eatoughaidan5v4418-spec/-/README.md

# 模块化塔式立体车库调度系统

第十九届重庆市大学生单片机应用设计竞赛 · 方向三
平台：星火一号 / STM32F407ZGT6 + RT-Thread 标准版

## 当前状态（2026-11-10）

**设计定稿，尚无实物。** 方案、三维模型、引脚分配和调度逻辑仿真已完成；机械件未加工，电路板未投板，固件只有调试界面，电机控制尚未开始。

- **结构**：中央升降转运台，加上每层 8 个辐射排列、无电机的车位。整机只有 3 个运动轴：升降、旋转、转运拨叉。拨叉与托盘的啮合 / 脱开靠升降上下 8 mm 完成。
- **规模**：计划书按两层、14 个车位写；样机先做一层、7 个车位。
- **电气**：3 个 TMC2209 模块 + 2 个 MCP23017 模块，插在 4 块自制转接 PCB 上；霍尔和红外用 5 V。
- **人机界面**：最终用 TJC4827T143 串口屏；开发阶段先用板载 LCD + LVGL 调试。
- **外形与预算**：约 520×520×275 mm。一层样机预算约 ¥1,487，两层约 ¥1,701，均含 15% 机动费。

关键节点：网上报名截止 2026-12-10 20:00；初赛材料提交截止 2027-03-11 20:00。

## 现行文档

| 文档 | 说明 |
|---|---|
| [docs/计划书_定稿.md](docs/计划书_定稿.md) | 初赛计划书。指标为设计目标，样机完成后更新第 6 节 |
| [docs/硬件方案_v4.md](docs/硬件方案_v4.md) | 硬件总述：布局、转运机构、升降、电气、引脚分配、屏幕策略、互锁、调度、风险 |
| [docs/硬件验证与实施_v4.md](docs/硬件验证与实施_v4.md) | 已做校核的范围、下单前确认事项、实施顺序、样机后要回填的数据 |
| [docs/采购清单_v5.md](docs/采购清单_v5.md) | 分两批的数量、下料和预算 |
| [docs/转接板_模块插装_v3/](docs/转接板_模块插装_v3/00_板卡结构确认.md) | 板卡结构和主转接板逐针表 |
| [docs/转接板_双板_v2/02_副板逐针接线.md](docs/转接板_双板_v2/02_副板逐针接线.md) | 副转接板 PMOD 逐针表（GPIO 分配有效） |
| [docs/PCB生产文件_20261111/](docs/PCB生产文件_20261111/交付说明.md) | 主、副转接板的 Gerber、坐标文件和打样说明 |
| [docs/cad/README.md](docs/cad/README.md) | CAD 索引：v7 三维装配、图纸、走线复核 |
| [使用的硬件资料/资料索引.md](使用的硬件资料/资料索引.md) | 开发板、串口屏、电机、驱动的原厂资料 |
| [docs/串口屏界面_v1/](docs/串口屏界面_v1/README.md) | 串口屏界面方案：可点击原型、页面与控件表、图片清单、通信协议、屏幕工程搭建步骤 |
| [firmware/spark_garage_lvgl/](firmware/spark_garage_lvgl/README.md) | 固件工程 |

## 工具

| 命令 | 作用 |
|---|---|
| `node tools/test_cad_simulation.js` | 调度状态机和互锁规则测试（104 个循环） |
| `node tools/test_deck_geometry.js` | 两层甲板销槽布置检查 |
| `py tools/check_garage_assembly_v7.py` | v7 三维装配检查，另有 `check_garage_stl_v7.py`、`check_cad_v7.py`、`check_cad_v7_details.py` |
| `py tools/check_hardware_v3.py` | v3 平面几何校核（设计值仍是 v3，未按 v7 更新）和采购清单 v5 加总 |

`tools/` 里的 `create_*`、`verify_*`、`export_*` 脚本用于在 AutoCAD 中重新生成和复查 v7 模型，用法见 v7 装配说明。

## CAD 交互演示

用电脑浏览器直接打开 [三维演示](docs/cad/assembly-exploded.html)：

- 点击“存入车辆”，或先选中一个载车托盘再点“取出车辆”。演示过程包括旋转、升降、拨叉啮合与推拉、DOCK 人工确认、空闲预置空托盘、取消存车、暂停和模拟急停。
- 勾选“仅一层样机”，可以切换到一层配置。
- 网址后加 `?view=top` 打开俯视视角，加 `?layers=1` 直接打开一层配置。

页面基于 v3 尺寸，仅用于演示原理，与 v7 模型存在差异；页面不连接实际设备，模型不能作为加工图。Three.js 已放在本地，不依赖网络。
