eatoughaidan5v4418-spec/-/docs/cad/README.md

# CAD 索引

当前选用两台 24 mm 短轴电机的 v7 试配方案：夹带背壁和挡边加厚，重新调整带轮和托盘销位，甲板井口扩大到 R102。请优先查看 [v7 装配与说明](./三维装配_v7_加厚夹带/README.md) 和 [v7 板件及安装详图](./图纸_v7_加厚夹带/README.md)。实际零件、皮带夹持、限位停止距离和结构强度仍需确认，不能直接作为最终加工依据。

以下网页可用电脑浏览器离线打开，基于旧版 v3，仅用于理解原理；实际安装请以 v7 为参考。

| 文件 | 说明 |
|---|---|
| [三维装配_v7_加厚夹带/README.md](./三维装配_v7_加厚夹带/README.md) | 当前试配：加厚夹座、带轮避让和 R102 井口 |
| [v7 走线优化与安装复核](./三维装配_v7_走线优化安装复核/README.md) | 两层通道、拖链支架、旋转导槽和线夹的更新模型及运动边界 |
| [图纸_v7_加厚夹带/README.md](./图纸_v7_加厚夹带/README.md) | P01N、P03E、两层甲板和夹带等试配详图 |
| [走线方案_v7/README.md](./走线方案_v7/README.md) | 升降拖链与旋转线环的走线示意、线束终点和试配假设 |
| [assembly-exploded.html](./assembly-exploded.html) | v3 三维结构、存取车、空闲预置、暂停、模拟急停、一层 / 两层切换与拆解视图 |
| [layer-plan.html](./layer-plan.html) | 层模块俯视（8 车位、井孔、竖向件、DOCK 竖井）与立面高度 |
| [一层甲板_易懂图.png](./一层甲板_易懂图.png) | 一层甲板的孔槽、托盘位置和转运方向说明 |
| `deck.js` | 甲板井孔轮廓，两个页面共用 |
| `simulation.js` | 存取状态机与互锁，网页和 `tools/test_cad_simulation.js` 共用 |

交互演示中：
- 存车：系统把空托盘调到 DOCK，用户放车并确认后送入空车位。
- 取车：先选中载车托盘。
- 车辆状态是演示记录，不代表真实传感器读数。
- 模拟急停后，“重置”只恢复网页演示；真实设备需按现场应急程序处理，检查前确保设备停稳、载荷有独立支承并隔离电源。

可运行 `node tools/test_cad_simulation.js` 检查模拟状态机。测试不验证实际机构、电气或三维碰撞。

可运行 `node tools/test_deck_geometry.js` 检查两层甲板的销槽布置。
