eatoughaidan5v4418-spec/-/docs/串口屏界面_v1/README.md

# 串口屏界面方案 v1

屏幕：TJC4827T143_011C_I_P20，4.3 寸，480×272，电容触摸，接 USART3（PB10 / PB11），115200 波特率。

## 1. 当前状态（2026-11-11）

| 内容 | 状态 |
|---|---|
| 视觉和交互 | 已定稿，见 [界面原型.html](界面原型.html)（浏览器直接打开，可点击） |
| 固件后端 | 已写完，在 `firmware/spark_garage_lvgl/applications/hmi/` |
| 通信协议 | 已定，见第 5 节；帧解析有单元测试 |
| 屏幕工程（.HMI 文件） | **未做**。要在 USART HMI 上位机里按第 3、4、6 节搭建 |
| 图片素材 | 已导出，93 张，在 [素材/](素材/)，总览见 [素材预览.png](素材预览.png) |
| 控件坐标 | 已从原型量出，见 [控件坐标.md](控件坐标.md) |
| 实机联调 | **未做**。固件只在电脑上跑过场景测试，没有接过真屏 |

固件目前接的是一个假车库（`ui_sim.c`），存取过程按定时器走，没有真实运动。调度模块写好后替换它，屏幕后端不用改。

## 2. 设计原则

1. **屏内不放逻辑。** 屏幕工程里只有控件、图片和每个触摸事件里的一行 `printh`。显示哪一页、每个控件显示什么，全部由主控决定。这样界面行为只有一份代码，换屏或改流程时不用同时改两边。
2. **屏幕不自己翻页。** 用户点了按钮，屏幕只上报；主控判断后再下发 `page` 指令。
3. **只发变化的值。** 主控记着每个控件上次发的值，没变就不发。换页或屏幕重启后全部重发。
4. **心跳对齐。** 每一页有一个 1 秒定时器上报当前页号。页号和主控认为的不一致（例如屏幕被单独复位），主控就整页重画。

## 3. 页面和控件

每个控件的位置和尺寸见 [控件坐标.md](控件坐标.md)，那是脚本从原型量出来的，和导出的图片逐像素对应。图片和按钮控件必须严格按表放；文本和数字控件给的是文字的实际范围，控件可以做宽一些。控件名固件里写死了，**不能改名**。

文本和数字控件的背景设置：

- main 页右侧面板上的（nFree、tTot、tSel、tJob、tStep、tIdx、nEta）：背景选纯色，颜色 `#0E1626`（RGB565 = 2212），和面板底图同色。
- main 页标题栏的 tClk、fault 页的全部文本：背景选“切图”，切图图片填该页的背景图编号（main 填 0，fault 填 1）。
- 其余页面是纯色背景，文本背景用同一个颜色。

所有页面都要加一个定时器 `tmHb`（1000 ms，启用），定时事件里写该页的心跳帧，见第 5.2 节。

### 3.1 页面编号

| 页号 | 页名 | 内容 | 背景 |
|---|---|---|---|
| 0 | boot | 启动等待，文字“正在连接主控，请稍候” | 纯色 |
| 1 | main | 车位图 + 右侧面板（主页 / 已选 / 出入口确认 / 进度共用） | 图片 0 |
| 2 | fault | 故障和人工确认 | 图片 1 |
| 3 | estop | 急停 | 图片 2 |
| 4 | idle | 待机时钟 | 纯色 |
| 5 | pwd | 维护密码 | 纯色 |
| 6 | jog | 维护：点动 | 纯色 |
| 7 | cal | 维护：标定 | 纯色 |
| 8 | sen | 维护：传感器 | 纯色 |

纯色背景统一用深蓝黑 `#080D18`（RGB565 = 2147）。维护页和密码页用上位机自带的扁平控件，不用图片，省 Flash，也省出图工作。

### 3.2 main 页（页号 1）

左侧车位图，8 个车位各一个图片控件，按方位固定顺序命名：

| 控件 | 方位 | 类型 | 按下事件 |
|---|---|---|---|
| b0 | 东 | 图片 | `printh A5 11 00 00 11 5A` |
| b1 | 东北 | 图片 | `printh A5 11 01 00 12 5A` |
| b2 | 北 | 图片 | `printh A5 11 02 00 13 5A` |
| b3 | 西北 | 图片 | `printh A5 11 03 00 14 5A` |
| b4 | 西 | 图片 | `printh A5 11 04 00 15 5A` |
| b5 | 西南 | 图片 | `printh A5 11 05 00 16 5A` |
| b6 | 南（出入口 / 竖井） | 图片 | `printh A5 11 06 00 17 5A` |
| b7 | 东南 | 图片 | `printh A5 11 07 00 18 5A` |
| hub | 转运台朝向 | 图片 | 无 |

这 9 个控件的矩形互不重叠，这是车位画成“沿半径排列的圆角矩形”而不是扇形的原因：屏幕的图片控件只能是矩形，扇形的外接矩形会互相压住。hub 限制在 76×76 也是同一个原因。

方位文字和小车图形都画在车位小图里，不用字库。选中和目标状态的发光超出矩形的部分在实机上不显示，所以发光比原型里略窄。

右侧顶部：

| 控件 | 类型 | 说明 |
|---|---|---|
| tClk | 文本，16 号字，右对齐 | 时钟，主控下发 |
| hTitle | 触摸热区 | 按下 `printh A5 17 01 00 18 5A`；弹起 `printh A5 17 00 00 17 5A` |
| tab1 | 图片 | 标签条左半边。按下 `printh A5 10 01 00 11 5A` |
| tab2 | 图片 | 标签条右半边。按下 `printh A5 10 02 00 12 5A` |
| pPanel | 图片 | 面板底图，5 种，带固定文字。盖住标题栏以下的整个右侧 |

tab1、tab2 和下表的控件都要叠在 pPanel 上面（在上位机里排在 pPanel 之后），主控按模式显示或隐藏。楼层标签只在主页和已选两种模式、且识别到两层时显示。

| 模式 | 控件 | 类型 | 说明 / 按下事件 |
|---|---|---|---|
| 主页 | nFree | 数字，60 号数字字库 | 空位数 |
| | tTot | 文本，24 号 | “/ 14” |
| | jOcc | 进度条，图片模式 | 占用条 |
| | bStore | 按钮，图片模式 | `printh A5 12 00 00 12 5A` |
| 已选 | tSel | 文本，24 号 | “1F · 北” |
| | bGet | 按钮，图片模式 | `printh A5 13 00 00 13 5A` |
| 出入口 | pTray | 图片 | 托盘到位一行（圆点和文字画在图里） |
| | pHand | 图片 | 红外遮挡一行 |
| | bOk | 按钮，图片模式 | 确认存车 `printh A5 14 00 00 14 5A` |
| | bCancel | 按钮，图片模式 | 取消 `printh A5 15 00 00 15 5A` |
| | bTaken | 按钮，图片模式 | 已取走 `printh A5 16 00 00 16 5A` |
| 进度 | tJob | 文本，16 号 | “存车中 · 1F 东北” |
| | tStep | 文本，24 号，多行 | 当前步骤 |
| | tIdx | 文本，16 号，右对齐 | “3 / 6” |
| | jStep | 进度条，图片模式 | 步骤进度 |
| | nEta | 数字，40 号数字字库 | 预计剩余秒数 |

按钮的触摸事件都写在“弹起事件”里，避免误触。车位和标签写在“按下事件”里，反应快一些。

### 3.3 fault 页（页号 2）

| 控件 | 类型 | 说明 / 事件 |
|---|---|---|
| tClk | 文本，16 号 | 时钟 |
| tCode | 文本，84 号字库（只含 E 和数字），红色 | “E12” |
| tTitle | 文本，24 号 | 故障名 |
| tDesc | 文本，16 号，多行 | 位置和处理提示 |
| c0 | 图片 | 勾选“交接缝上没有托盘”，按下 `printh A5 20 00 00 20 5A` |
| c1 | 图片 | 勾选“拨叉已完全收回”，按下 `printh A5 20 01 00 21 5A` |
| bHome | 按钮，图片模式 | 回零，弹起 `printh A5 21 00 00 21 5A` |

急停松开后也进这一页，故障码 E01（位置未确认），同样要勾两项才能回零。

### 3.4 estop 页（页号 3）

只有背景图和心跳定时器，没有动态控件。

### 3.5 idle 页（页号 4）

| 控件 | 类型 | 说明 |
|---|---|---|
| tClk | 文本，120 号数字字库，居中 | 大时钟 |
| jOcc | 进度条，图片模式，尺寸和 main 页的 jOcc 相同 | 占用条，和 main 页共用 85～88 号图 |
| nFree | 数字，40 号 | 空位数，青色 |
| tTot | 文本，16 号 | “/ 14” |
| m0 | 触摸热区 | 按下 `printh A5 18 00 00 18 5A` |

另放两个静态文本“空位”和“轻触屏幕开始”。待机时主控把背光调到 30%。

### 3.6 pwd 页（页号 5）

| 控件 | 类型 | 说明 / 事件 |
|---|---|---|
| d0～d3 | 图片，38×46 | 四个密码位，空 / 已输入两种图 |
| k0～k9 | 按钮 | 数字键，弹起 `printh A5 30 0n 00 3n 5A`（n 为数字，例如 7 是 `A5 30 07 00 37 5A`） |
| kBack | 按钮 | 退格，`printh A5 30 0A 00 3A 5A` |
| kClose | 按钮 | 关闭，`printh A5 30 0B 00 3B 5A` |

密码由主控校验，默认值和修改方法见第 7.3 节。输错不提示，只是清空重输。

### 3.7 jog 页（页号 6）

| 控件 | 类型 | 说明 / 事件 |
|---|---|---|
| m0 / m1 / m2 | 按钮 | 标签：点动 / 标定 / 传感器，`printh A5 40 00 00 40 5A`、`A5 40 01 00 41 5A`、`A5 40 02 00 42 5A` |
| mExit | 按钮 | 退出，`printh A5 40 03 00 43 5A` |
| n0 / n1 / n2 | 数字 | 升降 / 旋转 / 拨叉当前步数 |
| jm0 / jp0 | 按钮 | 升降 − / +：`A5 41 00 00 41 5A` / `A5 41 00 01 42 5A` |
| jm1 / jp1 | 按钮 | 旋转 − / +：`A5 41 01 00 42 5A` / `A5 41 01 01 43 5A` |
| jm2 / jp2 | 按钮 | 拨叉 − / +：`A5 41 02 00 43 5A` / `A5 41 02 01 44 5A` |
| s0 / s1 / s2 | 按钮 | 步长 1 / 10 / 100：`A5 42 00 00 42 5A`、`A5 42 01 00 43 5A`、`A5 42 02 00 44 5A`。选中哪个由主控改背景色 |
| bHomeAll | 按钮 | 全部回零，`printh A5 43 00 00 43 5A` |

三个维护页的标签栏做成一样的，各页把自己那个标签的颜色设成选中色即可（静态）。

### 3.8 cal 页（页号 7）

| 控件 | 类型 | 说明 / 事件 |
|---|---|---|
| m0～m2、mExit | 按钮 | 同 jog 页 |
| tBay | 文本，24 号 | 当前标定的车位，“1F · 东北” |
| bPrev / bNext | 按钮 | 上一个 / 下一个车位：`A5 44 00 00 44 5A` / `A5 44 01 00 45 5A` |
| nHc / nHs | 数字 | 啮合高度：当前 / 已存 |
| nAc / nAs | 数字 | 转角：当前 / 已存 |
| bGoJog | 按钮 | 去点动页微调，和 m0 发同一帧 |
| bSave | 按钮 | 录入当前位置，`printh A5 45 00 00 45 5A` |

### 3.9 sen 页（页号 8）

| 控件 | 类型 | 说明 |
|---|---|---|
| m0～m2、mExit | 按钮 | 同 jog 页 |
| l0～l15 | 文本，14×14，无文字 | 指示灯，主控改背景色：有信号绿色，无信号暗色 |

l0～l15 的含义依次是：东、东北、北、西北、西、西南、出入口、东南八个一层托盘霍尔，转运台托盘，拨叉收回，拨叉伸出，升降下限，出入口红外，急停回路，层板 0x20，层板 0x21。每个灯旁边放一个静态文本写名字。目前只显示一层的霍尔。

## 4. 图片资源

图片已导出到 [素材/](素材/)，文件名开头的两位数就是编号。按文件名顺序全选导入上位机，编号就是导入顺序，固件里的定义在 `hmi_res.h`。**中间插图会让后面的编号全部错位**，要加图只能加在最后。

| 编号 | 内容 | 尺寸 |
|---|---|---|
| 0 | main 页背景：车位图底、刻度环、转运台外圈、标题栏、空标签区 | 480×272 |
| 1 | fault 页背景 | 480×272 |
| 2 | estop 页背景（含全部文字） | 480×272 |
| 3～7 | 面板底图：主页、已选、出入口-放车、出入口-取车、进度 | 207×239 |
| 8～47 | 车位小图，编号 = 8 + 方位序号 × 5 + 状态 | 见 3.2 |
| 48～55 | 转运台朝向，东、东北……东南 | 76×76 |
| 56 | 转运台不在本层（无指示） | 76×76 |
| 57～60 | 1F 标签选中 / 未选中，2F 标签选中 / 未选中 | 91×30、92×30 |
| 61～63 | 存车按钮：正常 / 按下 / 禁用 | 191×56 |
| 64～65 | 取车按钮：正常 / 按下 | 191×62 |
| 66～68 | 确认存车：正常 / 按下 / 禁用 | 191×58 |
| 69～70 | 取消：正常 / 按下 | 191×44 |
| 71～73 | 已取走：正常 / 按下 / 禁用 | 191×62 |
| 74～75 | “托盘已到位”一行：到位 / 等待 | 183×23 |
| 76～77 | 红外一行：无遮挡 / 检测到手 | 183×23 |
| 78～81 | 勾选项 0 未勾 / 已勾，勾选项 1 未勾 / 已勾 | 220×44 |
| 82～84 | 回零按钮：禁用 / 正常 / 按下 | 456×50 |
| 85～86 | 占用条 14 格：全空 / 全满 | 183×6 |
| 87～88 | 占用条 7 格：全空 / 全满 | 183×6 |
| 89～90 | 步骤进度条：空 / 满 | 183×7 |
| 91～92 | 密码位：空 / 已输入 | 38×46 |

车位小图的状态序号：

| 序号 | 普通车位（方位 0～5、7） | 南位（方位 6） |
|---|---|---|
| 0 | 无托盘（虚线框） | 出入口，无托盘 |
| 1 | 空托盘 | 出入口，有托盘 |
| 2 | 有车（亮蓝，带小车图形） | 出入口，等用户操作（青色高亮） |
| 3 | 选中（青色发光） | 竖井（二层用） |
| 4 | 目标（青色边框，主控每 0.5 秒和原状态交替实现闪烁） | 出入口，目标 |

小图是不透明的，连同背后的背景一起截下来，所以控件位置差一个像素就会看到接缝。按钮图比按钮本身四周各大 4 像素，用来保留一点发光。

### 重新导出

改了原型的样式或布局后重新运行脚本，素材、预览图和坐标表会一起更新：

```bash
py tools/export_hmi_assets.py
```

脚本用本机的 Edge 或 Chrome 无头渲染原型，需要先装 `playwright` 和 `pillow` 两个 Python 包。它最后会做两项自检：车位状态变化是否都落在车位矩形内；用导出的小图重新拼出主页，和直接渲染的画面逐像素比较。当前结果是两项都为 0 个差异像素。

### Flash 估算

屏幕图片按 16 位色不压缩存储，每个像素 2 字节。

| 项目 | 大小 |
|---|---|
| 93 张图片（脚本按实际尺寸算出） | 2.21 MB |
| 字库（见第 6.3 节，估算） | 约 0.15 MB |
| **合计** | **约 2.4 MB** |

T1 系列屏的 Flash 是 4 MB 或 8 MB。这块屏具体是哪个，手册和规格书的文字我没能读出来，**要在上位机里选型号后看界面上显示的容量**。按 4 MB 算还有四成左右余量。

## 5. 通信协议

### 5.1 帧格式

**屏幕 → 主控**，固定 6 字节，在触摸事件里用 `printh` 发出：

```
A5  CMD  P1  P2  SUM  5A        SUM = (CMD + P1 + P2) 取低 8 位
```

所有事件的参数都是常量，所以每个控件的 `printh` 后面直接写死 6 个字节，屏幕不用算校验。

屏幕自己还会发一些原生返回（以 `FF FF FF` 结尾），主控只处理这几种：

| 首字节 | 含义 | 主控处理 |
|---|---|---|
| `88` | 屏幕启动完成 | 整页重画 |
| `00 00 00` | 屏幕上电 | 整页重画 |
| `02`～`24` | 指令执行失败 | 记一条警告日志，通常是控件名或图片编号在屏幕工程里不存在 |

**主控 → 屏幕**，用屏幕原生指令，ASCII 文本，中文为 GB2312，以 `FF FF FF` 结尾。用到的指令只有这几种：

```
page 1                  切换页面
b2.pic=20               改图片
nFree.val=10            改数字
tStep.txt="送入车位"     改文字
jOcc.bpic=85            改进度条底图（ppic 为填充图）
bOk.pic2=67             改按钮按下时的图
s1.bco=9885             改背景色（pco 为文字色）
vis bStore,0            隐藏 / 显示控件
tsw bOk,0               禁用 / 启用触摸
dim=30                  背光亮度
```

### 5.2 事件表

| CMD | 名称 | P1 | P2 | 说明 |
|-----|---|----|----|---|
| 01 | 心跳 | 当前页号 | 0 | 每页定时器每秒发一次，例如 main 页写 `printh A5 01 01 00 02 5A` |
| 10 | 切换楼层 | 1 / 2 | 0 | |
| 11 | 点车位 | 方位 0～7 | 0 | |
| 12 | 存车 | 0 | 0 | |
| 13 | 取车 | 0 | 0 | 取哪辆由主控记着 |
| 14 | 确认存车 | 0 | 0 | |
| 15 | 取消 | 0 | 0 | |
| 16 | 已取走 | 0 | 0 | |
| 17 | 标题栏 | 1 按下 / 0 弹起 | 0 | 主控计时，按住满 3 秒进密码页 |
| 18 | 待机唤醒 | 0 | 0 | |
| 20 | 故障勾选 | 0 / 1 | 0 | |
| 21 | 故障回零 | 0 | 0 | |
| 30 | 密码键 | 0～9，10 退格，11 关闭 | 0 | |
| 40 | 维护标签 | 0 点动，1 标定，2 传感器，3 退出 | 0 | |
| 41 | 点动 | 轴 0 升降，1 旋转，2 拨叉 | 0 负向 / 1 正向 | 每按一次走一个步长 |
| 42 | 点动步长 | 0 / 1 / 2 | 0 | 对应 1 / 10 / 100 步 |
| 43 | 全部回零 | 0 | 0 | |
| 44 | 标定换车位 | 0 上一个 / 1 下一个 | 0 | |
| 45 | 标定保存 | 0 | 0 | |

各页心跳帧：

| 页 | 定时事件 |
|----|---|
| boot | `printh A5 01 00 00 01 5A` |
| main | `printh A5 01 01 00 02 5A` |
| fault | `printh A5 01 02 00 03 5A` |
| estop | `printh A5 01 03 00 04 5A` |
| idle | `printh A5 01 04 00 05 5A` |
| pwd | `printh A5 01 05 00 06 5A` |
| jog | `printh A5 01 06 00 07 5A` |
| cal | `printh A5 01 07 00 08 5A` |
| sen | `printh A5 01 08 00 09 5A` |

### 5.3 主控一侧的保护

屏幕上报的事件只是“用户想做什么”，主控会再核对一遍才执行：

- 出入口红外被挡时，“确认存车”和“已取走”按钮禁用，就算收到这两个事件也不执行。
- 故障回零必须两项都勾上。
- 只有就绪状态才接受存车、取车和进维护。
- 待机时的第一次触摸只唤醒，不执行任何操作。
- 3.5 秒收不到心跳，主控记一条“屏幕离线”日志；车库的动作不受影响。

## 6. 屏幕工程搭建步骤

### 6.1 新建工程

1. USART HMI 上位机新建工程，型号选 TJC4827T143_011C，方向横屏 0°，**字符编码选 GB2312**。
2. 在 `Program.s`（工程初始化脚本）里写：

```
bauds=115200
bkcmd=2
page 0
```

`bkcmd=2` 表示只在指令失败时返回，主控靠它发现控件名写错。

3. 所有控件的“发送键值”保持不勾选，触摸只通过 `printh` 上报。

### 6.2 导入图片

把 `素材/` 里的 93 个文件按文件名排序后一次导入，导入后核对最后一张（`92_pin_full.png`）的编号是 92。

### 6.3 生成字库

| 字库编号 | 字高 | 内容 | 用途 |
|---|---|---|---|
| 0 | 16 | 全部 ASCII + [字库字符集.txt](字库字符集.txt) 里的汉字 | 小字、提示 |
| 1 | 24 加粗 | 同上 | 标题、步骤名 |
| 2 | 40 | 数字 0～9 | 剩余秒数、待机空位数 |
| 3 | 60 | 数字 0～9 | 主页空位数 |
| 4 | 84 | E 和数字 0～9 | 故障码 |
| 5 | 120 | 数字 0～9 和冒号、减号 | 待机大时钟 |

`字库字符集.txt` 是脚本从固件文字表生成的，目前 165 个字。只收用到的字，字库很小；以后在 `hmi_text.txt` 里加了新字，要重新生成字库再下载到屏幕，否则新字显示成空白。

### 6.4 建页面

按第 3 节建 9 个页面，页面顺序决定页号。每页加 `tmHb` 定时器和对应的心跳帧。

### 6.5 联调顺序

上位机的“调试”功能可以用电脑串口直接连主控，不用下载到屏幕就能看效果，建议先这样调通再烧屏。

1. 只建 boot 和 main 两页，确认上电后屏幕从 boot 跳到 main，说明双向通信通了。
2. 在 msh 里运行 `hmi_stat`，看到 `screen online` 和正确的页号。
3. 补齐其余页面。每加一页，在 msh 日志里看有没有“screen rejected an instruction”，有就是控件名或图片编号对不上。
4. 用 `sim_fault 12`、`sim_estop 1`、`sim_estop 0` 触发故障页和急停页。

## 7. 固件

### 7.1 文件

都在 `firmware/spark_garage_lvgl/applications/hmi/`：

| 文件 | 作用 |
|---|---|
| `ui_model.h` | 界面和调度之间的接口：一个状态快照结构、一组命令、三个函数 |
| `hmi_proto.h/.c` | 帧解析，不依赖 RT-Thread |
| `hmi_res.h` | 页号和图片编号 |
| `hmi_text.txt` | 主控下发的全部中文（UTF-8），**改文字只改这里** |
| `hmi_text.h` | 脚本生成的 GB2312 字节表，不要手改 |
| `hmi_tjc.c/.h` | 串口屏后端：收发线程、页面决策、差量刷新 |
| `ui_sim.c` | 假车库，调度模块写好后删除 |

改了 `hmi_text.txt` 后运行：

```bash
py tools/gen_hmi_text.py
```

### 7.2 调度模块怎么接

调度模块只需要实现 `ui_model.h` 末尾的三个函数，然后删掉 `hmi_tjc.h` 里的 `HMI_USING_SIM`：

- `garage_ui_get_state()`：填一份当前状态（阶段、车位表、转运台位置、任务步骤、故障码、传感器、各轴位置）。界面线程每 100 ms 调一次，不能阻塞。
- `garage_ui_post_cmd()`：接收存车、取车、确认、取消、回零、点动、标定保存等命令，一般是丢进调度的消息队列。
- `garage_ui_get_cal()`：读某个车位已保存的标定值。

板载屏的 LVGL 调试界面（`garage_ui.c`）目前还是自己内部模拟，没有改成走这套接口。

故障码和步骤名是我先拟的（见 `hmi_text.txt`），调度模块实现时可以增删，改完重新生成文字表即可。

### 7.3 串口配置和 msh 命令

这次在 `rtconfig.h` 和 `.config` 里打开了 `BSP_USING_UART3`。如果以后在 RT-Thread Studio 的设置界面里重新生成配置，确认 UART3 还勾着。

| 命令 | 作用 |
|---|---|
| `hmi_stat` | 屏幕是否在线、当前页号、丢弃的坏帧数 |
| `hmi_pin 1234` | 改维护密码。只存在内存里，复位后恢复默认值 `0000` |
| `sim_fault <故障码>` | 假车库：触发故障 |
| `sim_estop <0\|1>` | 假车库：按下 / 松开急停 |

### 7.4 已做的验证

```bash
gcc -Wall -Wextra -I firmware/spark_garage_lvgl/applications/hmi tools/test_hmi_proto.c firmware/spark_garage_lvgl/applications/hmi/hmi_proto.c -o test_hmi_proto && ./test_hmi_proto
```

```bash
gcc -Wall -I tools/hmi_host_shim -I firmware/spark_garage_lvgl/applications/hmi tools/test_hmi_backend.c firmware/spark_garage_lvgl/applications/hmi/hmi_proto.c -o test_hmi_backend && ./test_hmi_backend
```

- 帧解析测试 16 项通过：正常帧、参数里含帧头帧尾、校验错、帧尾错、原生返回、混合流、长串乱码后恢复。
- 后端场景测试 58 项通过：在电脑上把 RT-Thread 换成桩，让后端和假车库跑完整流程，检查发给屏幕的每条指令。覆盖启动、切层、选车、取车、存车、取消、故障确认、急停、待机唤醒、长按进密码、输错和输对密码、点动、标定、传感器、屏幕重启后重画。
- 三个源文件用 RT-Thread Studio 自带的 ARM GCC 5.4.1 加 `-Wall -Wextra` 编译无警告。

没有做的：整个固件工程的链接（命令行 scons 和这版 RT-Thread 的构建脚本不兼容，报错退出，需要在 RT-Thread Studio 里编译一次）、下载到板子、接真屏。

## 8. 要在实机上确认的事

这些地方我是按屏幕手册的说明写的，没有真屏验证过：

1. **隐藏控件后的重画。** 面板切换时主控先隐藏全部面板控件，再换 pPanel 的图，再显示本模式的控件。如果实机上出现残影或控件被底图盖住，需要调整这三步的顺序，改 `hmi_tjc.c` 的 `panel_switch()`。
2. **图片模式进度条**的 `bpic`、`ppic` 能否在运行时修改；不能的话 14 格和 7 格的占用条要做成两个控件。另外占用条是按百分比填充的，格子边界可能差 1 像素。
3. **按钮禁用**后（`tsw bOk,0`）外观是否保持禁用图。
4. **文本换行**：`tStep`、`tDesc` 要打开多行；提示里的换行写的是 `\r` 两个字符，确认屏幕把它当换行处理。
5. **切页闪烁**：main 页每次进入要发 40 条左右指令，115200 波特率下约 60 ms，看是否能接受。
6. **点阵字的观感**：T1 系列字库没有抗锯齿，24 号加粗和 120 号大数字的实际效果要看了再定是否换字体。
7. **Flash 容量**，见第 4 节。
8. **图片色彩**：素材是 24 位色 PNG，上位机导入时转成 16 位色。深色渐变背景可能出现轻微色带，面板纯色和文本背景色是否完全一致也要看实机；有色差就把文本控件背景改成“切图”。

## 9. 和计划书不一致的地方

- 计划书 4.8 节写进度页有取消按钮。本方案把取消放在放车前的出入口确认页，进度页不提供取消，只提示按急停，理由是 4.6 节规定运动中不中断。定稿时计划书这一句要改，或者在这里加回取消键。
- 计划书把主页、进度、故障、维护列为 4 个页面；实际做成 9 个屏幕页面，其中主页、已选、出入口确认、进度共用一个 main 页。
