eatoughaidan5v4418-spec/-/docs/硬件方案_v4.md

# 中央升降塔式立体车库硬件方案 v4（设计定稿）

日期：2026-11-10。本文把硬件方案 v3 的正文与其后各条更新说明（v7 CAD、5 V 检测、模块插装板卡）合并成一份，**取代 v3 作为当前唯一有效的硬件总述**。

平台：星火一号（STM32F407ZGT6）+ RT-Thread 标准版。人机界面：TJC4827T143_011C 4.3 寸串口屏（最终）；板载 240×240 LCD 仅作调试屏，见第 7 节。

> **状态：设计定稿，尚无实物。** 本文用于采购、建模、绘制原理图和制作一层样机，不是已验证的加工图或电路图。尚未做实物装配、通电、刚度、力矩、温升或断电保持试验。尺寸为名义值，电机、导轨、轴承到货复尺前不要冻结孔位。验证顺序见 [验证与实施 v4](硬件验证与实施_v4.md)。

**范围**：计划书按**两层、14 个车位**写；样机**先做一层、7 个车位**。升降塔一次按两层高度做好，第二层是无源模块，一层验证通过后加装。

## 0. 文档关系

| 主题 | 以哪份为准 |
|---|---|
| 总体方案、I/O 分配、互锁、调度 | 本文 |
| 机械细部尺寸、孔位、打印件 | [v7 装配说明](cad/三维装配_v7_加厚夹带/README.md)、[v7 图纸](cad/图纸_v7_加厚夹带/README.md) |
| 走线、拖链、旋转线环 | [v7 走线优化与安装复核](cad/三维装配_v7_走线优化安装复核/README.md) |
| 板卡结构与主转接板逐针表 | [转接板_模块插装_v3](转接板_模块插装_v3/00_板卡结构确认.md)（00～03、05；04 号已被 05 号取代） |
| 副转接板 PMOD 逐针表 | [转接板_双板_v2/02_副板逐针接线](转接板_双板_v2/02_副板逐针接线.md)（GPIO 分配仍有效；其中 5P 外置驱动控制口已改为模块插装） |
| 数量与预算 | [采购清单 v5](采购清单_v5.md) |

## 1. 方案由来：从 v2 到 v3 架构

v2 每层都有一套车顶上方的 X/Y 移盘机构，再加侧置升降台和跨缝滚筒，共 9 个运动轴，预算约 ¥4,100，层内搬运、跨缝交接、抓销入孔三处都难调。v3 起把所有运动集中到中央一台升降转运装置，每层只是无电机的车位架。v4 沿用这一架构。

| 项目 | v2 | v3 / v4 |
|---|---|---|
| 运动轴 | 9 | **3**：升降 Z、旋转 θ、转运拨叉 u；层数增加时不变 |
| 每层机构 | X/Y 龙门 + 3 根导轨 + 执行器 | **无电机**：甲板 + 导条 + 霍尔 + 1 块层检测板 |
| 托盘交接 | 抓销推送 + 跨缝 + 滚筒 | 转运台直接推拉，靠升降下沉 8 mm 啮合 / 脱开 |
| 断电保持 | 抱闸电机 | T8 单头导程 2 丝杆自锁（须带载断电试验确认） |
| 容量 | 2 层 6 辆 | 一层 7 辆；两层 14 辆 |
| 外形 | 约 550×300×670 | 约 520×520×275 |

代价：放弃了“华容道滑移”卖点，平面占地变大（但车辆密度更高）；转运台只能在 315° 范围内往返转动，不能连续旋转。

## 2. 总体布局与坐标

单位 mm。原点为塔中心、底板上表面；X 向右，Y 向后，Z 向上。前侧（−Y）为用户侧。

```text
                    N 后 (90°)
          NW (135°)     │     NE (45°)
               ╲   ┌────┴────┐   ╱
                ╲  │ 升降井  │  ╱
     W (180°) ───  │  R102   │  ─── E (0°)
                ╱  │ 转运台  │  ╲
               ╱   └────┬────┘   ╲
          SW (225°)     │     SE (315°)
                    S 前 (270°)
          一层：DOCK（用户放车 / 取车）
          二层：不设车位，形成 DOCK 竖井
```

| 参数 | 设计值 | 说明 |
|---|---|---|
| 外框 / 底板 | 500×500 / 520×520×6 | 四角 2020 立柱，高 270；顶板 5 mm，到 Z=275 |
| 车位 | 每层 8 个方位，按 45° 辐射排列 | 托盘长边沿径向，内端朝井口 |
| 托盘（P01N） | 125×60×3，内端两角 C10 倒角 | 停放时径向范围 **r=100…225**；定位销中心距内端 **7**，位于 r=107 |
| 模型车 | 105×43×30 | 居中，前后挡车件固定 |
| 井口净空半径 | **R102**（P05R / P06R 甲板） | 另有 8 个定位销槽、支撑臂槽 |
| 竖向件 | r=140，角度 22.5° / 202.5°（Φ8 导杆）、112.5°（T8 丝杆）、67.5°（拖链） | 都在车位缝隙中 |
| 甲板高度 | L1 Z=100，L2 Z=190 | 层间距 90 |
| DOCK 竖井 | 二层前侧甲板开 ±38 缺口、不设前环梁 | DOCK 上方净空 150 |
| 容量 | 一层 7（8 个方位扣 DOCK）；两层 14（二层扣竖井） | |

> v3 的平面间隙校核值（相邻托盘最小间隙 26.5、推拉通道与相邻托盘 ≥24.4、支撑臂槽离倒角托盘 6.2、竖向件离托盘 ≥12.6）是按托盘 r=97…222、井口 R96 算的。v7 把托盘整体外移 3 mm、井口扩到 R102，这些值**尚未按 v7 重算**，使用前须复核。

## 3. 转运台：一套机构完成所有存取

转运台装在升降平台上，可旋转。转运板 P03E 轮廓范围 **183×96×3**。两根支撑条托住托盘，中间是 MGN7 导轨（长 170），由 NEMA11 经 GT2 皮带带动滑块，滑块上的伸出臂末端有一个 U 形拨叉。

每块托盘下方有一根向下伸出 5 mm 的 Φ4 定位销。**拨叉和销的啮合、脱开都由升降轴上下 8 mm 完成**，不需要电磁铁、舵机或直线执行器：

| 状态 | 转运台面（托盘支撑面） | 拨叉顶面 | 与销的关系 |
|---|---|---|---|
| 啮合 / 对齐高度 | = 甲板面 Z_L | Z_L − 1 | 销底 Z_L − 5，进入拨叉 4 mm |
| 脱开高度 | Z_L − 8 | Z_L − 9 | 拨叉在销下方，间隙 4 mm |

**从车位取托盘（pick）：**

1. 拨叉收回，旋转到目标方位，升降到该层脱开高度 Z_L−8。
2. 拨叉伸出到车位内托盘的销下方（销在 r=107）。
3. 升降上抬 8 mm，销落入拨叉，转运台面与甲板齐平。
4. 拨叉拉回，托盘滑上转运台。

**把托盘送入车位（place）：** 旋转对准，升降到啮合高度 Z_L，拨叉推出，下降 8 mm 脱开，拨叉空载收回。

v7 名义几何（详见 v7 装配说明）：

- 拨叉正常推拉行程 0…138，机械止挡在 −2 和 140。
- 皮带外包络最大径向 R98.50，距 R102 井口约 3.50；电机方形包络最大径向约 R95.79。
- 中央托盘外端 u=87，两条支撑条外端 u=78.5 / 85。
- 夹带座背壁 2 mm、底挡边 1 mm；拨叉与简化带轮的连续包络间隙下界 0.99 mm。
- **交接缝**：按名义尺寸，支撑条外端 u=85 到甲板井口 R102 约 17 mm（v3 为 11 mm）。v3 的“重心偏移 ±15 mm 内始终有支承”结论是按 11 mm 缝算的，**对 v7 不再成立**，必须用实物手推试验重新确认。

## 4. 升降与旋转

**升降**：NEMA17（42BL40，轴长 24 mm 短轴版）放在底板 112.5° 方位，经联轴器带动 T8 丝杆（单头、**实际导程 2 mm/转**、长 200），顶端用 KFL08 支承。两根 Φ8×270 光轴配 LM8LUU 导向，光轴支座为 SHF8。升降平台为 5 mm 铝板 CNC 件，由中心盘和 3 条支撑臂组成，臂宽 10、高 20，从托盘缝隙之间穿过各层甲板的臂槽。工作位置为 Z=92/100（一层）和 182/190（二层）。上下各设硬限位和机械止挡。

- 速度目标 10～15 mm/s，换层一次约 6～9 s。按 1/16 细分，每步 0.000625 mm。
- **速度风险**：15 mm/s 对应电机 450 r/min、脉冲频率 24 kHz。12 V 供电下 42 步进在该转速的可用扭矩明显下降，带载可能丢步。须实测；不达标时降速，或改 1/8 细分并核对驱动设置。
- **断电保持**：导程 2、直径 8 的单头丝杆螺旋升角约 4.5°，通常能自锁，但这不是证明。必须在最高层带满载断电并做振动试验。出现下滑则改 1 mm 导程丝杆或抱闸电机。

**旋转**：NEMA17 吊装在升降平台中心下方，通过法兰联轴器驱动转运台，3 寸方形转盘轴承承载。按 1/16 细分为 0.1125°/步，对应 r=107 处约 0.21 mm。转角限制在 −135°…+180°（共 315°），8 个方位都可到达，线缆只往返不连续转。原点由霍尔传感器给出。

**每个车位单独标定**：每个车位的啮合高度和转角存在 Flash 标定表里，补偿甲板挠度和装配误差。加装一层时只需补录该层的标定值。

## 5. 层模块与 DOCK

每个层模块包括：

- 3～4 根 2020 环梁和 4 根对角斜撑。
- 1 块 5 mm 激光切割亚克力甲板，开有 R102 井孔、销槽、臂槽和竖向件口袋。
- 每个车位：侧导条、端挡、甲板下 1 个 5 V 数字霍尔（检测托盘磁铁）、1 个指示 LED。
- 1 块层检测板，插 1 个 MCP23017 模块（一层 0x20，二层 0x21）。

**层模块里没有任何运动件**。上电时主控扫描 0x20…0x21，自动得到层数和车位表。

**DOCK**（一层前侧，S 方位）：

- 托盘停在一层甲板上，用户从正面或上方放车 / 取车。
- 二层同一方位不设车位，甲板开 ±38 缺口并取消前环梁。前侧少一根环梁，由两侧环梁、对角斜撑和顶框补偿刚度，需实测前角挠度。
- DOCK 装 2 套 5 V 红外对射（NPN 常开、30 cm 档）：一路判断车辆在位，一路判断手进入。手在区内时禁止任何运动；运动中检测到手进入，立即停机。单条光束只覆盖光路本身，不等同于安全光幕。

## 6. 电气

### 6.1 供电与安全回路

```text
12 V / 5 A 适配器（机内不引入市电）
 ├─ 12→5 V 降压（3 A）→ 星火一号、串口屏
 │     星火 40Pin 的 V5_SYS → 霍尔、红外（经主转接板和层检测板分配）
 │     星火 3.3 V → TMC2209 VIO、MCP23017、I²C 上拉
 └─ 急停常闭 + Z 上下硬限位常闭 + 继电器自保持 / 手动复位
       └─ VM_Z_SAFE、VM_T_SAFE（主转接板）及拨叉驱动 VM（副转接板）→ 3× TMC2209
```

- 三台步进**同一时间只允许一台运动**。按驱动限流约 1 A 估算，12 V 支路峰值输入电流在 2 A 量级；5 A 是预留余量，须实测。
- 急停只切断电机支路，主控和屏幕保持供电，用于显示状态和记录。
- 电机动力电流不经过星火 40Pin 或 PMOD 触点。逻辑地与电机地共参考，动力回流直接回电源输入。
- 每路 VM 就近预留储能电容位，容量和耐压按模块板载外围核定。
- 串口屏用外部 5 V 独立供电，不接 PMOD 的 3.3 V；屏的完整型号后缀和 TTL 电平须按实物标签确认后再接线。

### 6.2 板卡：3 种 PCB，共 4 块

| PCB | 数量 | 内容 | 位置 |
|---|---:|---|---|
| 主转接板 | 1 | 星火 40Pin、2×8 备用口、升降 / 旋转两组 TMC2209 模块插座、两台大电机 4P 口、检测口、两层 I²C 口和 5 V 口 | 星火上方叠装 |
| 副转接板 | 1 | 两组 PMOD 弯针、2×8 备用口、拨叉 TMC2209 模块插座、小电机 4P 口、串口屏 4P 口 | 星火侧面 |
| 层检测板 | 2（同一种 PCB） | MCP23017 模块插座、8 路霍尔口、8 路 LED 口、4P 总线口、2P 传感器 5 V 口 | 每层一块 |

TMC2209（红排针版）和 MCP23017 均用现成模块，经排母插到自制 PCB 上。TMC2209 采用 STEP/DIR 独立模式，目标 1/16 细分，不启用 UART。当前只推进主转接板原理图，副板与层检测板逐针定义待补。

### 6.3 MCU 引脚分配

| 功能 | MCU 脚 | 所在板 | 工作模式 |
|---|---|---|---|
| 升降 STEP / DIR / EN | PA8 / PA1 / PD10 | 主板 | TIM1_CH1；GPIO；GPIO 低有效 |
| 旋转 STEP / DIR / EN | PA0 / PB14 / PE14 | 主板 | TIM2_CH1；GPIO；GPIO 低有效 |
| 拨叉 STEP / DIR / EN | PD12 / PF6 / PF7 | 副板 | TIM4_CH1；GPIO；GPIO 低有效 |
| 串口屏 TX / RX | PB10 / PB11 | 副板 | USART3 |
| 层检测 I²C SDA / SCL | PB7 / PB6 | 主板 | I2C1 |
| 升降回零 | PG0 | 主板 | 常闭微动，内部上拉 |
| 升降下限 / 上限监测 | PG1 / PG2 | 主板 | 常闭微动，内部上拉 |
| 旋转原点霍尔 | PG3 | 主板 | 5 V 数字输入（FT 脚，无上下拉） |
| 拨叉收回 / 伸出 | PG4 / PG5 | 主板 | 常闭微动，内部上拉 |
| 转运台托盘霍尔 | PG6 | 主板 | 5 V 数字输入（FT 脚，无上下拉） |
| 急停辅助触点监测 | PG7 | 主板 | 常闭触点，内部上拉 |
| DOCK 车辆 / 手进入红外 | PD8 / PD9 | 主板 | 5 V 数字输入（FT 脚，无上下拉） |

说明：

- 三路 EN 相互独立、低有效（v3 的“共用 ENABLE”已取消）。固件上电后先把 EN 置高，再初始化脉冲输出。
- PG3、PG6、PD8、PD9 是 STM32F407 的 5 V 容忍（FT）引脚，可在主控正常供电、数字输入、GPIO_NOPULL 的条件下直接接 0～5 V 信号。依据见 [05_霍尔资料核对与主板FT直连](转接板_模块插装_v3/05_霍尔资料核对与主板FT直连.md)。
- 星火板载按键占用 PC0 / PC1 / PC4 / PC5，调试界面用轮询读取，不开 EXTI0/1/4/5，避免与 PG0/PG1/PG4/PG5 的中断线冲突。
- 40Pin 物理第 14 脚为 GND，第 30、34 脚为配置脚，不在载板强制接地。

### 6.4 层检测板 I/O

| MCP23017 引脚 | 用途 |
|---|---|
| GPA0…GPA6、GPB0 | 8 路霍尔输入（一层：7 车位 + DOCK；二层：7 车位，第 8 路空置） |
| GPA7、GPB1…GPB7 | 8 路指示 LED 输出（GPIO 侧须加限流） |

MCP23017 用 3.3 V 供电，I²C 上拉在 3.3 V，**其输入不是 5 V 容忍**。层板上 15 路 5 V 霍尔输出须先做电平处理再进 MCP，具体电路待按霍尔模块实物确定，见未决项。

### 6.5 传感器清单

| 器件 | 数量（两层 / 一层样机） | 供电与接法 |
|---|---|---|
| 数字霍尔模块（非锁存，只用 DO） | 17 / 10 | 5 V；车位霍尔进层检测板，原点和转运台霍尔进主板 |
| 红外对射（NPN 常开，30 cm 档） | 2 套 | 5 V；接收头进 PD8 / PD9，发射头只供电 |
| 微动开关（COM + NC） | 7：逻辑监测 5 + 动力硬限位 2 | 无源 |
| 急停按钮 | 1（两组独立常闭触点） | 一组切动力，一组给 PG7 监测 |

霍尔、红外的输出极性以实物实测为准，在软件里配置，不凭商品描述假定。

## 7. 人机界面：TJC 串口屏为最终界面，板载屏仅调试

| | 最终界面 | 调试界面 |
|---|---|---|
| 硬件 | TJC4827T143_011C，4.3 寸 480×272 电容触摸串口屏 | 星火板载 240×240 LCD + 四个方向键 |
| 连接 | USART3（PB10 / PB11），经副转接板 4P 口，外部 5 V 供电 | 板载，无需接线 |
| 界面实现 | USART HMI 上位机设计页面，固件收发串口指令 | LVGL（固件 `applications/lvgl/demo/garage_ui.c`） |
| 用途 | 参赛作品的人机界面，用于演示视频和计划书 | 副转接板和串口屏工程完成前，联调调度、运动和故障流程 |

两套界面只是“显示和输入的后端”不同。车位状态、任务进度、故障码都由调度层提供，界面只负责显示和把用户操作转成命令。固件里应把这层接口单独抽出来，让调试屏和串口屏共用同一套业务逻辑，切换屏幕时不改调度代码。当前 `garage_ui.c` 里的存取进度是定时器模拟的，接入真实运动后须替换。

## 8. 软件互锁

- 升降或旋转前，拨叉必须在收回位（收回位开关确认）。
- 空叉伸出：必须在该层脱开高度，且目标车位有托盘。
- 携盘伸出：必须在该层啮合高度，且目标车位为空。
- 啮合上抬：拨叉必须在伸出位，且车位霍尔检测到托盘。
- 拉回后：转运台托盘霍尔必须检测到托盘，同时车位霍尔变为无，否则报故障停机。
- 任何超时、霍尔状态不一致、限位异常，一律禁止后续动作，等待人工确认。
- 急停、断电、复位后，不在位置未知时自动回零。须人工确认无托盘跨缝、拨叉已收回后，才允许回零。

演示状态机（`docs/cad/simulation.js`）和测试脚本（`tools/test_cad_simulation.js`）已实现同一套规则。

## 9. 调度

- **状态**：车位表 `bay[层][方位] = {托盘号, 有车}`，另记转运台上的托盘。托盘有无由霍尔确认；车的有无由用户在 DOCK 确认后记录。
- **存车**：DOCK 已预置空托盘时用户可立即放车；否则调取代价最小的空托盘到 DOCK（代价：每换一层 3 分 + 每转 90° 1 分）。用户确认后，托盘送往代价最小的空车位。
- **空闲预置**：存车完成后，后台把下一块空托盘调到 DOCK。
- **取车**：DOCK 上如有预置的空托盘，先送回空车位，再把目标托盘调到 DOCK。用户取车后，空托盘留在 DOCK。
- **优先级**：急停 > 取车 > 存车 > 后台预置。抢占只发生在两个完整动作之间。
- **RT-Thread 线程**：人机、调度、运动、安全监测（最高优先级）。
- **节拍估算**：假设 Z 15 mm/s、转 90° 1.5 s、拨叉 40 mm/s，DOCK 为空时单次取车约 16～21 s（一层）、27～31 s（二层）。这是演示状态机累加的结果，不是实测。

## 10. 设计亮点

1. **一台转运装置服务所有层**：3 个电机，层数增加时不变；层模块无电机，可堆叠。
2. **用升降动作代替抓取执行器**：下沉 8 mm 脱开、上抬 8 mm 啮合。
3. **I²C 地址即层号**：上电自动识别层数，车位表和标定表按层生成。
4. **DOCK 空托盘预置 + 取车优先**的调度策略。
5. **8 方位辐射车位 + DOCK 竖井**：两层 14 辆，约 52 辆/m²。

## 11. 主要风险与未决项

| 风险 / 未决项 | 应对 |
|---|---|
| 托盘跨约 17 mm 交接缝时卡边、下垂或翻转 | 托盘端部、甲板内缘、支撑条端部倒角；**第一个要做的实物试验** |
| 拨叉与销对不准 | U 形口做喇叭口导入；每车位单独标定；拉回后用霍尔复核 |
| 升降高速丢步 | 梯形加减速；实测最高可靠速度；必要时降速或改细分 |
| 升降单丝杆偏置，平台倾斜卡滞 | LM8LUU 长轴承；带载实测倾斜 |
| 断电下滑 | 带载断电试验；不通过则换 1 mm 导程丝杆或抱闸电机 |
| 皮带端部夹持（名义搭接仅 6 mm）拉脱 | 先打印夹座小样做拉脱和往复试验 |
| 走线：v7 走线试配件曾发现相交 | 按走线优化安装复核版调整，实物装配后复查拖链和旋转线环 |
| 层板 5 V 霍尔输出进 3.3 V MCP 的电平处理未定 | 测量霍尔模块 DO 电路；开集电极则把上拉改到 3.3 V，否则用分立分压 |
| 串口屏完整型号后缀、供电和 TTL 电平未确认 | 对照屏幕实物标签和原厂规格书后再接线 |
| TMC2209 红排针模块的物理针序、细分配置脚未按实物核对 | 核对前不冻结主板封装 |
| 电机线束相序未验证 | 用万用表确认线圈配对后再定 4P 针序 |
| v3 平面间隙校核未按 v7 重算 | 改 `tools/check_hardware_v3.py` 的设计值后重跑，或在 v7 模型里量取 |
| 前侧少一根环梁，刚度下降 | 实测前角挠度，必要时加前梁或三角撑 |
