eatoughaidan5v4418-spec/-/docs/硬件验证与实施_v4.md

# 硬件验证与实施 v4

日期：2026-11-10。配套 [硬件方案 v4](硬件方案_v4.md) 和 [采购清单 v5](采购清单_v5.md)。样机先做一层，计划书按两层写。

> **当前状态：设计定稿，没有实物、没有通电测试。** 下面“已完成”的都是纸面和程序校核。

## 1. 已完成的校核，以及它们各自证明了什么

| 校核 | 工具 | 结论 | 局限 |
|---|---|---|---|
| v3 平面几何、高度 | `py tools/check_hardware_v3.py` | 布局和数字自洽 | 按井口 R96、托盘 r=97…222 计算，**未按 v7 重算** |
| 采购清单 v5 加总 | 同上（读取采购清单 v5） | 表格逐行与合计加总正确 | 只核对算术，不核对价格 |
| 调度状态机 | `node tools/test_cad_simulation.js` | 一层和两层、开 / 关空闲预置，共 104 个循环，托盘守恒，互锁规则无违规，无死锁 | 只验证逻辑，不涉及机构和电气 |
| 两层甲板销槽 | `node tools/test_deck_geometry.js` | 销槽布置自洽 | 平面检查 |
| v7 三维装配 | `py tools/check_garage_assembly_v7.py` 等 | 基准姿态、升降旋转离散采样、推拉和越程无干涉；拨叉与简化带轮连续包络间隙 ≥0.99 mm | 离散采样；不含真实带齿、张力、线束、变形 |
| v7 走线 | `tools/check_*wiring*_v7.*` | 走线优化后的模型与运动边界 | 线束刚度、弯曲寿命未建模 |
| 引脚与 FT 属性 | 人工核对 ST 数据手册、星火原理图 | 23 个功能 GPIO 无重复；PG3 / PG6 / PD8 / PD9 为 FT 脚 | 未测实际模块电压和时序 |

这些检查只能说明**图纸和数字前后一致、调度逻辑没有死锁**，不能证明能装配、能承重或上电安全。

## 2. 下单与画板前要确认的事项

1. 向卖家或按实物确认：T8 丝杆确为单头、导程 2；NEMA11 的扭矩和额定电流；转盘轴承的厚度和孔位。
2. 实物复尺：GT2 带轮外径、轮宽、轮缘，皮带厚度，微动开关动作距离，电机轴长。
3. 打印 1:1 甲板纸样，与实物导杆、轴承、支座比对后再切亚克力。
4. TMC2209 红排针模块：正反面丝印、16 针物理顺序、细分配置脚、板载电容。
5. 霍尔模块：有磁 / 无磁时 DO 的实际电压，是否自带上拉，上拉接到哪里。
6. 红外对射：遮挡 / 无遮挡时输出电压。
7. 串口屏：标签上的完整型号后缀，对应的供电电压和串口电平。
8. 电机线束：用万用表找出两组线圈，确定 4P 针序。

## 3. 实施顺序（先一层）

每一步都有明确的通过条件。前一步没过，不要往下做。

| 步骤 | 做什么 | 通过条件 | 记录 |
|---|---|---|---|
| 1. 托盘与甲板手推 | 切一块甲板局部和 2 块托盘，人工推拉托盘跨过交接缝，加最大预期载荷 | 不卡边、不翻转 | 推力、卡滞位置 |
| 2. 夹带座小样 | 打印夹座，装皮带做拉脱和往复 | 不滑脱 | 拉脱力、循环次数 |
| 3. 转运台单独验证 | 转运台固定在甲板高度，用 ±8 mm 垫块模拟升降，做入销、拉回、推出、脱开 | 连续 100 次 | 失败次数和原因 |
| 4. 升降塔 | 装立柱、导杆、丝杆和平台，低速回零，在 Z=92/100 往返；逐步提速 | 不丢步、不卡滞；**满载断电不下滑** | 最高可靠速度、重复定位、倾斜、温升、下滑量 |
| 5. 旋转标定 | θ 回零，8 个方位逐一标定 | r=107 处重复误差 ≤0.5 mm | 各方位误差 |
| 6. 一层完整演示 | 7 车位 + DOCK：存满、逐车取出、空闲预置、取消存车、急停恢复、DOCK 防手入 | 连续循环无故障 | 循环次数、故障记录 |
| 7. 加装第二层 | 装二层结构和层检测板（0x21），补录标定 | 自动识别层数；Z=182/190 啮合正常 | 前角挠度 |

## 4. 固件联调顺序

1. 单轴：一台 TMC2209 + 一台电机，定时器输出脉冲，先匀速再加梯形加减速。
2. 回零：微动开关和霍尔原点。
3. I²C：扫描并读写 MCP23017。
4. 界面：先用板载屏 + LVGL 调试界面联调（`garage_ui.c`），副转接板和串口屏工程就绪后切到 TJC 串口屏。
5. 线程：安全监测、运动、调度、人机四个线程，按仿真测试用例回归。

## 5. 样机完成后要回填的数据

以下数据目前在计划书里是设计目标。样机测完后，用实测值更新计划书第 6 节，并把相应表述从“预期”改为“实测”。

- 转角重复精度（r=107 mm 处）
- 升降最高可靠速度、换层时间
- 单次取车时间（一层、二层）
- 最高层满载断电下滑量
- 拨叉入销 / 拉回 / 推出 / 脱开 100 次循环成功率
- 一层连续存取无故障循环次数
- 急停按下到电机断电的时间
- 12 V 支路峰值电流
