eatoughaidan5v4418-spec/-/使用的硬件资料/实买型号核对.md

# 近一周实买型号核对（2026-11-10）

只对照已下单型号，不写物流信息。

## 已对上这款

- 星火1号：用户手册、官方原理图、点位 BOM，对应睿赛德这块板。
- STM32F407ZGT6：意法官方现行数据手册 DS8626 Rev 12（2026-03）。
- 串口屏 TJC4827T143_011C_I_P20：淘晶驰原厂规格书已放入 \TJC4827T143_011C串口屏/TJC4827T143_011C_I_P20_原厂规格书.pdf\（V1.4，2025-05-15）。4.3 寸电容触摸，480×272，接口 XH2.54-4Pin，串口 3.3 V CMOS/TTL，工作电压 4.65–6.5 V（典型 5 V），典型工作电流 230 mA（5 V、背光最大），推荐 5 V 1 A 电源。同目录另有官方出厂工程 \.HMI\。
- 较短 42BL40（0.44 N·m，机身约 40 mm）：文件夹里的步联《42BL4002-24A》规格书尺寸和转矩对得上，额定 3.4 V / 1.7 A。是否就是这款完整型号，仍待步联确认。

## 芯片对、模块不一定是原厂这一颗

- MCP23017、TMC2209 Rev 1.09、A3144：官方芯片手册。
- 优信 TMC2209 红排针模块介绍可作参考，采样电阻和默认电流以实物或商家资料为准。

## 只是标准尺寸，不是该店原厂图

- MGN7C / MGN7-100、LM8LUU 8×15×45、Φ8×270 两端 M4、SHF8、GT2 节距与节圆。

## 对不上或还缺专属规格书（待问商家）

- 28 电机 31 mm 机身带磁柱：现有 8BL262.6-18Y\ 规格书对不上（机身最大约 28.2 mm、无磁柱、转矩 35 mN·m）。
- 42BL40-67MM 出轴：不能用机身 40 mm 的 42BL4002-24A。
- 微动开关、红外对射 F5-30cm、DC-DC 5V/3A 芯片、梅花联轴器实际孔径、GT2 皮带实发长度。
