eatoughaidan5v4418-spec/-/使用的硬件资料/近一周采购件资料说明.md

# 最近一周淘宝采购件技术资料整理

整理时间：2026-11-10（Asia/Shanghai）。范围：2026-11-05 至 2026-11-09 实买型号，不含取件码、运单号，也不含 2026-11-08 已退款的 MCP23017 订单（11-09 回购的 2 片已计入）。

**原则：** 下列电压、电流、尺寸、接口只来自实际打开的页面或 PDF，未打开的数字一律不写。很多零件是淘宝通用件，没有原厂型号手册时，只给对应的族规格书或标准尺寸，并在条目中注明。

**链接检查：** 写入前用 HTTP 复查。404 已去掉。Analog、ST、部分 GitHub 首页超时，淘晶驰 wiki 偶发 500（此前已成功打开并摘录），icshop 返回 403，这些链接仍保留。

---

## 本地文件一览

| 文件 | 说明 |
| --- | --- |
| `MCP23017_datasheet.pdf` | Microchip 官方 MCP23017/MCP23S17 数据手册（DS20001952，约 41 页） |
| `TMC2209_datasheet.pdf` | Analog/Trinamic TMC2209 数据手册 Rev. 1.09（86 页）。官方 analog.com 下载超时，本文件来自内容一致的镜像 |
| `STM32F407ZGT6_datasheet.pdf` | ST 官方 STM32F405/407 数据手册 **DS8626 Rev 8（2016-09）**。st.com 最新版下载超时，本地是 GitHub 镜像，不是目前网上可见的更新版本 |
| `A3144_datasheet.pdf` | Allegro 官方 A3141/42/43/44 数据手册（已停产说明页 + 规格，9 页） |
| `Xinghuo1_user_manual_V1.1.0.pdf` | 睿赛德/RT-Thread《星火 1 号用户手册》V1.1.0（2023-09-20，230 页） |
| `Xinghuo1_schematic_V1_0.pdf` | 官方原理图 V1.0（KiCad 导出，10 页） |
| `Xinghuo1_pinout_BOM.html` | 官方点位与 BOM |
| `HIWIN_Linear_Guideway_Catalog.pdf` | HIWIN 直线导轨技术目录（含 MG/MGN 系列，245 页） |
| `LM_LUU_linear_bearing_SGR.pdf` | SGR 的 LM-LUU 尺寸表（1 页） |
| `LM8LUU_dimension_table_SGR.png` | 上表渲染图，便于查看 LM8LUU 一行 |
| `SDP_SI_GT2_2mm_timing_belts.pdf` | SDP/SI（Gates GT2）2 mm 节距同步带目录 |
| `SDP_SI_GT2_pulleys_2mm.pdf` | SDP/SI GT2 带轮（带宽至 6 mm）尺寸表 |
| `SDP_SI_GT2_GT3_pulley_stock.pdf` | SDP/SI GT2/GT3 带轮棒料页 |
| `MISUMI_linear_shafts.pdf` | MISUMI 光轴目录（含两端内牙系列） |

---

## 1. 微动开关 12.8×5.8×10 带柄 3 脚滚轮 ×7（优信电子）

- **购买型号：** 行程限位微动开关，标注尺寸 12.8×5.8×10，带柄 3 脚滚轮。
- **关键规格：** 仅能确认购买标注的外形和“3 脚滚轮限位”。额定电压/电流、行程、端子定义（COM/NO/NC）在本轮未找到与该尺寸完全对应的原厂手册，故不填写。
- **来源：** 无可靠原厂 PDF。检索了 KW11-3Z 等常见滚轮微动开关，常见 KW11 本体多约为 20×6.4 mm 量级，与 12.8×5.8 mm 不符，不能拿来套用。一份号称 KW11-3Z 的 PDF 实为占位说明，已删除，未采用。
- **本地文件：** 无。
- **说明：** 无品牌通用件。到手后建议用万用表确认脚位和常开/常闭，不要按别的型号手册接线。

## 2. 电机测速霍尔开关模块 3144 ×17（优信电子）

- **购买型号：** 电机测速霍尔开关传感器模块，标注 3144。
- **关键规格（芯片，来自 Allegro 官方手册）：**
  - 器件：A3144 单极性霍尔开关（已停产；官方替代建议为 A1104）。淘宝模块上的 3144/AH3144 多为兼容件，磁阈值不必与原厂完全一致。
  - 供电：4.5–24 V（绝对最大 28 V）。
  - 输出：开集电极，连续灌电流 25 mA；磁场超过动作点 BOP 时输出拉低（ON），低于释放点 BRP 时输出关断。
  - A3144 在 25°C：BOP 70–350 G（无典型值），BRP 50–330 G，磁滞典型 55 G。
  - 芯片引脚（从有字一面看）：1 = VCC，2 = GND，3 = OUTPUT。
- **模块引脚（典型，非本 SKU 原厂图）：** 打开过的一类 A3144 模块为 VCC / GND / DO，有的还带 AO 和 LM393。工作电压有写成 3–5.5 V 的（模块板级，低于芯片手册 4.5 V 下限）。本优信 SKU 是 3 脚还是 4 脚、板上有无比较器，未找到该店原理图，只能当典型接法。
- **来源：** https://www.allegromicro.com/-/media/files/datasheets/a3141-2-3-4-datasheet.pdf （复查 200）
  - 模块典型说明（复查时超时，本轮早先已打开）：https://www.openimpulse.com/blog/products-page/other-sensors/a3144-hall-switch-sensor-module/
- **本地文件：** `/workspace/parts-docs/A3144_datasheet.pdf`

## 3. MCP23017 16 位 I2C 转 I/O 模块 ×2（优信电子）

- **购买型号：** 优信电子 MCP23017 16 位串行接口 I/O 扩展器模块（I2C 转 I/O）。11-08 退款单已排除。
- **关键规格（Microchip 官方手册，芯片级）：**
  - 16 位双向 I/O；MCP23017 的 GPA7、GPB7 仅为输出。上电默认为输入。
  - I2C：100 kHz / 400 kHz / 1.7 MHz。
  - 硬件地址脚 A2/A1/A0，同一总线最多 8 片。控制字节为 `0100 A2 A1 A0 R/W`，对应 7 位地址 0x20–0x27。
  - 工作电压：1.8–5.5 V（–40–+85°C）；另有 2.7 V 与 4.5 V 高温档。
  - 待机电流最大 1 µA；可配置中断 INTA/INTB。
- **模块级：** 未找到优信这块板的原理图或地址焊盘说明（通常需确认 A0–A2 上拉/下拉、RESET 是否已拉高、I2C 上拉是否已做）。
- **来源：** https://ww1.microchip.com/downloads/aemDocuments/documents/APID/ProductDocuments/DataSheets/MCP23017-MCP23S17-16-Bit-IO-Expander-with-Serial-Interface-DS20001952.pdf （复查 200）
- **本地文件：** `/workspace/parts-docs/MCP23017_datasheet.pdf`

## 4. XLHW 红外对射 F5-30cm 常开带端子 ×2（深圳市亿雅电子科技）

- **购买型号：** XLHW 红外开关 0–30 cm 对射，对管分体，F5-30cm 常开-带端子。
- **关键规格：** 未找到亿雅/XLHW 原厂规格书。打开过一款同名类“F5 对射 0–30 cm”商品页，仅能作族参考，且该页数字自相矛盾，不能当准确参数：
  - 类型写成 F5 对射；输出 NPN 常开；响应 2 ms。
  - 供电有的地方写 DC 3–5 V，有的地方写 DC 5 V；电流有的写 20 mA，有的写 20 A（20 A 明显不合理）。
  - 探测距离标题为 0–30 cm，细节里又写 Range 1M。
  - 接线（该页）：发射端红 5 V、黑 GND；接收端红 5 V、黑 GND、白 OUT（NPN）；注明不可反接。
  - 外形该页写 20×10×9 mm，灯珠 5 mm / 850 nm，线长约 30 cm——**不能确认等于这次买到的带端子版本**。
- **来源：** https://kitsguru.com/products/infrared-switch-counting-module-0-30cm-through-beam-infrared-tube-split-beam-photoelectric-switch （复查 200）
- **本地文件：** 无。
- **说明：** 通用对射模块。建议到手后先确认供电和输出电平，不要用上述互相冲突的电流/距离数字做设计依据。

## 5. 42 步进电机 42BL40 配 1 米线 0.44 N·m ×2（步联机电，较短款）

- **购买型号：** 42BL40，配 1 米线，保持转矩标称 0.44 N·m。任务说明中写 NEMA17、两相 4 线、12 V/24 V，但这些未在本轮打开的厂商手册中核对。
- **关键规格：** **未找到步联或 42BL40 的公开规格书。** 因此额定电流、相电阻、电感、步距角、机身长度、轴径、线色均不填写。购买名表示这是 42 机座、标称 0.44 N·m 的较短一款，需与第 19 条（42BL40-67MM 出轴）区分。
- **检索：** “步联机电 42BL40”“42BYGH40 0.44 N·m 规格书”及若干电机厂样本，没有对上该卖家型号的 PDF。
- **本地文件：** 无。
- **说明：** 通用/店铺型号。使用前应看实物铭牌或向卖家要样本，电流不要按网上常见 1.7 A 一类“典型值”直接设置。

## 6. 加厚满珠万向转盘 3 寸 / 轻型【可承重 20 kg】×2（斐扬旗舰店）

- **购买型号：** 3 寸轻型满珠万向转盘，卖家标称可承重 20 kg。
- **关键规格：** 未找到该店或该 SKU 的尺寸图（外径、厚度、安装孔距、孔径）。检索到的欧美 3 英寸 Lazy Susan（如 Triangle 3C，约 76.2 mm 方形）与常见国产“3 寸满珠转盘”（有的标 73 mm 左右圆盘）不是同一套图纸，不能混用。
- **来源 / 本地文件：** 无。
- **说明：** 无型号通用件。需要开孔尺寸时只能量实物或向卖家要图。

## 7. RT-Thread 星火 1 号 STM32F407ZGT6 开发板 ×1（睿赛德科技）

- **购买型号：** RT-Thread 星火 1 号，主控 STM32F407ZGT6。
- **板级规格（官方用户手册 V1.1.0、官方 BSP README、官方原理图）：**
  - MCU：STM32F407ZGT6，主频 168 MHz，1024 KB Flash，192 KB RAM。
  - 片外 Flash：W25Q128（SPI，16 MB）。
  - LED：LED_R 红 PF12，LED_B 绿 PF11（共阳，低电平点亮）。手册/README 对第二颗颜色表述有“绿/蓝”混用，以原理图网名为准。
  - 按键：KEY_UP/唤醒 PC5，KEY_DOWN PC1，KEY_LEFT PC0，KEY_RIGHT PC4；按下为低电平。
  - 其他板载（手册例程覆盖）：USB 转串口、SD、USB Host/Slave、板载调试、Wi-Fi、LCD（驱动 ST7789 v3，8080 并口/FSMC）、AHT10、AP3216C、ICM20608、红外收发（发射 PB1，接收 PF8）等。细节见原理图与点位 BOM。
  - BSP 默认串口终端：115200-8-1-N。
- **MCU 规格（本地 ST 手册 Rev 8）：** Arm Cortex-M4 + FPU，最高 168 MHz；Flash 最多 1 MB；SRAM 最多 192+4 KB（含 64 KB CCM）；供电 1.8–3.6 V；ZGT6 为 LQFP144（20×20 mm）。官方站点最新版下载超时，设计请再对照 st.com 现行版本。
- **来源：**
  - 手册/原理图/BOM：https://github.com/RT-Thread-Studio/sdk-bsp-stm32f407-spark （仓库首页复查超时；raw 原理图 200）
  - BSP 说明：https://github.com/RT-Thread/rt-thread/blob/master/bsp/stm32/stm32f407-rt-spark/README.md （200）
  - 文档中心（SPA 页，复查 200，打开时主要内容在“Loading”后需前端渲染）：https://www.rt-thread.org/document/site/#/rt-thread-version/rt-thread-standard/hw-board/spark-1/spark-1
  - MCU 官方地址（下载超时，保留）：https://www.st.com/resource/en/datasheet/stm32f407zg.pdf
- **本地文件：**
  - `/workspace/parts-docs/Xinghuo1_user_manual_V1.1.0.pdf`
  - `/workspace/parts-docs/Xinghuo1_schematic_V1_0.pdf`
  - `/workspace/parts-docs/Xinghuo1_pinout_BOM.html`
  - `/workspace/parts-docs/STM32F407ZGT6_datasheet.pdf`

## 8. 法兰联轴器 刚性法兰盘 5 mm ×4（炫彩五金）

- **购买型号：** 刚性法兰联轴器，孔径 5 mm。外径、厚度、孔距在购买标题中未给出。
- **关键规格：** 无该店图纸。打开过一款同类 5 mm 刚性法兰商品页（复查 403，本轮早先已打开）：内径 3–6 mm 时外形 22×12 mm，圆柱外径 10 mm、高 10 mm，整体高 12 mm，法兰固定孔 M3。这是**另一商家的同类件**，不能当作炫彩这批的实测尺寸。
- **来源：** https://www.icshop.com.tw/products/368030501159 （复查 403，保留）
- **本地文件：** 无。
- **说明：** 通用五金件，建议量孔径、法兰外径和孔距后再配盘。

## 9. 2GT 惰轮 20 齿 内孔 5 带齿（带宽 6）×1（启庞科技）

- **购买型号：** 2GT/GT2 惰轮，20 齿，内孔 5 mm，带齿，适用带宽 6 mm。
- **关键规格（Gates GT2 族，SDP/SI 目录，非该店图纸）：**
  - 齿距 2 mm。20 槽带轮节圆直径 0.501 in（约 12.73 mm），外径 0.481 in（约 12.22 mm）。官方表针对“带宽至 6 mm”的 GT2 带轮。
  - 购买件内孔 5 mm、是否带轴承、挡边高度等，目录中对应型号并非 5 mm 孔，不能照搬总长和轮毂。
- **来源：**
  - https://sdp-si.com/products/Miniature-PDF-Catalog/inch-belts-and-pulleys/90003013.pdf （200）
  - 带宽规格：https://shop.sdp-si.com/media/pdf/80502136.pdf （200）
- **本地文件：** `/workspace/parts-docs/SDP_SI_GT2_pulleys_2mm.pdf`，`/workspace/parts-docs/SDP_SI_GT2_2mm_timing_belts.pdf`
- **说明：** 3D 打印机通用轮，节距/节圆可按 GT2 标准，外形以实物为准。

## 10. 2GT 同步轮 普通版 16 齿 高 14 内孔 5 mm ×1（启庞科技）

- **购买型号：** 3D 打印机 2GT 同步轮，普通版，16 齿，高度 14 mm，内孔 5 mm。标题未写明带宽，同店皮带为 6 mm。
- **关键规格（同上，族标准）：** 齿距 2 mm。16 槽：节圆 0.401 in（约 10.19 mm），外径 0.381 in（约 9.68 mm）。SDP/SI 16 槽商品页亦给出 PD 10.2 mm、OD 9.7 mm（该页是 3 mm 带宽、4 mm 孔的另一型号，仅节圆/外径可参考）。购买件“高 14 mm”、孔 5 mm 无官方图。
- **来源 / 本地文件：** 同第 9 条；另 https://shop.sdp-si.com/a-6a51m016df0304.html
- **说明：** 通用同步轮。

## 11. GT2-6 mm 橡胶同步带（加防滑布）×1（启庞科技）

- **购买型号：** 3D 打印机 GT2-6 mm 橡胶同步带，加防滑布。**周长/齿数在订单标题中没有，本轮也未找到该店长度信息。**
- **关键规格（Gates GT2 / SDP/SI 带目录）：**
  - 齿距 2 mm；目录列出带宽 3 / 6 / 9 mm。
  - 齿高 0.76 mm（0.030 in），带宽方向截面高 1.52 mm（0.060 in）。
  - 材料：氯丁橡胶，尼龙齿面，玻璃纤维芯。工作温度 –30°C 至 +100°C。
  - 目录注明 GT3 为 GT2 的直接替代（库存过渡说明）。
- **来源：** https://shop.sdp-si.com/media/pdf/80502136.pdf （200）
- **本地文件：** `/workspace/parts-docs/SDP_SI_GT2_2mm_timing_belts.pdf`
- **说明：** 通用 GT2 6 mm 带，**长度未知**，需量实物或问卖家。

## 12. DC-DC 降压模块 5 V/3 A ×2（优信电子）

- **购买型号：** DC-DC 降压电源模块，标题为 5–30 V 输入转 3.3 V/5 V 输出、3 A 迷你降压；SKU 为“DC-DC降压模块5V/3A”。
- **关键规格：** **未识别出板上芯片，也没有该模块的原厂说明书。** 不能按常见 MP1584 模块手册填写输入下限、效率或尺寸。购买标题含义是：输入约 5–30 V，输出按 SKU 为 5 V/3 A（标题同时出现 3.3 V/5 V，是否可调未证实）。
- **来源 / 本地文件：** 无。
- **说明：** 无型号模块。使用前应看实物丝印、用万用表确认输出，并留足降压压差与散热余量。

## 13. TMC2209 驱动模块（红色排针）×6（优信电子）

- **购买型号：** ATD5833/TMC2225/2208/2209 系列中的“TMC2209 驱动模块（红色排针）”。
- **关键规格（芯片官方手册 Rev. 1.09，2023-02-16）：**
  - 两相步进驱动，峰值电流至 2.8 A，有效值至 2 A RMS。
  - 供电 4.75–29 V DC（订购信息处也写 4.75–28 V）。
  - STEP/DIR；管脚可设 8/16/32/64 微步，MicroPlyer 插补至 256 微步。
  - StealthChop2、SpreadCycle、StallGuard4、CoolStep；可选单线 UART 与 OTP。
- **模块级：** 未找到优信“红色排针”板的原理图、采样电阻或限流公式。模块实际电流能力取决于板上 Rsense / VREF，**不要按芯片 2 A RMS 直接当模块额定值**。UART 与 EN、MS1/MS2 排针定义需对照实物丝印。
- **来源：** 官方 https://www.analog.com/media/en/technical-documentation/data-sheets/TMC2209_Datasheet_rev1.09.pdf 与产品页（复查超时，保留）。本地 PDF 由可达镜像保存，标题/修订为 TMC2209 Datasheet Rev. 1.09。
- **本地文件：** `/workspace/parts-docs/TMC2209_datasheet.pdf`

## 14. 淘晶驰 T1 串口屏 TJC4827T143_011C_I_P20 ×1（优信电子）

- **购买型号：** T1 系列，完整型号 **TJC4827T143_011C_I_P20**。
- **命名（官方型号页，2026-11-09 资料中心）：** T1，4.3 寸，**电容触摸**，**IPS**，铁耳朵支架，分辨率 480×272。后缀 C=电容，I=IPS，P20=铁耳朵。这与部分订单转述里的“电阻 TN”不一致，**以官方型号后缀为准**。
- **电气与接口（官方 T1 系列对比表 + 接线/电平/指令文档）：**
  - 对比表对 TJC4827T143 族写：有效显示 95.04×53.86 mm，分辨率 480×272，**TFT 类型栏为 TN**，亮度 300 nit，工作电压 4.65–6.5 V，工作电流约 230 mA（表注：电流仅供参考，以规格书为准；电容触摸休眠电流通常更大），工作温度 –20～+70°C，Flash 8 MByte，运行内存 3584 Byte，串口缓存 1 KByte，主频 64 MHz，无 EEPROM/RTC/扩展 I/O。该页“TFT=TN”与本 SKU 的“I=IPS”并存，未在本轮打开到该 SKU 的完整 PDF 规格书以最终裁定面板类型。
  - T1 通讯口为 **3.3 V TTL**，可直接接 3.3 V 或 5 V 单片机。接线：屏 TX→MCU RX，屏 RX→MCU TX，GND 共地。4.3 寸以上若上电反复重启，文档指出可能是供电不足，需在电压范围内并联供电。
  - 支持波特率：2400、4800、9600、19200、38400、57600、115200、230400、256000、512000、921600。文档示例为 `bauds=115200`，**本轮未在已打开页面中看到出厂默认波特率的明确一句**。
  - 指令以三个 `0xFF` 结束。指令集见官方“指令集”页；离线 PDF/HTML 包入口在开发文档下载页（本轮未能从该页解析到可下载的直接 PDF 链接）。
- **来源（本轮曾成功打开；随后 HEAD 复查为 500，保留）：**
  - 型号页：http://wiki.tjc1688.com/product/new_datasheet/T1/TJC4827T143_011C_I_P20.html
  - 系列对比：http://wiki.tjc1688.com/product/T1_serial_compare.html
  - 接线：http://wiki.tjc1688.com/debug/connect_mcu.html
  - 通讯电平：http://wiki.tjc1688.com/QA/QA3.html
  - 波特率：http://wiki.tjc1688.com/QA/baudrate.html
  - 指令协议：http://wiki.tjc1688.com/debug/usart_protocol/mcu2tjc.html
  - 指令集：http://wiki.tjc1688.com/commands/index.html
  - 离线资料入口：http://wiki.tjc1688.com/download/development_doc.html
- **本地文件：** 未能下载到该型号独立规格书 PDF（wiki 页面以在线图样为主，且随后 500）。

## 15. 光轴支撑座 SHF8（穿 8 mm 光轴）×4（ETJ 五金）

- **购买型号：** SHF8，穿 8 mm 光轴。
- **关键规格（MISUMI SHF 法兰开缝支撑座尺寸表，D=8 行）：**
  - 孔径 D=8 mm；L=43，T=10，t=5，H=24，A=20，L1=32，d=5.5，d1=9，D1=10，t1=1.5，B=18，C=2，h=9.5 mm；锁紧螺钉 M4；铝合金质量约 10 g。
- **来源：** https://us.misumi-ec.com/vona2/detail/110300013850/?HissuCode=SHF8 （200）
- **本地文件：** 无单独 SHF 图纸 PDF（已打开上述带尺寸表的产品页）。
- **说明：** 购买件是通用 SHF8，不是 MISUMI 原厂，尺寸按该标准族给出。

## 16. 直线轴承 长款 LM8LUU 8×15×45 ×2（尚赢轴承，“精密工业 5 级”）

- **购买型号：** LM8LUU，标称 8×15×45，长款双密封。
- **关键规格（SGR《Linear bearing series LM LUU》尺寸表中 LM 8 LUU 行）：**
  - 公称轴径 8 mm，4 列滚珠；内径 8 mm，外径 15 mm，全长 45 mm；宽度 B=35 mm，密封宽 W=1.1 mm，D1=14.3 mm。
  - 基本额定动载荷 431 N，静载荷 784 N，质量 31 g。
- **来源：** https://www.sgrindustrialhouse.com/dimensions/Linear%20bearing%20series%20LM%20LUU.pdf （200）
- **本地文件：** `/workspace/parts-docs/LM_LUU_linear_bearing_SGR.pdf`，`/workspace/parts-docs/LM8LUU_dimension_table_SGR.png`
- **说明：** 通用 LM8LUU。“精密工业 5 级”是卖家用语，未在该表中出现对应精度等级定义。

## 17. 梅花联轴器 外径 20 长度 25 ×2（上航自动化）

- **购买型号：** 梅花联轴器，外径 20 mm，长度 25 mm；标题写“孔 5 至 8 都有”，**本单实际孔径未在标题中确定**。
- **关键规格（一家供应商的 LM-20×25 族表，非上航原厂样本）：**
  - D=20 mm，L=25 mm，孔径范围 4–10 mm；轴孔长 l1=7.50 mm，弹性体厚 l2=10 mm；紧固 M3，拧紧力矩 1.30 N·m；额定扭矩 2.80 N·m，最大 5.60 N·m；最高转速 17000 r/min；径向/角度/轴向偏差等见该表。
- **来源：** https://www.nscbearing.cn/cn/products/Other-products/Jaw-coupling/690.html （200）
- **本地文件：** 无 PDF（尺寸来自已打开的网页表）。
- **说明：** 通用 D20×L25 梅花联轴器。孔径请以实物或订单选项为准，不要默认某一孔。

## 18. 菱形带座轴承 KFL08 内径 8 mm ×1（轴承批发 09，标题含“丹洋锌合金”）

- **购买型号：** KFL08，内径 8 mm，锌合金菱形座。
- **关键规格（RMO 轴承网页族表，非“丹洋”原厂样本）：**
  - d=8，H=48，L=27，A=8.5，J=36，N=5，A1=4，A2=4，A0=12，S=3 mm，表列质量 0.022 kg。同页另一处把重量写成 0.22 kg，与表不一致，采用表内 0.022 kg 并记下冲突。
  - 同页还写 Size 8×48×27×12 mm，与 A0=12 相符。工作温度该页写 –20°C 至 +120°C。
- **来源：** https://www.rmobearing.com/pillow-block-bearing/kfl08-k08-fl08-zinc-alloy-housing-bearing.html （200）
- **本地文件：** 无 PDF。
- **说明：** 通用 KFL08。尺寸按常见锌合金菱形座族表。

## 19. 42 步进电机 42BL40-67MM 出轴 配 1 米线 0.44 N·m ×2（步联机电）

- **购买型号：** 42BL40-67MM 出轴，配 1 米线，0.44 N·m。与第 5 条较短的 42BL40 不是同一规格。
- **关键规格：** **同样没有公开规格书。** 标题中的“67MM 出轴”按采购清单理解为较长机身（约 67 mm），但未打开到图纸来确认 67 mm 是机身长还是轴伸长。电流、电阻、步距角、轴径、线色未知。
- **来源 / 本地文件：** 无。
- **说明：** 与第 5 条务必分开使用和设置电流。

## 20. 28 步进电机 NEMA11 31 mm 机身带磁柱 ×1（步联机电）

- **购买型号：** 28 电机（NEMA11），机身 31 mm，带磁柱。任务说明中有两相 4 线、12 V、可能带霍尔磁柱，本轮未打开到厂商手册加以核对。
- **关键规格：** **未找到步联或该 28/31 mm 带磁柱型号的规格书。** 额定电流、转矩、步距角、轴径、磁柱/霍尔接口定义均不填写。
- **来源 / 本地文件：** 无。

## 21. 直线镀铬硬轴 Φ8×270 mm（2 支）两端 M4 内牙 ×1 包（永强轴承）

- **购买型号：** 硬轴 Φ8×270 mm，两端 M4 内牙，一包 2 支。
- **关键规格（MISUMI 两端内牙光轴族，PSFGW 等，用作标准尺寸而不是品牌证明）：**
  - 直径 8 mm、长度 270 mm 在可选范围内（D=8 的 L 为 20–800 mm，1 mm 递增）。
  - 两端粗牙可选 M3/M4/M5；选项名写明普通档螺纹深度为 2×M，故 M4 时深度为 8 mm（需满足 2M+2N ≤ L；270 mm 满足）。
  - PSFGW：硬铬，镀层硬度 HV750 以上、厚度 10 µm 以上，直径公差 f8（Ø8 为 −0.013 / −0.035 mm），倒角 C≤0.5 mm。购买件是永强通用硬轴，公差和镀层不必与 MISUMI 相同，但“Ø8、长 270、两端 M4 内牙”与该族一致。
- **来源：** https://uk.misumi-ec.com/vona2/detail/110302634470/ （200）
- **本地文件：** `/workspace/parts-docs/MISUMI_linear_shafts.pdf`
- **说明：** 通用镀铬硬轴，按标准两端内牙光轴族给出螺纹深度约定。

## 22. MGN7C 滑块 ×1（xundazc 五金，“加重加厚精密 P4 级标准块”）

- **购买型号：** MGN7C 滑块。卖家“P4 级/加重加厚”为商品用语，不是 HIWIN 精度代号的官方表述（HIWIN MG 精度另有体系）。
- **关键规格（HIWIN 目录 2-4-19，MGN 7C）：**
  - 组件高 H=8，H1=1.5，N=5；滑块宽 W=17，B=12，B1=2.5，C=8，L1=13.5，L=22.5，Lmax=23.1 mm；安装螺纹 M2×2.5；Gn=Ø1.2。
  - 基本额定动载荷 C=0.98 kN，静载荷 C0=1.24 kN；静力矩 MR=4.70 N·m，MP=MY=2.84 N·m；滑块质量 0.010 kg。
  - 滑块安装螺钉表：MGN7C/H 为 M2×0.25P，拧紧力矩 57 N·cm（5.9 kgf·cm）。
- **来源：** https://hiwin.com/wp-content/uploads/2026/08/HIWIN-Linear-Guideway-Catalog-1.pdf （200；文件内制作日期为 2024-10-23）
- **本地文件：** `/workspace/parts-docs/HIWIN_Linear_Guideway_Catalog.pdf`（MG 系列约自目录第 76 页，尺寸表在 2-4-19 节）
- **说明：** 通用 MGN7C，尺寸按 HIWIN 族标准。互换性和预压、精度不要按“P4”广告理解。

## 23. MGN7 导轨 100 mm ×2（xundazc 五金，“精密 P4 级”）

- **购买型号：** MGN7 导轨，长 100 mm（10 cm）。
- **关键规格（同一 HIWIN 表，与 MGN7 滑块配套的导轨尺寸）：**
  - 轨宽 WR=7 mm，轨高 HR=4.8 mm；安装孔 D=4.2，h=2.3，d=2.4；孔距 P=15 mm，端部 E=5 mm；导轨安装螺钉 M2×6。
  - 导轨线密度 0.22 kg/m。按 E + nP + E 验算：5 + 6×15 + 5 = 100 mm，与 100 mm 长度相符。
- **来源 / 本地文件：** 同第 22 条。
- **说明：** 通用 MGN7 短轨，按 HIWIN 标准孔距解释 100 mm 长度。

---

## 未能充分记录的项目（检索结论）

| 条目 | 搜过什么 | 缺什么 |
| --- | --- | --- |
| 1 微动开关 | KW11-3Z 及 12.8×5.8×10 滚轮开关手册 | 与该尺寸对应的原厂额定值、行程、脚位图 |
| 4 红外对射 | XLHW / F5-30cm / 亿雅 | 该 SKU 原厂规格；仅有互相矛盾的同类商品页 |
| 5 / 19 42 步进 | 步联、42BL40、42BYGH40 样本 | 电流、电阻、步距角、轴径、线色、67 mm 定义 |
| 6 转盘 | 3 寸满珠转盘、Triangle 等 3 inch lazy susan | 斐扬该款外径与孔距 |
| 8 法兰联轴器 | 5 mm 刚性法兰商品页 | 炫彩该批实测外形 |
| 11 同步带 | 启庞 GT2-6 mm | **带长未知** |
| 12 降压模块 | 优信 5 V/3 A 迷你模块、常见 MP1584 板 | 芯片型号与模块说明书 |
| 13 TMC 模块 | 芯片手册已齐 | 红排针板采样电阻、排针定义 |
| 14 串口屏规格书 PDF | 淘晶驰 wiki 型号页与下载页 | 该 SKU 独立 PDF（wiki 图未另存成功）；出厂默认波特率未在已打开正文中出现 |
| 20 28 步进 | 步联、NEMA11 31 mm 带磁柱 | 全部电气/机械详细参数与磁柱接口 |

官方芯片与板卡手册（MCP23017、TMC2209 芯片、A3144、星火 1 号、STM32 旧版手册）以及机械标准族尺寸（HIWIN MGN7/MGN7C、SHF8、LM8LUU、KFL08、GT2 16/20 齿、Φ8 两端 M4 光轴、D20×L25 梅花）已尽量落到本地或在上文给出已打开来源。
