eatoughaidan5v4418-spec/-/使用的硬件资料/资料索引.md

# 硬件资料索引

整理日期：2026-11-05。此目录保留原有电机和驱动资料，新增星火一号开发板及淘晶驰串口屏资料。

## 星火一号开发板

资料来源为 [RT-Thread 官方开发板文档](https://www.rt-thread.org/document/site/#/rt-thread-version/rt-thread-standard/hw-board/spark-1/spark-1) 和其链接的 [官方 SDK 仓库](https://github.com/RT-Thread-Studio/sdk-bsp-stm32f407-spark)。

| 本地资料 | 用途 |
| --- | --- |
| [星火一号用户手册 V1.1.0](星火1号开发板/星火1号用户手册_V1.1.0.pdf) | 开发板硬件、接口及使用说明 |
| [开发板原理图 V1.0](星火1号开发板/星火1号开发板_官方原理图_V1.0.pdf) | 核对电源、接口和引脚连接 |
| [点位与 BOM](星火1号开发板/星火1号开发板_官方点位与BOM.html) | 浏览器打开，查找器件和板上位置 |
| [官方开发板介绍](星火1号开发板/星火1号开发板_官方介绍.md) | 开发板资源和开发环境入口 |
| [BSP 使用说明](星火1号开发板/星火1号_BSP使用说明.md) | 板级支持包、外设支持和快速上手 |
| [教育套件模块例程](星火1号开发板/星火1号教育套件模块例程_V1.1.0.pdf) | 教育套件相关模块的参考例程 |

官方页面还提供 [SDK 与示例工程](https://github.com/RT-Thread-Studio/sdk-bsp-stm32f407-spark) 和 [RT-Thread 主仓库的星火一号 BSP](https://github.com/RT-Thread/rt-thread/tree/master/bsp/stm32/stm32f407-rt-spark)。这两处为在线链接，并非已下载的完整源码包。

点位 BOM 页面标注的板卡修订版与原理图文件版本未必相同；正式确定接线前请对照实物板卡版本。官方开发板介绍与 BSP 文档对板载 Flash 容量的描述也不一致，应以实物芯片标识和对应版本原理图为准。

## 淘晶驰 TJC4827T143_011C 串口屏

已确认触摸版本为 **011C 电容屏**，`_I_P20`、`_I_F` 等更完整的后缀仍需对照实物标签。

| 本地资料 | 用途 |
| --- | --- |
| [淘晶驰串口屏开发手册离线版](TJC4827T143_011C串口屏/淘晶驰串口屏资料中心_离线版_斑梨电子提供.pdf) | 资料中心手册的第三方提供副本；可查上位机、接线、通信协议和指令集 |
| [011C 型号与资料说明](TJC4827T143_011C串口屏/型号与资料说明.md) | 型号后缀差异、官方资料入口及未下载文件说明 |

离线手册生成于 2023 年，属于通用开发资料，并非 011C 专用规格书。请以对应实物型号和较新的官方资料为准。

原有资料：`步进电机规格书` 文件夹和 `TMC2209步进电机驱动(我们使用红色排针).pdf`。
