eatoughaidan5v4418-spec/-/docs/MCP23017_优信模块封装_估算版/说明与导入步骤.md

# 优信 MCP23017 模块封装（商品图估算版）

本封装用于现成模块插到载板上的三排排母，不是 MCP23017 芯片本体封装。
依据本仓库“使用的硬件资料/商品页已核SKU/MCP23017模块”中的尺寸图和背面丝印图。

## 尺寸与置信度

| 项目 | 采用值 | 依据 |
|---|---|---|
| 模块外形 | 21 × 26 mm | 商品图标称，未实测 |
| 单列针距 | 2.54 mm | 常用排针规格，与照片比例吻合，未实测 |
| 双列中心距 | 2.54 mm | 照片比例估算，未实测 |
| 最外侧列中心距 | 19.05 mm（750 mil） | 照片约 7.4 个针距，取接近的 7.5 个针距，未实测 |
| 控制列到中间列 | 16.51 mm | 由 19.05 − 2.54 得出，未实测 |
| 首末孔中心距 | 22.86 mm | 9 × 2.54，随针距待核对 |
| 圆形镀铜孔 | 1.00 mm | 适配常见 0.64 mm 方针的载板设计值，需核对排母规格 |
| 焊盘 | 1.80 mm | 载板设计值，单侧铜环 0.40 mm |
| 原点 | 模块外形中心 | 设计选择；实际孔阵列边距仍待核对 |

旧 U1 的外侧孔列间距为 20.32 mm（800 mil）；本稿采用 19.05 mm。
两者相差 1.27 mm，不能认定旧库尺寸正确，也不能将本稿称作实测封装。
常用的 2.54 mm 是相邻针距，模块两侧距离没有统一标准。

## 朝向与引脚

从模块正面（芯片面）向下看：最左列 21～30（GND、INTA、GPA0～7）；
中间列 11～20（VCC、INTB、GPB0～7）；最右列 1～10
（A2、A1、A0、RESET、NC/SO、NC/CS、SDA、SCL、GND、VCC）。
每列从上到下编号递增，三列顶部均为方焊盘。背面照片的左右需镜像后才是安装正面。
编号沿用先前 U1 的分组方式；信号依商品背面丝印解释，尚未核对当前原理图符号的逐针映射。
绑定前请按 CSV 对照符号针号，尤其确认 GPA/GPB、VCC/GND 和 INTA/INTB。
每个焊盘独立编号，无预置网络，也没有将相同名称的电源脚或 NC 脚短接。

## 导入嘉立创 EDA 专业版

提供 KiCad 5 ASCII `.kicad_mod` 及 `.pretty` 库压缩包。
官方“格式转换助手”明确支持 `.kicad_mod` 的导入与库提取：
https://prodocs.lceda.cn/cn/import-export/easyeda-pro-format-converter/

1. 在格式转换助手选择 KiCad，将源目录指向解压后的 `.pretty` 文件夹，选择一个新的输出目录。
2. 扫描并转换该封装库文件。
3. 在嘉立创 EDA 专业版使用“文件 → 导入 → 嘉立创EDA（专业版）”导入转换结果。
4. 打开封装，复核 30 个孔、三列位置、方焊盘和针号，再绑定器件。

当前 MCP 无封装几何编辑/库导入接口，因此本次交付文件，没有替换工程 U1。
本地检查验证了语法结构、孔数、编号、坐标、间距和铜环；尚未在嘉立创转换器中实际转换或运行原生封装规则检查。
建议按 100% 比例打印或用实物排母试配；验证外侧孔距后再用于制板。
