eatoughaidan5v4418-spec/-/docs/PCB生产文件_20261111/交付说明.md

# PCB1 / PCB2 打样文件说明（2026-11-11）

工程：立体车库 MCP 原理图重绘 20261107。

## 结果

- PCB1、PCB2 均已保存，重新打开后通过嘉立创 EDA 原生 DRC，无违规项。
- PCB1 U1 的完整元件及焊盘数据与机械修改前完全一致，位置 (1265.9055, 3770.1575) mil，顶层，0°。
- 本轮没有改动原理图和 PCB3；没有改变网络名或删除现有元件。
- 顶层、底层均为 GND 铺铜，preserveSilos:false（移除孤岛）；原生 DRC 未报 GND 断连。
- 已检查全部新增/已有自由丝印：PCB1 107 条、PCB2 76 条，默认字体、35mil 字高、3mil 线宽；与焊盘、过孔保留至少 6mil 检查间隙，避开 7mm 螺丝头区域。
- 元件库自带轮廓、固有文字及原有位号保持原样，U1 元件属性不改。

## PCB2 本次修复

1. 已移除残留泪滴，泪滴 DRC 报错不再出现。
2. 清理此前试加且造成 11 项间距错误的两处 GND 支路和 2 个过孔；其他 GND 走线保留。
3. 清理两条重复的 3.3V 短接线，保留原有配对电源焊盘的连接。
4. 沿 PMOD 插座右侧补通 V3P3_CORE，30mil 宽、45°转角；重新铺铜后所有网络通过原生连接与间距检查。
5. 调整 U3 编号式 IO 标签，避开 HS4 螺丝头；补齐串口屏、备用 IO、电机、电源、PMOD 弯针方向、EN/VM/1 脚和 M3 标记。

## PCB1 补充丝印

补充各接口用途、备用 IO、两路 12V、镜像 TMC 座的 1 EN / 16 VM、40Pin 的 1 脚与 XINGHUO 标记、H1～H4 M3。

丝印统一用默认字体，用途写成 ASCII 缩写（中文输入会被 EDA 自动改成黑体）。

| 丝印缩写 | 中文含义 |
|---|---|
| Z MOTOR / T MOTOR | 升降电机 / 旋转电机 |
| T HOME / TRAY HALL | 旋转原点霍尔 / 托盘霍尔 |
| CAR IR / HAND IR | 车辆红外 / 手部红外 |
| CAR IR TX / HAND IR TX | 车辆红外发射 / 手部红外发射 |
| Z HOME / Z MIN / Z MAX | 升降回零 / 下限 / 上限 |
| E-STOP | 急停监测 |
| FORK IN / FORK OUT | 拨叉收回 / 伸出 |
| L1 / L2 I2C、5V | 一层 / 二层 I²C、5V |
| SPARE IO / UART LCD | 备用 IO / 串口屏 |
| XINGHUO | 插星火，40Pin 位置不变 |

## 最终机械坐标

单位 mil，原始工程坐标，Y 向上。

| 板 | 位号 | X | Y | 层 / 角度 |
|---|---|---:|---:|---|
| PCB1 | U1 | 1265.9055 | 3770.1575 | 顶层 / 0°，未动 |
| PCB1 | CN3 | 583.7008 | 196.8504 | 保持原层和角度 |
| PCB1 | CN4 | 1174.2520 | 196.8504 | 保持原层和角度 |
| PCB1 | CN5 | 1764.8031 | 196.8504 | 保持原层和角度 |
| PCB1 | CN6 | 2355.3543 | 196.8504 | 保持原层和角度 |
| PCB1 | CN8 | 2995.9055 | 196.8504 | 保持原层和角度 |
| PCB1 | CN7 | 3346.4567 | 196.8504 | 未动 |
| PCB2 | U5 | 1815 | -1460 | 顶层 / 90°，未动 |
| PCB2 | U6 | 1815 | -560 | 顶层 / 90° |
| PCB2 | P1 | 150 | -1140 | 顶层 / 90° |

PCB2 U6 的 7 脚 (1765,-810)，U5 的 7 脚 (1765,-1710)，中心距精确为 900mil = 22.86mm。

| 板 | 孔 | X | Y |
|---|---|---:|---:|
| PCB1 | H1 | 3809 | 3790 |
| PCB1 | H2 | 3809 | 2000 |
| PCB1 | H3 | 3809 | 170 |
| PCB1 | H4 | 170 | 170 |
| PCB2 | HS1 | 157 | -157 |
| PCB2 | HS2 | 1600 | -150 |
| PCB2 | HS3 | 1600 | -1025 |
| PCB2 | HS4 | 170 | -1580 |

每板 4 个独立 3.2mm 非金属化孔；每个孔顶、底各有直径 7mm 圆形禁布区，禁止元件、导线、实心填充和铺铜。孔周禁布区内没有元件外框、导线或过孔侵入。

## 制造文件与核验

- PCB1_20261111_Gerber.zip、PCB2_20261111_Gerber.zip：EDA 官方原生制造导出，各含 15 个文件。已检查 ZIP 完整性、文件大小、SHA-256、顶底铜层、丝印、阻焊、圆角板框及独立 NPTH 钻孔文件。
- 每板 Drill_NPTH_Through.DRL 均为 TYPE=NON_PLATED、T01C3.20000，4 个孔坐标逐一匹配上表。
- 原生 Gerber 板框包含 4 段圆角圆弧；PCB1 约 100×100mm，PCB2 约 50×50mm。
- PCB1_20261111_坐标.csv、PCB2_20261111_坐标.csv：保留 EDA 原始字节，为 UTF-16 制表符分隔文件，单位 mm。
- PCB2_弯针装配BOM.md：U5/U6 实际采购必须使用 2×6、2.54mm、90°双排公针；原理图和原生坐标文件内仍是原库直针名称，应由此装配 BOM 覆盖，禁止直接采购旧直针 C9900002357。未虚构替换件的厂商料号。
- PCB1/PCB2_原生DRC.json、最终回读.json、最终截图.png、几何与样式核验.json、制造导出核验.json 为检查证据。

制造文件由嘉立创 EDA 官方制造导出功能生成，导出后直接核对了 Gerber 圆弧板框、钻孔和文件哈希；板框未作修改。

## 实物装配前仍需完成

- 按 1:1 打印，与星火实物核对主板 40Pin 和副板两个 PMOD 头；本轮未进行实体打印、插装或上电测试。
- 副板水平、元件朝上、90°弯针朝 +X。上电前万用表核对星火侧口 5/11=GND、6/12=3.3V。
- U1 排针从主板底部穿上来，在顶面焊接，不翻面。两块主板 TMC 座方向镜像，按新增 EN/VM/1 脚标记插装。
- 铜柱长度以 40Pin 插到底后的实测高度为准；估计两板间隙约 11mm，不能仅依估计采购固定长度。
- PCB2 文档层仍有原有的 23.000mm / 38.240mm 尺寸标注，本轮未改，不能代替当前焊盘坐标和 22.86mm 的 PMOD 实际中心距；它们不改变 Gerber 板框和钻孔。
- 主板覆盖星火按键、TF、电池和部分排针/端子，以及 XH 实际 2.50mm、部分传感器口第 4 脚空置等既有约束，这些既有约束仍然有效。
