eatoughaidan5v4418-spec/-/docs/转接板_模块插装_v3/02_红排针TMC2209排母接线.md

# 主板两组红排针TMC2209排母接线

日期：2026-11-08。依据本地《TMC2209步进电机驱动(我们使用红色排针).pdf》第2页标为“TMC2209 黄/红排针”的图片、第6页红排针细分表，并以原厂芯片资料核对MS1/MS2和CLK功能。不能使用第4页紫板的引脚顺序。

## 1. 排母画法与观察方向

每块模块使用两条独立1×8排母，两块驱动共四条。原理图每条排母各自编号1～8，不使用普通2×8符号的奇偶交错编号。本文件针号是载板排母的新定义，不是TMC2209裸芯片28针编号。

观察方向严格依照PDF第2页：**金色大焊盘的一面朝向观察者，EN/VM在上，DIR/GND在下**。这只是资料图的观察方向，不代表模块插入载板后的PCB顶视图。设计封装时按实物配对孔号核对，不能机械照搬图片左右。

```text
资料图左列，从上向下             资料图右列，从上向下
控制排母                        电源/绕组排母
1 EN                            1 VM
2 MS1                           2 GND
3 MS2                           3 M1B
4 PDN                           4 M1A
5 USART                         5 M2A
6 CLK                           6 M2B
7 STEP                          7 VIO
8 DIR                           8 GND
```

原理图可搜索“排母 1x8 / 单排8P母座”，通用符号只需8针。常见模块使用2.54mm针距，但本地资料未给尺寸图，针距、两列间距、孔径、模块正反面插入朝向及散热高度均须实物复核后绑定封装。

## 2. 控制排母逐针表

| 排母针号 | 模块标识 | 升降：J_Z_CTL | 旋转：J_T_CTL | 处理 |
| ---: | --- | --- | --- | --- |
| 1 | EN | PD10 | PE14 | 独立使能，低有效 |
| 2 | MS1 | V3P3_OUT | V3P3_OUT | 与MS2均高，目标1/16细分 |
| 3 | MS2 | V3P3_OUT | V3P3_OUT | 同上 |
| 4 | PDN | 不连接 | 不连接 | 本版不由载板控制配置，保留模块默认状态 |
| 5 | USART | 不连接 | 不连接 | 不启用UART，不占MCU串口或GPIO |
| 6 | CLK | GND | GND | 使用内部时钟 |
| 7 | STEP | PA8 | PA0 | 脉冲输入 |
| 8 | DIR | PA1 | PB14 | 方向输入 |

本版不用这两个控制接口。原理图中，两组控制排母第4、5脚不画导线、不贴网络名，可放未连接标记，表示“载板有意不使用”；这不代表模块内部引脚是物理NC。不占用屏幕串口PB10/PB11，也不在载板把两脚互相短接或硬接电源/地。此前的Z_PDN_RES/Z_UART_RES/T_PDN_RES/T_UART_RES保留网名不再需要。

本版只通过STEP/DIR发运动命令、EN控制使能，电流通过现成模块的调节方式设定，MS1/MS2确定硬件细分，不通过UART读写寄存器。PDN涉及静止降流配置，不能把“不连接主控”解释成“芯片内部无需确定电平”。商品资料没有板内原理图，模块出厂独立模式、内部默认电位及静止保持电流仍未实物验证；若模块需要焊桥设置，应在模块上按准确资料完成，不用其他厂商的脚位猜接。升降轴需带载核对保持电流和断电保持能力。

## 3. 电源与绕组排母逐针表

| 排母针号 | 模块标识 | 升降：J_Z_PWR | 旋转：J_T_PWR |
| ---: | --- | --- | --- |
| 1 | VM | VM_Z_SAFE | VM_T_SAFE |
| 2 | GND | GND | GND |
| 3 | M1B | Z_M1B | T_M1B |
| 4 | M1A | Z_M1A | T_M1A |
| 5 | M2A | Z_M2A | T_M2A |
| 6 | M2B | Z_M2B | T_M2B |
| 7 | VIO | V3P3_OUT | V3P3_OUT |
| 8 | GND | GND | GND |

VM来自外部相应轴的动力切断支路，不接V5_SYS或V3P3_OUT；两条GND都接地。VM_Z_SAFE和VM_T_SAFE不在载板互连。模块VIO使用星火3.3V逻辑支路。

## 4. 与电机4P口的对应

| 电机口针号 | 升降J_M101 | 连接J_Z_PWR针号 | 旋转J_M102 | 连接J_T_PWR针号 |
| ---: | --- | ---: | --- | ---: |
| 1 | Z_M1A | 4 | T_M1A | 4 |
| 2 | Z_M1B | 3 | T_M1B | 3 |
| 3 | Z_M2A | 5 | T_M2A | 5 |
| 4 | Z_M2B | 6 | T_M2B | 6 |

电机口1/2是一组线圈，3/4是另一组。这是当前载板定义，尚须核对现有电机线束针序。不要把排母绕组脚顺序简单按3、4、5、6原样接成电机口1、2、3、4后，又使用本表的网络定义。

## 5. 绘制完成后的检查

- 共四条1×8排母，两块模块各16针；两路控制网络按表分开。
- MS1/MS2均到V3P3_OUT、CLK到GND；PDN/USART在载板上有意不连接，模块默认独立模式及静止电流待实物验证。
- EN不能硬接GND；不新增外部上拉时，启动阶段误使能仍须验证。
- 两组绕组输出只接各自电机4P，不能接电源或地。
- 原理图本轮保持信号直连，驱动VM所需储能/去耦按主板绘制表单独完善。
- 画完排母后先核对模块朝向和保留脚，再继续电源和投板；未完成实板验证。

来源：[模块PDF](../../使用的硬件资料/TMC2209步进电机驱动(我们使用红色排针).pdf)第2/6/7页；[TMC2209原厂数据手册](https://www.analog.com/media/en/technical-documentation/data-sheets/tmc2209_datasheet_rev1.09.pdf)第9、14页。
