eatoughaidan5v4418-spec/-/docs/转接板_模块插装_v3/03_检测器件5V供电与输出定义.md

# 检测器件5V供电与输出定义

更新日期：2026-11-08。已确定数字霍尔、红外对射均使用5V版本。本文件取代此前“所有有源检测3.3V供电且直接接GPIO”的定义，配套主板和层板文档均须遵循。

## 1. 采购及常开/常闭选择

| 类别 | 数量 | 供电 | 采购/功能定义 |
| --- | ---: | --- | --- |
| 数字霍尔模块 | 两层整机17个；一层样机10个 | 5V | 非锁存开关型；优先常开检测定义，即无磁铁不动作、有磁铁动作。AO/DO四针模块只用DO，AO不接。若商品没有NO/NC选项，按DO在有磁/无磁下的实测状态配置软件，不能仅凭四针外形认定型号和电平 |
| 红外对射 | 2套，每套1发射头+1接收头 | 4.5～5V，按5V使用 | 选定商品XLHW5v-F3/F5类，**NPN常开型**，30cm距离档；车辆与手进入各1套 |
| 无源位置微动开关 | 逻辑检测5个，另有动力控制硬限位2个 | 无需供电 | COM+NC常闭触点；按下断开，GPIO内部上拉读取 |
| 急停按钮 | 1个 | 触点本身无需供电 | 两组独立常闭触点：停机控制与逻辑监测分别使用 |

有源传感器的“常开/常闭”表示开关输出在未检测状态的行为，不等于必然的GPIO高/低。NPN常开不应直接翻译成“有遮挡一定输出高”。商品图同时写“NPN常开”和“有遮挡输出5V”，其实际输出拓扑/极性尚未验证，软件以实测为准。使用非反相适配时保持极性，使用反相适配时软件相应翻转。

霍尔DO电平按实际模块供电及上拉判断。已核实主板PG3/PG6/PD8/PD9为STM32F407的FT数字输入，可在规定条件下直接接0～5V；3.3V供电的MCP23017无此通用5V容忍结论，层板仍需单独处理。

## 2. 电源分为5V传感器与3.3V逻辑两部分

- `V5_SYS`：直接使用星火开发板现有5V电源，经40Pin第2/4脚引出，给霍尔、红外及两层传感器供电。
- `V3P3_OUT`：保持星火主板逻辑、TMC VIO以及MCP23017的3.3V供电。
- `V3P3_CORE`：保持副板PMOD逻辑供电。
- `GND`：共地。
- 不把V5_SYS与V3P3_OUT或V3P3_CORE相连；不把传感器5V送入MCP模块VCC、RESET或地址脚。
- 取消此前新增的J_M210独立5V输入端子，不再保留此前V5_SENS这条独立电源网。直接采用V5_SYS标签连接；不能另从外部5V电源并接载板形成双源回灌。主控板上游电源、原板5V路径、40Pin触点和转接板走线的电流余量须核算，不能仅凭有5V针脚就认定任意负载可用。

## 3. 主板四路有源检测口：FT数字输入直连

| 位号 | 用途 | 1脚 | 2脚 | 3脚 |
| --- | --- | --- | --- | --- |
| J_M140 | 旋转原点霍尔 | V5_SYS | GND | PG3 |
| J_M141 | 转运台托盘霍尔 | V5_SYS | GND | PG6 |
| J_M142 | DOCK车辆红外接收头 | V5_SYS | GND | PD8 |
| J_M143 | DOCK手进入红外接收头 | V5_SYS | GND | PD9 |

本方案不额外加芯片。已按ST原厂资料核实四脚均为FT，可在主控正常供电、数字输入且内部上下拉关闭、信号在规定0～5V范围等条件下直接连接。取消此前方案的SN74LVC14A及四颗上拉、一颗去耦；用同名GPIO网直接连接，信号不再经过反相。

模块DO若为开漏/开集电极，必须有实际外部上拉；实物已有则不额外加，缺少时只补所需上拉电阻。参考LM393图不能代替实物板确认。接线条件、GPIO配置及资料出处见 [05_霍尔资料核对与主板FT直连](05_霍尔资料核对与主板FT直连.md)。这不等于MCP23017也能接5V；层板仍独立设计且不新增适配芯片。

## 4. 两个红外发射头另加2P供电口

| 位号 | 用途 | 1脚 | 2脚 |
| --- | --- | --- | --- |
| J_M144 | 车辆检测红外发射头 | V5_SYS | GND |
| J_M145 | 手进入检测红外发射头 | V5_SYS | GND |

发射头只有电源不接GPIO。接收头按商品红线正极、黑线负极、白线信号核对接线。30cm是检测距离档，不是线长；安装目标为两头间距约20～25cm以内，最终以安装位置和实测余量为准。单条光束只检测光路，不能覆盖整个手进入区域或视为安全光幕。

## 5. 层板保留4P通信口，另加2P传感器5V口

为沿用已确定的I²C接口，**不把原4P第1脚直接从3.3V改成5V**：

| 主板接口 | 所接层板 | 针序 |
| --- | --- | --- |
| J_M120，4P | 一层通信/逻辑供电口 | 1=V3P3_OUT，2=GND，3=PB7/SDA，4=PB6/SCL |
| J_M121，4P | 二层通信/逻辑供电口 | 同上 |
| J_M122，新增2P | 一层传感器5V输入口 | 1=V5_SYS，2=GND |
| J_M123，新增2P | 二层传感器5V输入口 | 1=V5_SYS，2=GND |

每层用一根4芯线加一根2芯线连接主板。层板的MCP23017仍供3.3V，因此模块自带I²C上拉仍拉到3.3V，SDA/SCL不用随传感器改成5V。

每个层板霍尔3P口为1=V5_SYS、2=GND、3=该路HALL_RAW5V。该路原始输出经适配后进入MCP相应输入；一层8路、二层7路，通用PCB预留8路适配。输出DO高低极性在软件处理；AO悬空。

## 6. 可选转台6P组合口同步修改

J_M160：1=V5_SYS、2=GND、3=PG4、4=PG5、5=PG6、6=不接。PG4/PG5仍是无源开关输入，不接5V；第5脚与J_M141.3并联，直接进入FT数字输入PG6，按05文档条件使用。

## 7. 数量变化与校验范围

- 主板新增4个2P带壳接口：2个红外发射供电口、2个层板5V供电口。
- 主板XH：2P×10、3P×4、4P×4、可选6P×1，共19个/54针；不装6P则18个/48针。
- 不增加传感器5V输入螺丝端子；原J_M210取消。原J_M200四位电机动力端子保留，电机仍由独立动力电源供电。
- 每层检测板新增一个2P的5V输入口；保留8个2P灯口、8个3P霍尔口、2个4P总线口，共19个接口预留。第二层第8组检测/指示可不装。
- 副板驱动与屏接口不因此次检测供电修改而变化；驱动VIO不改5V。
- 传感器总供电电流、每层线束压降、模块DO电路/极性、主板FT输入时序、层板电平处理以及实物插头针序尚未验证。此次是文档及网络定义更新，没有修改EDA工程。

参考：[TI DRV5033数字霍尔输出定义](https://www.ti.com/product/DRV5033)（说明开漏输出特征，非认定所购模块型号）；[Microchip MCP23017](https://www.microchip.com/en-us/product/mcp23017)；[TI SN74LVC125A输入容限说明](https://www.ti.com/product/SN74LVC125A)（作为适配选型依据，不代表已完成此器件电路）。红外型号、4.5～5V、NPN常开及商品标注遮挡5V依据用户截图，尚未取得板内原理图。
