eatoughaidan5v4418-spec/-/docs/转接板_模块插装_v3/05_霍尔资料核对与主板FT直连.md

# 霍尔资料核对与主板FT输入直连

日期：2026-11-08。本方案不额外增加适配芯片，取代此前的主板SN74LVC14A方案。仅变更主板四路数字检测输入，层板MCP23017不能套用STM32的FT特性。

## 1. 商品资料实际说明了什么

本地资料目录：`D:/QQ文件/YX55695-霍尔开关传感器模块-20190510/YX55695-霍尔开关传感器模块-20190510`。

- `HallSensorTest.ino`：示例将VCC接Arduino UNO的5V，DO接D5；说明有磁铁靠近时读LOW，无磁铁时读HIGH。示例针对5V的UNO，不是证明任意3.3V芯片都能直连。
- `技术手册及原理图/3144.pdf`：A3144为开集电极输出，工作电源4.5～24V。
- `技术手册及原理图/霍尔传感器ES3144中文数据手册.pdf`：ES3144为单极开关型，工作电源3.8～24V，输出开集电极。有磁铁时输出导通；磁铁极性和器件感应面影响触发。不能把本型号当作任意磁极都能触发的锁存/全极器件。
- `LM393模块系列/原理图/LM393.pdf`：是LC STUDIO的通用比较器模块参考电路，画有R3=10k上拉到VCC；不是带YX55695型号的专用成品原理图，不能保证实际板上每个电阻/LED接法都与此图相同。

结论：模块按5V供电，使用数字DO，不能凭“开集电极”或示意图“可直接接单片机”认定高电平一定只有3.3V。本主板采用FT数字输入接收其0～5V信号，不靠假定模块输出3.3V来省略芯片。

## 2. 直接接入的芯片依据

星火使用STM32F407ZGT6。本项目分配的PG3、PG6、PD8、PD9在ST数据手册DS8626 Rev12的Table 7中均标为 **FT，5V tolerant I/O**，数字输入条件下可接收额定5V信号；这不是STM32所有GPIO的通用特性。

必须满足：

1. MCU正常供电，VDD/VDDA处于规定范围；模块信号是共地0～5V数字信号，没有超出芯片限值的尖峰，不接12V传感器。
2. 四脚设为普通数字输入/EXTI，不设模拟模式，不配置为输出或冲突复用功能。
3. **关闭这四脚的内部上拉和下拉**，即GPIO_NOPULL。ST注明要承受高于VDD+0.3V的输入时需关闭内部上下拉。其余只接无源触点的GPIO仍可使用内部上拉，不混为一谈。
4. 开集电极/开漏输出靠模块已有的外部上拉定义高电平。实物若没有上拉，需另补一颗合适的外部上拉电阻，无须增加适配芯片；不能使用MCU内部上拉代替后又让节点到5V。
5. 不让传感器单独长期供5V而主控断电。两者从同一开发板取电也仍需核对启动/掉电时序和信号状态，不宣称具有断电5V容忍能力。

本地参考图R3=10k是已有上拉的证据线索，但不能代替测量实际模块。上电后先测有磁/无磁的DO高低电压，再接入主控；带电机运行的抗干扰仍待实测。

## 3. 主板四个3P接口最终网名

| 位号 | 用途 | 1脚 | 2脚 | 3脚 |
| --- | --- | --- | --- | --- |
| J_M140 | 旋转原点霍尔 | V5_SYS | GND | PG3 |
| J_M141 | 转运台托盘霍尔 | V5_SYS | GND | PG6 |
| J_M142 | DOCK车辆红外接收 | V5_SYS | GND | PD8 |
| J_M143 | DOCK手进入红外接收 | V5_SYS | GND | PD9 |

使用同名GPIO网络直接连接，不再分主板RAW5V和适配输出两段网。此前HALL_T_RAW5V→PG3、HALL_PLATTER_RAW5V→PG6、IR_CAR_RAW5V→PD8、IR_HAND_RAW5V→PD9的映射现在直接合并为右侧GPIO网名。

主板取消U_M401及原04方案的R_M401～R_M404、C_M401；原理图中不再放该适配器件。若实物确实缺上拉，再单独增加所需上拉，不把这四颗旧方案电阻当成已经确认必须安装。

可选6P组合口J_M160同步改为：1=V5_SYS、2=GND、3=PG4、4=PG5、5=PG6、6=不接。仅PG6为霍尔5V数字输出，PG4/PG5仍接无源开关，不接5V电源。红外发射头J_M144/J_M145继续各用2P：V5_SYS、GND。

## 4. 软件极性与层板边界

不经反相芯片后，GPIO读到的极性与模块DO相同。所给霍尔测试程序定义有磁=LOW，作为该模块初始软件配置，安装磁铁后实测确认。红外商品文案“NPN常开”和“遮挡时输出5V”存在歧义，单独实测其遮挡/无遮挡电压，不自动套用霍尔极性。

本次只完成主板输入方案选择。MCP23017仍按3.3V供电，**不能把其输入当作STM32的FT脚**。整机17个霍尔中，层板上的15路仍须单独设计合适电平处理；按不加额外芯片的约束，可核对输出上拉改到3.3V或使用分立电阻/三极管电路，需结合实际模块决定。不能一边取消芯片，一边把未知5V输出直接并到3.3V MCP。

## 5. 依据与未验证项

- [ST STM32F407ZG数据手册](https://www.st.com/resource/en/datasheet/stm32f407zg.pdf)：Table 7（第55/56页）列出四个引脚FT；Table 48脚注5（第117页）规定内部上下拉关闭条件。
- 上述资料目录：5V供电示例、DO极性、3144/ES3144输出类型与通用LM393图。
- 已核对针号、FT属性、数字输入配置约束及网络对应；未修改EDA工程，未测实际模块电压、供电时序或长线抗干扰，没有完成实板验证。
