eatoughaidan5v4418-spec/-/使用的硬件资料/商品页已核SKU/商品页已核规格说明.md

# 商品页已核规格（只放已点到你实买单的资料）

核对日期：2026-11-10。来源是淘宝已选中 SKU 的主图/选项图，以及该商品的技术文档。页面「参数信息」经常是整页通用、不随选项变化，下面凡是和图纸冲突的，都以已选中 SKU 图纸为准，不用那张参数表。

未放入本目录：启庞同步带、16 齿同步轮、20 齿惰轮（页面上还有互斥选项，订单里没有写死长度/普通或高品质/带齿或不带齿，按「只看你买的这款」没有擅自点开）；亿雅红外对射当时还没核完，这次先不放。已有的官方芯片手册（MCP23017、TMC2209 Rev 1.09、A3144、星火、串口屏原厂规格书）仍在上一层目录，没有覆盖。

## 优信 MCP23017 模块（item 952995643299）

商家技术文档 + 模块图。板子约 21×26 mm，焊盘为 3 排 10 针未焊排针。工作电压 1.8–5.5 V，I2C 默认可按 A0/A1/A2 配成 0x20–0x27。背面丝印左列自上而下：A2、A1、A0、RESET、NC/SO、NC/CS、SDA/SI、SCL/SCK、GND、VCC；右列：VCC/GND、ITB/ITA、B0/A0 … B7/A7。原理图里 SCL/SDA 有 10 kΩ 上拉，VCC 对地 1 µF。板子是 I2C/SPI 双丝印，你买的是 MCP23017，按 I2C 用。这是模块资料，上一层仍保留 Microchip 官方芯片手册。

## 优信 TMC2209 红排针（skuId 6009125086263）

商家文档同时写了 2208/2209/2225 等多款，只用其中标明「TMC2209-红排针」或「黄/红排针」共用的部分：默认电流 1.25 A，最大 2.5 A，逻辑 3.3 V/5 V，输入 5.5–28 V，最高 256 细分，STEP/DIR 和 UART。红排针细分表：M0/M1 接地为 8 细分，VCC/VCC 为 16，VCC/GND 为 32，GND/VCC 为 64。引脚：EN、MS1、MS2、PDN、USART、CLK、STEP、DIR 与 VM、GND、M1B、M1A、M2A、M2B、VIO、GND。红排针实物图上看不清采样电阻；黄排针/2208 图上的 R110 不能拿来用。不要用文档里「黄排针 TMC2209」那组 2 A / 5.5–38 V 的数。

## 优信 DC-DC 5V/3A（skuId 4634423556341，图注 AJ38）

芯片为 CN3903，电感 4.7 µH。输入 5–30 V（须高于输出），本单输出 5 V，最大 3 A。引脚 IN+/IN-、OUT+/OUT-，输入在芯片侧、输出在电感侧。图纸尺寸约 18×13 mm，商家表写 17.5×12×4.3 mm，页面注明手工测量以实物为准。图文详情同时包含 3.3 V 款，只用 5 V/3A 这一项。

## 优信 带柄 3 脚滚轮微动（skuId 4840196680776）

本体丝印 1A 125V AC，脚为 C / NO / NC。尺寸图：滚轮 Ø5，含轮总高 15.68 mm，壳体宽 5.8 mm，安装孔 Ø2.1，脚距 5.09 mm。不要用无柄或「带柄无滚轮」（有的标 2A）的图。商家 PDF 里型号只写「鼠标开关」，没有 KW 编号。

## 优信 霍尔 3144 模块（item 522555471913）

这是蓝板模块（LM393 + TO-92 霍尔），不是裸芯片。商家附了 ES3144 手册，管身字标按 3144 系列，不能据此认定是 Allegro 原装；上一层 Allegro 官方手册仍作芯片族参考。

## 步联 42BL40 配 1 米线 0.44 N·m（skuId 5942512971982）

已选中 SKU 图纸型号 **42BL4002-24A**（17HS4401S）。机身 40 mm MAX，出轴 24±0.5 mm，轴上另一段 18±0.2 mm，轴径 Ø5，静力矩 0.44 N·m，图纸电流 1.5 A，电阻 2.0 Ω，1 米线 XH2.54。线序：红 A+、蓝 A-、绿 B+、黑 B-；端子 1=A+、3=B+、4=A-、6=B-（2、5 空）。页面参数表写 12 V / 1 A / 0.4 N·m / 光电编码器，和这张图纸冲突，不要用。上一层已有一份步联《42BL4002-24A》规格书，那里额定是 3.4 V / 1.7 A，和这张 SKU 图的 1.5 A 不完全一致，设电流时两份都看一下，优先以实物铭牌为准。

## 步联 42BL40-67MM 出轴（skuId 6125717247161）

图纸型号 **42BL4002-67A**（也标 17HS4401S）。机身仍是 40 mm MAX，「67 mm」是出轴 67±0.5 mm，不是加长机身。电流、力矩、电阻、线序与短轴款图纸相同。不能拿短轴那份 24A 规格书当这一款用。

## 步联 28 电机 31 mm 机身带磁柱（skuId 6116821973304）

图纸型号 **28BL3102-15YPro 带磁柱**。机身 31 mm MAX，机座 28 mm，出轴 15±0.5 mm，轴径 Ø5，相电压 2.1 V，额定电流 1 A，相电阻 2.1 Ω，相电感 1.7 mH，保持转矩 80 mN·m，重量 107 g，后部磁柱外径约 Ø8。上一层 `步进电机规格书` 里的《28BL262.6-18Y》**不是这一款**，不要用来设电流或对尺寸。

## 上航梅花联轴器 外径 20 长度 25（skuId 5891080745077）

已选中选项写「外径20长度25孔5至8都有」，图上要求下单备注两端孔径 d1、d2（5–8 mm，两端可以不同）。页面和图上都没有写这单实际发了多少孔径，这里不能假定。

## 没有放入的

- 启庞 GT2-6 mm 橡胶同步带：页面有 1 米/2 米/5 米卷、连续不剪断、加防滑布等多种互斥选项，订单没写死长度，未选、未放。
- 启庞 16 齿同步轮高 14 孔 5：还有「普通版 / 高品质」两种，未选、未放。
- 启庞 20 齿惰轮内孔 5 带宽 6：还有带齿/不带齿、黑色、实惠款，未选、未放。
- 亿雅红外对射：这次核页还没完成，先不放。
