eatoughaidan5v4418-spec/-/使用的硬件资料/商品页未选定或无单独图纸/说明.md

# 商品页未选定或无单独图纸

这些是已核包里没放进去的剩余资料，请勿当成已确认的“这一款”专属图纸。
已核文件仍在：`E:\Proj\单片机比赛\使用的硬件资料\商品页已核SKU`

## 启庞 GT2-6mm 橡胶同步带（长度未选定）

商品页：https://item.taobao.com/item.htm?id=527745858306

只保存了未选定长度时的选项页。橡胶 6mm 可见选项包括：加防滑布款、连续不剪断、1米/卷、2米/卷、5米/卷、10米/卷、50米/卷。页面参数表是整页通用（也覆盖 PU 钢丝和 10mm），表里的拉力 180N 不能当作已买长度的参数。

## 启庞 16齿同步轮 高14 孔5 带宽6（普通版 / 高品质未选定）

商品页：https://item.taobao.com/item.htm?id=528687341718

两个选项都对得上 16齿 / 高14 / 内孔5mm：普通版、高品质。当时没有选定哪一款，所以只保存了选项页，没有这一款的专属图纸。

## 启庞 20齿惰轮 内孔5 带宽6（带齿 / 颜色未选定）

商品页：https://item.taobao.com/item.htm?id=528334274858

对得上的选项有：20齿内孔5带齿(带宽6)、不带齿、黑色不带齿、黑色带齿、不带齿实惠款。当时没有选定，只保存了选项页。

## 上航梅花联轴器 D20×L25（实发孔径未知）

已选 SKU 图已在 `商品页已核SKU\梅花联轴器_D20xL25`。这里补的是页面「参数信息」，属于整店通用，不是 D20×L25 专属。下单需备注两端孔径 d1-d2，5–8 mm 范围内可选，实发孔径未知。

## 亿雅红外对射 F5-30cm常开-带端子（已选 SKU，但无单独图纸）

商品页：https://item.taobao.com/item.htm?id=615026176214&skuId=4730286237886

已确认选中 F5-30cm常开-带端子。页面参数只有品牌 YIYA，没有电压、尺寸、脚位表，也没有技术文档。图库是 F3/F5、多种距离混用，不能当作这一款的专属尺寸、电压或脚位。
