eatoughaidan5v4418-spec/-/使用的硬件资料/星火1号开发板/星火1号开发板_官方介绍.md

# Spark-1 星火 1 号开发板

“星火一号” 一款专为工程师和高校学生设计的嵌入式 RTOS 开发学习板。在这个科技飞速发展的时代，嵌入式系统已经成为了现代工业、交通、通信等众多领域的核心驱动力。而 RTOS 实时操作系统作为嵌入式领域的基石，更是工程师们必须熟练掌握的核心技术。作为业界主流的 RTOS 实时操作系统 RT-Thread，我们有义务帮助更多开发者掌握这项技术。为此，我们精心打造了一款专为工程师和高校学生设计的嵌入式开发学习板。

星火一号主控选用了目前行业中比较常用且学习门槛较低的 STM32F407，性能强劲、功能丰富，完全能够满足嵌入式入门的需求。此开发板不仅具有众多的板载资源（Flash 存储、WIFI 通信、多个传感器），还支持丰富的扩展接口，让您轻松实现各种复杂的应用场景。通过使用这款开发学习板，您将能够深入了解 RTOS/RT-Thread 的工作原理，提升自己的技能水平，为当前以及未来的职业生涯做好充分准备。

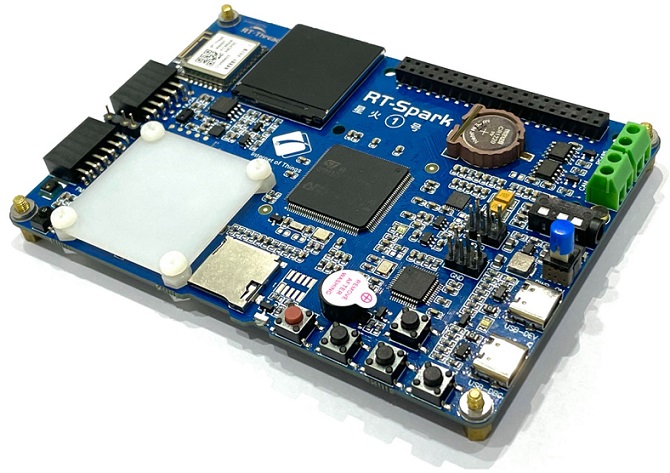
[picture p4: 使用的硬件资料/星火1号开发板/figures/spark-1.jpg]


* RT-Spark 开源网站：https://rt-thread-board.gitee.io/stm32f407-spark

资料链接：

- 百度网盘：https://pan.baidu.com/s/10Toony2CCGN82_hoX5y5PA?pwd=xh1h 提取码：xh1h

- SDK github：[https://github.com/RT-Thread-Studio/sdk-bsp-stm32f407-spark](https://github.com/RT-Thread-Studio/sdk-bsp-stm32f407-spark)

- SDK gitee：[https://gitee.com/RT-Thread-Studio-Mirror/sdk-bsp-stm32f407-spark](https://gitee.com/RT-Thread-Studio-Mirror/sdk-bsp-stm32f407-spark)

- 开发板购买链接：[购买链接](https://item.taobao.com/item.htm?id=726084912488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)（请复制至 X 宝打开)

- <a href="./rt-thread-version/rt-thread-standard/hw-board/spark-1/bom.html" target="_blank">星火 1 号学习板点位 BOM</a>

- <a href="./rt-thread-version/rt-thread-standard/hw-board/spark-1/SCH_Spark-1_V1_0.pdf" target="_blank">星火 1 号开发板原理图</a>

- [开发板快速上手视频](https://www.bilibili.com/video/BV1su411h71G)

- 开发板例程兼容《嵌入式实时操作系统：RT-Thread 设计与实现》（[JD 购买链接](https://item.m.jd.com/product/12552882.html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)），可以参考学习

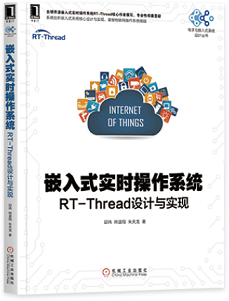
[picture p5: 使用的硬件资料/星火1号开发板/figures/book.png]
BOOK
    

## 开发板资源

板载资源：

- 复位按键、轻触按键 X4、自锁开关
- 蜂鸣器
- LR1220 RTC 后备电池座
- ST-Link
- USB-FS
- 麦克风、4 极耳机
- SD 卡座
- 8MB NorFlash
- 红外发射、红外接收
- ICM20608 六轴传感器、AP3216 接近传感器、AHT20 温湿度传感器
- RW007 WIFI
- 240x240 并行 LCD 支持背光调节
- 19 灯等距全彩 LED
- 全彩 LED 外接
- 3.3V 电源扩展、5V 电源扩展

扩展接口：

- RS485 接口
- CAN 接口
- 40Pin 树莓派标准扩展无冲撞 IO
- Spark-10Pin 创意堆叠平台
- PMOD 接口 x2

支持的 IDE：RT-Thread Studio、MDK。

## 使用

### 在 RT-Thread Studio 上使用

在 Studio 中的 SDK 管理界面下载本开发板的 SDK，基于该 SDK 创建相应的工程进行学习开发 ([点击此处查看 在 RT-Thread Studio 上快速上手 “星火一号” 视频](https://www.bilibili.com/video/BV1su411h71G))。

1. 在包管理界面下载资源包：

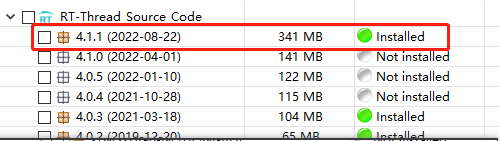
[picture p6: 使用的硬件资料/星火1号开发板/figures/sdk-studio-rtt.png]


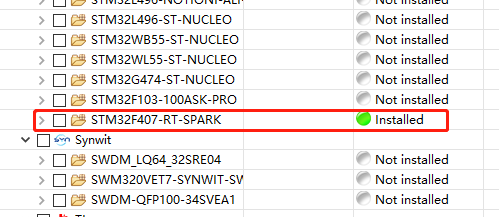
[picture p7: 使用的硬件资料/星火1号开发板/figures/sdk-studio.png]


2. 新建工程（新建工程可以基于模板工程，也可以基于示例工程），之后编译

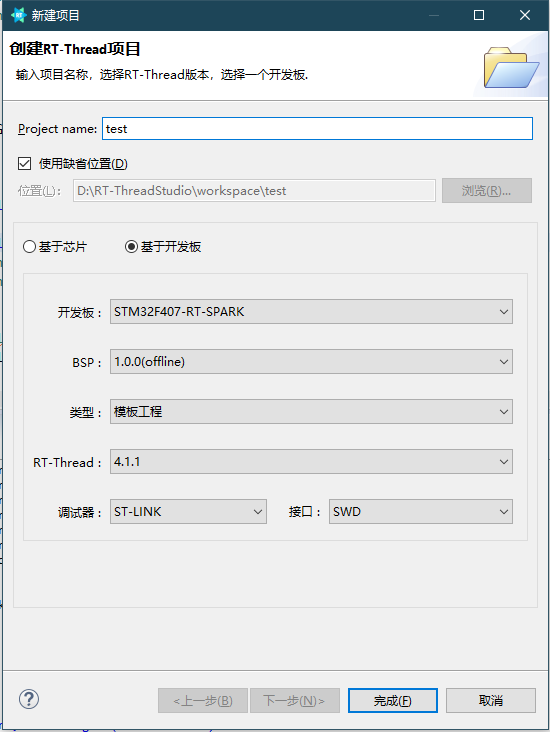
[picture p8: 使用的硬件资料/星火1号开发板/figures/create-proj.png]


### 在 MDK 上使用

1. [下载 SDK](https://github.com/RT-Thread-Studio/sdk-bsp-stm32f407-spark)，在工程下双击 mklinks.bat，生成 libraries 和 rt-thread 文件夹的链接：

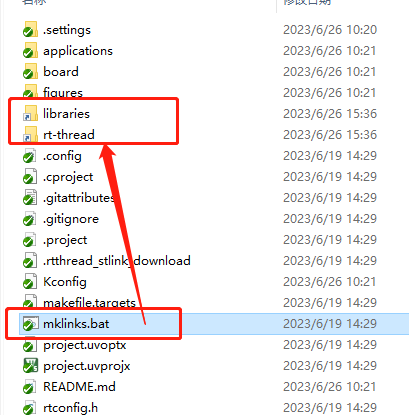
[picture p9: 使用的硬件资料/星火1号开发板/figures/mklink.png]


2. 打开 Env，使用 scons --target=mdk5 重新生成 mdk5 工程，之后则可双击打开 mdk5  工程。
