eatoughaidan5v4418-spec/-/docs/cad/图纸_v7_加厚夹带/README.md

# v7 板件与安装试配图

对应 [v7 三维装配与检查](../三维装配_v7_加厚夹带/README.md)，单位 mm。图中红色候选孔、尺寸和紧固方式须先与实物核对，所有文件均为试配稿。

| 图号 | DWG / DXF | 用途 |
|---|---|---|
| P01N | [DWG](./P01N_托盘板_新销位.dwg) / [DXF](./P01N_托盘板_新销位.dxf) | 125×60×3；定位销中心距内端 7，停放内端 r100。 |
| P02S | [DWG](./P02S_底板_短轴支架安装.dwg) / [DXF](./P02S_底板_短轴支架安装.dxf) | 短轴升降电机支架与底板孔位。 |
| P03E | [DWG](./P03E_转运板_支撑条安装.dwg) / [DXF](./P03E_转运板_支撑条安装.dxf) | 183×96×3；更新电机轮、惰轮和安装耳，不能与 v6 P03D 混用。 |
| P04 | [DWG](./P04_顶板_轴承座安装.dwg) / [DXF](./P04_顶板_轴承座安装.dxf) | 5 mm 顶板和轴承座安装孔。 |
| P05R | [DWG](./P05R_一层甲板_四角避让.dwg) / [DXF](./P05R_一层甲板_四角避让.dxf) | 一层甲板：井口 R102、销槽和四角避让。 |
| P06R | [DWG](./P06R_二层甲板_四角避让.dwg) / [DXF](./P06R_二层甲板_四角避让.dxf) | 二层甲板：井口 R102 和 DOCK 缺口。 |
| P07R | [DWG](./P07R_升降中心盘.dwg) / [DXF](./P07R_升降中心盘.dxf) | 升降中心盘及电机安装孔。 |
| A01 | [DWG](./A01_顶部双向止推安装_试配.dwg) / [DXF](./A01_顶部双向止推安装_试配.dxf) | 丝杆顶部止推轴承与薄螺母叠层。 |
| A02 | [DWG](./A02_开口皮带压夹_试配.dwg) / [DXF](./A02_开口皮带压夹_试配.dxf) | 加厚夹座与双螺钉压片截面；带端弯曲和夹持强度待实测。 |
| A03 | [DWG](./A03_上下限位座_试配.dwg) / [DXF](./A03_上下限位座_试配.dxf) | 升降导杆上下可调限位座。 |
| A04 | [DWG](./A04_托盘支撑条_试配.dwg) / [DXF](./A04_托盘支撑条_试配.dxf) | 两根支撑条与候选孔；负侧长 138.5，正侧长 145。 |
| A05 | [DWG](./A05_拨叉两端限位座_试配.dwg) / [DXF](./A05_拨叉两端限位座_试配.dxf) | 拨叉两端开关座与止挡示意。 |

夹座、P01N、P03E、P05R、P06R 和 A04 已同步修改。井口加大后托盘内端的支承、实际带轮轮缘及皮带夹紧仍须实测；材料、公差、夹持强度及停止距离尚未确定。
