eatoughaidan5v4418-spec/-/docs/串口屏界面_v1/控件坐标.md

# 控件坐标

由 `tools/export_hmi_assets.py` 从原型量出，单位像素，格式 x, y, 宽, 高。不要手改，改原型后重新运行脚本。

图片和按钮控件必须按表里的矩形放，尺寸和对应图片一致。文本和数字控件表里给的是原型里文字的实际范围，控件可以做得更宽，左上角对齐即可。

| 页面 | 控件 | x | y | 宽 | 高 |
|---|---|---|---|----|----|
| main | b0 | 191 | 113 | 64 | 46 |
| main | b1 | 159 | 36 | 77 | 77 |
| main | b2 | 113 | 17 | 46 | 64 |
| main | b3 | 36 | 36 | 77 | 77 |
| main | b4 | 17 | 113 | 64 | 46 |
| main | b5 | 36 | 159 | 77 | 77 |
| main | b6 | 113 | 191 | 46 | 74 |
| main | b7 | 159 | 159 | 77 | 77 |
| main | hub | 98 | 98 | 76 | 76 |
| main | pPanel | 273 | 33 | 207 | 239 |
| main | tClk | 431 | 2 | 37 | 27 |
| main | nFree | 285 | 98 | 48 | 60 |
| main | tTot | 332 | 129 | 36 | 22 |
| main | jOcc | 285 | 169 | 183 | 6 |
| main | tab1 | 285 | 40 | 91 | 30 |
| main | tab2 | 376 | 40 | 92 | 30 |
| main | bStore | 281 | 180 | 191 | 56 |
| main | tSel | 285 | 103 | 183 | 47 |
| main | bGet | 281 | 202 | 191 | 62 |
| main | pTray | 285 | 110 | 183 | 23 |
| main | pHand | 285 | 141 | 183 | 23 |
| main | bOk | 281 | 164 | 191 | 58 |
| main | bCancel | 281 | 222 | 191 | 44 |
| main | bTaken | 281 | 202 | 191 | 62 |
| main | tJob | 285 | 42 | 183 | 24 |
| main | tStep | 285 | 72 | 183 | 56 |
| main | tIdx | 441 | 128 | 27 | 26 |
| main | jStep | 285 | 159 | 183 | 7 |
| main | nEta | 347 | 179 | 38 | 41 |
| fault | tClk | 427 | 12 | 37 | 26 |
| fault | tCode | 16 | 38 | 105 | 88 |
| fault | tTitle | 180 | 48 | 286 | 30 |
| fault | tDesc | 180 | 84 | 286 | 44 |
| fault | c0 | 16 | 164 | 220 | 44 |
| fault | c1 | 244 | 164 | 220 | 44 |
| fault | bHome | 12 | 214 | 456 | 50 |
| pwd | d0 | 22 | 152 | 38 | 46 |
| pwd | d1 | 72 | 152 | 38 | 46 |
| pwd | d2 | 122 | 152 | 38 | 46 |
| pwd | d3 | 172 | 152 | 38 | 46 |

| 图片编号 | 文件 | 宽 | 高 |
|---|---|----|----|
| 0 | 00_bg_main.png | 480 | 272 |
| 1 | 01_bg_fault.png | 480 | 272 |
| 2 | 02_bg_estop.png | 480 | 272 |
| 3 | 03_panel_home.png | 207 | 239 |
| 4 | 04_panel_sel.png | 207 | 239 |
| 5 | 05_panel_dock_put.png | 207 | 239 |
| 6 | 06_panel_dock_take.png | 207 | 239 |
| 7 | 07_panel_prog.png | 207 | 239 |
| 8 | 08_bay_E_empty.png | 64 | 46 |
| 9 | 09_bay_E_tray.png | 64 | 46 |
| 10 | 10_bay_E_car.png | 64 | 46 |
| 11 | 11_bay_E_sel.png | 64 | 46 |
| 12 | 12_bay_E_target.png | 64 | 46 |
| 13 | 13_bay_NE_empty.png | 77 | 77 |
| 14 | 14_bay_NE_tray.png | 77 | 77 |
| 15 | 15_bay_NE_car.png | 77 | 77 |
| 16 | 16_bay_NE_sel.png | 77 | 77 |
| 17 | 17_bay_NE_target.png | 77 | 77 |
| 18 | 18_bay_N_empty.png | 46 | 64 |
| 19 | 19_bay_N_tray.png | 46 | 64 |
| 20 | 20_bay_N_car.png | 46 | 64 |
| 21 | 21_bay_N_sel.png | 46 | 64 |
| 22 | 22_bay_N_target.png | 46 | 64 |
| 23 | 23_bay_NW_empty.png | 77 | 77 |
| 24 | 24_bay_NW_tray.png | 77 | 77 |
| 25 | 25_bay_NW_car.png | 77 | 77 |
| 26 | 26_bay_NW_sel.png | 77 | 77 |
| 27 | 27_bay_NW_target.png | 77 | 77 |
| 28 | 28_bay_W_empty.png | 64 | 46 |
| 29 | 29_bay_W_tray.png | 64 | 46 |
| 30 | 30_bay_W_car.png | 64 | 46 |
| 31 | 31_bay_W_sel.png | 64 | 46 |
| 32 | 32_bay_W_target.png | 64 | 46 |
| 33 | 33_bay_SW_empty.png | 77 | 77 |
| 34 | 34_bay_SW_tray.png | 77 | 77 |
| 35 | 35_bay_SW_car.png | 77 | 77 |
| 36 | 36_bay_SW_sel.png | 77 | 77 |
| 37 | 37_bay_SW_target.png | 77 | 77 |
| 38 | 38_bay_S_dock_empty.png | 46 | 74 |
| 39 | 39_bay_S_dock_tray.png | 46 | 74 |
| 40 | 40_bay_S_dock_active.png | 46 | 74 |
| 41 | 41_bay_S_shaft.png | 46 | 74 |
| 42 | 42_bay_S_dock_target.png | 46 | 74 |
| 43 | 43_bay_SE_empty.png | 77 | 77 |
| 44 | 44_bay_SE_tray.png | 77 | 77 |
| 45 | 45_bay_SE_car.png | 77 | 77 |
| 46 | 46_bay_SE_sel.png | 77 | 77 |
| 47 | 47_bay_SE_target.png | 77 | 77 |
| 48 | 48_hub_E.png | 76 | 76 |
| 49 | 49_hub_NE.png | 76 | 76 |
| 50 | 50_hub_N.png | 76 | 76 |
| 51 | 51_hub_NW.png | 76 | 76 |
| 52 | 52_hub_W.png | 76 | 76 |
| 53 | 53_hub_SW.png | 76 | 76 |
| 54 | 54_hub_S.png | 76 | 76 |
| 55 | 55_hub_SE.png | 76 | 76 |
| 56 | 56_hub_none.png | 76 | 76 |
| 57 | 57_tab1_on.png | 91 | 30 |
| 58 | 58_tab1_off.png | 91 | 30 |
| 59 | 59_tab2_on.png | 92 | 30 |
| 60 | 60_tab2_off.png | 92 | 30 |
| 61 | 61_btn_store.png | 191 | 56 |
| 62 | 62_btn_store_down.png | 191 | 56 |
| 63 | 63_btn_store_off.png | 191 | 56 |
| 64 | 64_btn_get.png | 191 | 62 |
| 65 | 65_btn_get_down.png | 191 | 62 |
| 66 | 66_btn_ok.png | 191 | 58 |
| 67 | 67_btn_ok_down.png | 191 | 58 |
| 68 | 68_btn_ok_off.png | 191 | 58 |
| 69 | 69_btn_cancel.png | 191 | 44 |
| 70 | 70_btn_cancel_down.png | 191 | 44 |
| 71 | 71_btn_taken.png | 191 | 62 |
| 72 | 72_btn_taken_down.png | 191 | 62 |
| 73 | 73_btn_taken_off.png | 191 | 62 |
| 74 | 74_row_tray_ok.png | 183 | 23 |
| 75 | 75_row_tray_wait.png | 183 | 23 |
| 76 | 76_row_hand_clear.png | 183 | 23 |
| 77 | 77_row_hand_block.png | 183 | 23 |
| 78 | 78_chk0_off.png | 220 | 44 |
| 79 | 79_chk0_on.png | 220 | 44 |
| 80 | 80_chk1_off.png | 220 | 44 |
| 81 | 81_chk1_on.png | 220 | 44 |
| 82 | 82_btn_home_off.png | 456 | 50 |
| 83 | 83_btn_home.png | 456 | 50 |
| 84 | 84_btn_home_down.png | 456 | 50 |
| 85 | 85_occ14_empty.png | 183 | 6 |
| 86 | 86_occ14_full.png | 183 | 6 |
| 87 | 87_occ7_empty.png | 183 | 6 |
| 88 | 88_occ7_full.png | 183 | 6 |
| 89 | 89_bar_empty.png | 183 | 7 |
| 90 | 90_bar_full.png | 183 | 7 |
| 91 | 91_pin_empty.png | 38 | 46 |
| 92 | 92_pin_full.png | 38 | 46 |
