eatoughaidan5v4418-spec/-/使用的硬件资料/TJC4827T143_011C串口屏/型号与资料说明.md

# TJC4827T143_011C 型号与资料说明

整理日期：2026-11-05。

## 已知型号

- 项目记录的屏幕型号为 TJC4827T143；使用者已确认后缀为 **011C（电容触摸）**。
- 完整型号中 011C 之后是否还有 `_I_P20`、`_I_F` 等后缀，尚未依据屏幕实物确认。供电、接插件和尺寸应按实物完整型号核对。

例如，以下是第三方元器件目录列出的两个不同版本，仅供找到对应规格时参考：

| 示例型号 | 目录列出的接口 | 目录列出的供电范围 |
| --- | --- | --- |
| `TJC4827T143_011C_I_P20` | XH2.54 四针 | 4.65–6.5 V |
| `TJC4827T143_011C_I_F` | FPC 1.0 十四针 | 3.2–3.4 V |

第三方目录：[P20 版本](https://5678zy.com/parameter/32322.html)；[F 版本](https://5678zy.com/parameter/32325.html)。接线和上电前，须确认屏上标签、接口和对应的原厂规格书，不能仅凭 `011C` 假定供电电压。

## 本地通用开发手册

[淘晶驰串口屏开发手册离线版](淘晶驰串口屏资料中心_离线版_斑梨电子提供.pdf) 由 [斑梨电子的型号教程页面](https://spotpear.cn/index/study/detail/id/1248.html) 提供，PDF 元数据标示生成日期为 2023-10-30。主要阅读入口按文档印刷页码：

- 快速入门、上位机：第 1 章，印刷页 27 起。
- 串口屏与单片机通信：第 2 章；通信协议从印刷页 202 起。
- 常用指令集：第 4 章，印刷页 452 起。

该 PDF 为通用开发手册，不是此屏幕的专用硬件规格书；实际软件和固件版本也可能与手册不同。

## 官方在线入口和本次未下载的资料

- [淘晶驰资料中心](http://wiki.tjc1688.com/index.html)。
- [P20 版本产品页面](http://wiki.tjc1688.com/product/new_datasheet/T1/TJC4827T143_011C_I_P20.html)。
- [P20 版本原厂规格书 PDF](http://filedown.tjc1688.com/tjcwiki/new_datasheet/T1/TJC4827T143_011C_I_P20.pdf)。
- [TJC4827T143 出厂工程](http://filedown.tjc1688.com/tjcwiki/factory_project/T1/TJC4827T143.HMI)。
- [USART HMI 上位机下载](http://filedown.tjc1688.com/USARTHMI/USARTHMIsetup_latest.zip)。

整理时淘晶驰原站及下载域名连接失败，因此上述原厂规格书、出厂工程和上位机仅保留链接，**没有作为本地文件下载**。待网络可访问后，先确认实物完整型号，再获取对应版本的规格书。
