eatoughaidan5v4418-spec/-/使用的硬件资料/商品页已核SKU/DC-DC_5V3A/优信DC-DC_商家图文详情_含3.3V和5V.pdf

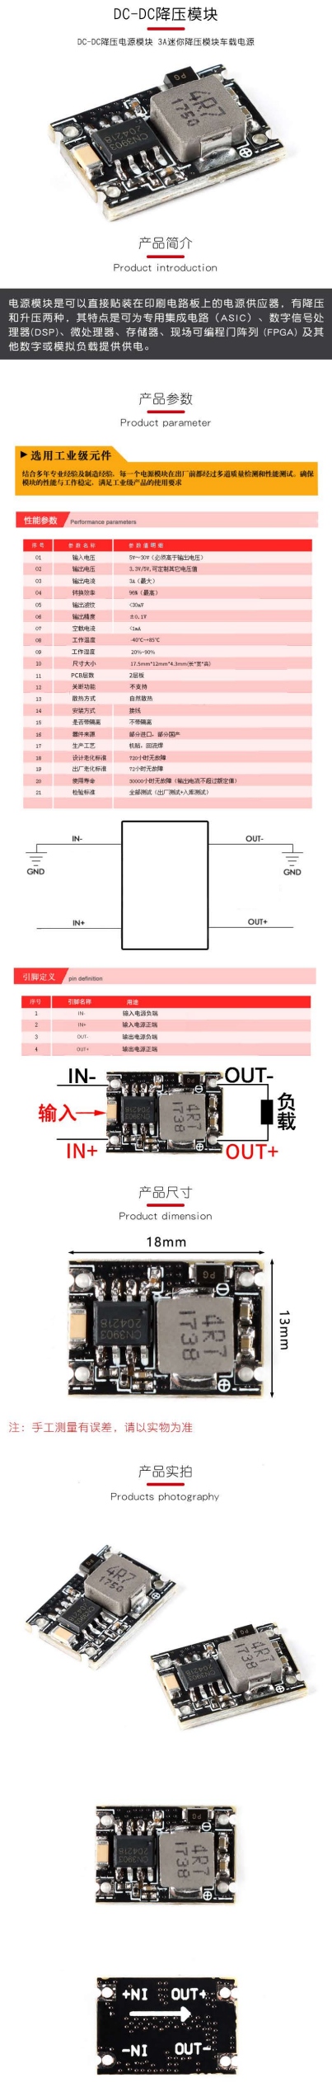
[picture p10: page 1]
