eatoughaidan5v4418-spec/-/使用的硬件资料/商品页已核SKU/MCP23017模块/优信MCP23017模块_商家技术文档.pdf

产品描述

MCP23017 能够将 1 6 位并行数据转换为 IIC 接口的串行数据并可相互转化。内部集成上电复 位(POR)电路，复位到器件的默认状态。两个对立的可编程中断源输出。极性翻转寄存器可 配置 GPIO 输入极性。

产品参数

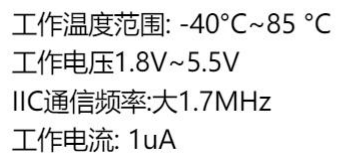
[picture p11: figure]

引脚说明

VCC:供电引脚;
INTA: A 端口中断输出;
INTB: B 端口中断输出;

## SCL: IIC 时钟信号线 SDA: IIC 数据信号线 RESET:电平复位器件

A0、A1、A2:IIC 器件地址配置引脚，默认 0100000x，IIC 总线可扩展 8 个相同器 件
GPA0~GPA7: A 端口 8 位输入输出引脚(默认输入模式)
GPBO~GPB7: B 端口 8 位输入输出引脚(默认输入模式)

原理图

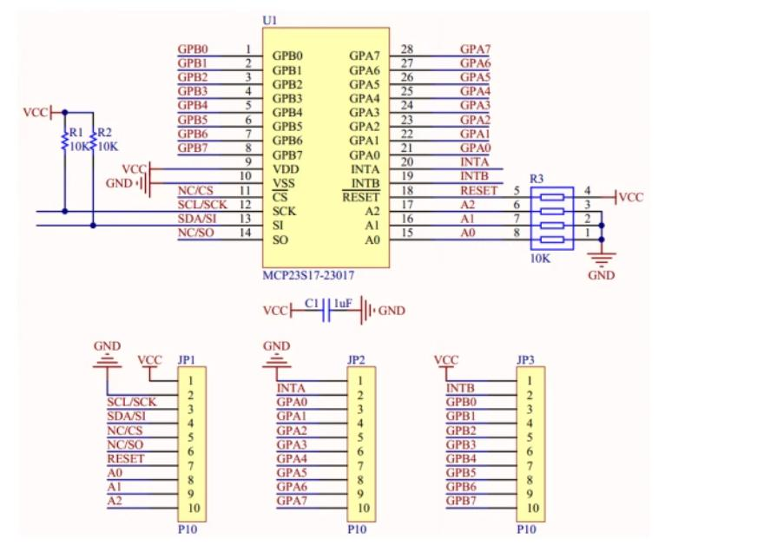
[picture p12: figure]
