eatoughaidan5v4418-spec/-/使用的硬件资料/商品页已核SKU/微动开关_带柄3脚滚轮/微动开关_商家图文详情_含其他款.pdf

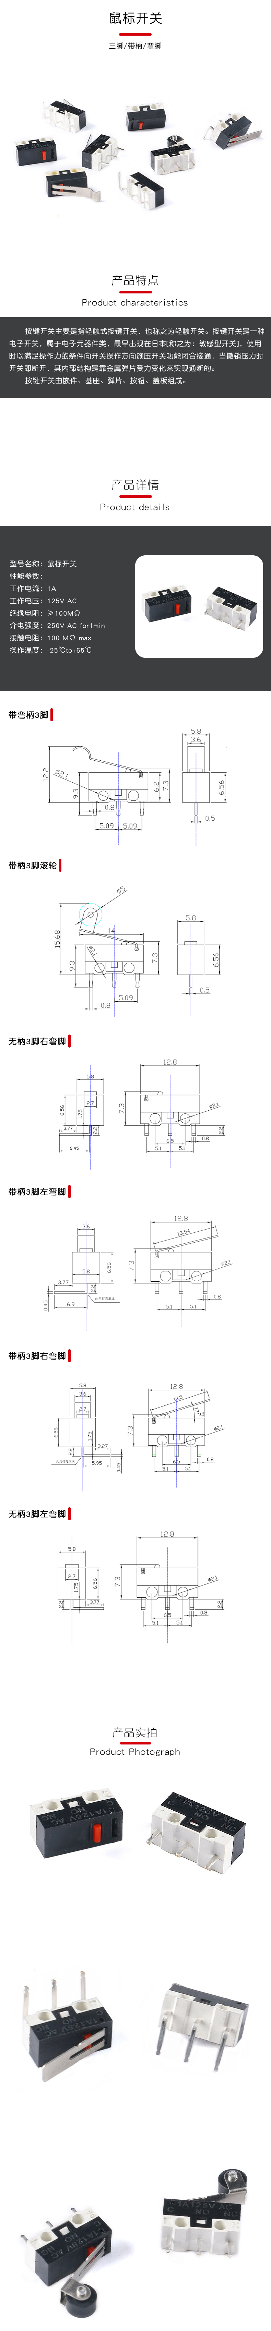
[picture p13: page 1]
