eatoughaidan5v4418-spec/-/docs/硬件方案_v2.md

# 双层 2×2 车库硬件方案 v2（设计草案）

日期：2026-11-04。基于仓库 `99415dc` 修订。优先保留两层、每层 2×2 且最多停 3 辆，共 6 辆；用户只在下方 DOCK 放车、取车。星火一号 / STM32F407、RT-Thread 标准版及 TJC 串口屏保留。

> 状态：这是用于评审、建模和制作一层验证件的方案，不是已经验证的加工图或量产电路图。尚未完成实物、完整三维干涉检查、力矩/温升、抱闸或动态负载试验。尺寸为目标尺寸，电机、传感器实物到货前不要冻结孔位。采购和验证见 [采购清单 v3](采购清单_v3.md)、[验证与实施](硬件验证与实施_v2.md)。

## 1. 与旧方案的取舍

| 项目 | v2 |
|---|---|
| 停车目标 | 两层；每层 4 格、3 个可载车托盘、至少 1 个无托盘空格。满载共 6 辆。 |
| 原 140×80 mm 托盘和 105×43×30 mm 车模 | 保留尺寸；托盘结构改为平底、上表面双定位孔。设计单个托盘和车合计不超过 0.4 kg，车固定于托盘内。 |
| 升降 | 移至 2×2 停车阵列右侧，避开两层已停车位及载车包络；共用一台。 |
| 层内移盘 | 每层一套位于车辆上方的 X/Y 平面搬运器和抓取头；托盘不带电机、线缆或电池。 |
| 用户入口 | 升降台到下方 DOCK 后，在机器右侧放/取车。DOCK 是升降台的一个高度，不是第三个停车层。 |
| 外轮廓 | 估计约 550×300×670 mm，含主体、侧置升降、必要余量；需按实物复核与加固防倾覆。放弃旧稿“外轮廓等于停车区、不外挂通道”的表述。 |
| 3×3 | 不再宣称机械已经预留，可另做扩展研究。 |

## 2. 坐标和基本尺寸

单位 mm；从停车层左前角开始，X 向右、Y 向后，Z 从底座上表面向上。固定停车层工作面为 `X=0..320, Y=0..180`；其中 X=300..320 是右侧交接唇板，不是车位。车位中心如下，两层相同：

```text
后 Y=180     C (75,135)       D (225,135)  |  升降台中心 E (400,135)
              140×80           140×80       |  台面 X=325..475
前 Y=0       A (75,45)        B (225,45)   |  Y=90..180
             X=0            X=300..320     5 mm 接缝
```

| 参数 | 设计值与说明 |
|---|---|
| 车位节距 | X 150，Y 90；相邻平直托盘边缘理论间隔 10。 |
| 每层停放区 | 300×180，四个托盘中心形成 2×2；20 mm 交接唇板另计。 |
| 车位外框 | 停车区内净尺寸不小于 300×180；2020 四角构架外约 340×220。交接口 D 所在侧梁分段，不得挡住搬运销及托盘。 |
| 下方 DOCK / 一层 / 二层工作面 | Z=70 / 200 / 420；停车层间距 220，升降工作行程 350。 |
| 楼层内搬运机构 | 每层从工作面向上预留不超过 175 高；上层板下支撑示意最低 Z=400，下层抓取头最高约 Z=375，理论余量约 25。顶层抓取头最高约 Z=595、顶梁下缘约 Z=630。以完整模型和实物复核。 |
| 固定工作面至升降滚筒 | 在对接时两者工作面调平，目标高差 ≤0.5；固定端 X=320、升降端 X=325，水平缝 5。先满足实际试验，不把目标当作已达成精度。 |
| 托盘定位 | 车和固定挡块均不超出 140×80 投影；托盘底板建议 2 mm 铝板，上表面孔加耐磨衬套，上面另装轮挡。 |

## 3. 每层如何实现 X/Y 移盘

每层工作面采用完整平整、可替换的低摩擦耐磨面，底板无贯通运动槽。一对 Y 向导轨带动横梁，横梁上的 X 向小车位于车辆上方。小车带一个可上下移动的抓取横杆，横杆两端的定位销插入托盘上表面的孔，既推动托盘，也约束托盘转角。每次只将一块托盘移入相邻空格；没有相邻空格就不动作。

建议抓取尺寸（均为托盘局部坐标，先用样件确认）：

- 两销位于 `(X,Y)=(−60,−30)`、`(+60,−30)`，以托盘中心为原点；销直径暂定 3，托盘对应孔暂定 4，销尖只需进入孔内约 1～1.5。
- 105×43 mm 车模居中并用挡块固定。抓取横杆沿托盘前侧 `Y=−30`，杆宽不超过 5；车辆投影约 Y=−21.5..21.5，两者有约 6 mm 理论间距。轮挡也须避开横杆和销；实物偏移与防晃必须实测。
- 低于车顶的横杆、销和导向杆均须留在托盘前侧避让带；较宽的执行器主体只允许布置在车顶以上。托盘定位孔必须加强，且两端导向在全过程内不碰车、轮挡或邻格。
- 抓取横杆通过一套 12 V、50 mm 行程微型线性执行器升降。下降时销入孔；提升后销尖高于停车面约 50，超过车顶约 18，可在其他停车车辆上方空驶。上、下各增设一个向主控报告状态的传感器，不能仅依赖执行器内部限位。
- 执行器只负责升降；两根导向杆及横杆承受横向推力，避免将侧向力直接加到执行器伸缩杆。抓取机构各部最高目标为停车面以上 175；所有电机、轮、拖链和行程均须在完整模型中校核。
- 对接时，抓取头中心可到 X=300，右侧销到 X=360，临时伸入停稳的升降台上方。升降前必须先退销、把抓取头退回 X≤225 并确认，避免升降时碰撞。

每层 2 台步进：X 向 1 台；Y 向 1 台通过联动轴同步带动两侧导轨，避免单侧拉偏。另有 1 台 12 V 微型直线执行器升降抓取横杆。GT2 皮带、双 Y 导轨、滑块、抓取头和拖链均需建模。

| 运动 | 所需中心行程 | 导轨初选 | 理论可用上限 | 说明 |
|---|---:|---:|---:|---|
| X | 75→300，225 | MGN7C，280 长，每层 1 套 | 约 257.5 | 以 22.5 长滑块完全留在轨上计算；前提是实际轨道两端可安装限位。 |
| Y | 45→135，90 | MGN7C，150 长，每层 2 套 | 约 127.5 | 两侧同时移动并由同一传动轴同步。 |

导轨实际滑块长及端挡按实物修正。MGN7C 参考尺寸见 [HIWIN 产品目录](https://www.hiwin.com/wp-content/uploads/HIWIN-Linear-Guideway-Catalog.pdf)。不能把 100 mm 轨道长度当作 100 mm 有效行程。

## 4. 侧置升降与交接

升降台滚筒沿 X 方向运送托盘，工作范围 X=325..475、Y=90..180；四根主动滚筒的建议轴线 X=340、380、420、460，滚筒轴平行 Y，顶部与固定工作面齐平。滚筒组同一方向联动，由 1 台 12 V N20 驱动；两侧有不进入托盘包络的导向边。台面周边及滚筒转动件必须有防护。

**由停车层送入升降台：**

1. 把升降台停到对应楼层；确认台面空、两处高差合格、滚筒未转。
2. 层内调度把目标托盘送到 D。抓取销插入托盘后，将托盘中心从 X=225 推到 X=300；此时托盘范围 X=230..370，已覆盖固定面至 X=320、跨过 5 mm 缝并压到 X=340 滚筒。
3. 销提升并确认脱离；滚筒低速将托盘中心送至 X=400，台内到位传感器确认。层内抓取头回到安全区后，升降才允许移动。

**从升降台送回停车层：**按逆序执行：到目标层并对平→滚筒将托盘中心送回 X=300→交接位置标记确认→滚筒停止→上方抓取销插入并确认→小车拉回 D→移动至目标空格。交接需要低速、限时；先用人工推拉和独立点动验证，再自动化。

轴、丝杆均移到台面后侧，示意光轴中心 `(345,205)`、`(455,205)`，丝杆中心 `(400,205)`，均在载车 Y 投影之外；实际支架不能穿入托盘或车辆。两根 Φ8 光轴各配 2 个 LM8UU，轴承中心沿 Z 相隔约 50，控制悬臂转矩；台架应使用金属连接件并试验刚度。光轴长初选 500，约 Z=10..510；轴承随工作台上下运动的包络约 Z=33..457。

升降电机放在后侧、底座上表面，采用**12 V 通电释放、断电抱紧的抱闸型 42 步进电机**；示例型号仅供询价：[42AI48-1684S-B06-12V](https://www.frankhuai.com/nema-17-stepper-motor-with-12v-brake)。该示例标称电机相电流 1.68 A、机身长 76；购买前须向厂家确认抱闸静保持力矩、线圈电流和断电动作。抱闸保持力矩设计目标不小于 0.2 N·m，并进行带载断电保持试验。升降可选合格的 DRV8825 驱动及散热，限流根据实际模块及电机设定；先低电流试运转，不得直接假定满额电流可持续。

T8 丝杆采购要求**单头、实际导程 2 mm/转、长约 450 mm**，与匹配螺母配套，不能只写“螺距 2”。安装示意：电机约 Z=0..76、联轴器约 Z=76..101、丝杆约 Z=90..540；丝母中心比工作面高约 60，运动时约 Z=130..480。轴端、螺母、支撑及抱闸实际长度到货后重新复核。

三个工作高度用位置传感器校正；建议下/上电气硬限位触发约 Z=65/425，并留机械止挡和缓冲。具体触点高度须按运动件包络安装。**禁止把丝杆自锁或抱闸的标称值当成掉电不下滑的证明。**

## 5. 电气分配和互锁

```text
12 V / 8 A 适配器
 ├─ 逻辑支路：12→5 V 稳压 → 主控、屏；3.3 V → 扩展与传感器
 └─ 急停常闭回路 + 手动复位继电器 → 电机支路
      ├─ 4× A4988 → 两层 X/Y 步进
      ├─ 1× 合格 DRV8825 → 升降步进
      ├─ 2× TB6612 → 升降台滚筒 N20 + 两层抓取头升降执行器
      └─ 12 V 断电抱闸（通电释放，失电抱紧）
```

逻辑和电机共地；两路供电与驱动去耦、保险丝、MOSFET 栅极下拉、线圈续流、布线和接插件应在实物电路图中明确。电机支路断电时须验证控制信号不会反向给驱动、线圈或传感器供电。A4988/DRV8825 的 VMOT 端各就近放置合适耐压的储能电容，并检查厂家模块说明。12 V / 8 A 为设计预留，不是已经通过电流测试的结论。

I²C 使用 3.3 V，MCP23017 地址建议 0x20、0x21、0x22，逐块检查模块上拉。以下是**逻辑分配**，不是已核实的开发板物理引脚：

| 分配 | 信号 |
|---|---|
| MCU 定时器 | 5 路 STEP（两层 X/Y + 升降）及 3 路直流电机 PWM；每次只允许运行一台运动电机。 |
| MCU 其他 | USART 屏 2、I²C 2、急停状态 EXTI 1；预留扩展中断/调试。 |
| MCP A | 8 车位托盘存在、2 交接基准、1 台内托盘、1 DOCK 车辆、3 升降位置，1 预留。 |
| MCP B | 8 个 X/Y 两端限位、2 升降硬限位监测、4 个双销升/降状态、1 电机轨监测、1 预留。 |
| MCP C | 5 步进 DIR、5 ENABLE、1 抱闸释放、2 个共用直流方向、1 个共用 TB6612 STBY，合计 14，另留 2。三路 PWM 独立选择电机；切换前所有 PWM 归零并检查方向。 |

各 A4988 的 ENABLE、TB6612 的 STBY 和抱闸 MOSFET 必须有默认关断电平；急停和重新上电后硬件保持禁止运动，复位必须由人工确认并经主控状态检查，不能依赖 I²C 输出原状态。硬急停直接切断电机支路，急停状态另送 MCU；升降硬限位使用独立常闭触点串入安全回路，监测另用独立触点/开关，不以 I²C 轮询代替硬件断电。安全回路电流额定值、续流和复位接线以实际器件为准。

托盘存在传感器可以选用兼容 3.3 V 的数字霍尔，例如 DRV5032 系列；不同后缀采样率不同，位置确认必须低速实测。旧清单 A3144 的供电规格为 4.5–24 V，不能直接当作 3.3 V 供电器件；若复用 5 V 模块，还要处理其输出上拉和电平。[TI DRV5032](https://www.ti.com/product/DRV5032)；[Allegro A3144](https://www.allegromicro.com/~/media/Files/Datasheets/A3141-2-3-4-Datasheet.ashx?la=en)。

USART2 PA2/PA3、STEP 通道、I²C 与板载 Wi-Fi 等必须按**实际星火一号版本原理图、引脚复用和 BSP**核对后才冻结。RT-Thread 官方 BSP 提示 COM2 存在与以太网/PWM 的复用注意事项：[官方 BSP](https://github.com/RT-Thread/rt-thread/tree/master/bsp/stm32/stm32f407-rt-spark)。

## 6. 存取与异常边界

- 每层正常有 3 个托盘，不一定每个托盘都载车；因此可以存在 0～3 辆车。载车和托盘占位是两类状态，不能混为一谈。
- 存车先选目标层的空托盘，层内移至 D，再送往升降台、降到 DOCK 供用户放车，随后返回同一层并复位托盘。取车流程相反。转运期间目标层暂时只有 2 个托盘、2 个空格，返回后恢复 3 个托盘。
- 八个车位传感器只判断托盘是否存在；无法自动识别每辆车或所有车位上的车辆。车的身份/有无需由用户确认和状态记录维护；DOCK 光电仅辅助确认。
- 升降、滚筒和层内运动互斥；升降前确认托盘完全在台内、层内销已缩回、滚筒停止。任何超时、双销不到位、限位异常或状态不一致即禁止后续动作。
- 急停或总电源中断后，先机械固定升降台、确认是否有托盘跨缝，再人工检查和恢复；不得在位置未知时自动回零。涉及人手进入时先断电并固定活动件。

## 7. 后续交付

比赛计划书、完整机械 CAD 和电气原理图应在单层验证通过后按本方案制作。
