eatoughaidan5v4418-spec/-/docs/硬件验证与实施_v2.md

# 硬件方案 v2：已做校核与实施顺序

日期：2026-11-04。配套 [硬件方案 v2](硬件方案_v2.md) 和 [采购清单 v3](采购清单_v3.md)。

## 已完成的纸面与程序校核

以每层四个矩形车位 A/B/C/D、3 块 140×80 平行托盘、节距 150×90 为模型，运行 `py tools/check_hardware_v2.py`：

| 项目 | 结果 | 范围 |
|---|---|---|
| 任意目标托盘到 D | 24 种三盘一空的排列 × 3 个目标，72 种情况均有路径；最短路径最长 5 次滑移 | 只验证单层网格状态，不验证抓取头和真实机构。 |
| 层内滑移 | 48 个有向合法状态转移，按 1 mm 取样；静止托盘间最小平面间距 10 mm | 仅考虑托盘矩形，不含导轨、车、挡块、线缆及运动误差。 |
| D 到升降台 | 对 18 种 D 有托盘的排列，托盘中心 X=225..400 按 1 mm 取样，不与其余两盘投影重叠 | 没检查升降架、抓取头、导向条或其他真实部件。 |
| 跨缝支撑 | 理想化二维支承模型中，固定面到 X=320、滚筒中心为 340/380/420/460，且重心相对托盘中心沿 X 偏移不超过 20 mm 时，支承区间覆盖重心 | 假定固定面连续、滚筒可接触，忽略变形、摩擦、滚筒直径、车沿 Y 偏载和动态冲击。**不是稳定性或驱动力测试。** |
| 导轨与高度 | 按 MGN7C 滑块 22.5 长计算，280 轨满足 225 行程加 10 余量，150 轨满足 90 行程加 10 余量；高度、光轴及丝杆示意包络数值一致 | 实际端挡、支座、头部和驱动件要重新做完整三维干涉检查。 |
| 预算加总 | 41 个采购行合计 ¥3,578.48；预备费和报价性质见采购清单 | 只校验表格加总，不代表价格真实可采购。 |

这些检查证明了**简化平面布局和数字自洽**，不能证明能装配、承重或上电安全。

## 下料与建模前的未决点

1. 按实际电机、双 Y 传动、抓取头及执行器画出每层 X/Y 总装；保证最低抓取横杆只进入车模前侧避让带，空驶时所有低位部件均高于车顶。
2. 交接口右侧梁必须留出抓取头进出和托盘跨缝位置；用其他连接件支撑 20 mm 唇板。打孔前应按照当前方案和实际零件核对位置。
3. 完整检查托盘、车、轮挡、抓取头、两层横梁、丝杆、抱闸、支座、行程开关和线缆在全运动路径中的干涉；逐项检查工作位和硬限位的包络。
4. 为双导杆和丝母选择可靠的支撑架，复核偏载、台面挠度、两层接缝、重心和底座防倾覆；必要时加宽底座或配重。
5. 逐项向供应商核对抱闸力矩和电流、抓取执行器完整包络与占空比、N20 堵转电流、驱动散热、传感器电平、板载引脚复用及电源型号。

## 最小验证件：先一层，再两层

1. **工作面和托盘手动滑移。** 做一层四格、3 块托盘和 1 个空格，使用最大预期载荷。人工完成全部方向的相邻移位，测最不利位置的静摩擦力、托盘偏摆与 10 mm 间隙。阶段目标：无碰擦、无失稳；受力与平整度实际记录。
2. **抓取头单独验证。** 装双销、双导杆及单个执行器，不装车或先用纸质车模。证明横杆和车/轮挡不碰撞，50 mm 行程能可靠入孔、脱孔并越过车顶；验证这个抓取头的上、下状态传感输入及执行器额定占空比。
3. **单层 X/Y 低速移盘。** 两轴分别回零、限位和点动；只移动到相邻空格，测试 24 种三盘一空状态的目标托盘可达，并检查偏转、重复定位、卡滞和线缆。验证合格后再复制第二层。
4. **固定高度交接。** 不接升降动力，先以支架固定升降台高度。人工推拉验证 5 mm 跨缝及滚筒支撑，再低速电动验证 X=225→300→400 和反向动作；测接缝高差与错位。必须确认抓取头离开后滚筒才能动作，且两者不会抢推。
5. **升降空载与带载。** 固定载荷后低速运行 70↔200↔420；确认限位、底部/顶部机械余量、台面水平和重复对位。先空载，再逐级加到设计上限；测倾斜、丢步、电机/驱动温升及最高电源电流。
6. **断电和恢复。** 在不同高度带载断开电机轨，测抱闸保持和位移；检查电机电源确已切断而逻辑维持，传感器或信号线无反向供电。急停解除后只有人工确认且状态安全才允许动作。跨缝中断须人工固定托盘后恢复。
7. **双层完整演示。** 两层各放 3 块盘、每层留 1 个无托盘格；验证空盘取到 DOCK、放车、回原层、指定取车及急停。持续循环测试后再写“已实现”和比赛计划书。

## 运行记录

本次没有实物、CAD 装配、电路仿真或通电测试。没有通过程序校核来宣称抱闸可靠、碰撞完全排除或 8 A 电源一定足够；这些均需要按上述顺序验证。
