eatoughaidan5v4418-spec/-/docs/cad/一层甲板_易懂图.png

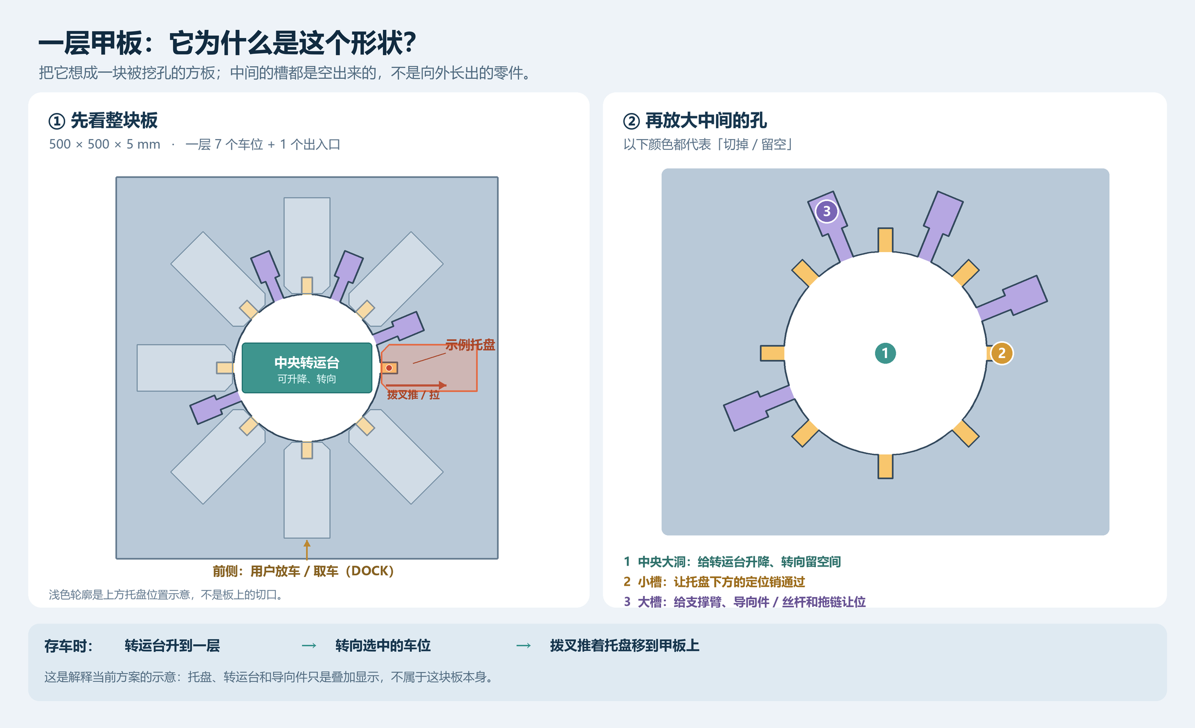
docs/cad/一层甲板_易懂图.png
