eatoughaidan5v4418-spec/-/docs/cad/短轴方案_结构说明.png

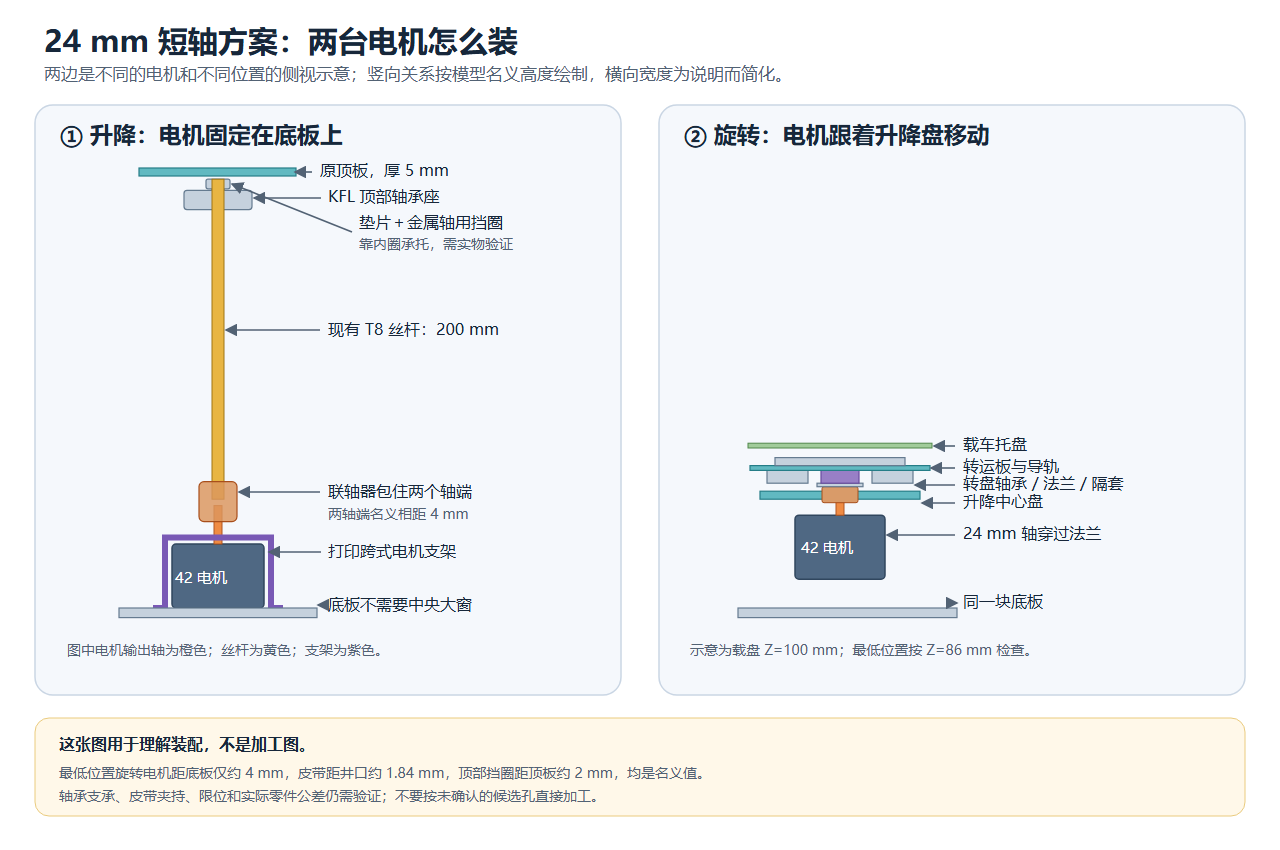
docs/cad/短轴方案_结构说明.png
