eatoughaidan5v4418-spec/-/docs/MCP23017_优信模块封装_估算版/封装预览_正面.png

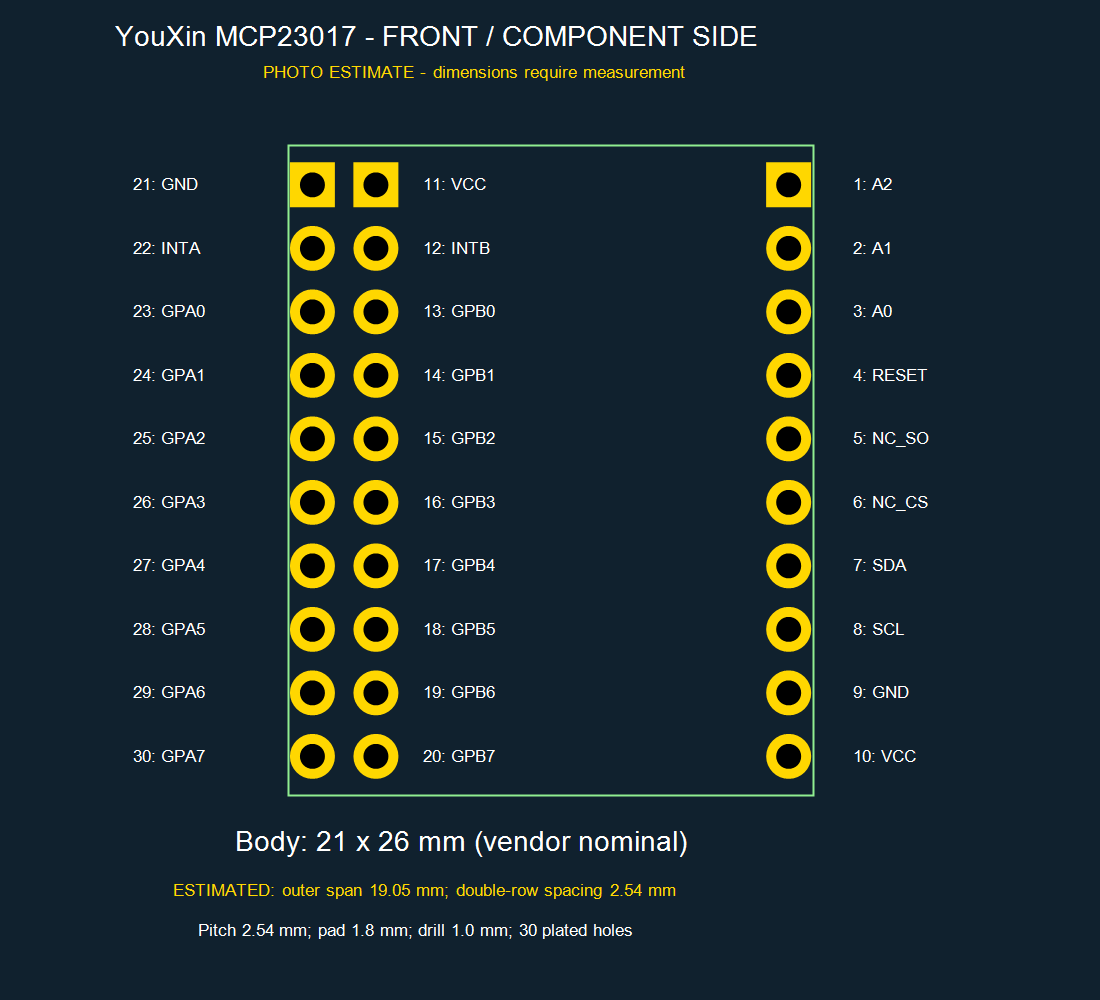
docs/MCP23017_优信模块封装_估算版/封装预览_正面.png
