eatoughaidan5v4418-spec/-/docs/PCB生产文件_20261111/PCB1_最终截图.png

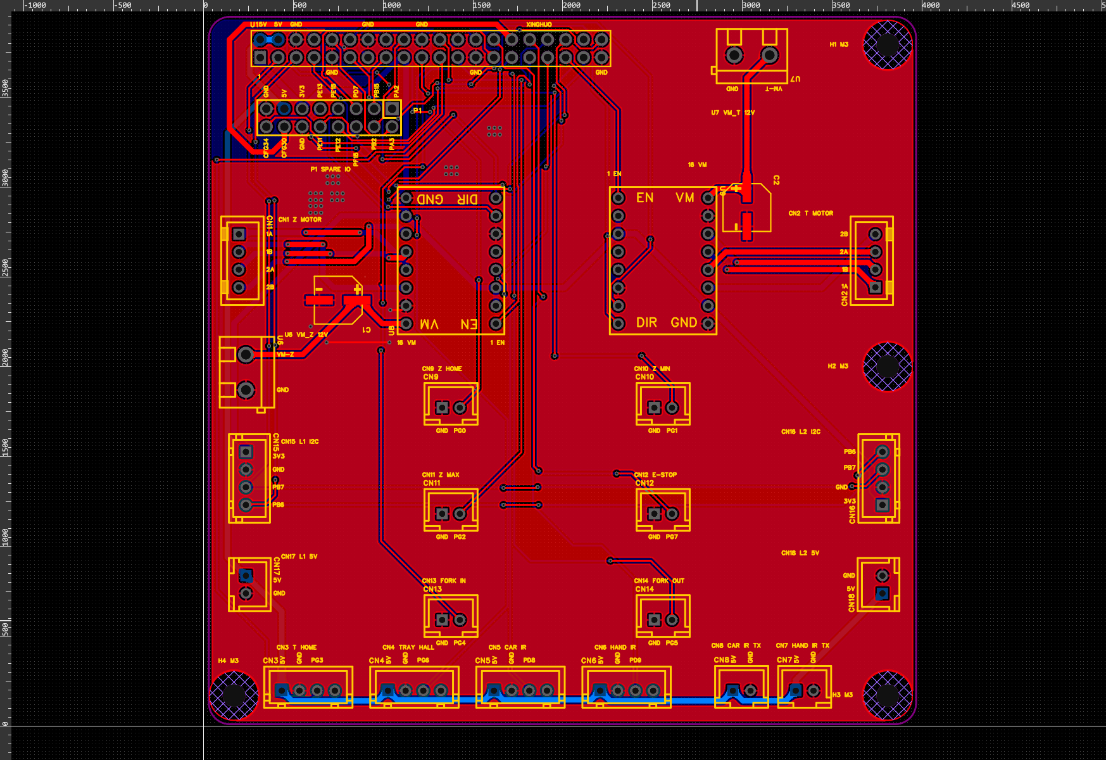
docs/PCB生产文件_20261111/PCB1_最终截图.png
