eatoughaidan5v4418-spec/-/docs/串口屏界面_v1/素材/00_bg_main.png

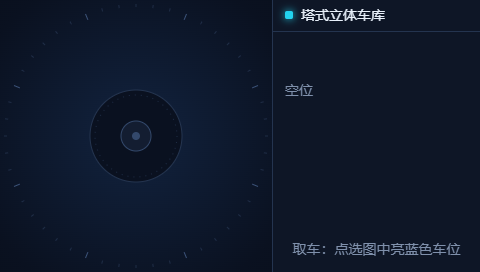
docs/串口屏界面_v1/素材/00_bg_main.png
