eatoughaidan5v4418-spec/-/docs/串口屏界面_v1/素材/01_bg_fault.png

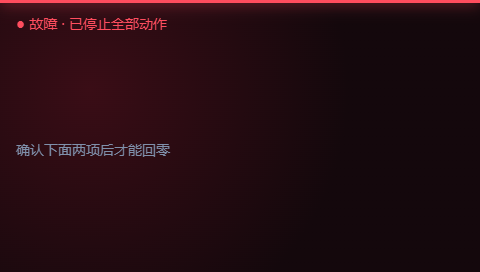
docs/串口屏界面_v1/素材/01_bg_fault.png
