eatoughaidan5v4418-spec/-/docs/串口屏界面_v1/素材/02_bg_estop.png

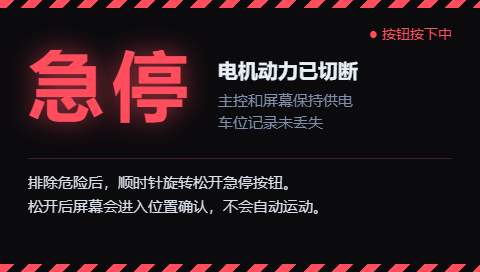
docs/串口屏界面_v1/素材/02_bg_estop.png
