eatoughaidan5v4418-spec/-/docs/串口屏界面_v1/素材/03_panel_home.png

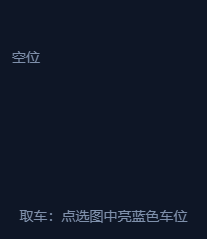
docs/串口屏界面_v1/素材/03_panel_home.png
