eatoughaidan5v4418-spec/-/docs/串口屏界面_v1/素材/04_panel_sel.png

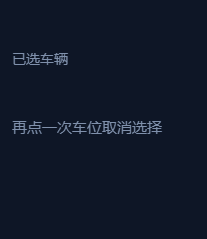
docs/串口屏界面_v1/素材/04_panel_sel.png
