eatoughaidan5v4418-spec/-/docs/串口屏界面_v1/素材/05_panel_dock_put.png

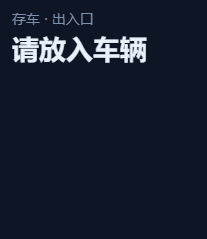
docs/串口屏界面_v1/素材/05_panel_dock_put.png
