eatoughaidan5v4418-spec/-/docs/串口屏界面_v1/素材/06_panel_dock_take.png

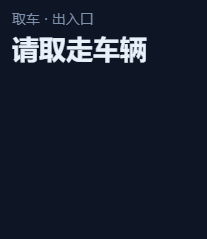
docs/串口屏界面_v1/素材/06_panel_dock_take.png
