eatoughaidan5v4418-spec/-/docs/串口屏界面_v1/素材/07_panel_prog.png

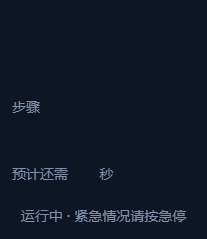
docs/串口屏界面_v1/素材/07_panel_prog.png
