eatoughaidan5v4418-spec/-/docs/串口屏界面_v1/素材预览.png

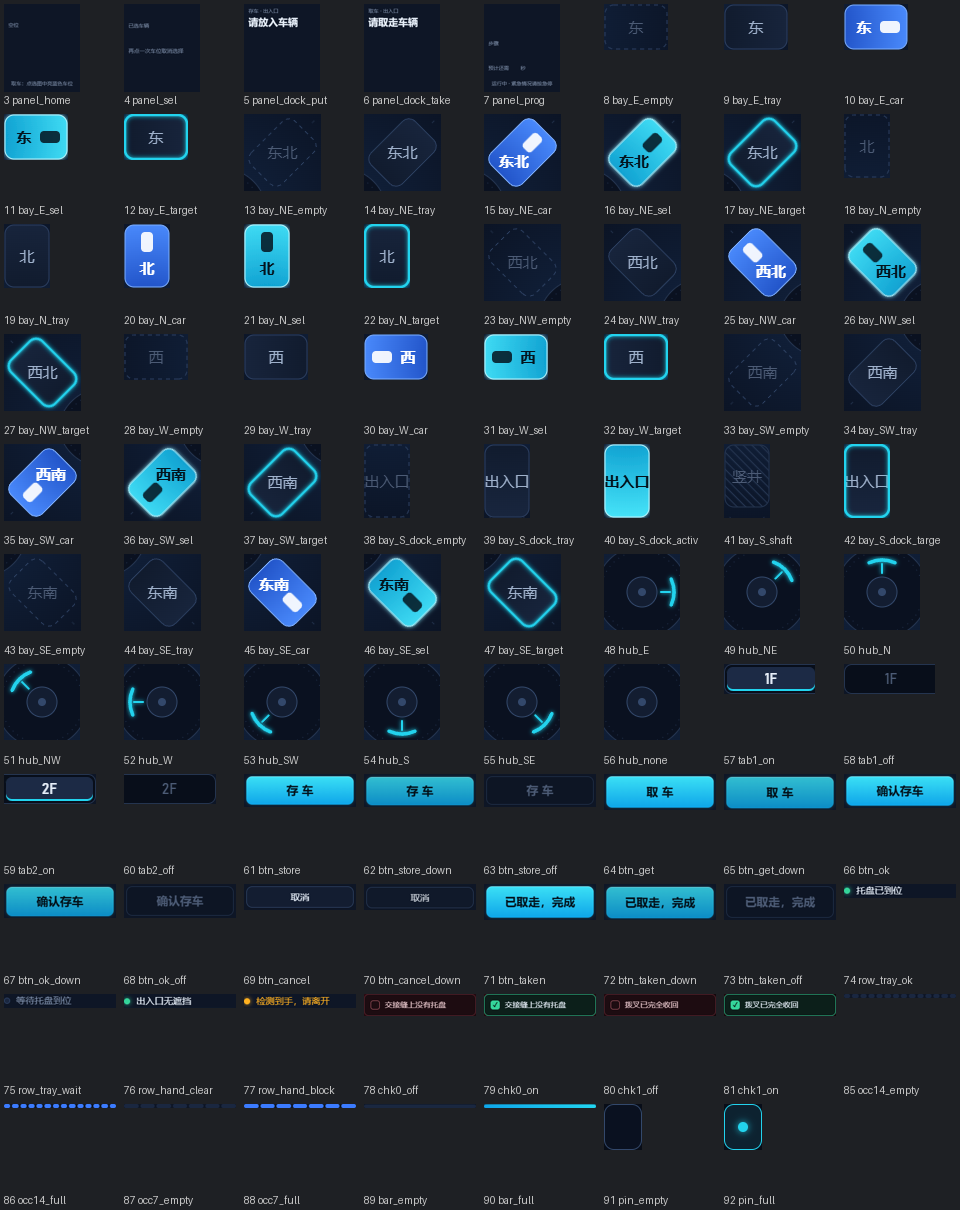
docs/串口屏界面_v1/素材预览.png
