eatoughaidan5v4418-spec/-/docs/转接板结构示意/主板叠装与侧边副板_结构示意.png

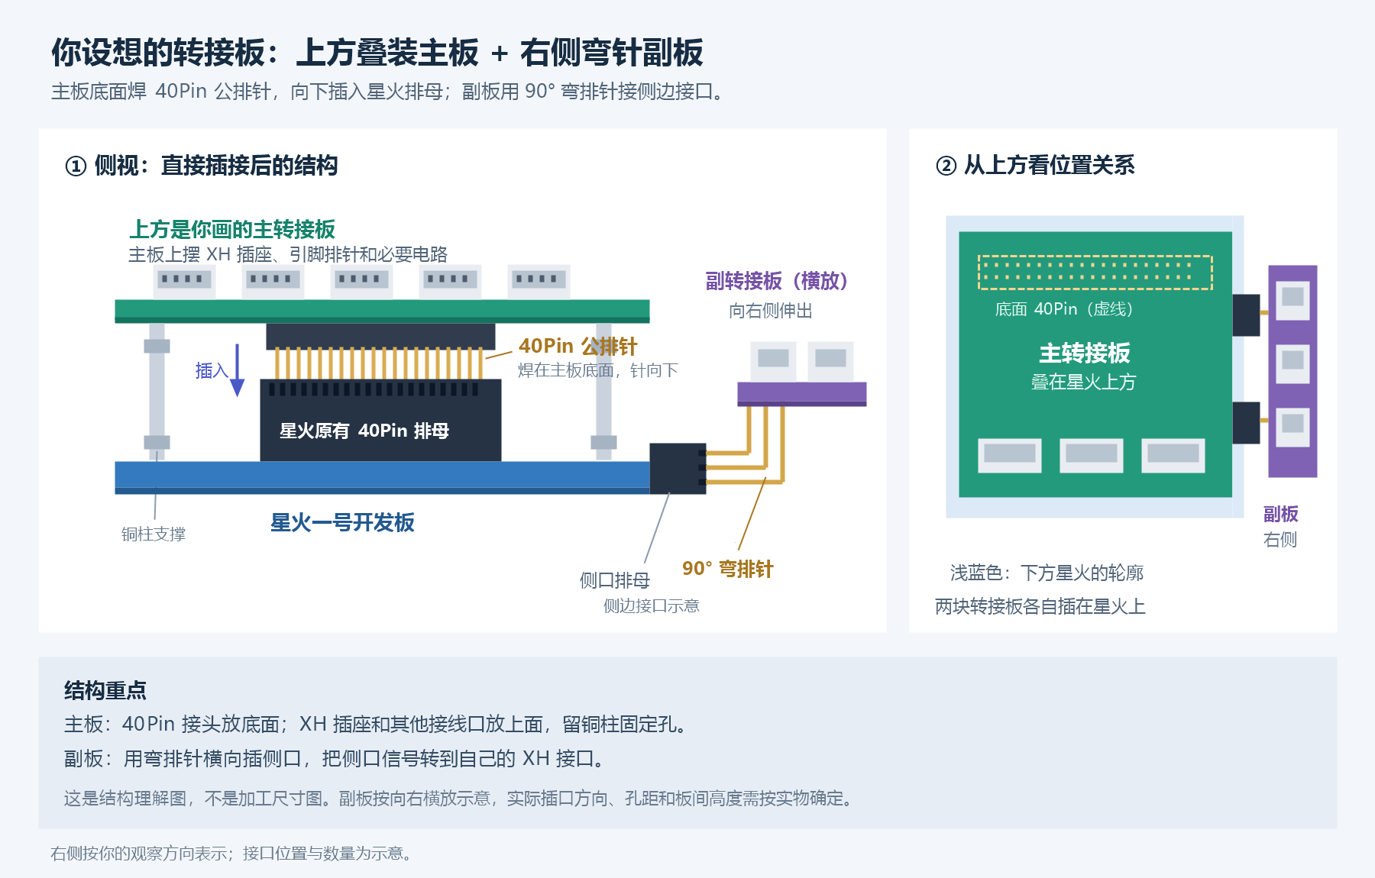
docs/转接板结构示意/主板叠装与侧边副板_结构示意.png
