eatoughaidan5v4418-spec/-/使用的硬件资料/其他硬件图/tb_image_share_1793853906598.png

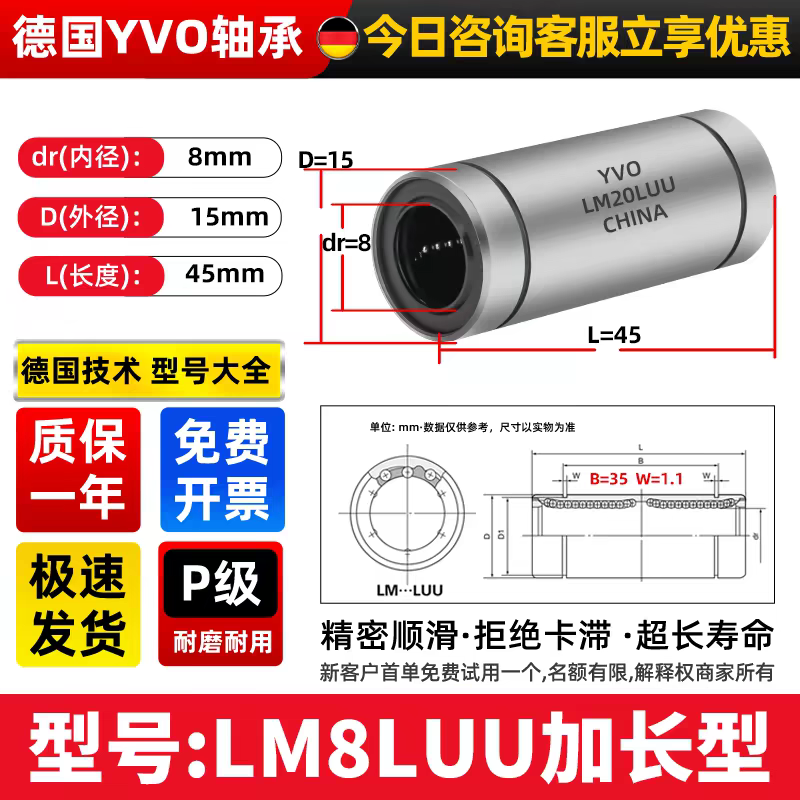
使用的硬件资料/其他硬件图/tb_image_share_1793853906598.png
