eatoughaidan5v4418-spec/-/使用的硬件资料/商品页已核SKU/DC-DC_5V3A/优信DC-DC_5V3A_AJ38_SKU实物.jpg

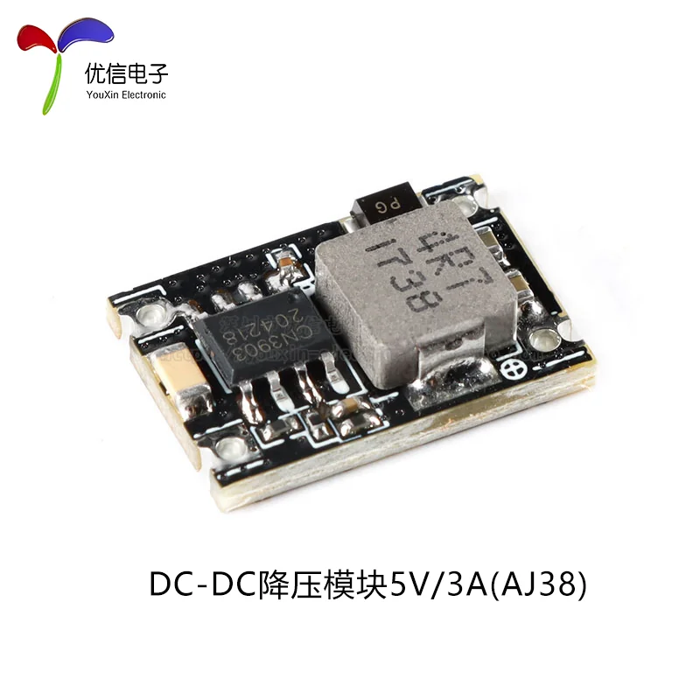
使用的硬件资料/商品页已核SKU/DC-DC_5V3A/优信DC-DC_5V3A_AJ38_SKU实物.jpg
