eatoughaidan5v4418-spec/-/使用的硬件资料/商品页已核SKU/DC-DC_5V3A/优信DC-DC_尺寸与IN-OUT.jpg

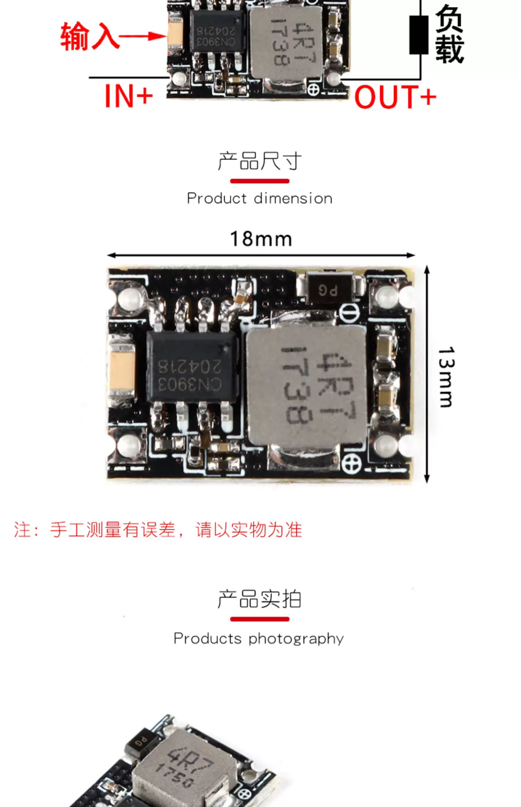
使用的硬件资料/商品页已核SKU/DC-DC_5V3A/优信DC-DC_尺寸与IN-OUT.jpg
