eatoughaidan5v4418-spec/-/使用的硬件资料/商品页已核SKU/MCP23017模块/优信MCP23017模块_参数页.png

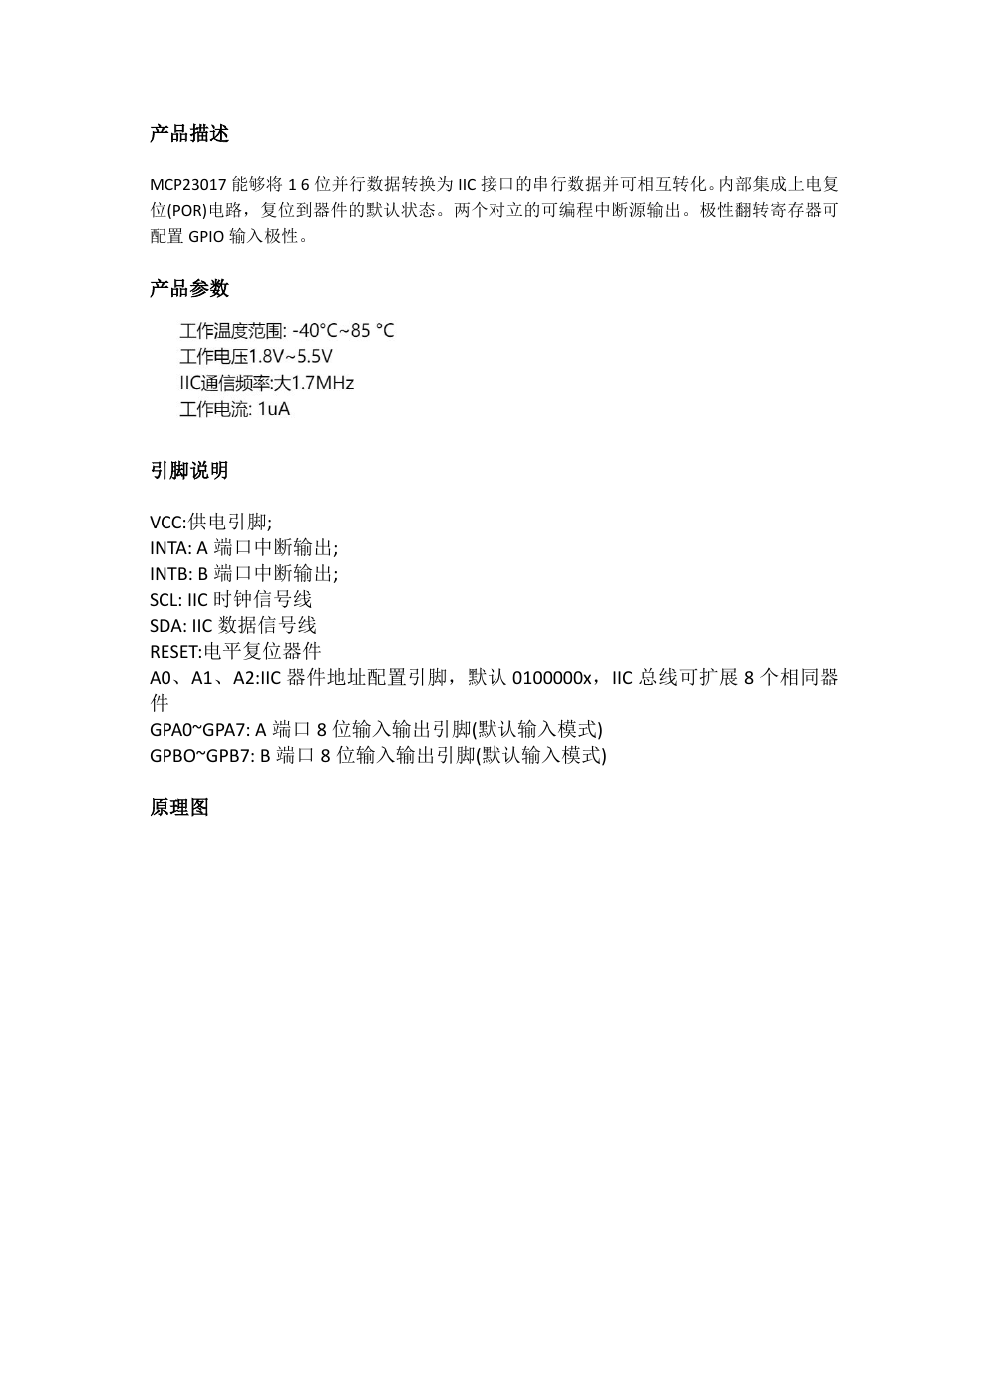
使用的硬件资料/商品页已核SKU/MCP23017模块/优信MCP23017模块_参数页.png
