eatoughaidan5v4418-spec/-/使用的硬件资料/商品页已核SKU/MCP23017模块/优信MCP23017模块_尺寸21x26mm.jpg

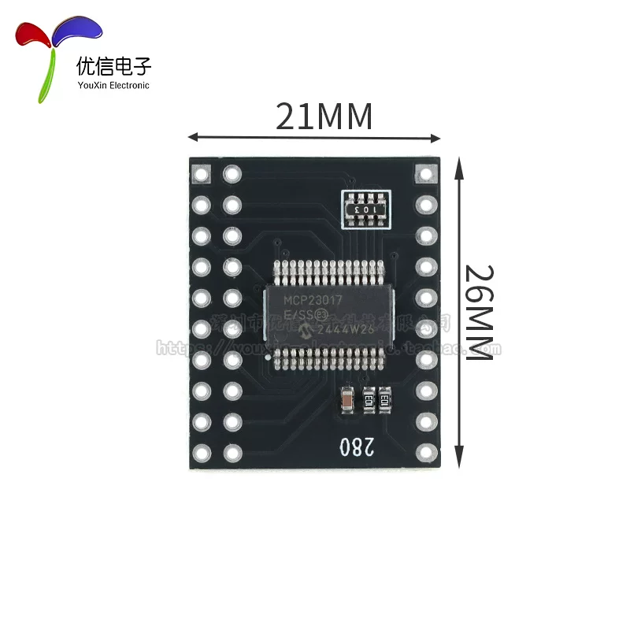
使用的硬件资料/商品页已核SKU/MCP23017模块/优信MCP23017模块_尺寸21x26mm.jpg
