eatoughaidan5v4418-spec/-/使用的硬件资料/商品页已核SKU/TMC2209红排针/优信TMC2209黄红排针_引脚定义.png

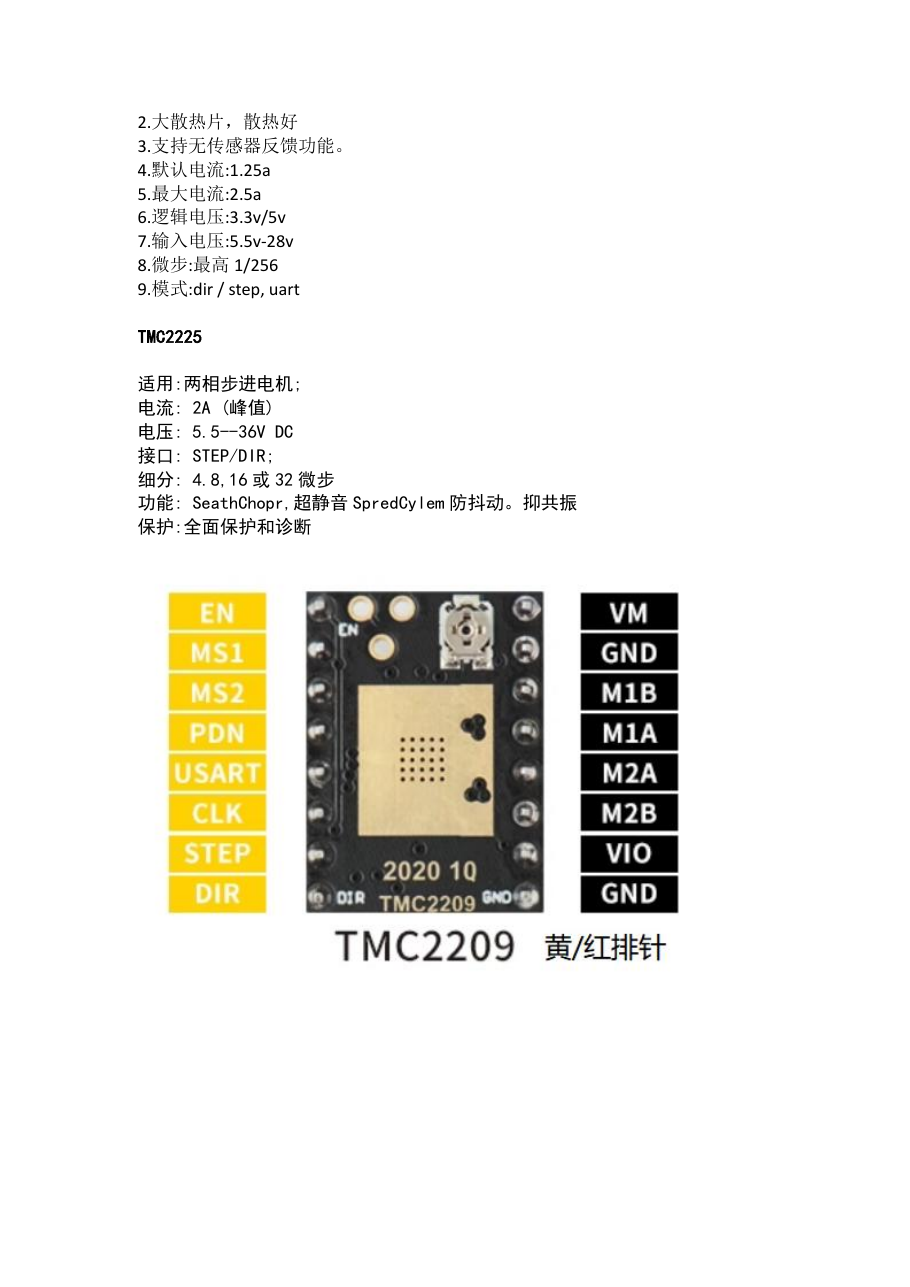
使用的硬件资料/商品页已核SKU/TMC2209红排针/优信TMC2209黄红排针_引脚定义.png
