eatoughaidan5v4418-spec/-/使用的硬件资料/商品页已核SKU/微动开关_带柄3脚滚轮/带柄3脚滚轮_SKU实物.jpg

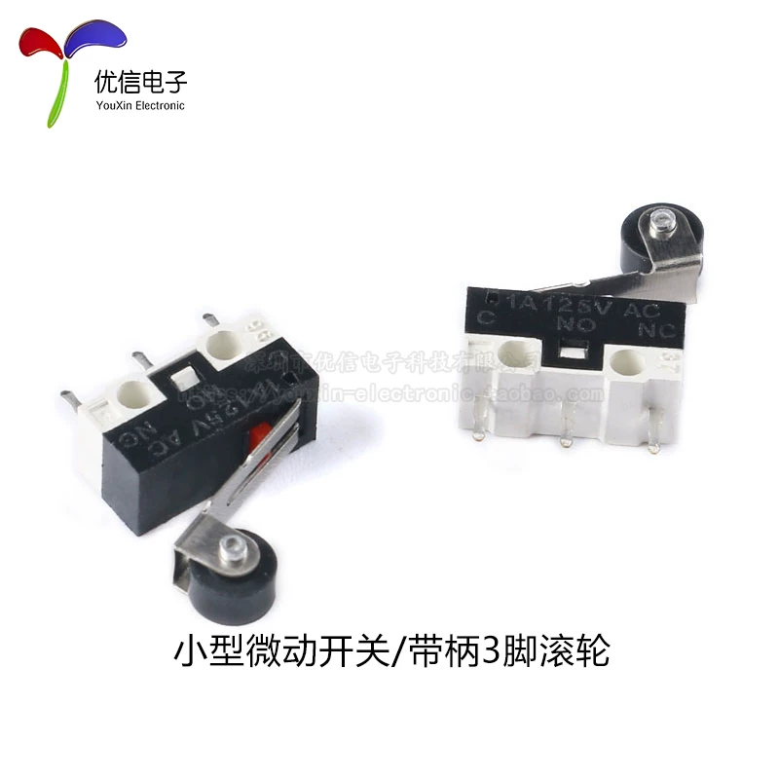
使用的硬件资料/商品页已核SKU/微动开关_带柄3脚滚轮/带柄3脚滚轮_SKU实物.jpg
