eatoughaidan5v4418-spec/-/使用的硬件资料/商品页已核SKU/梅花联轴器_D20xL25/上航梅花联轴器_已选SKU页面.png

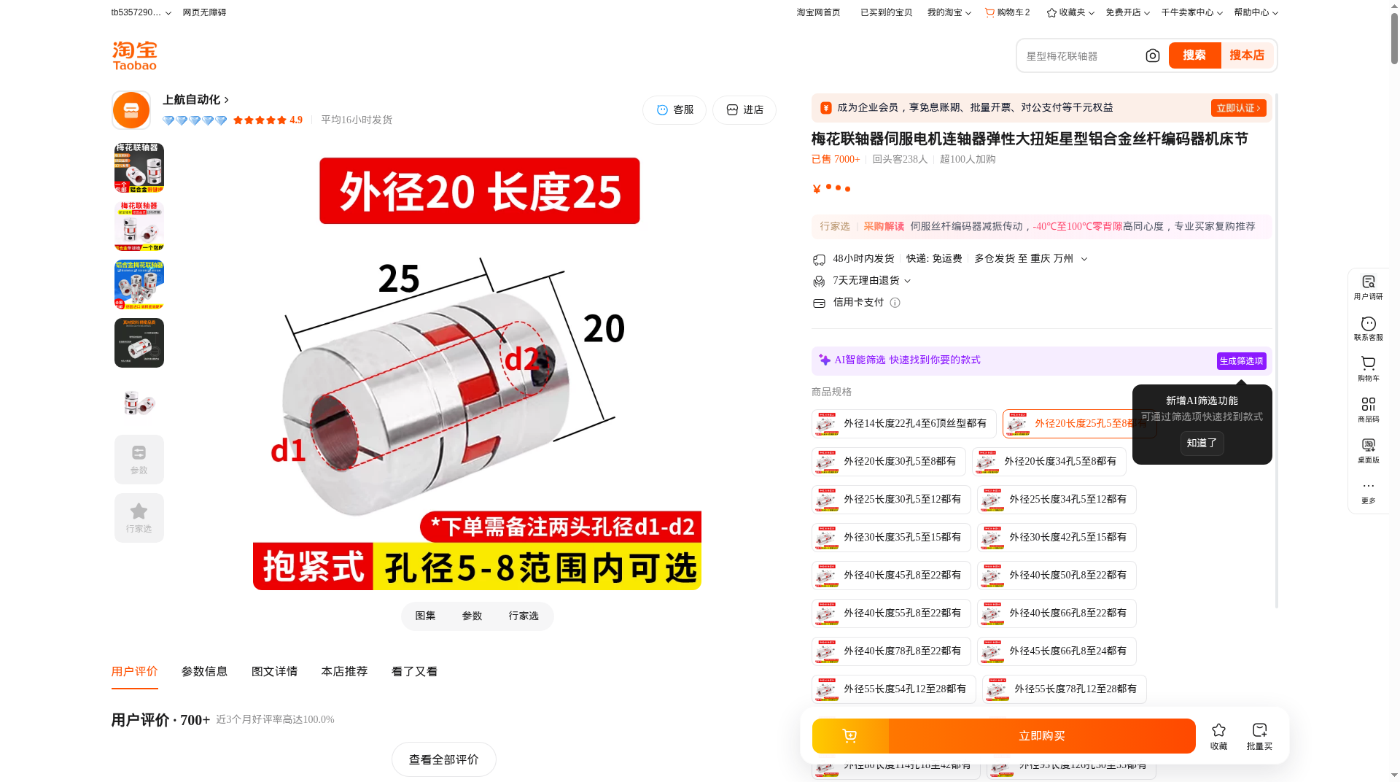
使用的硬件资料/商品页已核SKU/梅花联轴器_D20xL25/上航梅花联轴器_已选SKU页面.png
