eatoughaidan5v4418-spec/-/使用的硬件资料/商品页已核SKU/步进电机_步联SKU图纸/28BL3102-15YPro_磁柱裁切.png

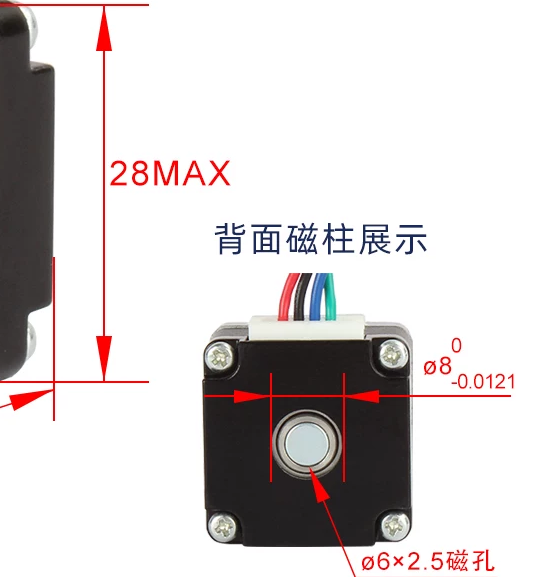
使用的硬件资料/商品页已核SKU/步进电机_步联SKU图纸/28BL3102-15YPro_磁柱裁切.png
