eatoughaidan5v4418-spec/-/使用的硬件资料/商品页已核SKU/步进电机_步联SKU图纸/42BL4002-67A_出轴67mm_SKU图纸.jpg

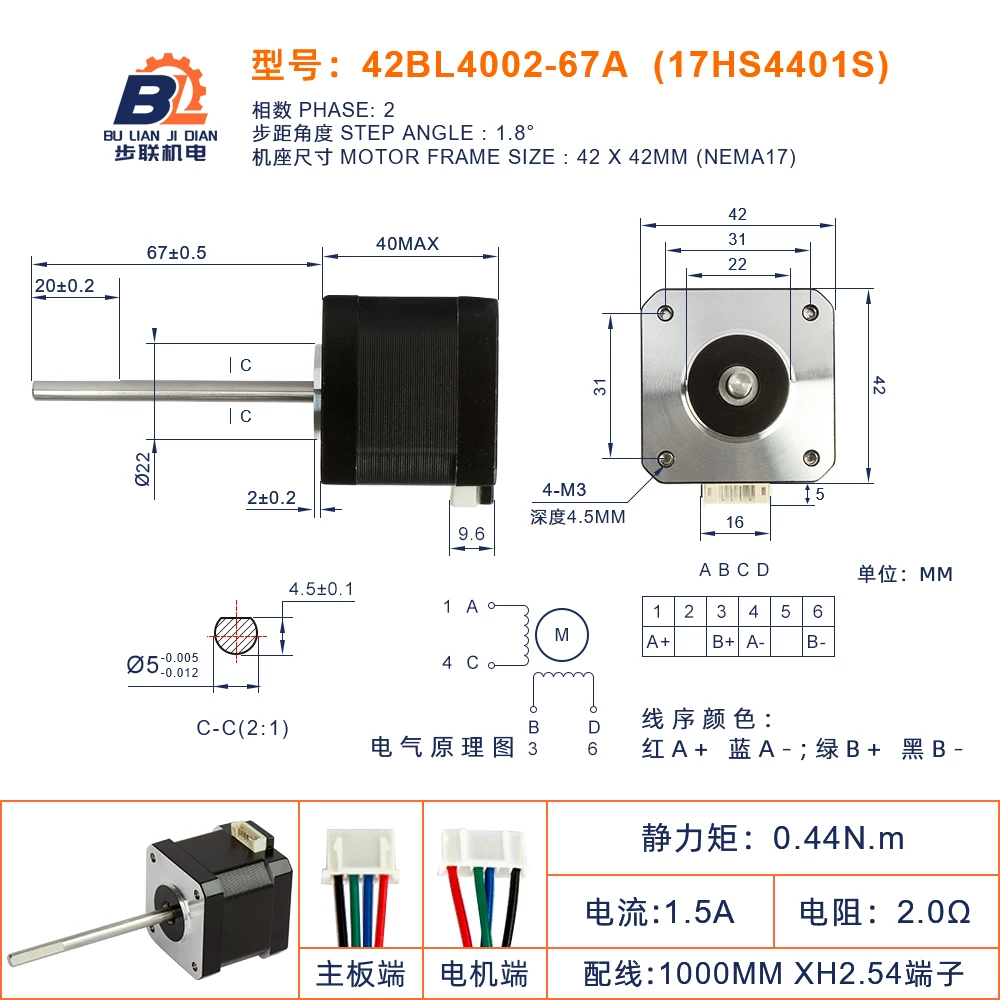
使用的硬件资料/商品页已核SKU/步进电机_步联SKU图纸/42BL4002-67A_出轴67mm_SKU图纸.jpg
