eatoughaidan5v4418-spec/-/使用的硬件资料/商品页已核SKU/霍尔3144模块/优信霍尔3144_TO92管身字标.jpg

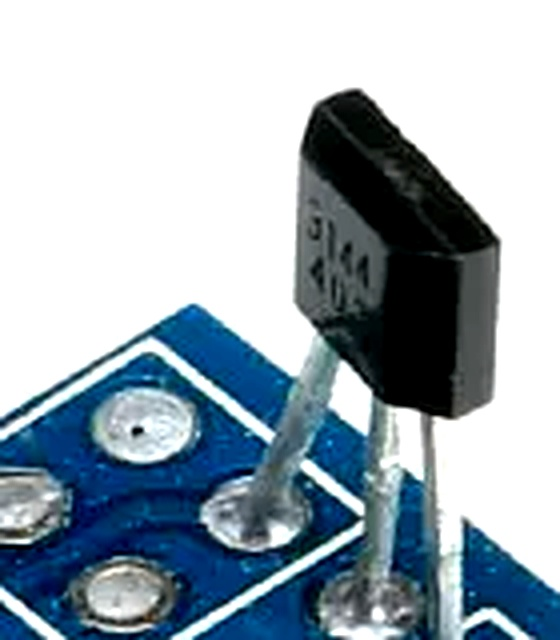
使用的硬件资料/商品页已核SKU/霍尔3144模块/优信霍尔3144_TO92管身字标.jpg
