eatoughaidan5v4418-spec/-/使用的硬件资料/商品页已核SKU/霍尔3144模块/优信霍尔3144模块_ES3144手册第1页.png

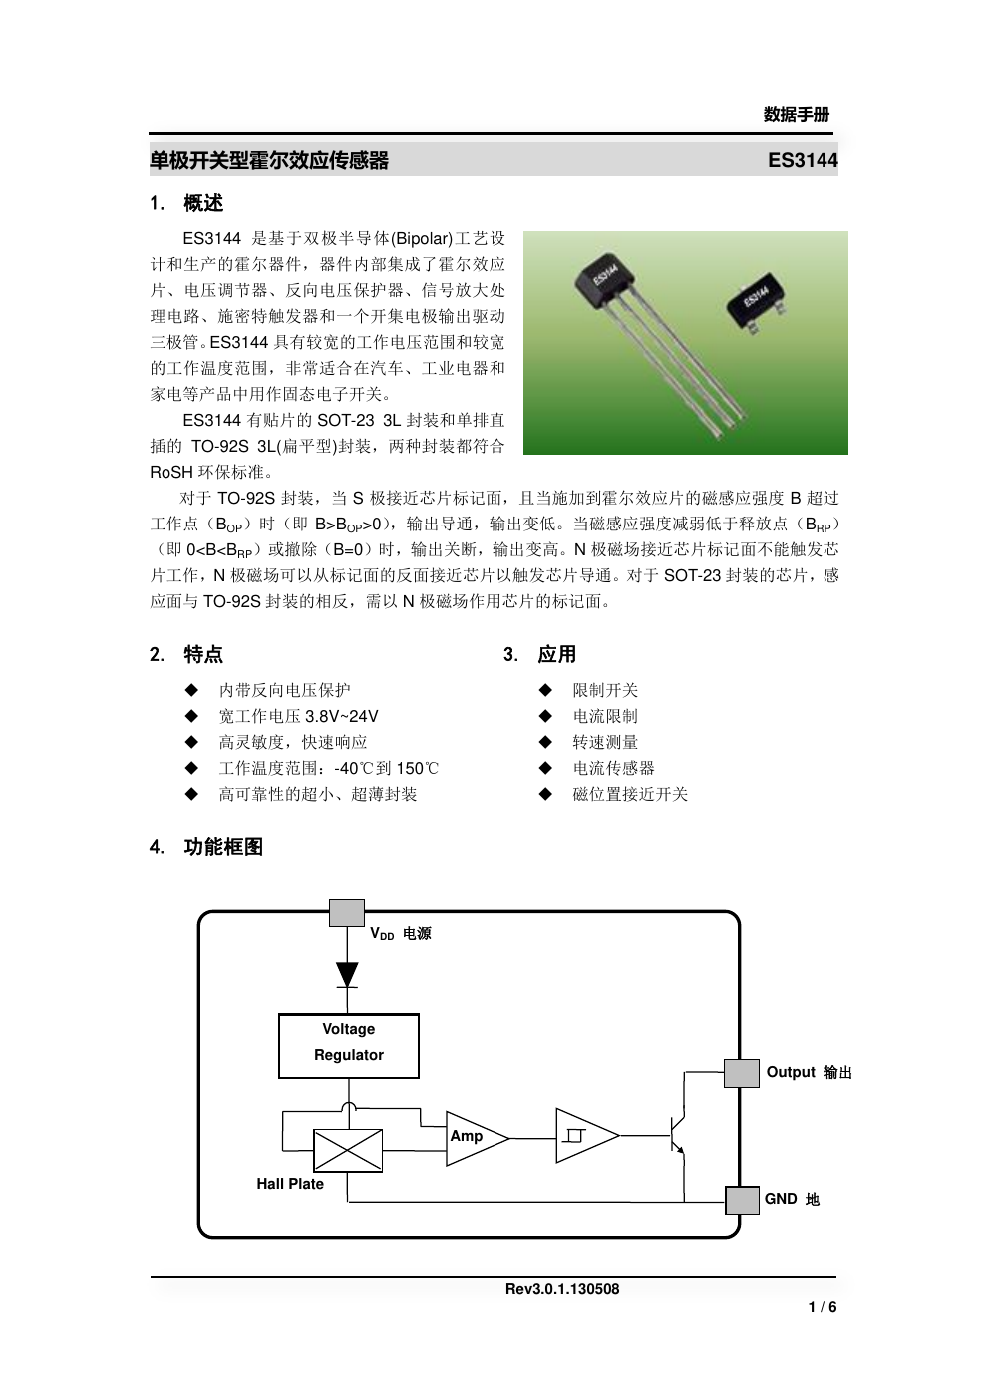
使用的硬件资料/商品页已核SKU/霍尔3144模块/优信霍尔3144模块_ES3144手册第1页.png
