eatoughaidan5v4418-spec/-/使用的硬件资料/商品页未选定或无单独图纸/16T同步轮_普通高品质未选定/启庞16齿高14孔5_选项页_未选定普通或高品质.png

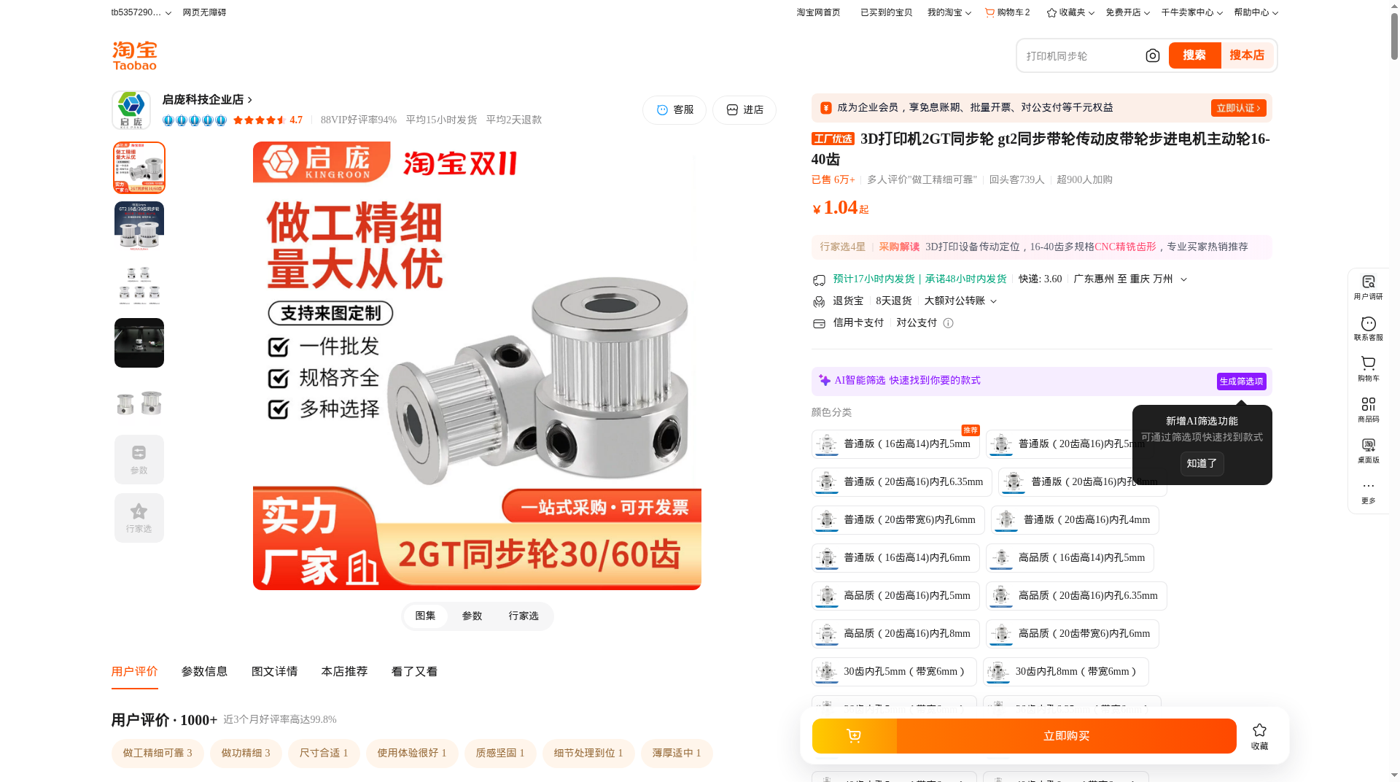
使用的硬件资料/商品页未选定或无单独图纸/16T同步轮_普通高品质未选定/启庞16齿高14孔5_选项页_未选定普通或高品质.png
