eatoughaidan5v4418-spec/-/使用的硬件资料/商品页未选定或无单独图纸/20T惰轮_带齿颜色未选定/启庞20齿内孔5带宽6_选项页_未选定带齿或颜色.png

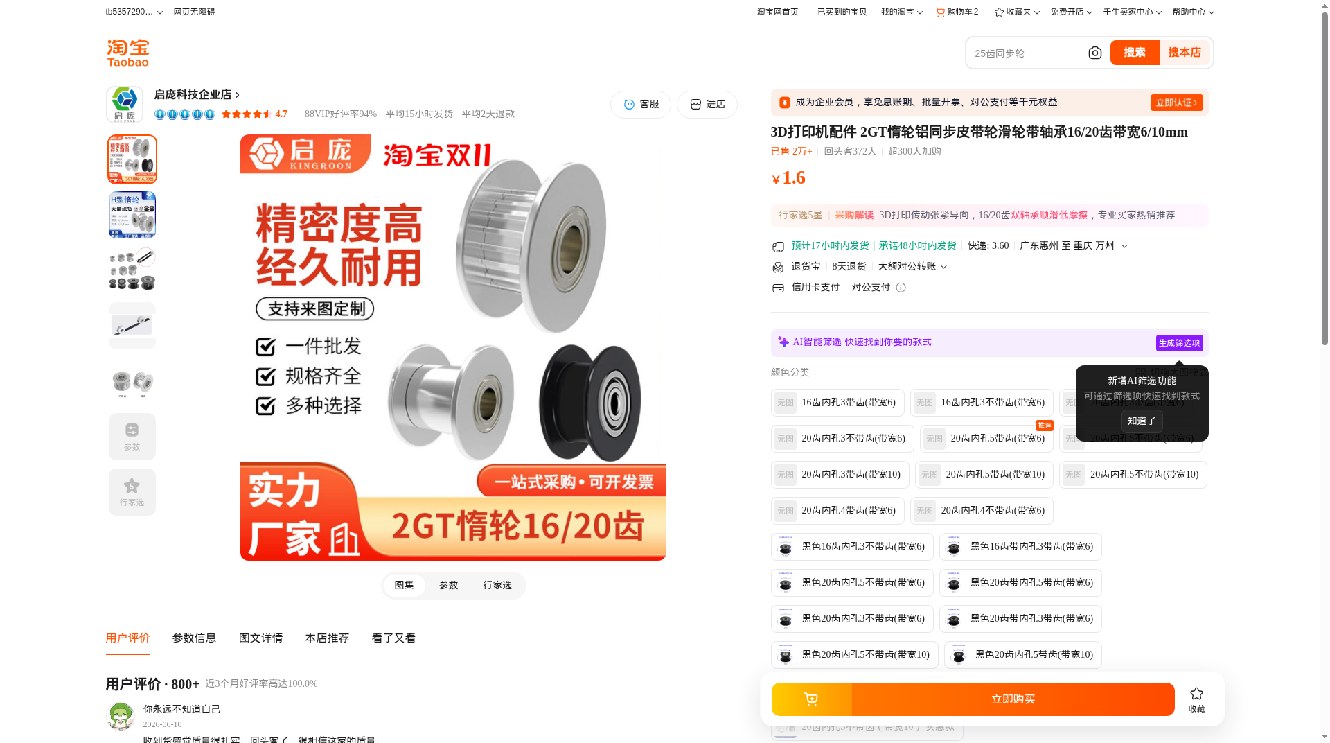
使用的硬件资料/商品页未选定或无单独图纸/20T惰轮_带齿颜色未选定/启庞20齿内孔5带宽6_选项页_未选定带齿或颜色.png
