eatoughaidan5v4418-spec/-/使用的硬件资料/商品页未选定或无单独图纸/GT2同步带_长度未选定/启庞GT2-6mm橡胶同步带_选项页_未选定长度.png

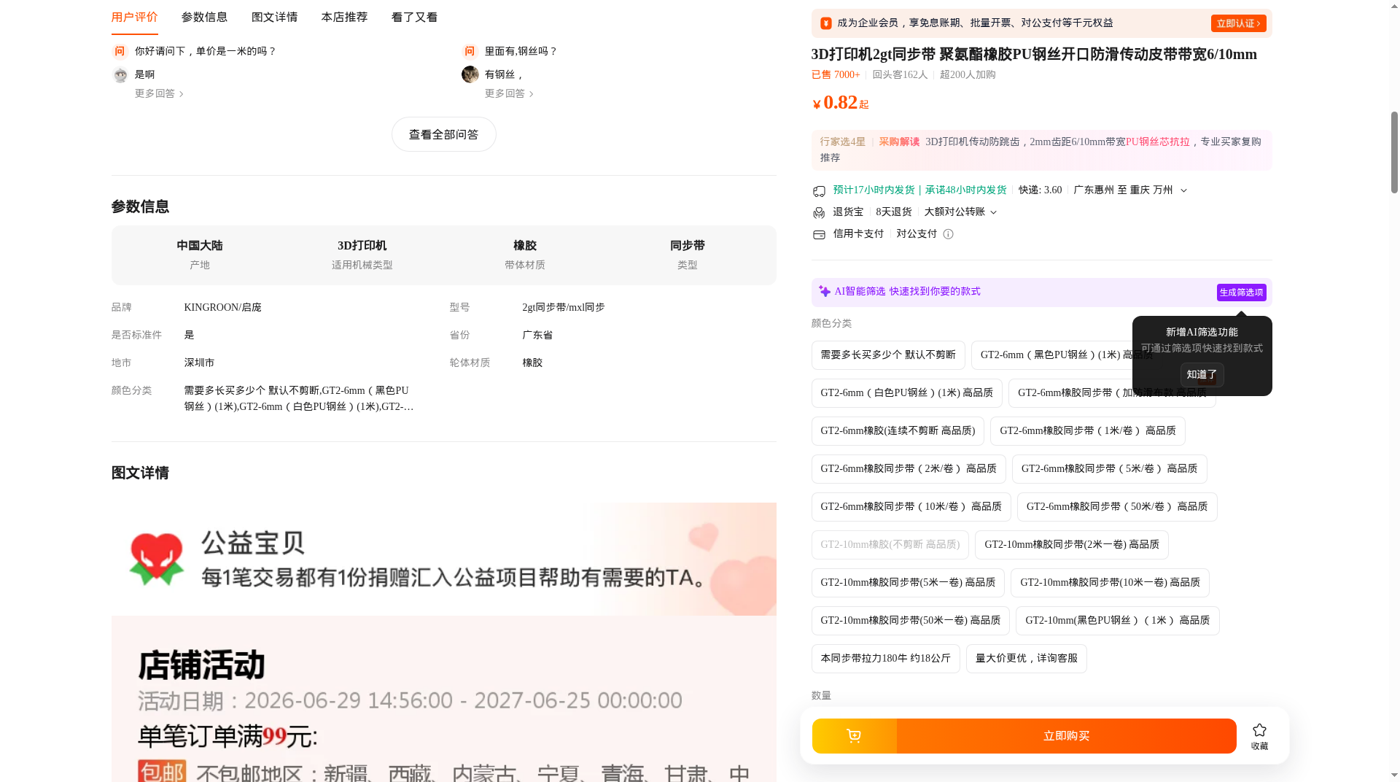
使用的硬件资料/商品页未选定或无单独图纸/GT2同步带_长度未选定/启庞GT2-6mm橡胶同步带_选项页_未选定长度.png
