eatoughaidan5v4418-spec/-/使用的硬件资料/商品页未选定或无单独图纸/梅花联轴器_孔径未备注/上航梅花_参数信息_非D20L25专属.png

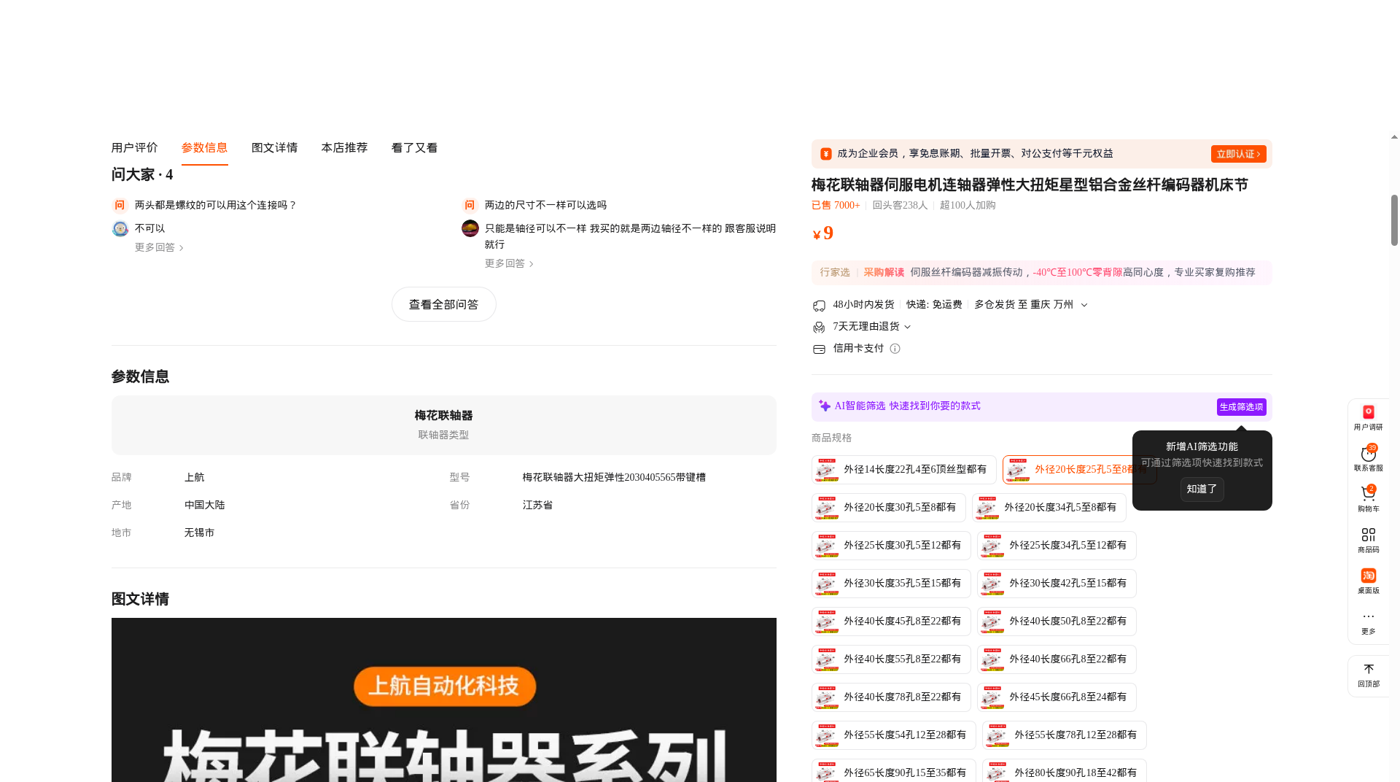
使用的硬件资料/商品页未选定或无单独图纸/梅花联轴器_孔径未备注/上航梅花_参数信息_非D20L25专属.png
