eatoughaidan5v4418-spec/-/使用的硬件资料/商品页未选定或无单独图纸/红外对射_F5-30cm常开带端子_无单独图纸/图库04_F3F5带端子2.54_线长可定制混用.jpg

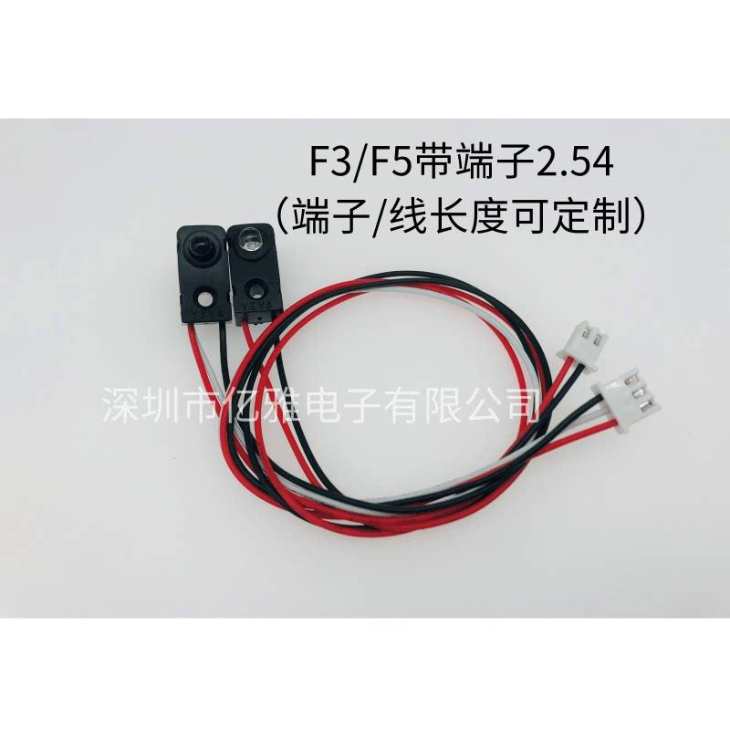
使用的硬件资料/商品页未选定或无单独图纸/红外对射_F5-30cm常开带端子_无单独图纸/图库04_F3F5带端子2.54_线长可定制混用.jpg
