eatoughaidan5v4418-spec/-/使用的硬件资料/商品页未选定或无单独图纸/红外对射_F5-30cm常开带端子_无单独图纸/图库05_无标注裸线对_非本SKU专属.jpg

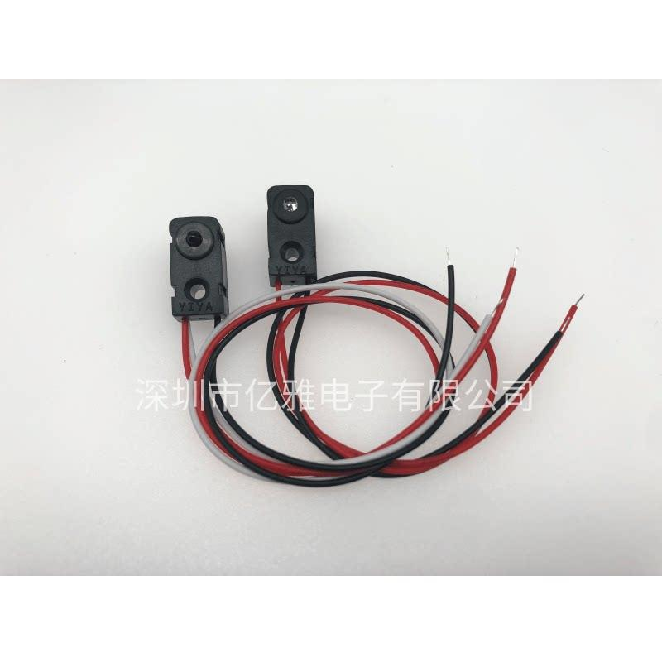
使用的硬件资料/商品页未选定或无单独图纸/红外对射_F5-30cm常开带端子_无单独图纸/图库05_无标注裸线对_非本SKU专属.jpg
