eatoughaidan5v4418-spec/-/docs/采购清单_v5.md

# 塔式车库采购清单 v5（预算草案，非实时报价）

日期：2026-11-10。对应 [硬件方案 v4](硬件方案_v4.md)，取代采购清单 v4。相对 v4 的变化：驱动由 A4988 改为 TMC2209 红排针模块；DOCK 红外对射改为 2 套；霍尔、红外统一 5 V；“转接与接线板”改为自制转接 PCB；规格按 v7 CAD 更新。

分两批：**第一批做一层样机**，但升降塔（立柱、导杆、丝杆、顶框）一次按两层高度做好；**第二批是第二层扩展包**，样机验证通过后再买。计划书按两层写，预算两批都要列。

以下金额为规划值，不保证能按此价格买到；不含运费、加工人工、工具和税差。按**从零采购**计数，不假定旧物已经到手。已经买到的器件，请用实际成交价替换对应行。

价格标记：**旧**＝沿用 2026-11-03 原清单单价；**估**＝没有可比报价的预算假设；**新估**＝v5 新增或改动的行，单价是本次整理时的粗略假设，**下单或写入计划书前须用实际价格替换**；**主控预算**＝原清单二手预算。

## 第一批：一层样机（含两层高度升降塔）

### 主控、驱动与电机

| 项目 | 规格及作用 | 数量 | 预算单价 ¥ | 小计 ¥ | 依据 |
|---|---|---:|---:|---:|---|
| 星火一号 | STM32F407，含下载调试接口 | 1 | 240 | 240 | 主控预算 |
| 串口屏 | TJC4827T143_011C，4.3 寸电容触摸；完整后缀与供电按实物确认 | 1 | 43 | 43 | 旧 |
| 升降步进 | 42BL40 / NEMA17，轴长 24 短轴版，经 T8 丝杆驱动升降 | 1 | 21 | 21 | 旧 |
| 旋转步进 | 42BL40 / NEMA17，轴长 24 短轴版，直驱转运台 | 1 | 21 | 21 | 旧 |
| 转运步进 | NEMA11（28×28×32），装在转运台上，带拨叉 | 1 | 35 | 35 | 估 |
| 步进驱动 | TMC2209 红排针模块，STEP/DIR 独立模式，带散热片 | 3 | 9 | 27 | 新估 |

### 传动与导向

| 项目 | 规格及作用 | 数量 | 预算单价 ¥ | 小计 ¥ | 依据 |
|---|---|---:|---:|---:|---|
| T8 丝杆与螺母 | 直径 8、**单头、实际导程 2 mm/转**、长 200，铜螺母 | 1 | 18 | 18 | 估 |
| 联轴器 | 5 mm 电机轴至 8 mm 丝杆 | 1 | 4 | 4 | 旧 |
| 丝杆顶端轴承座 | KFL08 | 1 | 4 | 4 | 估 |
| 光轴 | Φ8×270，升降导向 | 2 | 8 | 16 | 估 |
| 光轴支座 | SHF8，孔距 32，上下各 2；以实物复尺 | 4 | 3 | 12 | 旧估 |
| 加长直线轴承 | LM8LUU（或每轴 2 个 LM8UU） | 2 | 6 | 12 | 估 |
| 旋转支承 | 5 mm 法兰联轴器 + 3 寸方形转盘轴承 | 1 | 20 | 20 | 旧估 |
| 转运导轨 | MGN7C，长 170，含 1 个滑块 | 1 | 30 | 30 | 估 |
| 转运皮带 | GT2 6 mm 皮带 1 m、16 齿带轮 1、惰轮 2 | 1 | 20 | 20 | 估 |

### 结构件（大多为网购定制件）

| 项目 | 规格及作用 | 数量 | 预算单价 ¥ | 小计 ¥ | 依据 |
|---|---|---:|---:|---:|---|
| 2020 型材 | 商家按长度切割，见下方下料表 | 7.4 m | 11.40 | 84.36 | 旧单价 |
| 角码、T 螺母、M4/M5 螺钉 | 一批，按装配图复核数量 | 1 批 | 50 | 50 | 估 |
| 底板 | 520×520×6 椴木板或亚克力，激光切割 | 1 | 40 | 40 | 估 |
| 一层甲板（P05R） | 500×500×5 亚克力，激光切出 R102 井孔、销槽、臂槽 | 1 | 45 | 45 | 估 |
| 顶板 | 500×500×5 亚克力；支座孔位按实物复尺 | 1 | 30 | 30 | 旧估 |
| 升降平台 | 5 mm 铝板 CNC，中心盘 + 3 条 10 宽 × 20 高竖立支撑臂 | 1 | 60 | 60 | 估 |
| 转运台底板及支撑条 | P03E：至少 183×96×3 毛坯；另需支撑条，材质与加工待确认 | 1 | 30 | 30 | 旧估 |
| 托盘（P01N） | 125×60×3 亚克力，内端 C10；定位销距内端 7 mm，含 Φ4 定位销和磁铁；7 块 + 1 块备用 | 8 | 5 | 40 | 估 |
| 3D 打印件 | 拨叉、电机座、挡车件、端挡、传感器座 | 1 批 | 60 | 60 | 估 |
| 低摩擦面 | PTFE 胶带及侧导条 | 1 | 15 | 15 | 估 |

### 检测、电源与安全回路

| 项目 | 规格及作用 | 数量 | 预算单价 ¥ | 小计 ¥ | 依据 |
|---|---|---:|---:|---:|---|
| 5 V 数字霍尔模块 | 非锁存数字开关型，只用 DO；一层 8 个（含 DOCK）+ 转运台 1 + 旋转原点 1 | 10 | 4 | 40 | 旧估 |
| 微动开关 | Z 上下硬限位 2 + 同位监测 2 + Z 回零 1 + 拨叉两端 2 | 7 | 0.88 | 6.16 | 旧 |
| DOCK 红外对射 | 5 V、NPN 常开、30 cm 档；车辆和手进入各 1 套 | 2 套 | 10 | 20 | 新估 |
| MCP23017 模块 | 3.3 V，插在层检测板上，一层地址 0x20 | 1 | 10.80 | 10.80 | 旧 |
| 12 V 稳压适配器 | 5 A，机内不引入市电 | 1 | 35 | 35 | 估 |
| 12→5 V 降压模块 | 3 A，供主控与屏 | 1 | 15 | 15 | 估 |
| 急停 / 继电器 / 手动复位 | 常闭急停、继电器自保持、复位按钮 | 1 套 | 60 | 60 | 估 |
| 保险丝、去耦与端子 | 含驱动附近储能电容 | 1 批 | 30 | 30 | 估 |
| 拖链、线材与连接器 | 升降平台竖向拖链、一层 4 芯总线线和 2 芯传感器 5 V 线 | 1 批 | 35 | 35 | 估 |
| 自制转接 PCB | 主转接板 1、副转接板 1、层检测板 1 的打样，含排母和带壳接插件 | 1 批 | 60 | 60 | 新估 |
| 车位指示 LED | 每个车位 1 个，由层检测板的 MCP23017 驱动，须加限流 | 8 | 0.5 | 4 | 估 |

**一层样机合计：约 ¥1,293.32**；加 15% 机动费约 ¥1,487。

## 第二批：第二层扩展包

第二层是无源层模块，没有电机，只有甲板、结构件、托盘和传感器。DOCK 正上方不设车位，所以本层 7 个车位。

| 项目 | 规格及作用 | 数量 | 预算单价 ¥ | 小计 ¥ | 依据 |
|---|---|---:|---:|---:|---|
| 二层甲板（P06R） | 500×500×5 亚克力，R102 井孔，含前侧 ±38 DOCK 竖井缺口 | 1 | 45 | 45 | 估 |
| 2020 型材 | 3 根环梁 + 4 根斜撑（前环梁取消） | 2.1 m | 11.40 | 23.94 | 旧单价 |
| 角码与紧固件 | 一批 | 1 批 | 15 | 15 | 估 |
| 托盘 | 125×60×3，同一层规格 | 7 | 5 | 35 | 估 |
| 5 V 数字霍尔模块 | 每个车位 1 个，输出在层检测板处理到 3.3 V 后进 MCP | 7 | 4 | 28 | 旧估 |
| MCP23017 模块 | 地址 0x21 | 1 | 10.80 | 10.80 | 旧 |
| 车位指示 LED | 每个车位 1 个 | 7 | 0.5 | 3.5 | 估 |
| 层间连接线 | 3.3 V/GND/SDA/SCL 四芯线 + 5 V/GND 两芯传感器供电线 | 1 批 | 10 | 10 | 新估 |
| 层检测板 | 与一层相同的 PCB 1 块，含排母和接插件 | 1 | 15 | 15 | 新估 |

**第二层扩展包合计：约 ¥186.24**。两层整机约 ¥1,480，加 15% 机动费约 ¥1,701。

与 v2（约 ¥4,115）相比，主要省在：不再需要每层 X/Y 移盘机构（4 台步进、6 根导轨、2 台约 ¥650 的直线执行器）、抱闸电机（约 ¥400）和跨缝滚筒组。

## 2020 型材下料

请商家按以下长度切割。端面连接方式（角码或端面攻丝）应在装配图里确定后再下单。

| 用途 | 长度 mm | 第一批 | 第二批 |
|---|---:|---:|---:|
| 四角立柱 | 270 | 4 | — |
| 底框环梁 | 460 | 4 | — |
| 顶框环梁 | 460 | 4 | — |
| 一层环梁 | 460 | 4 | — |
| 二层环梁（无前梁） | 460 | — | 3 |
| 甲板下斜撑（对角，r 140…322） | 180 | 4 | 4 |
| **合计** | | **7,320** | **2,100** |

下单时另加约 1% 切割余量，即表中的 7.4 m / 2.1 m。

## 旧物复用

- 可考虑复用：星火一号、TJC 屏、2 台 42 步进（升降、旋转）、TMC2209 模块、5×8 联轴器、微动开关、MCP23017。以到货型号、完好和实测为准。
- 旧 100 mm MGN7 导轨不能用作转运导轨（需要 170 mm）。旧 300 mm 光轴可截短到 270 mm 使用；旧 300 mm 丝杆须先确认是单头、导程 2，确认后可截短。
- v2 清单中的抱闸电机、直线执行器、PCA9685、滚筒组，以及 v4 清单中的 A4988，都不再需要；还没下单的请取消。
