eatoughaidan5v4418-spec/-/docs/PCB生产文件_20261111/PCB2_弯针装配BOM.md

# PCB2 装配 BOM（2026-11-11）

本表供采购和手工焊接使用。U5、U6 必须按本表替换，不能照原理图或原生坐标文件中的旧名称购买 17mm 直针。原理图未修改；原生文件保留库身份，避免网表失配。

| 位号 | 数量 | 实际装配规格 / 器件 | 供应商编号 | 备注 |
|---|---:|---|---|---|
| C2 | 1 | RVT35V100M6X8 | C47023113 | 100µF / 35V，沿用原器件 |
| CN1 | 1 | PH2.0-LI-4P | C9900014055 | 沿用原器件 |
| P1 | 1 | XH2.54-4P_C9900003326 | C9900003326 | 沿用原器件 |
| U3 | 1 | 2X8PIN2.54 | C9900027095 | 沿用原器件 |
| U4 | 1 | KF301-5.0-2P | C474881 | 沿用原器件 |
| U5、U6 | 2 | **2×6，2.54mm 节距，双排公针，90°弯针，通孔焊接** | 未指定采购料号；**禁用原直针 C9900002357** | 副板水平、元件面朝上；针头朝 +X 插入星火侧口。排间距 2.54mm；有效插入长度、弯折高度与实物母座配合确认。 |
| U7 | 1 | KF301-5.0-2P | C474881 | 沿用原器件 |
| U8 | 1 | TMC2209 | 原库未提供 | TMC2209 模块/模块座沿用原装配方案，不在本轮替换范围 |

## 弯针装配核对

- U6：中心 (1815, -560) mil，顶层，90°；7 脚 (1765, -810) mil。
- U5：中心 (1815, -1460) mil，顶层，90°；7 脚 (1765, -1710) mil。
- 两个 7 脚中心距：900 mil = **22.86mm**；不能用旧图层的 23.000mm 标注替代。
- 当前针序仅适用于：副板水平、元件面朝上、90°弯针朝 +X 插入星火侧口。
- 原生坐标文件中的 U5/U6 Device、Comment 仍显示原库的直针名称；位置/角度有效，采购以本装配 BOM 覆盖。
- 上电前用万用表核对星火侧口：5/11 脚为 GND，6/12 脚为 3.3V，并与副板网络一一核对。

## 原生焊盘网络（顶视图编号）

| 座 | 1 | 2 | 3 | 4 | 5 | 6 | 7 | 8 | 9 | 10 | 11 | 12 |
|---|---|---|---|---|---|---|---|---|---|---|---|---|
| U5 | PE2 | PE5 | PE3 | PE4 | GND | V3P3_CORE | PA4 | PA7 | PA6 | PA5 | GND | V3P3_CORE |
| U6 | PF7 | PF6 | PF5 | PF4 | GND | V3P3_CORE | PD11 | PB10 | PB11 | PD12 | GND | V3P3_CORE |
