eatoughaidan5v4418-spec/-/docs/采购清单_v3.md

# 双层车库采购清单 v3（预算草案，非实时报价）

日期：2026-11-04。对应 [硬件方案 v2](硬件方案_v2.md)。按**从零采购整机**计数，不假定旧清单已购买。以下金额为规划值，不保证可按此价格买到；不含运费、加工人工、工具和税费差异。须先做单层交接验证，再决定大批量下单。

价格标记：**旧**＝仓库 2026-11-03 原清单价格或其单价延用，并非本次重新核价；**估**＝没有可比 SKU 实时报价的预算假设；**主控预算**＝原清单二手预算。型号、板卡版本、导轨长度和运费均可能改变价格。带抱闸电机示例为厂商页面的美元价格，表内人民币数仅为预算，不是换算后的报价。

## 主控、驱动和执行器

| 项目 | 规格及作用 | 数量 | 预算单价 ¥ | 小计 ¥ | 依据 |
|---|---|---:|---:|---:|---|
| 星火一号 | STM32F407，含必要下载调试接口 | 1 | 240 | 240 | 主控预算 |
| 串口屏 | TJC4827T143，4.3 寸，确认具体后缀与供电 | 1 | 43 | 43 | 旧 |
| 层内步进 | 42BL40 / NEMA17，额定相电流与驱动能力须复核 | 4 | 21 | 84 | 旧 |
| 层内驱动 | A4988 模块，带散热 | 4 | 4.29 | 17.16 | 旧 |
| 升降抱闸步进 | 42 机座，12 V 通电释放/断电抱紧；抱闸力矩目标 ≥0.2 N·m | 1 | 400 | 400 | 估；须询价 |
| 升降驱动及散热 | 选有实测热能力的 DRV8825 模块及风冷，适配所选电机 | 1 | 120 | 120 | 估；须核限流与温升 |
| 减速直流电机 | N20，12 V，约 100 rpm，滚筒用；堵转电流待确认 | 1 | 8 | 8 | 旧 |
| 直流电机驱动 | TB6612FNG 双路模块，共驱动滚筒和 2 个抓取头 | 2 | 6.82 | 13.64 | 旧 |
| 抓取头升降执行器 | 12 V、50 mm 行程，收拢长度约 102 mm，每层 1 个 | 2 | 650 | 1300 | 估；参考下方厂商型号，不是人民币报价 |

抱闸电机可参考 [42AI48-1684S-B06-12V 厂商商品页](https://www.frankhuai.com/nema-17-stepper-motor-with-12v-brake)：该页面列 12 V 抱闸、1.68 A/相、76 mm 机身和 50 美元商品价。页面未给出全部抱闸参数，确认静保持力矩、线圈电流、尺寸和交期后才能选定。DRV8825 模块承载能力依板材和散热而变，[Pololu 示例板说明](https://www.pololu.com/product/2133)不能直接套用到其他板。

抓取头几何参考 [Actuonix L12-50-50-12-S](https://www.actuonix.com/l12-50-50-12-s)：50 mm 行程、12 V、收拢孔距 102 mm，厂商页面列单价 70 美元；库存页面信息可能变化。表中每台 650 元仅是含采购余量的预算假设，非汇率换算或实际报价。低价替代品必须验证收拢/伸长尺寸、限位、负载、占空比及实际电流。

## 结构与移动机构

| 项目 | 规格及作用 | 数量 | 预算单价 ¥ | 小计 ¥ | 依据 |
|---|---|---:|---:|---:|---|
| 2020 型材 | 按下方下料估算采购 | 12 m | 11.40/m | 136.80 | 旧单价；先复核 |
| 角码、T 螺母、M4 螺钉 | 一批，按切料图复核数量 | 1 批 | 60 | 60 | 估 |
| 底板 | 约 550×300×6 木板/铝复合板；按实际外框裁切 | 1 | 45 | 45 | 估 |
| 楼层工作板 | 约 320×180×3，完整平面并支撑交接唇板 | 2 | 18 | 36 | 估 |
| 托盘 | 140×80×2 铝板，6 个；上表面定位孔，挡车件另见打印件 | 6 | 8 | 48 | 估 |
| 升降台底板 | 约 150×90×3，按滚筒支架实际开孔 | 1 | 12 | 12 | 估 |
| 低摩擦耐磨面 | 两个完整平面，不需贯通槽 | 2 | 15 | 30 | 估 |
| 定位销、横杆、挡车件等打印/机加工 | 小批样件；最终强度及材料按试验 | 1 批 | 60 | 60 | 估 |
| X 向微型导轨 | MGN7C，280 长，含滑块 | 2 套 | 45 | 90 | 估；非实时报价 |
| Y 向微型导轨 | MGN7C，150 长，含滑块 | 4 套 | 30 | 120 | 估；非实时报价 |
| GT2 齿形带及轮 | 6 mm 宽皮带约 5 m；6 个 20 齿 5 mm 孔驱动轮、6 个带轴承惰轮；滚筒用轮按实际轴径配置 | 1 批 | 80 | 80 | 估 |
| Y 联动轴及轴承 | 2 组，含 5×5 联轴器、轴承和固定座 | 2 组 | 18 | 36 | 估 |
| 抱闸 MOSFET 驱动 | 含续流及默认关断 | 1 | 8 | 8 | 估 |
| T8 丝杆与螺母 | 直径 8、**实际导程 2、单头、长约 450** | 1 套 | 22 | 22 | 估 |
| 光轴 | Φ8×500，升降用 | 2 | 12 | 24 | 估 |
| 直线轴承 | LM8UU，8×15×24 | 4 | 1.10 | 4.40 | 旧 |
| 光轴支座 | Φ8，4 个，孔距待实物 | 4 | 3 | 12 | 估 |
| 联轴器 | 电机 5 mm 轴至 8 mm 丝杆 | 1 | 4 | 4 | 旧 |
| 升降承载架 | 金属侧板、连接件，含承受悬臂力矩的安装面 | 1 批 | 60 | 60 | 估 |
| 交接滚筒组 | 4 根约 Φ12×70 滚筒、轴承、同步驱动、导向边及支架 | 1 套 | 80 | 80 | 估；需核供应及加工 |

## 检测、电源与安全回路

| 项目 | 规格及作用 | 数量 | 预算单价 ¥ | 小计 ¥ | 依据 |
|---|---|---:|---:|---:|---|
| 微动开关 | X/Y 两端 8、升降安全硬限位 2 + 独立监测 2、两组抓取头升降状态 4 | 16 | 0.88 | 14.08 | 旧；安装位置及触点容量需核 |
| 3.3 V 托盘传感 | 车位 8 + 升降台内 1；传感器及安装板 | 9 | 5 | 45 | 估 |
| 位置传感器 | 交接位置 2 + 升降工作位 3 | 5 | 5 | 25 | 估 |
| DOCK 车辆检测 | 3.3 V 兼容对射光电或同等方案 | 1 套 | 10 | 10 | 估 |
| 磁铁、定位标记 | 6 个托盘及运动位置标识，含备用 | 1 批 | 15 | 15 | 估 |
| MCP23017 模块 | 3.3 V 供电，3 个不同 I²C 地址 | 3 | 10.80 | 32.40 | 旧 |
| 12 V 稳压适配器 | 不低于 8 A，机内不引入市电 | 1 | 48 | 48 | 估；需验证与核价 |
| 12→5 V 降压模块 | 至少 3 A，供逻辑/屏，注意峰值与散热 | 1 | 15 | 15 | 估 |
| 急停/手动复位/继电器 | 常闭急停、继电器、人工复位和驱动禁止电路 | 1 套 | 80 | 80 | 估；按最终电路选型 |
| 保险丝、去耦、续流和电源端子 | 1 批，含驱动附近储能电容 | 1 批 | 40 | 40 | 估 |
| 拖链、线材和连接器 | 两层小车、升降台走线 | 1 批 | 30 | 30 | 估 |
| 转接与接线板 | 驱动座、MCP、分配接线 | 1 批 | 30 | 30 | 估 |

**表内合计：约 ¥3,578.48；增加 15% 机动费约 ¥536.77，规划约 ¥4,115。** 这只是将旧价和预算假设相加；尤其抱闸、抓取头执行器、导轨、滚筒组、加工及运费尚无对应人民币 SKU 报价，不能视为购买承诺或已核实的市场价格。

## 2020 型材初步下料核算

下表为预算和结构建模的材料量估计，连接方式、交接口缺口、端部处理及 45° 斜撑均需三维建模后重新出切料图，不得直接交付切割。

| 用途 | 长度 mm | 数量 | 合计 mm |
|---|---:|---:|---:|
| 停车区 4 根、升降支撑 2 根立柱 | 650 | 6 | 3900 |
| 底/顶 X 横梁 4、层框 X 梁 4、层框中梁 2、移动横梁 2 | 300 | 12 | 3600 |
| 停车区底/顶 Y 梁 4、两层左侧梁 2 | 180 | 6 | 1080 |
| 升降底/顶横梁 4、后侧加固 2 | 150 | 6 | 900 |
| 升降底/顶短梁 4、两层右侧分段梁 2、加固 2 | 90 | 8 | 720 |
| 框架加固件 | 200 | 4 | 800 |
| **净长度** | | **42 件** | **11,000** |

理论 12 根 1 m 型材在每刀约 3 mm 锯缝的假设下可排料；仍须留加工误差，并在下料前确认供应长度和连接方式。旧清单的 2 m 不够。

## 已有旧物时如何处理

- 可考虑复用：星火一号、TJC 屏、1 台普通 42 步进作为层内电机、A4988、1 台 N20、1 块 TB6612、LM8UU、5×8 联轴器、微动、1 块 MCP23017；均以到货型号、完好和实测为前提。
- 旧 100 mm MGN7 导轨不满足新 X/Y 行程；旧 300 mm 光轴和 300 mm 丝杆不满足本方案初选长度。不要将它们计作对应长件的替代品。
- 旧 12 V/3 A 电源不能直接认定满足新方案；PCA9685 和原齿条不在新方案必需清单中。
- 若普通步进要用于升降，必须另外设计并验证合格的断电抱闸和安装；不能把无抱闸电机直接替换表中抱闸电机。
