eatoughaidan5v4418-spec/-/docs/cad/三维装配_v4_干涉调整/打印件_STL_待实配/08_转盘法兰隔套8_打印1件.stl

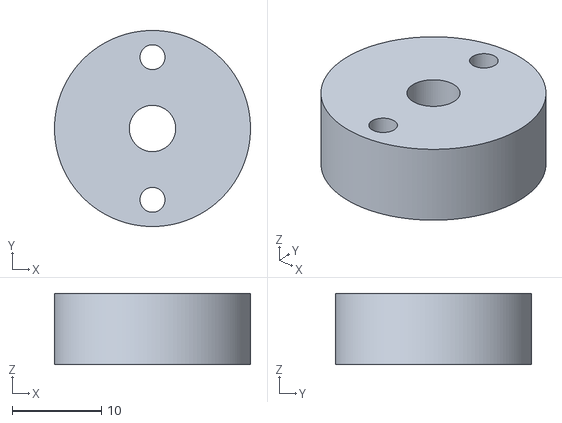
[picture p68: CAD file, 2026-11-06]
docs/cad/三维装配_v4_干涉调整/打印件_STL_待实配/08_转盘法兰隔套8_打印1件.stl
22.0 x 22.0 x 8.00
