eatoughaidan5v4418-spec/-/docs/cad/三维装配_v5_短轴方案/打印件_STL_待实配/07_KFL支承柱9_打印2件.stl

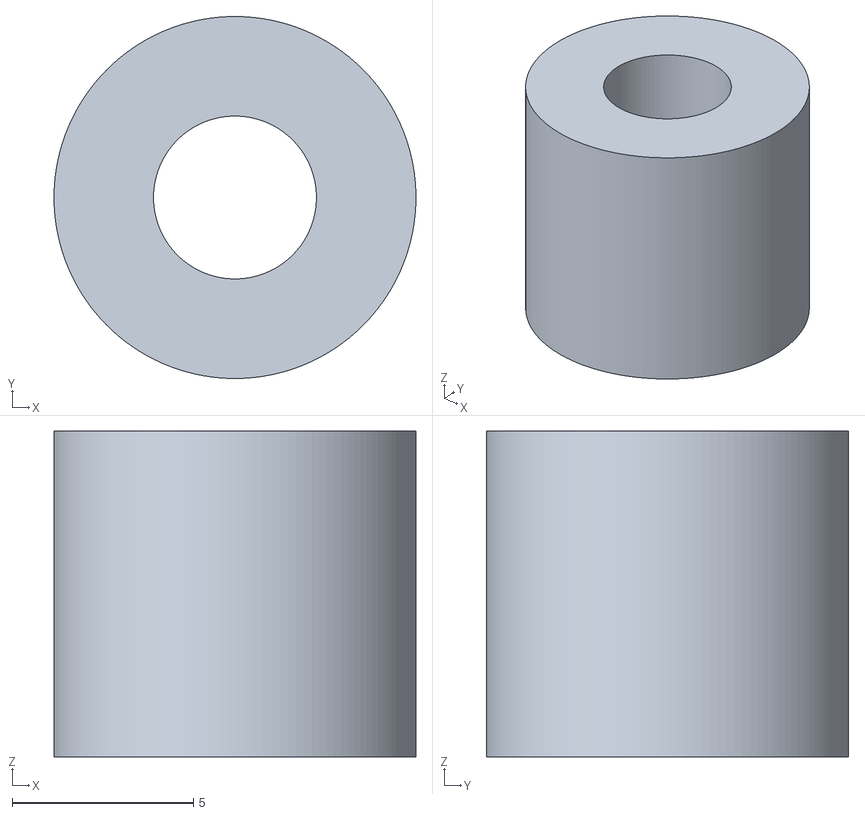
[picture p69: CAD file, 2026-11-06]
docs/cad/三维装配_v5_短轴方案/打印件_STL_待实配/07_KFL支承柱9_打印2件.stl
10.00 x 10.00 x 9.00
