eatoughaidan5v4418-spec/-/docs/cad/三维装配_v7_加厚夹带/打印件_STL_待实配/13_拨叉伸出限位座_试配.stl

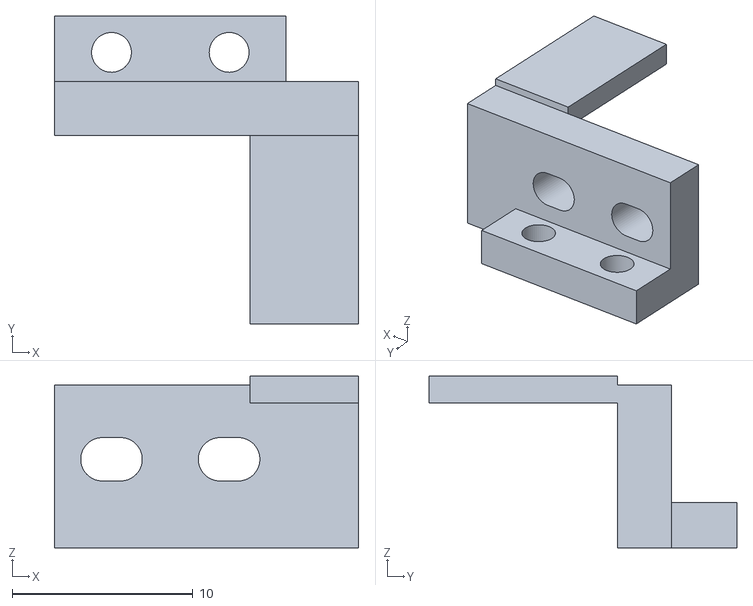
[picture p70: CAD file, 2026-11-06]
docs/cad/三维装配_v7_加厚夹带/打印件_STL_待实配/13_拨叉伸出限位座_试配.stl
16.8 x 17.0 x 9.50
