eatoughaidan5v4418-spec/-/docs/cad/三维装配_v7_走线优化安装复核/三维预览网格/part_019.stl

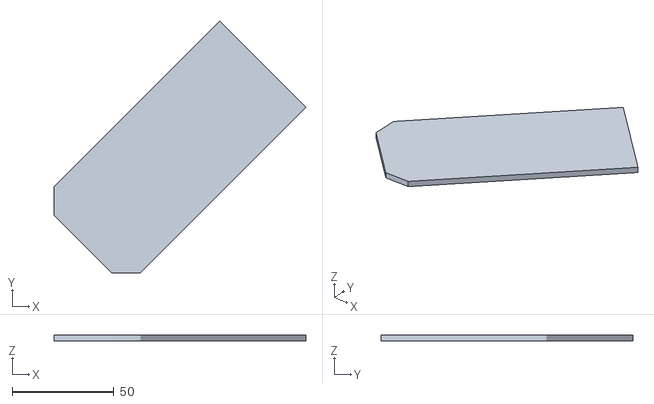
[picture p71: CAD file, 2026-11-10]
docs/cad/三维装配_v7_走线优化安装复核/三维预览网格/part_019.stl
123.7 x 123.7 x 3.00
