eatoughaidan5v4418-spec/-/docs/cad/三维装配_v7_走线优化安装复核/三维预览网格_双端R12/part_007.stl

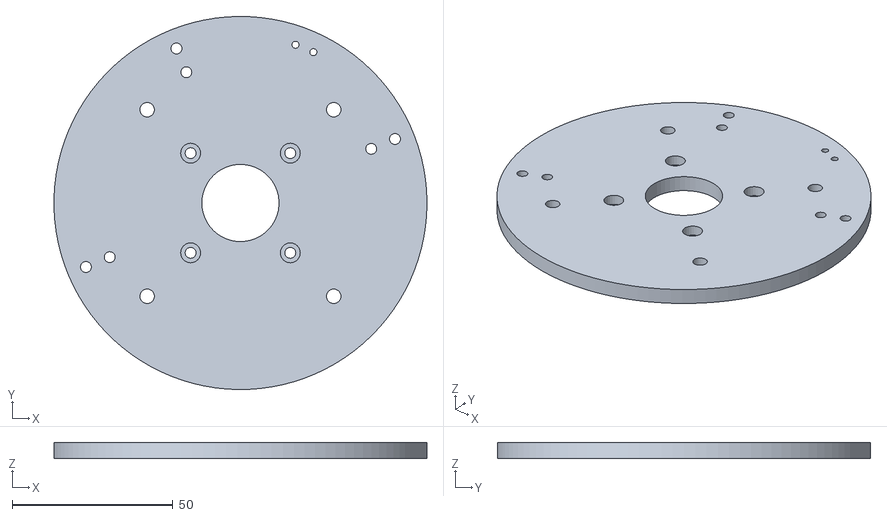
[picture p72: CAD file, 2026-11-10]
docs/cad/三维装配_v7_走线优化安装复核/三维预览网格_双端R12/part_007.stl
116.0 x 116.0 x 5.00
