eatoughaidan5v4418-spec/-/docs/cad/图纸_v3_完善版/P04_顶板.dxf

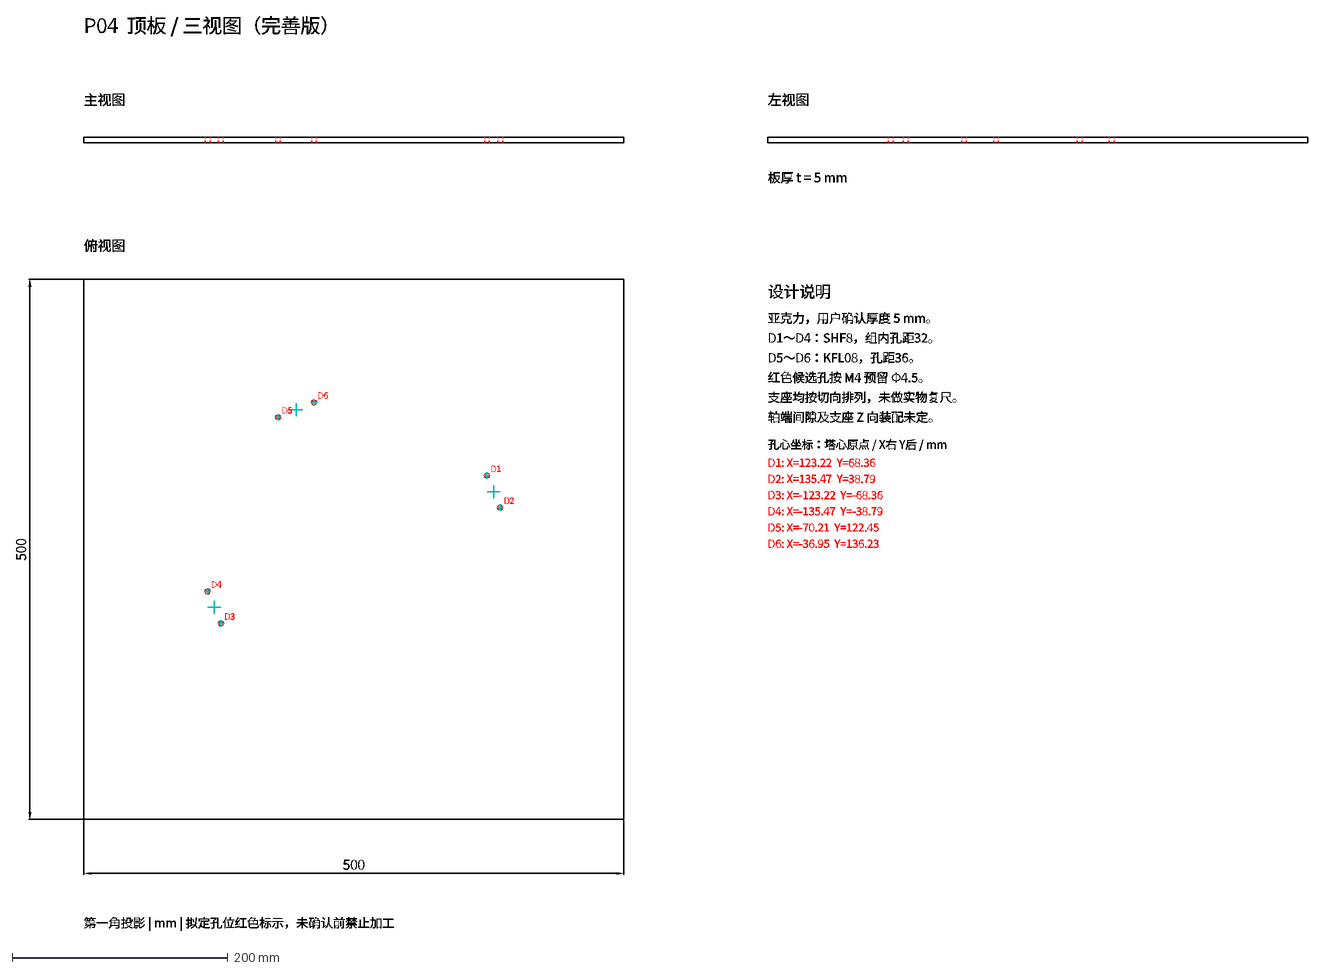
[picture p73: CAD file, 2026-11-05]
docs/cad/图纸_v3_完善版/P04_顶板.dxf
P04 顶板 / 三视图（完善版）
主视图
左视图
俯视图
500
D1
D2
D3
D4
D5
D6
板厚 t = 5 mm
设计说明
亚克力，用户确认厚度 5 mm。
D1～D4：SHF8，组内孔距32。
D5～D6：KFL08，孔距36。
红色候选孔按 M4 预留 Φ4.5。
支座均按切向排列，未做实物复尺。
轴端间隙及支座 Z 向装配未定。
孔心坐标：塔心原点 / X右 Y后 / mm
D1: X=123.22 Y=68.36
D2: X=135.47 Y=38.79
D3: X=-123.22 Y=-68.36
D4: X=-135.47 Y=-38.79
D5: X=-70.21 Y=122.45
D6: X=-36.95 Y=136.23
第一角投影 | mm | 拟定孔位红色标示，未确认前禁止加工
