eatoughaidan5v4418-spec/-/docs/cad/图纸_v3_完善版/托盘空白板轮廓/P01_托盘空白板_无孔轮廓.dxf

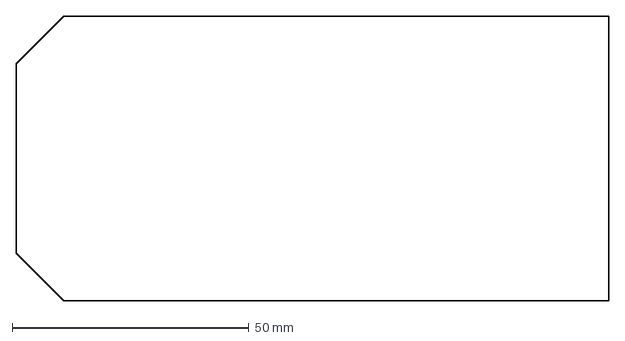
[picture p74: CAD file, 2026-11-05]
docs/cad/图纸_v3_完善版/托盘空白板轮廓/P01_托盘空白板_无孔轮廓.dxf
125.0 x 60.0 mm
