eatoughaidan5v4418-spec/-/docs/cad/图纸_v3_草案/P04_顶板.dxf

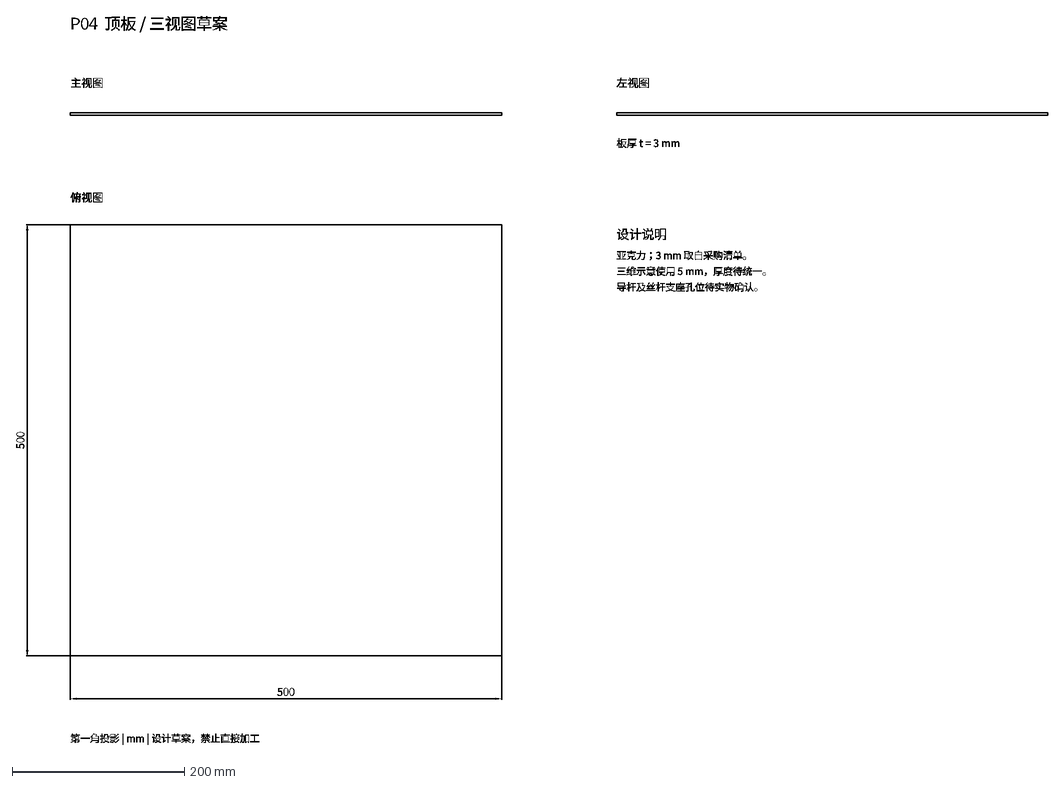
[picture p75: CAD file, 2026-11-05]
docs/cad/图纸_v3_草案/P04_顶板.dxf
P04 顶板 / 三视图草案
主视图
左视图
俯视图
500
板厚 t = 3 mm
设计说明
亚克力；3 mm 取自采购清单。
三维示意使用 5 mm，厚度待统一。
导杆及丝杆支座孔位待实物确认。
第一角投影 | mm | 设计草案，禁止直接加工
