eatoughaidan5v4418-spec/-/docs/cad/图纸_v7_加厚夹带/A01_顶部双向止推安装_试配.dxf

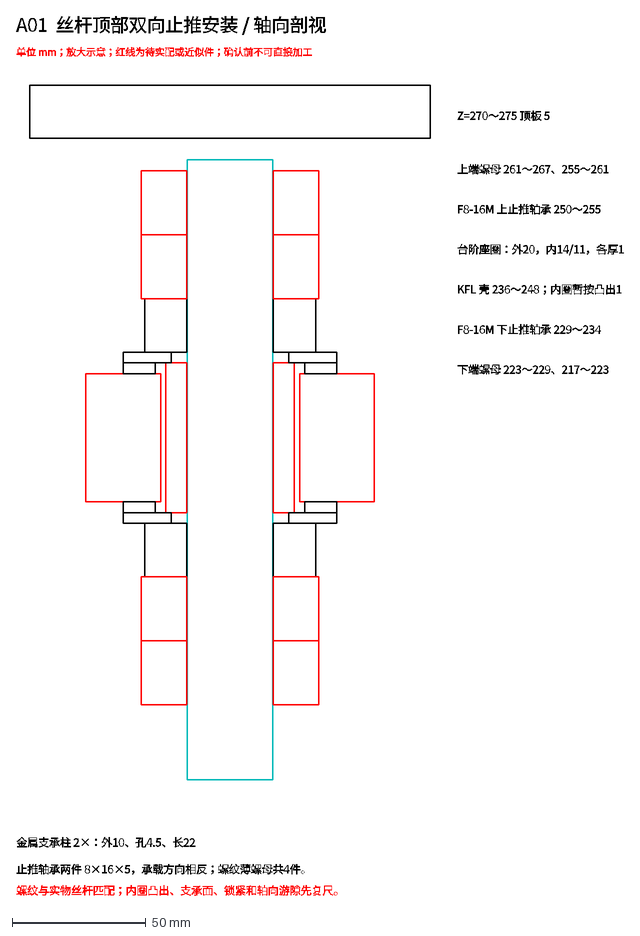
[picture p77: CAD file, 2026-11-06]
docs/cad/图纸_v7_加厚夹带/A01_顶部双向止推安装_试配.dxf
A01 丝杆顶部双向止推安装 / 轴向剖视
单位 mm；放大示意；红线为待实配或近似件；确认前不可直接加工
Z=270～275 顶板 5
上端螺母 261～267、255～261
F8-16M 上止推轴承 250～255
台阶座圈：外20，内14/11，各厚1
KFL 壳 236～248；内圈暂按凸出1
F8-16M 下止推轴承 229～234
下端螺母 223～229、217～223
金属支承柱 2×：外10、孔4.5、长22
止推轴承两件 8×16×5，承载方向相反；螺纹薄螺母共4件。
螺纹与实物丝杆匹配；内圈凸出、支承面、锁紧和轴向游隙先复尺。
