eatoughaidan5v4418-spec/-/docs/cad/三维装配_v4_干涉调整/打印件_STL_待实配/06_转运电机隔柱17_打印3件.stl

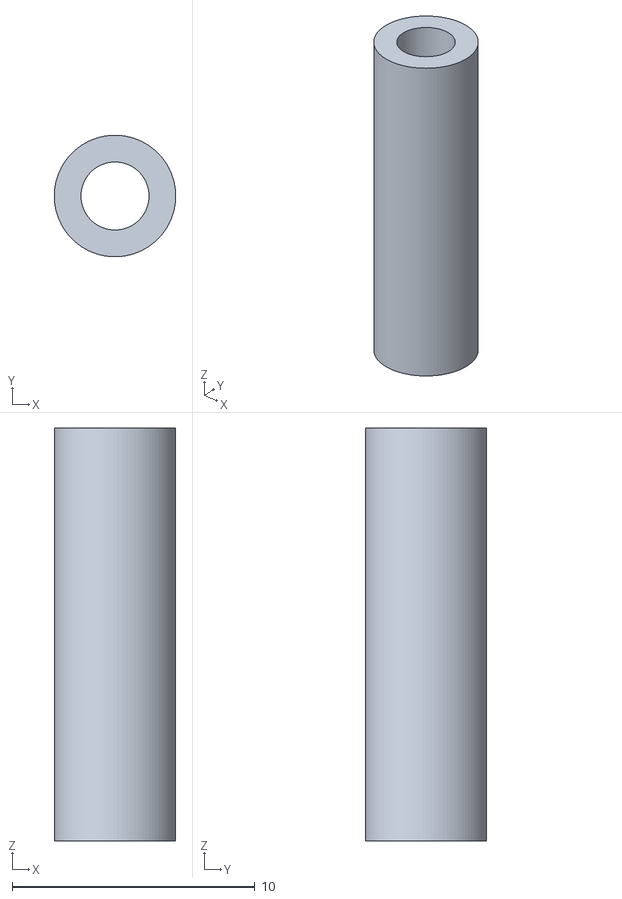
[picture p78: CAD file, 2026-11-06]
docs/cad/三维装配_v4_干涉调整/打印件_STL_待实配/06_转运电机隔柱17_打印3件.stl
5.00 x 5.00 x 17.0
