eatoughaidan5v4418-spec/-/docs/cad/三维装配_v5_短轴方案/打印件_STL_待实配/09_拨叉及皮带夹槽_概念试件.stl

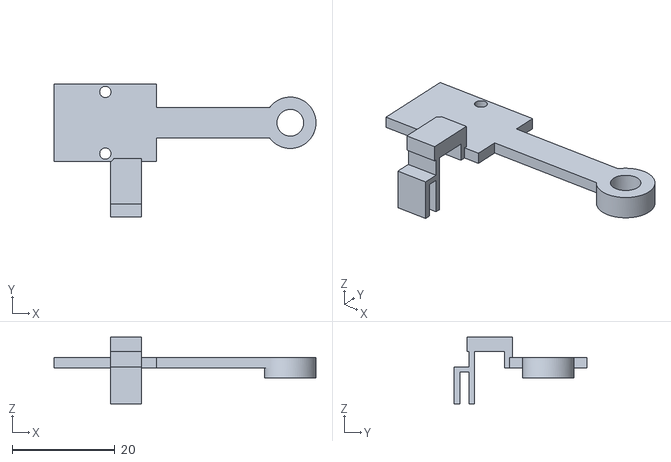
[picture p79: CAD file, 2026-11-06]
docs/cad/三维装配_v5_短轴方案/打印件_STL_待实配/09_拨叉及皮带夹槽_概念试件.stl
51.0 x 25.8 x 13.0
