eatoughaidan5v4418-spec/-/docs/cad/三维装配_v7_加厚夹带/打印件_STL_待实配/09_拨叉及双螺钉皮带座_试配.stl

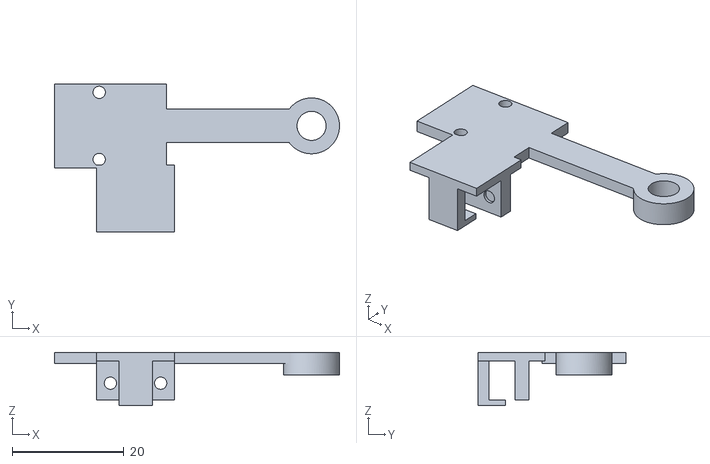
[picture p80: CAD file, 2026-11-06]
docs/cad/三维装配_v7_加厚夹带/打印件_STL_待实配/09_拨叉及双螺钉皮带座_试配.stl
51.0 x 26.5 x 9.50
