eatoughaidan5v4418-spec/-/docs/cad/三维装配_v7_走线优化安装复核/三维预览网格/part_022.stl

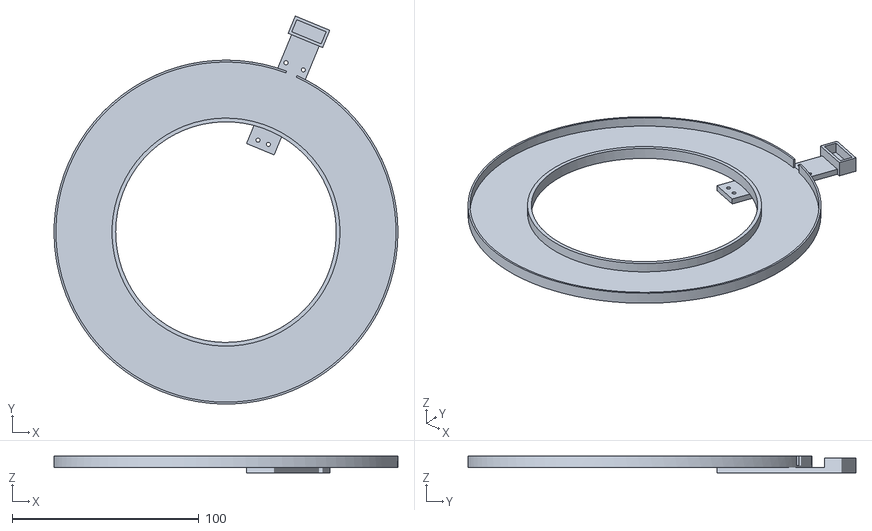
[picture p81: CAD file, 2026-11-10]
docs/cad/三维装配_v7_走线优化安装复核/三维预览网格/part_022.stl
184.0 x 207.6 x 9.00
