eatoughaidan5v4418-spec/-/docs/cad/三维装配_v7_走线优化安装复核/三维预览网格_双端R12/part_056.stl

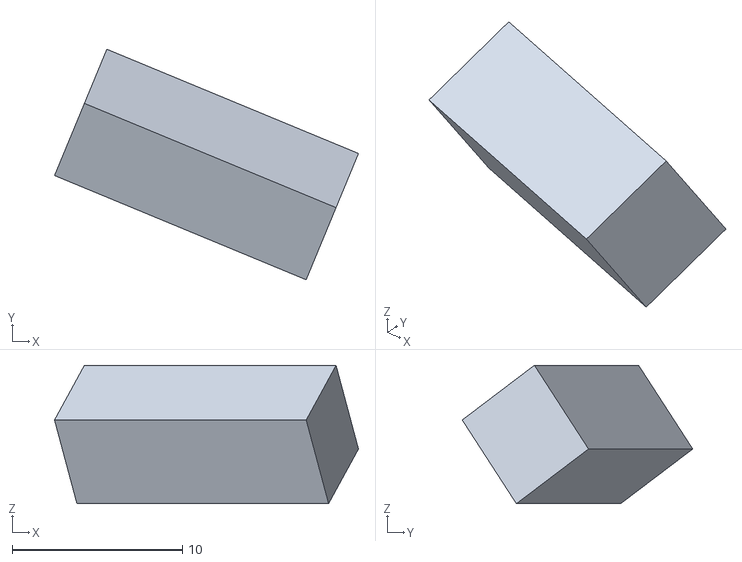
[picture p82: CAD file, 2026-11-10]
docs/cad/三维装配_v7_走线优化安装复核/三维预览网格_双端R12/part_056.stl
17.9 x 13.5 x 8.13
