eatoughaidan5v4418-spec/-/docs/cad/图纸_v3_完善版/P01_托盘板.dxf

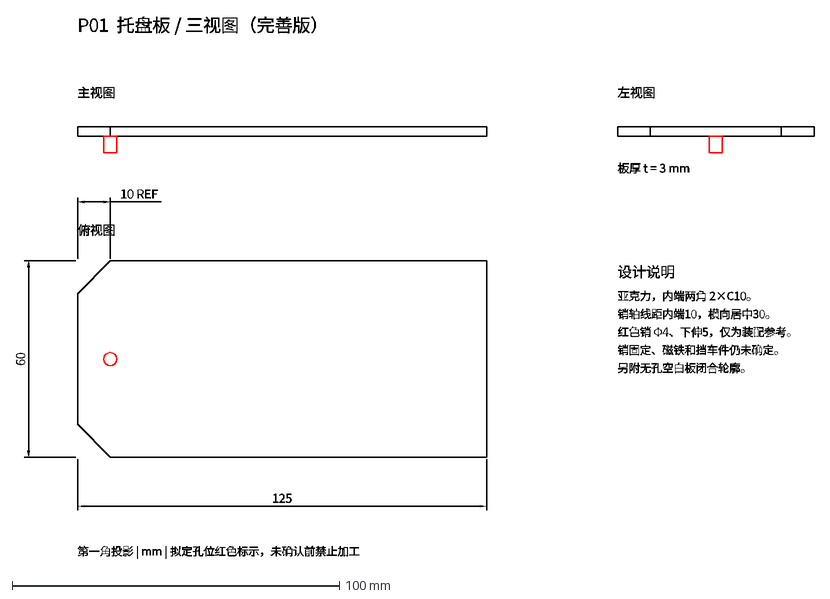
[picture p83: CAD file, 2026-11-05]
docs/cad/图纸_v3_完善版/P01_托盘板.dxf
P01 托盘板 / 三视图（完善版）
主视图
左视图
俯视图
125
60
10 REF
板厚 t = 3 mm
设计说明
亚克力，内端两角 2×C10。
销轴线距内端10，横向居中30。
红色销 Φ4、下伸5，仅为装配参考。
销固定、磁铁和挡车件仍未确定。
另附无孔空白板闭合轮廓。
第一角投影 | mm | 拟定孔位红色标示，未确认前禁止加工
