eatoughaidan5v4418-spec/-/docs/cad/图纸_v4_干涉调整/P02R_底板_中心开窗.dxf

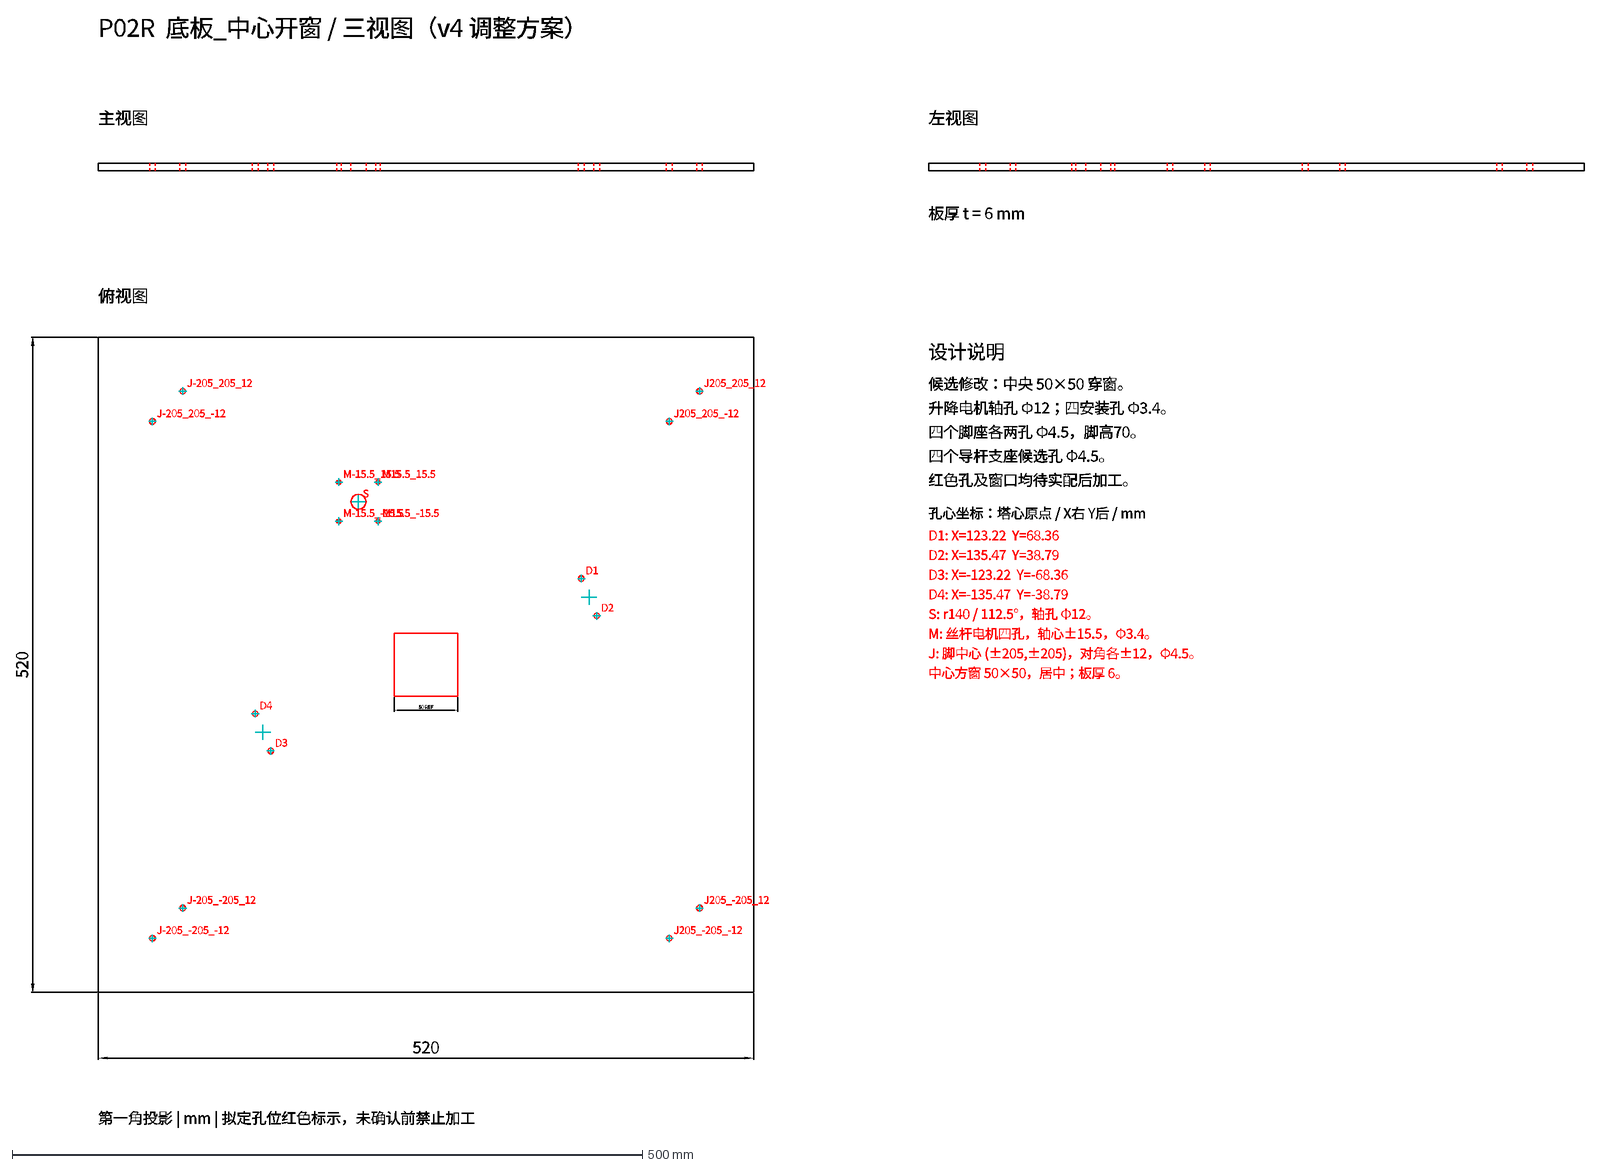
[picture p85: CAD file, 2026-11-06]
docs/cad/图纸_v4_干涉调整/P02R_底板_中心开窗.dxf
P02R 底板_中心开窗 / 三视图（v4 调整方案）
主视图
左视图
俯视图
520
D1
D2
D3
D4
50 REF
S
M-15.5_-15.5
M-15.5_15.5
M15.5_-15.5
M15.5_15.5
J-205_-205_-12
J-205_-205_12
J-205_205_-12
J-205_205_12
J205_-205_-12
J205_-205_12
J205_205_-12
J205_205_12
板厚 t = 6 mm
设计说明
候选修改：中央 50×50 穿窗。
升降电机轴孔 Φ12；四安装孔 Φ3.4。
四个脚座各两孔 Φ4.5，脚高70。
四个导杆支座候选孔 Φ4.5。
红色孔及窗口均待实配后加工。
孔心坐标：塔心原点 / X右 Y后 / mm
D1: X=123.22 Y=68.36
D2: X=135.47 Y=38.79
D3: X=-123.22 Y=-68.36
D4: X=-135.47 Y=-38.79
S: r140 / 112.5°，轴孔 Φ12。
M: 丝杆电机四孔，轴心±15.5，Φ3.4。
J: 脚中心 (±205,±205)，对角各±12，Φ4.5。
中心方窗 50×50，居中；板厚 6。
第一角投影 | mm | 拟定孔位红色标示，未确认前禁止加工
