eatoughaidan5v4418-spec/-/docs/cad/图纸_v5_短轴方案/P03C_转运板_电机安装耳.dxf

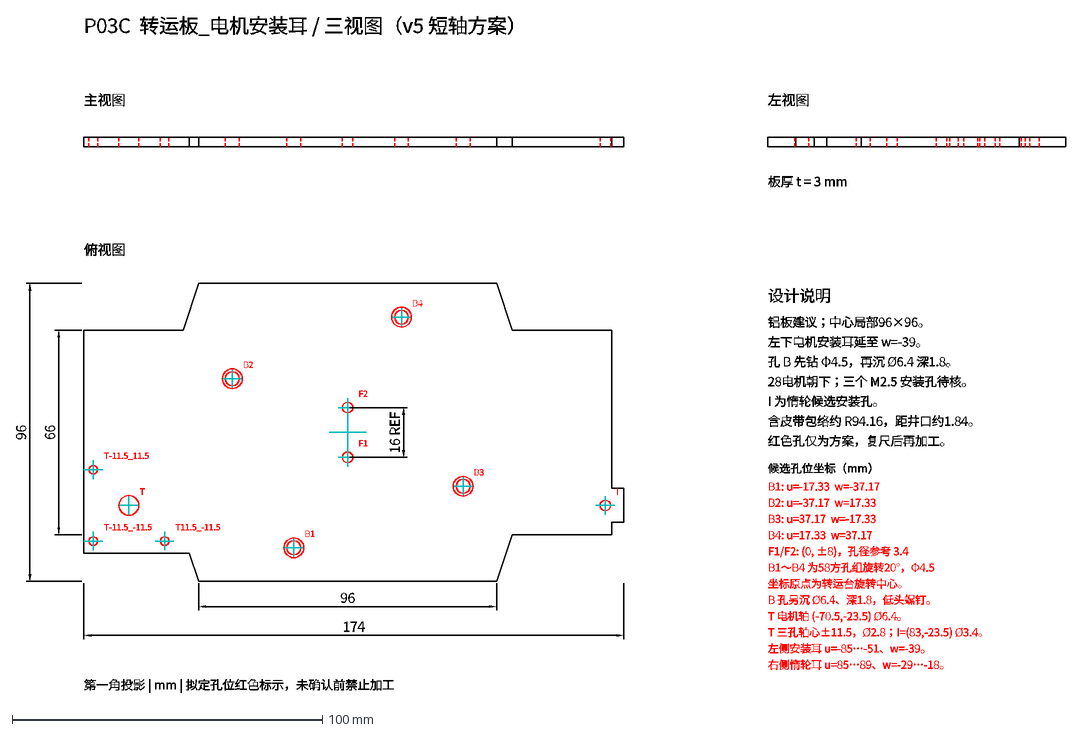
[picture p86: CAD file, 2026-11-06]
docs/cad/图纸_v5_短轴方案/P03C_转运板_电机安装耳.dxf
P03C 转运板_电机安装耳 / 三视图（v5 短轴方案）
主视图
左视图
俯视图
174
96
F1
F2
B1
B2
B3
B4
16 REF
66
T
T-11.5_-11.5
T-11.5_11.5
T11.5_-11.5
I
板厚 t = 3 mm
设计说明
铝板建议；中心局部96×96。
左下电机安装耳延至 w=-39。
孔 B 先钻 Φ4.5，再沉 Ø6.4 深1.8。
28电机朝下；三个 M2.5 安装孔待核。
I 为惰轮候选安装孔。
含皮带包络约 R94.16，距井口约1.84。
红色孔仅为方案，复尺后再加工。
候选孔位坐标（mm）
B1: u=-17.33 w=-37.17
B2: u=-37.17 w=17.33
B3: u=37.17 w=-17.33
B4: u=17.33 w=37.17
F1/F2: (0, ±8)，孔径参考 3.4
B1～B4 为58方孔组旋转20°，Φ4.5
坐标原点为转运台旋转中心。
B 孔另沉 Ø6.4、深1.8，低头螺钉。
T 电机轴 (-70.5,-23.5) Ø6.4。
T 三孔轴心±11.5，Ø2.8；I=(83,-23.5) Ø3.4。
左侧安装耳 u=-85…-51、w=-39。
右侧惰轮耳 u=85…89、w=-29…-18。
第一角投影 | mm | 拟定孔位红色标示，未确认前禁止加工
