eatoughaidan5v4418-spec/-/docs/cad/图纸_v7_加厚夹带/A02_开口皮带压夹_试配.dxf

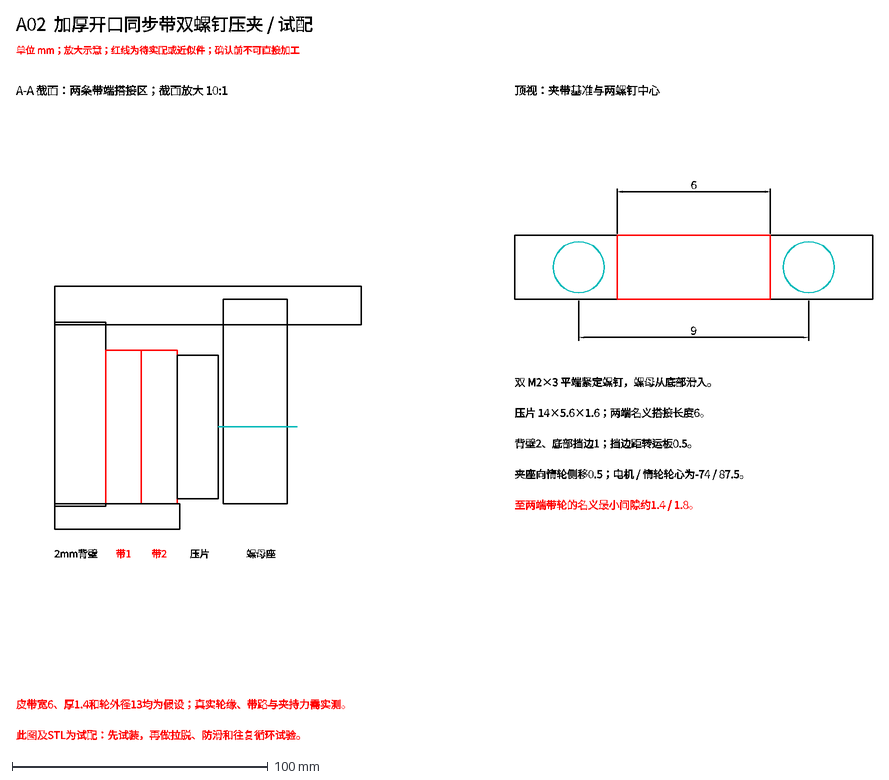
[picture p87: CAD file, 2026-11-06]
docs/cad/图纸_v7_加厚夹带/A02_开口皮带压夹_试配.dxf
A02 加厚开口同步带双螺钉压夹 / 试配
单位 mm；放大示意；红线为待实配或近似件；确认前不可直接加工
A-A 截面：两条带端搭接区；截面放大 10:1
2mm背壁
带1
带2
压片
螺母座
顶视：夹带基准与两螺钉中心
9
6
双 M2×3 平端紧定螺钉，螺母从底部滑入。
压片 14×5.6×1.6；两端名义搭接长度6。
背壁2、底部挡边1；挡边距转运板0.5。
夹座向惰轮侧移0.5；电机 / 惰轮轮心为-74 / 87.5。
至两端带轮的名义最小间隙约1.4 / 1.8。
皮带宽6、厚1.4和轮外径13均为假设；真实轮缘、带路与夹持力需实测。
此图及STL为试配：先试装，再做拉脱、防滑和往复循环试验。
