eatoughaidan5v4418-spec/-/docs/cad/三维装配_v4_干涉调整/打印件_STL_待实配/04_升降电机隔柱16_打印4件.stl

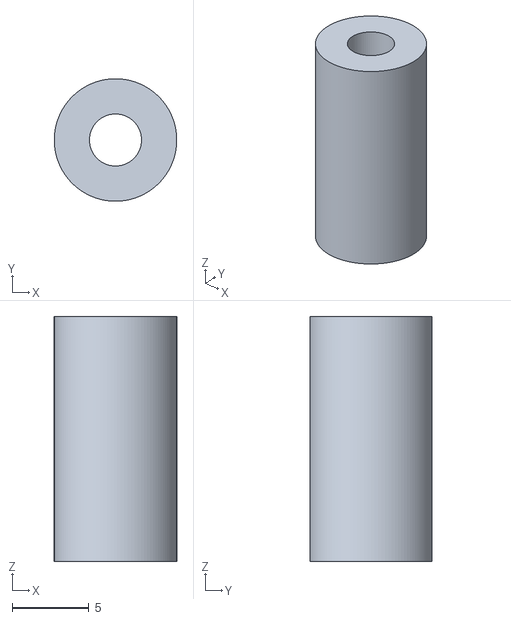
[picture p88: CAD file, 2026-11-06]
docs/cad/三维装配_v4_干涉调整/打印件_STL_待实配/04_升降电机隔柱16_打印4件.stl
8.00 x 8.00 x 16.0
