eatoughaidan5v4418-spec/-/docs/cad/三维装配_v7_走线优化安装复核/三维预览网格/part_005.stl

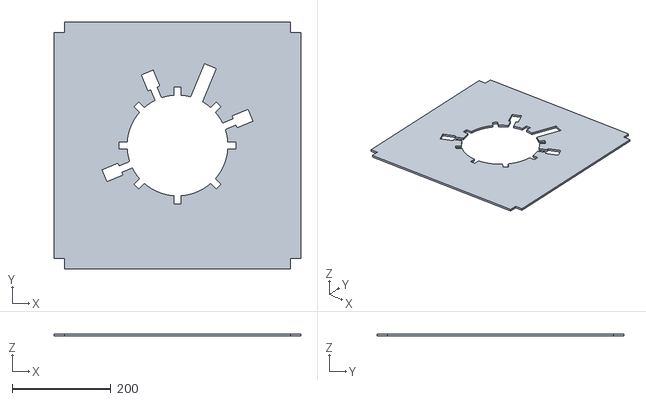
[picture p89: CAD file, 2026-11-10]
docs/cad/三维装配_v7_走线优化安装复核/三维预览网格/part_005.stl
500.0 x 500.0 x 5.00
