eatoughaidan5v4418-spec/-/docs/cad/三维装配_v7_走线优化安装复核/三维预览网格_双端R12/part_018.stl

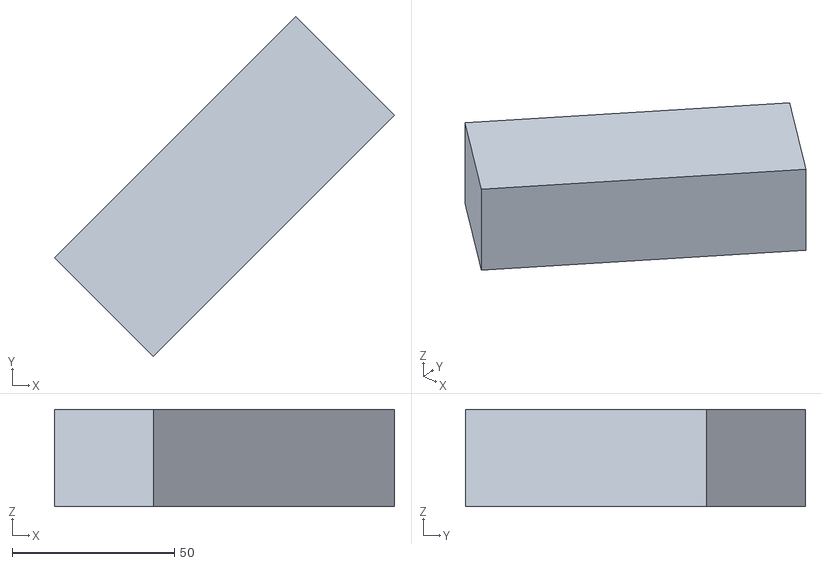
[picture p90: CAD file, 2026-11-10]
docs/cad/三维装配_v7_走线优化安装复核/三维预览网格_双端R12/part_018.stl
104.7 x 104.7 x 30.0
