eatoughaidan5v4418-spec/-/docs/cad/图纸_v3_完善版/P02_底板.dxf

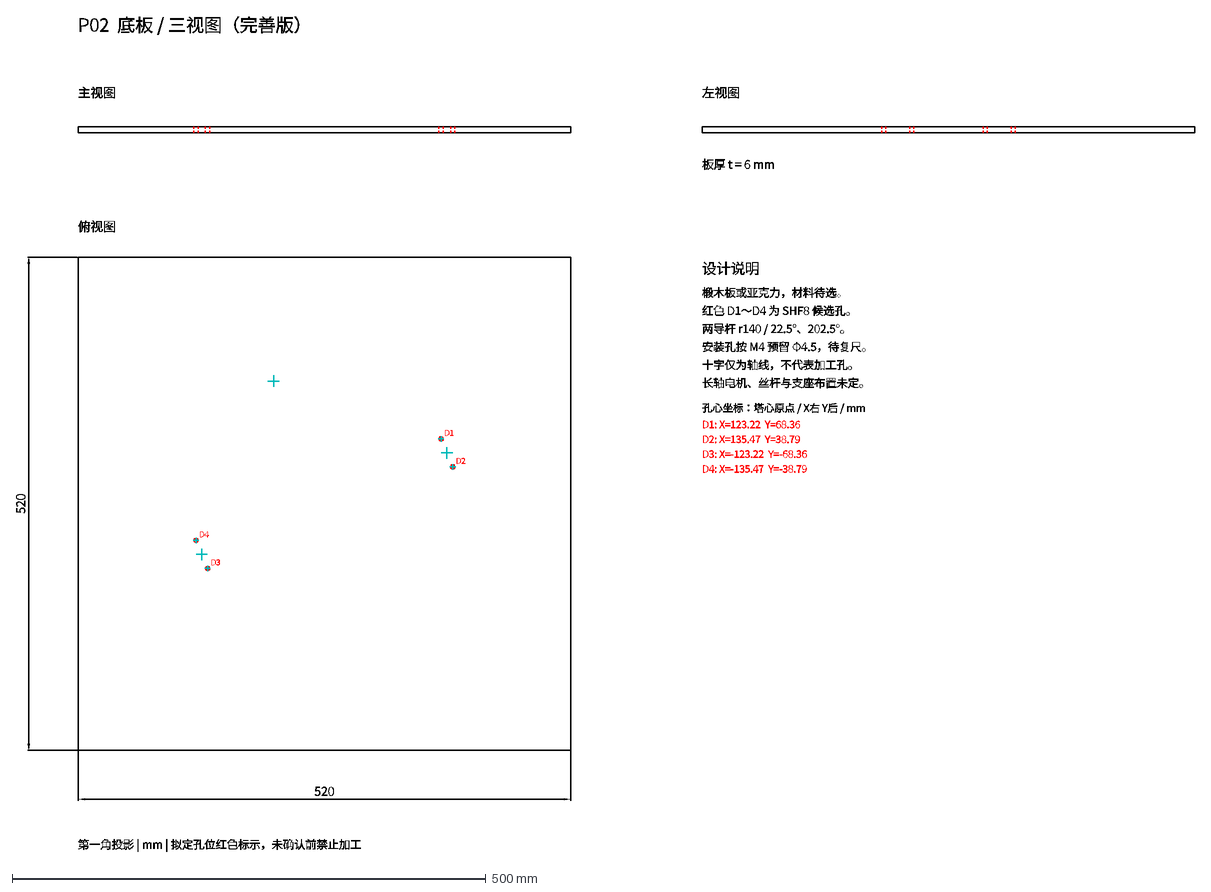
[picture p91: CAD file, 2026-11-05]
docs/cad/图纸_v3_完善版/P02_底板.dxf
P02 底板 / 三视图（完善版）
主视图
左视图
俯视图
520
D1
D2
D3
D4
板厚 t = 6 mm
设计说明
椴木板或亚克力，材料待选。
红色 D1～D4 为 SHF8 候选孔。
两导杆 r140 / 22.5°、202.5°。
安装孔按 M4 预留 Φ4.5，待复尺。
十字仅为轴线，不代表加工孔。
长轴电机、丝杆与支座布置未定。
孔心坐标：塔心原点 / X右 Y后 / mm
D1: X=123.22 Y=68.36
D2: X=135.47 Y=38.79
D3: X=-123.22 Y=-68.36
D4: X=-135.47 Y=-38.79
第一角投影 | mm | 拟定孔位红色标示，未确认前禁止加工
