eatoughaidan5v4418-spec/-/docs/cad/图纸_v3_草案/P03_转运台底板.dxf

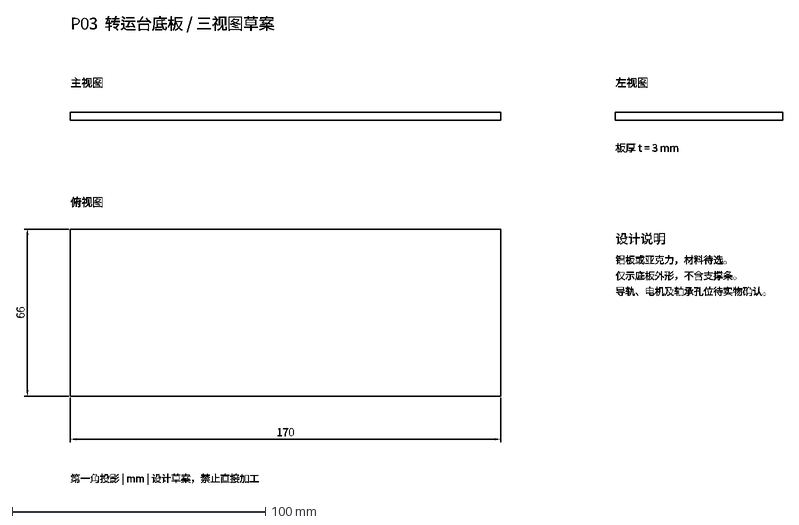
[picture p92: CAD file, 2026-11-05]
docs/cad/图纸_v3_草案/P03_转运台底板.dxf
P03 转运台底板 / 三视图草案
主视图
左视图
俯视图
170
66
板厚 t = 3 mm
设计说明
铝板或亚克力，材料待选。
仅示底板外形，不含支撑条。
导轨、电机及轴承孔位待实物确认。
第一角投影 | mm | 设计草案，禁止直接加工
