eatoughaidan5v4418-spec/-/docs/cad/图纸_v7_加厚夹带/A05_拨叉两端限位座_试配.dxf

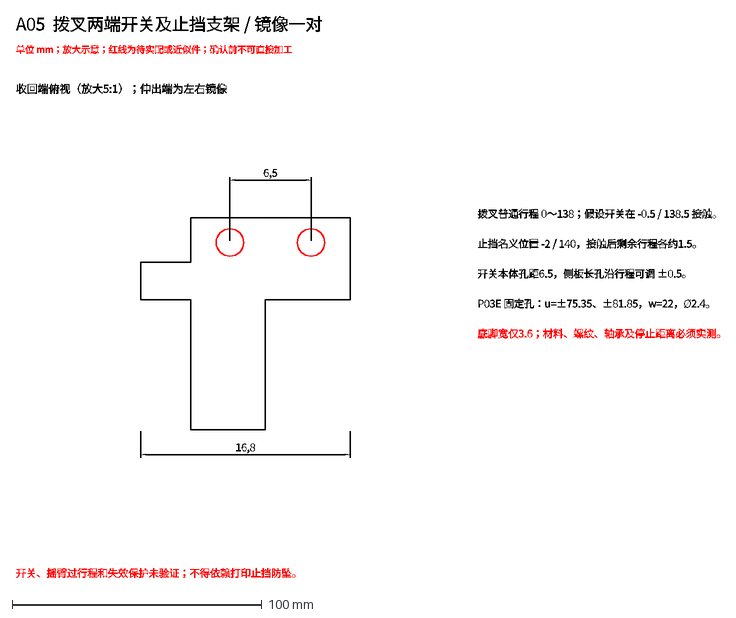
[picture p94: CAD file, 2026-11-06]
docs/cad/图纸_v7_加厚夹带/A05_拨叉两端限位座_试配.dxf
A05 拨叉两端开关及止挡支架 / 镜像一对
单位 mm；放大示意；红线为待实配或近似件；确认前不可直接加工
收回端俯视（放大5:1）；伸出端为左右镜像
6,5
16,8
拨叉普通行程 0～138；假设开关在 -0.5 / 138.5 接触。
止挡名义位置 -2 / 140，接触后剩余行程各约1.5。
开关本体孔距6.5，侧板长孔沿行程可调 ±0.5。
P03E 固定孔：u=±75.35、±81.85，w=22，Ø2.4。
底脚宽仅3.6；材料、螺纹、轴承及停止距离必须实测。
开关、摇臂过行程和失效保护未验证；不得依赖打印止挡防坠。
