eatoughaidan5v4418-spec/-/docs/cad/三维装配_v7_走线优化安装复核/三维预览网格/part_041.stl

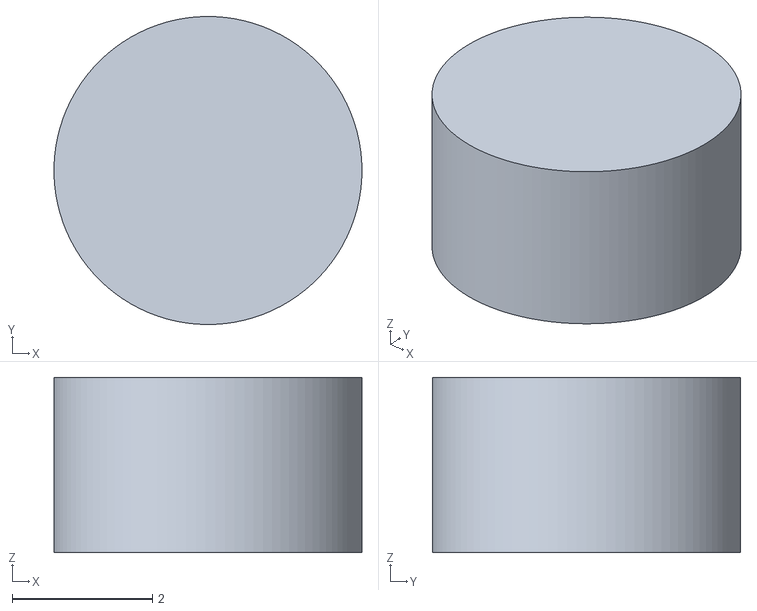
[picture p95: CAD file, 2026-11-10]
docs/cad/三维装配_v7_走线优化安装复核/三维预览网格/part_041.stl
4.40 x 4.40 x 2.50
