eatoughaidan5v4418-spec/-/docs/cad/图纸_v3_草案/P02_底板.dxf

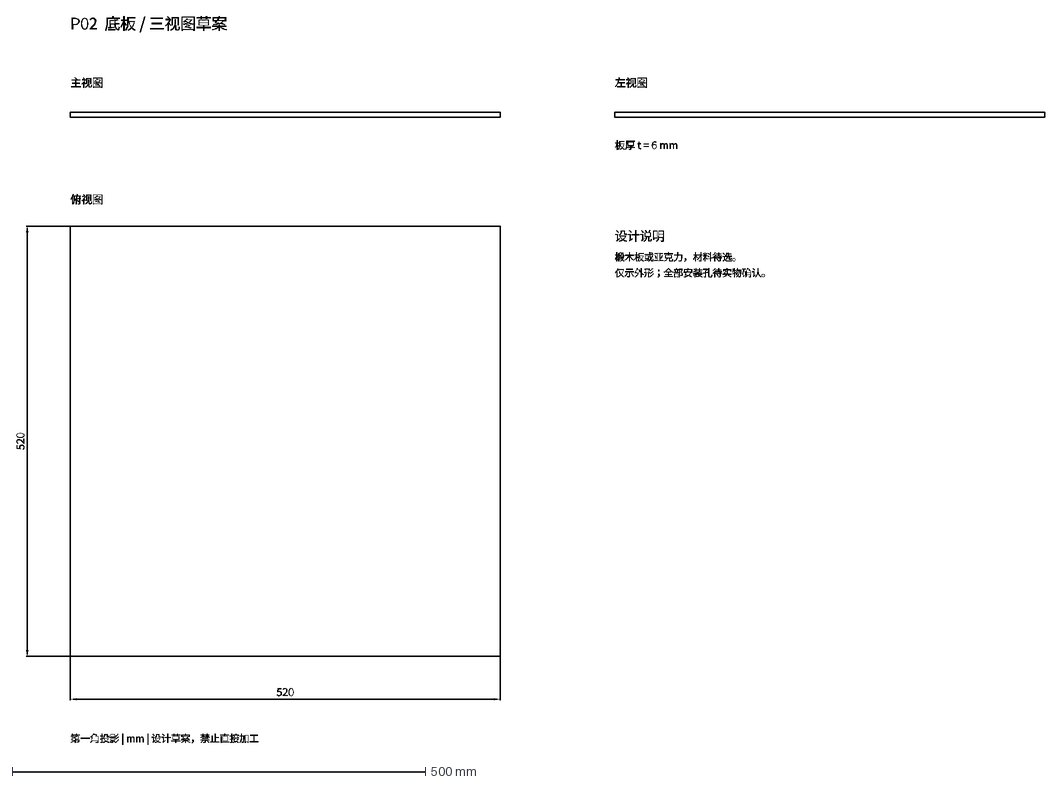
[picture p97: CAD file, 2026-11-05]
docs/cad/图纸_v3_草案/P02_底板.dxf
P02 底板 / 三视图草案
主视图
左视图
俯视图
520
板厚 t = 6 mm
设计说明
椴木板或亚克力，材料待选。
仅示外形；全部安装孔待实物确认。
第一角投影 | mm | 设计草案，禁止直接加工
