eatoughaidan5v4418-spec/-/docs/cad/图纸_v7_加厚夹带/A04_托盘支撑条_试配.dxf

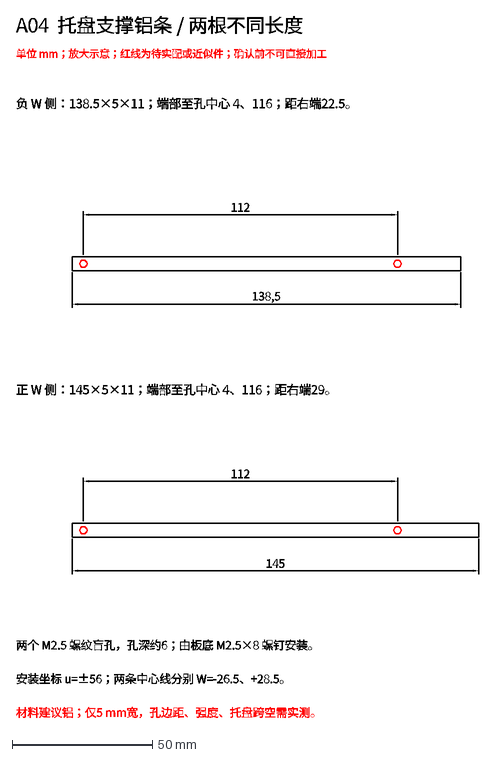
[picture p99: CAD file, 2026-11-06]
docs/cad/图纸_v7_加厚夹带/A04_托盘支撑条_试配.dxf
A04 托盘支撑铝条 / 两根不同长度
单位 mm；放大示意；红线为待实配或近似件；确认前不可直接加工
负 W 侧：138.5×5×11；端部至孔中心 4、116；距右端22.5。
138,5
112
正 W 侧：145×5×11；端部至孔中心 4、116；距右端29。
145
两个 M2.5 螺纹盲孔，孔深约6；由板底 M2.5×8 螺钉安装。
安装坐标 u=±56；两条中心线分别 W=-26.5、+28.5。
材料建议铝；仅5 mm宽，孔边距、强度、托盘跨空需实测。
