eatoughaidan5v4418-spec/-/docs/cad/三维装配_v4_干涉调整/打印件_STL_待实配/03_70高底脚_打印4件.stl

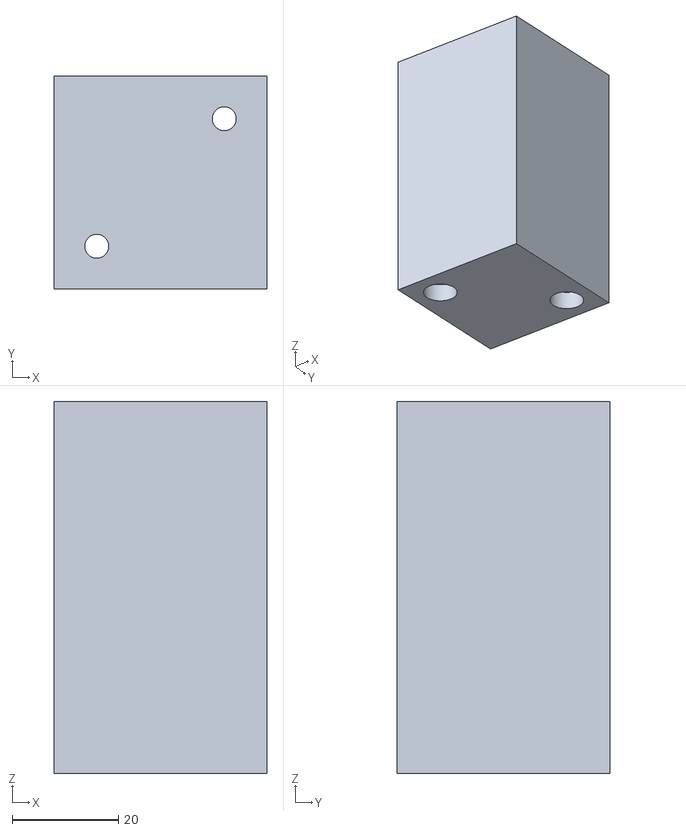
[picture p100: CAD file, 2026-11-06]
docs/cad/三维装配_v4_干涉调整/打印件_STL_待实配/03_70高底脚_打印4件.stl
40.0 x 40.0 x 70.0
