eatoughaidan5v4418-spec/-/docs/cad/三维装配_v7_走线优化安装复核/三维预览网格/part_015.stl

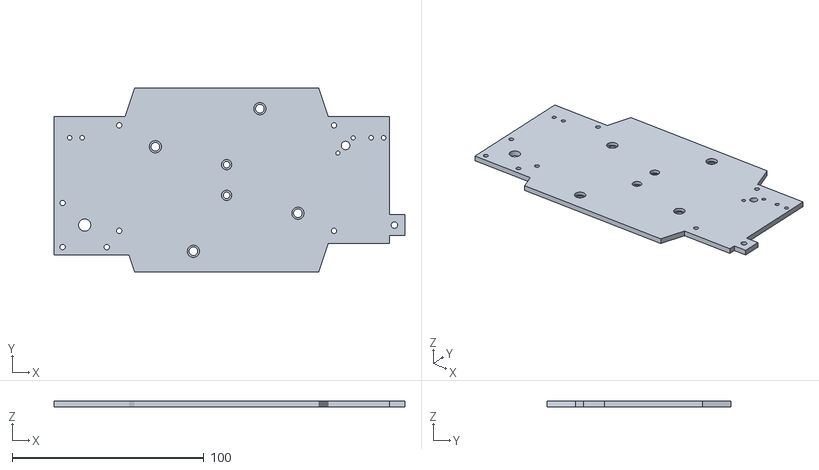
[picture p101: CAD file, 2026-11-10]
docs/cad/三维装配_v7_走线优化安装复核/三维预览网格/part_015.stl
183.0 x 96.0 x 3.00
