eatoughaidan5v4418-spec/-/docs/cad/三维装配_v7_走线优化安装复核/三维预览网格_双端R12/part_036.stl

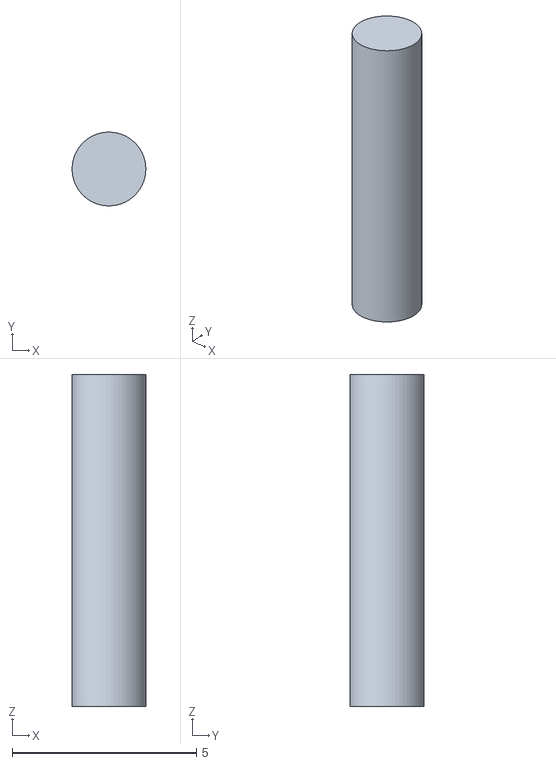
[picture p102: CAD file, 2026-11-10]
docs/cad/三维装配_v7_走线优化安装复核/三维预览网格_双端R12/part_036.stl
2.00 x 2.00 x 9.00
