eatoughaidan5v4418-spec/-/docs/cad/图纸_v3_完善版/P03B_转运台底板_局部加宽备选.dxf

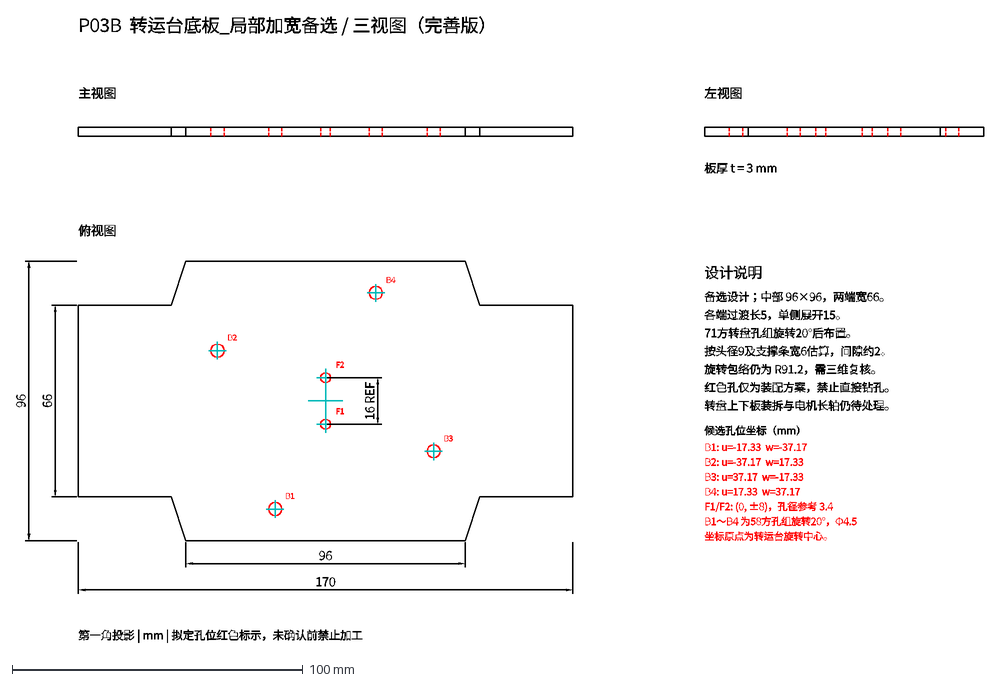
[picture p103: CAD file, 2026-11-05]
docs/cad/图纸_v3_完善版/P03B_转运台底板_局部加宽备选.dxf
P03B 转运台底板_局部加宽备选 / 三视图（完善版）
主视图
左视图
俯视图
170
96
F1
F2
B1
B2
B3
B4
16 REF
66
板厚 t = 3 mm
设计说明
备选设计；中部 96×96，两端宽66。
各端过渡长5，单侧展开15。
71方转盘孔组旋转20°后布置。
按头径9及支撑条宽6估算，间隙约2。
旋转包络仍为 R91.2，需三维复核。
红色孔仅为装配方案，禁止直接钻孔。
转盘上下板装拆与电机长轴仍待处理。
候选孔位坐标（mm）
B1: u=-17.33 w=-37.17
B2: u=-37.17 w=17.33
B3: u=37.17 w=-17.33
B4: u=17.33 w=37.17
F1/F2: (0, ±8)，孔径参考 3.4
B1～B4 为58方孔组旋转20°，Φ4.5
坐标原点为转运台旋转中心。
第一角投影 | mm | 拟定孔位红色标示，未确认前禁止加工
