eatoughaidan5v4418-spec/-/docs/cad/图纸_v3_草案/P01_托盘板.dxf

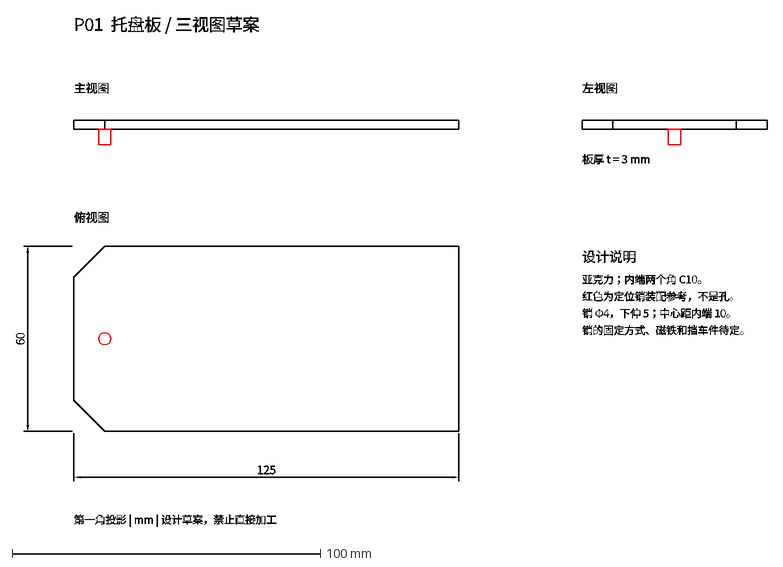
[picture p104: CAD file, 2026-11-05]
docs/cad/图纸_v3_草案/P01_托盘板.dxf
P01 托盘板 / 三视图草案
主视图
左视图
俯视图
125
60
板厚 t = 3 mm
设计说明
亚克力；内端两个角 C10。
红色为定位销装配参考，不是孔。
销 Φ4，下伸 5；中心距内端 10。
销的固定方式、磁铁和挡车件待定。
第一角投影 | mm | 设计草案，禁止直接加工
