eatoughaidan5v4418-spec/-/docs/cad/图纸_v7_加厚夹带/P03E_转运板_支撑条安装.dxf

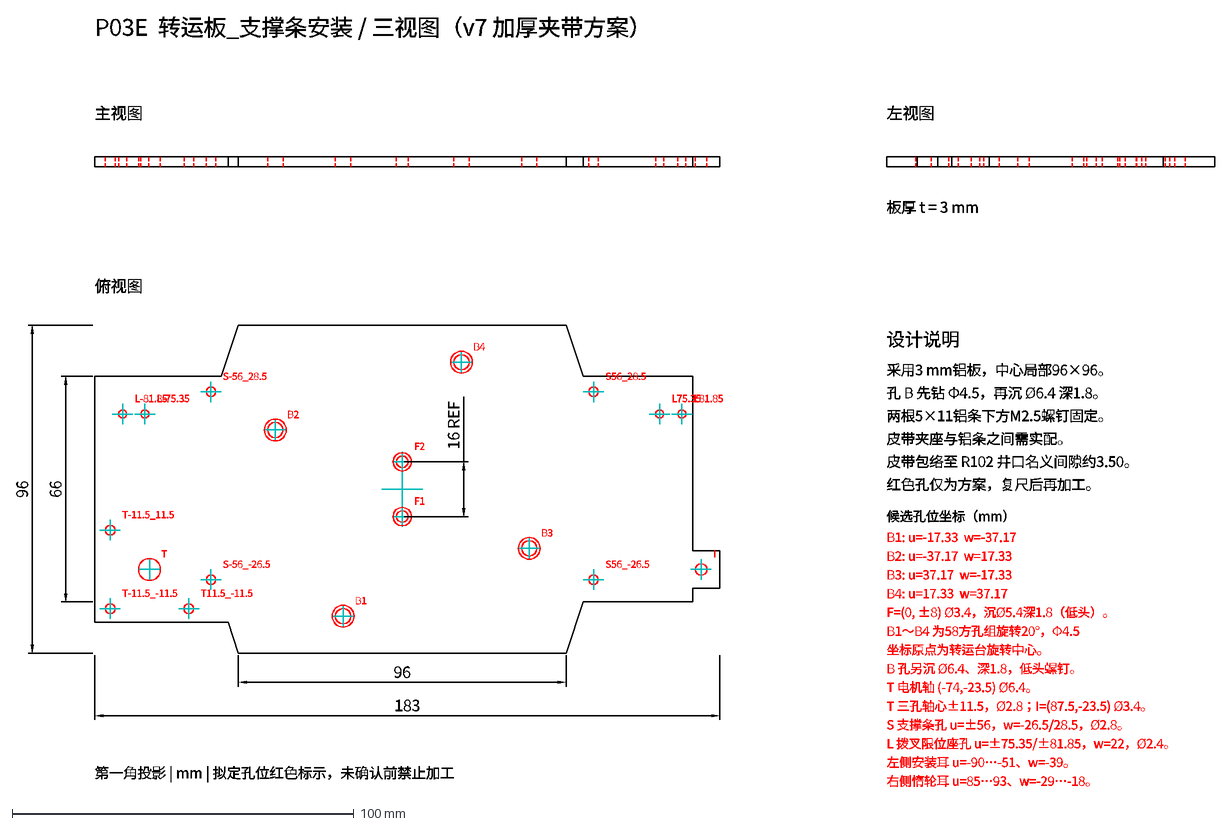
[picture p106: CAD file, 2026-11-06]
docs/cad/图纸_v7_加厚夹带/P03E_转运板_支撑条安装.dxf
P03E 转运板_支撑条安装 / 三视图（v7 加厚夹带方案）
主视图
左视图
俯视图
183
96
F1
F2
B1
B2
B3
B4
16 REF
66
T
T-11.5_-11.5
T-11.5_11.5
T11.5_-11.5
I
S-56_-26.5
S-56_28.5
S56_-26.5
S56_28.5
L-81.85
L-75.35
L75.35
L81.85
板厚 t = 3 mm
设计说明
采用3 mm铝板，中心局部96×96。
孔 B 先钻 Φ4.5，再沉 Ø6.4 深1.8。
两根5×11铝条下方M2.5螺钉固定。
皮带夹座与铝条之间需实配。
皮带包络至 R102 井口名义间隙约3.50。
红色孔仅为方案，复尺后再加工。
候选孔位坐标（mm）
B1: u=-17.33 w=-37.17
B2: u=-37.17 w=17.33
B3: u=37.17 w=-17.33
B4: u=17.33 w=37.17
F=(0, ±8) Ø3.4，沉Ø5.4深1.8（低头）。
B1～B4 为58方孔组旋转20°，Φ4.5
坐标原点为转运台旋转中心。
B 孔另沉 Ø6.4、深1.8，低头螺钉。
T 电机轴 (-74,-23.5) Ø6.4。
T 三孔轴心±11.5，Ø2.8；I=(87.5,-23.5) Ø3.4。
S 支撑条孔 u=±56，w=-26.5/28.5，Ø2.8。
L 拨叉限位座孔 u=±75.35/±81.85，w=22，Ø2.4。
左侧安装耳 u=-90…-51、w=-39。
右侧惰轮耳 u=85…93、w=-29…-18。
第一角投影 | mm | 拟定孔位红色标示，未确认前禁止加工
