eatoughaidan5v4418-spec/-/docs/cad/三维装配_v4_干涉调整/打印件_STL_待实配/02_丝杆支撑臂_打印1件.stl

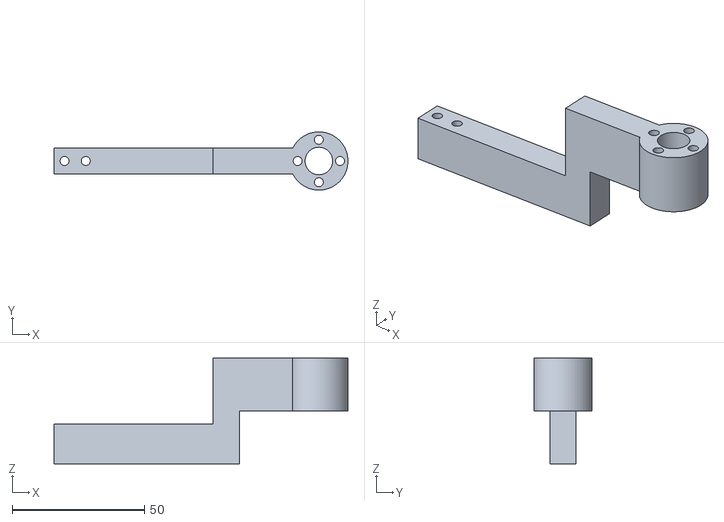
[picture p107: CAD file, 2026-11-06]
docs/cad/三维装配_v4_干涉调整/打印件_STL_待实配/02_丝杆支撑臂_打印1件.stl
111.0 x 22.0 x 40.0
