eatoughaidan5v4418-spec/-/docs/cad/三维装配_v7_加厚夹带/打印件_STL_待实配/11_上限位调节座_试配.stl

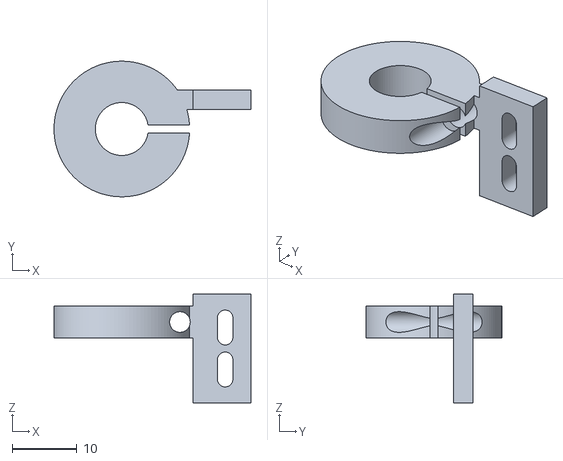
[picture p108: CAD file, 2026-11-06]
docs/cad/三维装配_v7_加厚夹带/打印件_STL_待实配/11_上限位调节座_试配.stl
30.5 x 21.0 x 16.8
