eatoughaidan5v4418-spec/-/docs/cad/图纸_v3_完善版/P03_转运台底板.dxf

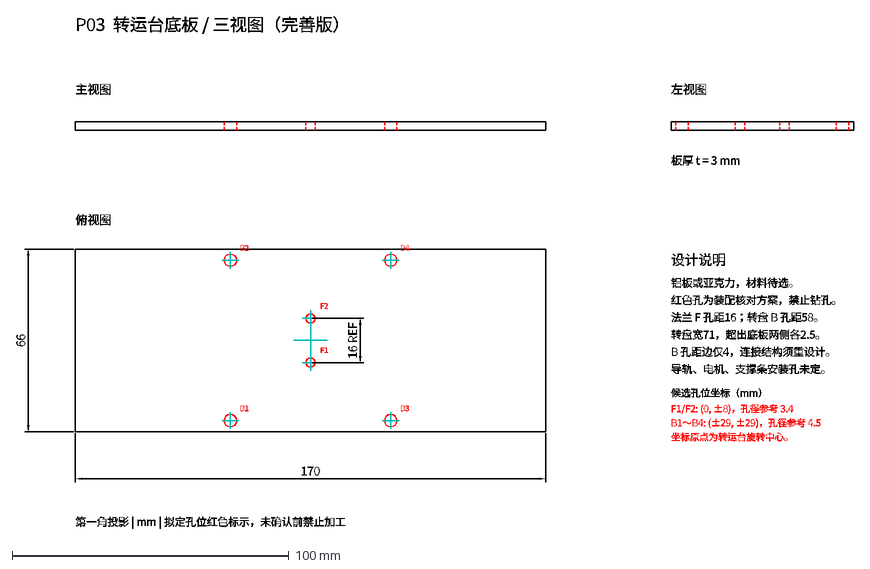
[picture p111: CAD file, 2026-11-05]
docs/cad/图纸_v3_完善版/P03_转运台底板.dxf
P03 转运台底板 / 三视图（完善版）
主视图
左视图
俯视图
170
66
F1
F2
B1
B2
B3
B4
16 REF
板厚 t = 3 mm
设计说明
铝板或亚克力，材料待选。
红色孔为装配核对方案，禁止钻孔。
法兰 F 孔距16；转盘 B 孔距58。
转盘宽71，超出底板两侧各2.5。
B 孔距边仅4，连接结构须重设计。
导轨、电机、支撑条安装孔未定。
候选孔位坐标（mm）
F1/F2: (0, ±8)，孔径参考 3.4
B1～B4: (±29, ±29)，孔径参考 4.5
坐标原点为转运台旋转中心。
第一角投影 | mm | 拟定孔位红色标示，未确认前禁止加工
