eatoughaidan5v4418-spec/-/docs/cad/图纸_v3_草案/P05_一层甲板.dxf

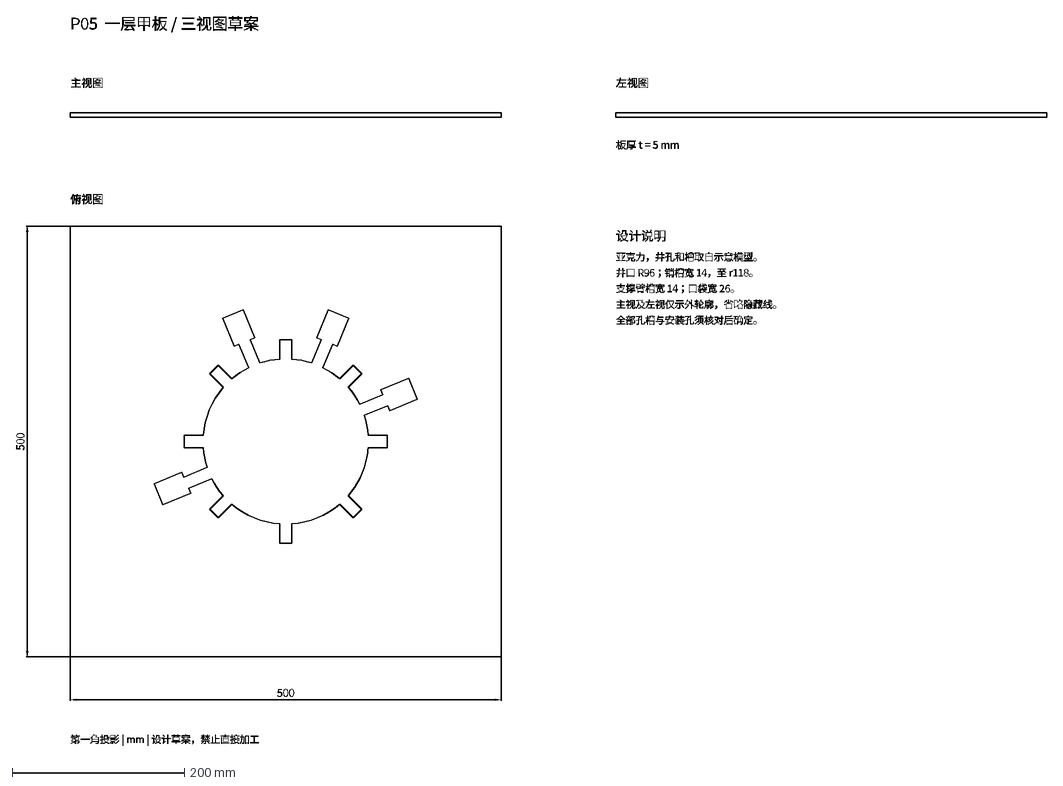
[picture p112: CAD file, 2026-11-05]
docs/cad/图纸_v3_草案/P05_一层甲板.dxf
P05 一层甲板 / 三视图草案
主视图
左视图
俯视图
500
板厚 t = 5 mm
设计说明
亚克力，井孔和槽取自示意模型。
井口 R96；销槽宽 14，至 r118。
支撑臂槽宽 14；口袋宽 26。
主视及左视仅示外轮廓，省略隐藏线。
全部孔槽与安装孔须核对后确定。
第一角投影 | mm | 设计草案，禁止直接加工
