eatoughaidan5v4418-spec/-/docs/cad/图纸_v7_加厚夹带/P01N_托盘板_新销位.dxf

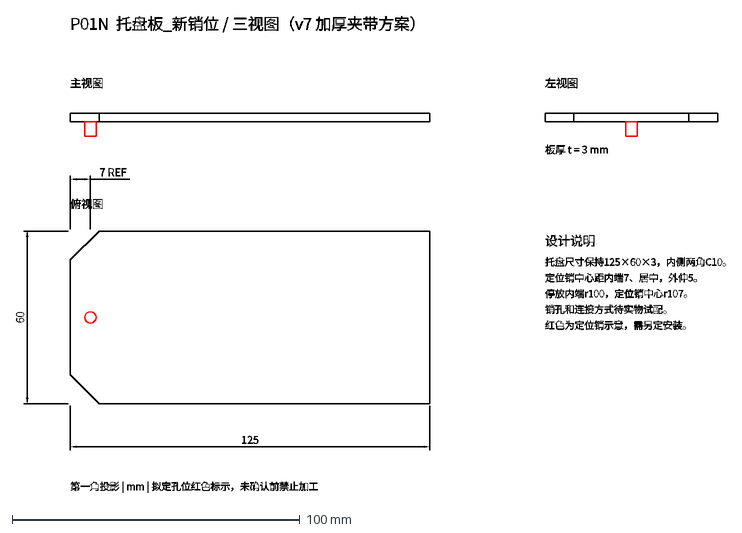
[picture p113: CAD file, 2026-11-06]
docs/cad/图纸_v7_加厚夹带/P01N_托盘板_新销位.dxf
P01N 托盘板_新销位 / 三视图（v7 加厚夹带方案）
主视图
左视图
俯视图
125
60
7 REF
板厚 t = 3 mm
设计说明
托盘尺寸保持125×60×3，内侧两角C10。
定位销中心距内端7、居中，外伸5。
停放内端r100，定位销中心r107。
销孔和连接方式待实物试配。
红色为定位销示意，需另定安装。
第一角投影 | mm | 拟定孔位红色标示，未确认前禁止加工
