eatoughaidan5v4418-spec/-/docs/cad/三维装配_v7_加厚夹带/打印件_STL_待实配/01_导杆支撑臂_打印2件.stl

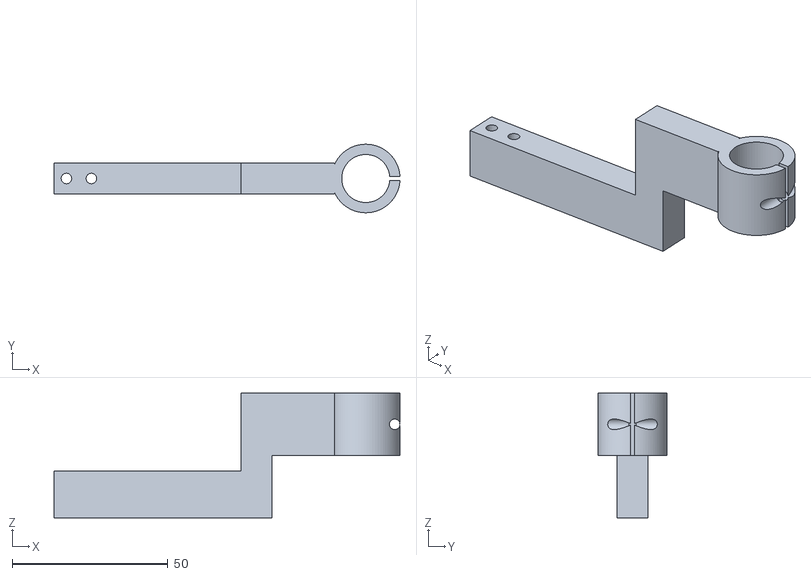
[picture p115: CAD file, 2026-11-06]
docs/cad/三维装配_v7_加厚夹带/打印件_STL_待实配/01_导杆支撑臂_打印2件.stl
111.0 x 22.0 x 40.0
