eatoughaidan5v4418-spec/-/docs/cad/图纸_v3_完善版/P05_一层甲板.dxf

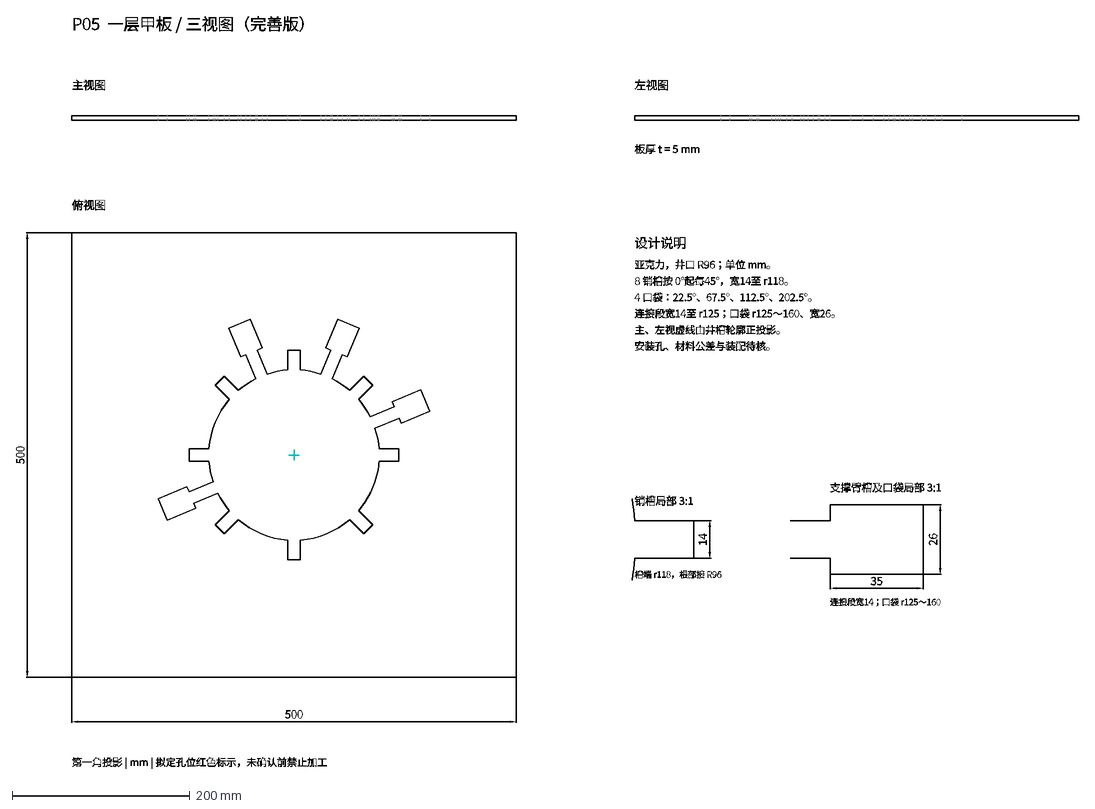
[picture p118: CAD file, 2026-11-05]
docs/cad/图纸_v3_完善版/P05_一层甲板.dxf
P05 一层甲板 / 三视图（完善版）
主视图
左视图
俯视图
500
销槽局部 3:1
14
槽端 r118，根部接 R96
支撑臂槽及口袋局部 3:1
26
35
连接段宽14；口袋 r125～160
板厚 t = 5 mm
设计说明
亚克力，井口 R96；单位 mm。
8 销槽按 0°起每45°，宽14至 r118。
4 口袋：22.5°、67.5°、112.5°、202.5°。
连接段宽14至 r125；口袋 r125～160、宽26。
主、左视虚线由井槽轮廓正投影。
安装孔、材料公差与装配待核。
第一角投影 | mm | 拟定孔位红色标示，未确认前禁止加工
