eatoughaidan5v4418-spec/-/docs/cad/图纸_v7_加厚夹带/P06R_二层甲板_四角避让.dxf

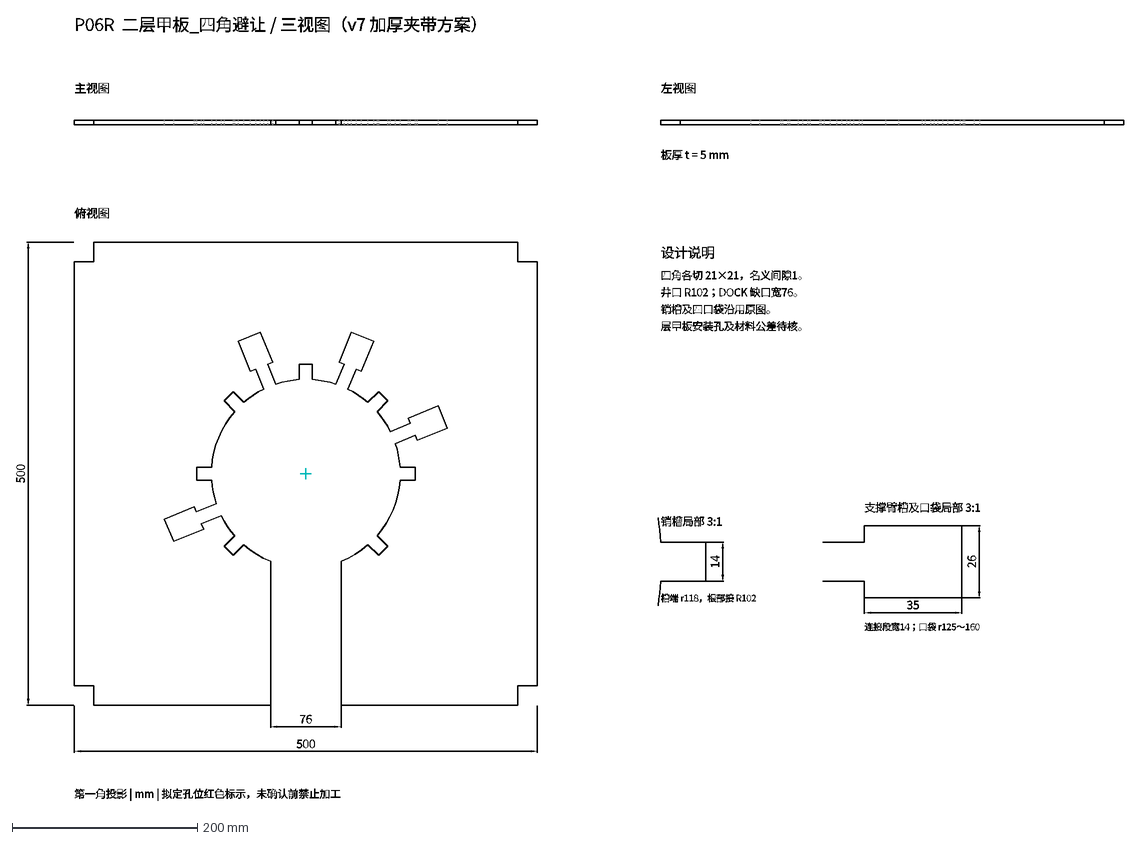
[picture p119: CAD file, 2026-11-06]
docs/cad/图纸_v7_加厚夹带/P06R_二层甲板_四角避让.dxf
P06R 二层甲板_四角避让 / 三视图（v7 加厚夹带方案）
主视图
左视图
俯视图
500
销槽局部 3:1
14
槽端 r118，根部接 R102
支撑臂槽及口袋局部 3:1
26
35
连接段宽14；口袋 r125～160
76
板厚 t = 5 mm
设计说明
四角各切 21×21，名义间隙1。
井口 R102；DOCK 缺口宽76。
销槽及四口袋沿用原图。
层甲板安装孔及材料公差待核。
第一角投影 | mm | 拟定孔位红色标示，未确认前禁止加工
