eatoughaidan5v4418-spec/-/docs/cad/三维装配_v4_干涉调整/打印件_STL_待实配/07_KFL支承柱25_打印2件.stl

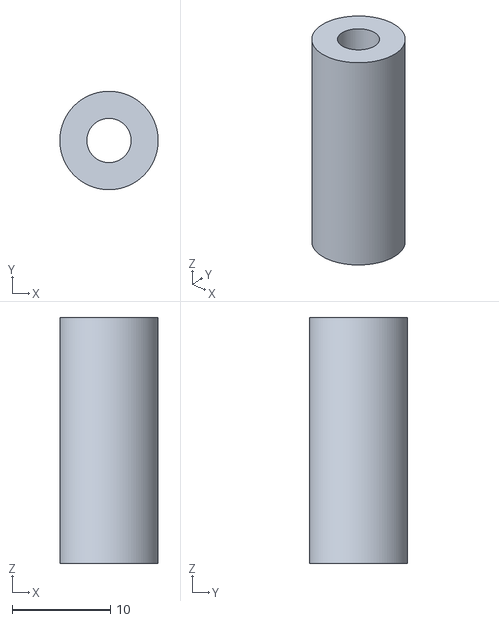
[picture p120: CAD file, 2026-11-06]
docs/cad/三维装配_v4_干涉调整/打印件_STL_待实配/07_KFL支承柱25_打印2件.stl
10.0 x 10.00 x 25.0
