eatoughaidan5v4418-spec/-/docs/cad/三维装配_v7_加厚夹带/打印件_STL_待实配/03_升降电机跨式支架_打印1件.stl

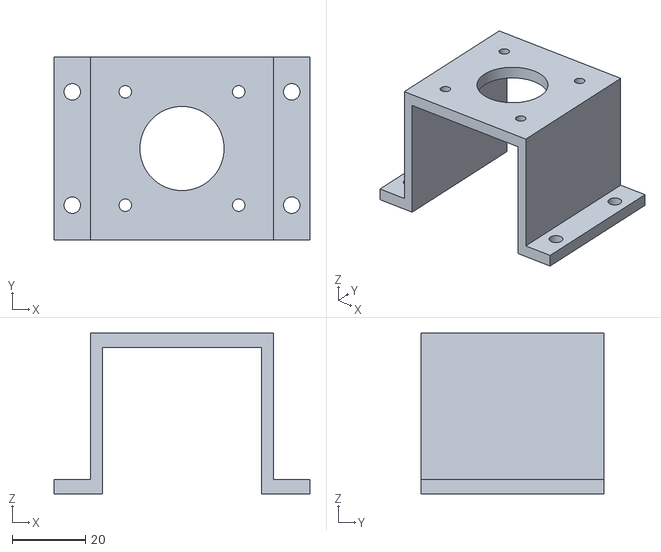
[picture p121: CAD file, 2026-11-06]
docs/cad/三维装配_v7_加厚夹带/打印件_STL_待实配/03_升降电机跨式支架_打印1件.stl
70.0 x 50.0 x 44.0
