eatoughaidan5v4418-spec/-/docs/cad/三维装配_v7_加厚夹带/打印件_STL_待实配/07_KFL支承柱22_仅试配非承载.stl

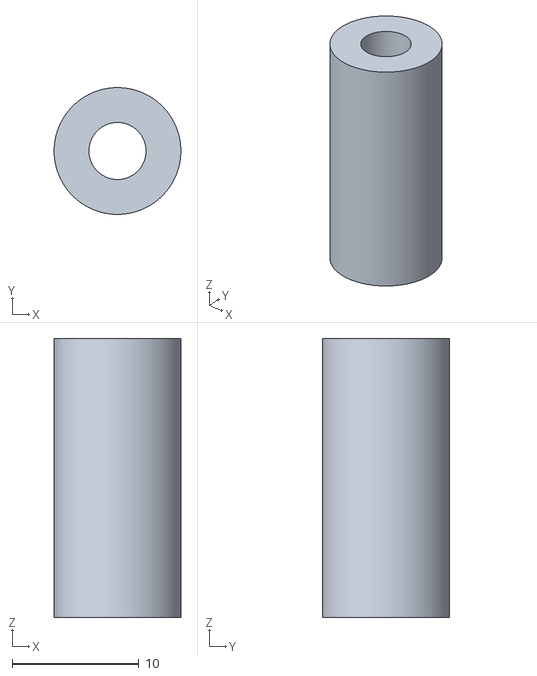
[picture p125: CAD file, 2026-11-06]
docs/cad/三维装配_v7_加厚夹带/打印件_STL_待实配/07_KFL支承柱22_仅试配非承载.stl
10.00 x 10.00 x 22.0
