eatoughaidan5v4418-spec/-/docs/cad/图纸_v7_加厚夹带/P04_顶板_轴承座安装.dxf

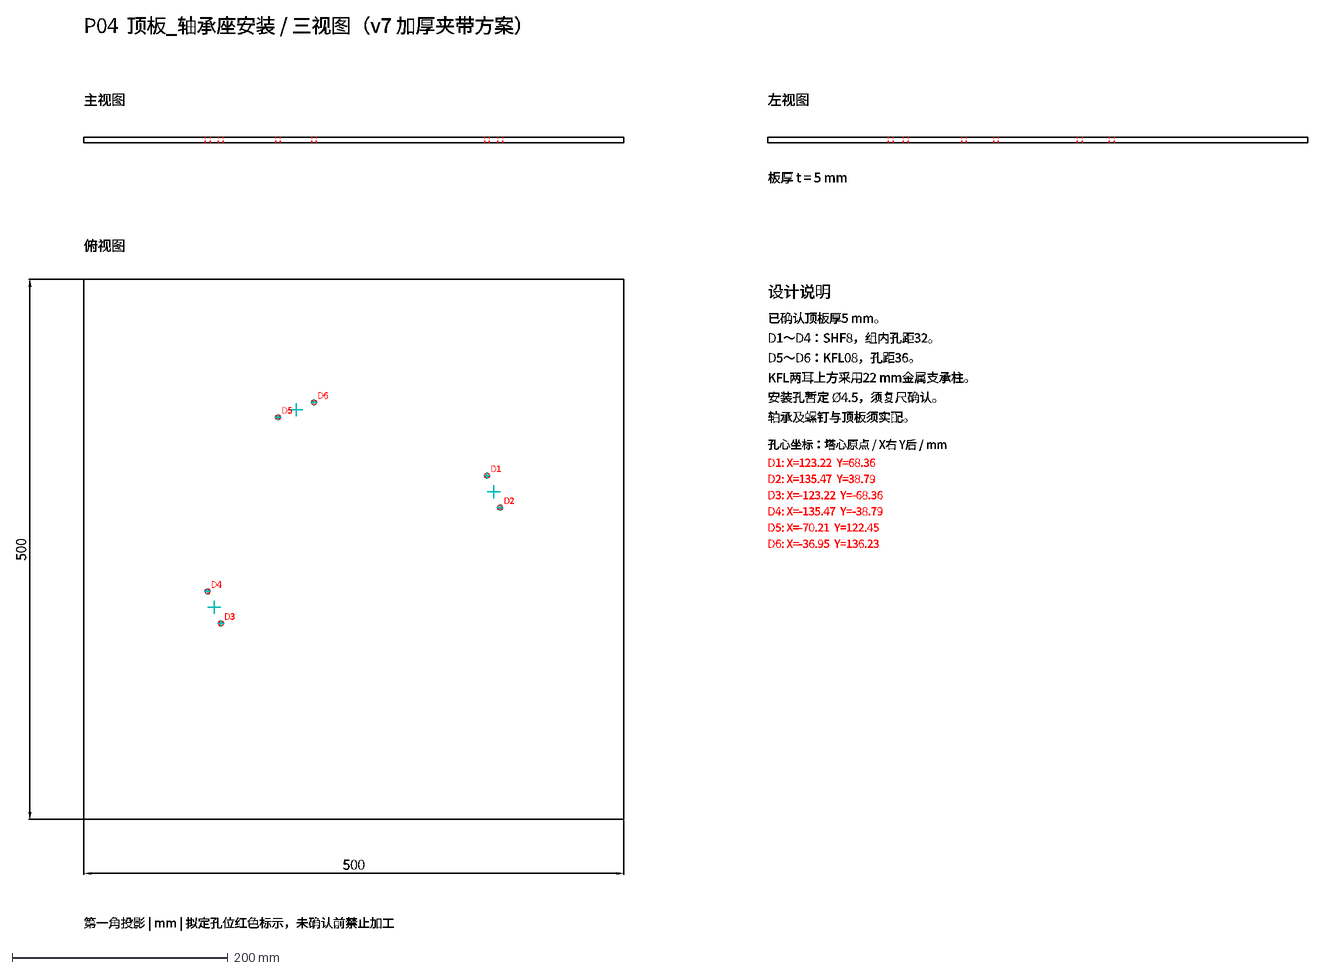
[picture p127: CAD file, 2026-11-06]
docs/cad/图纸_v7_加厚夹带/P04_顶板_轴承座安装.dxf
P04 顶板_轴承座安装 / 三视图（v7 加厚夹带方案）
主视图
左视图
俯视图
500
D1
D2
D3
D4
D5
D6
板厚 t = 5 mm
设计说明
已确认顶板厚5 mm。
D1～D4：SHF8，组内孔距32。
D5～D6：KFL08，孔距36。
KFL两耳上方采用22 mm金属支承柱。
安装孔暂定 Ø4.5，须复尺确认。
轴承及螺钉与顶板须实配。
孔心坐标：塔心原点 / X右 Y后 / mm
D1: X=123.22 Y=68.36
D2: X=135.47 Y=38.79
D3: X=-123.22 Y=-68.36
D4: X=-135.47 Y=-38.79
D5: X=-70.21 Y=122.45
D6: X=-36.95 Y=136.23
第一角投影 | mm | 拟定孔位红色标示，未确认前禁止加工
