eatoughaidan5v4418-spec/-/docs/cad/图纸_v7_加厚夹带/A03_上下限位座_试配.dxf

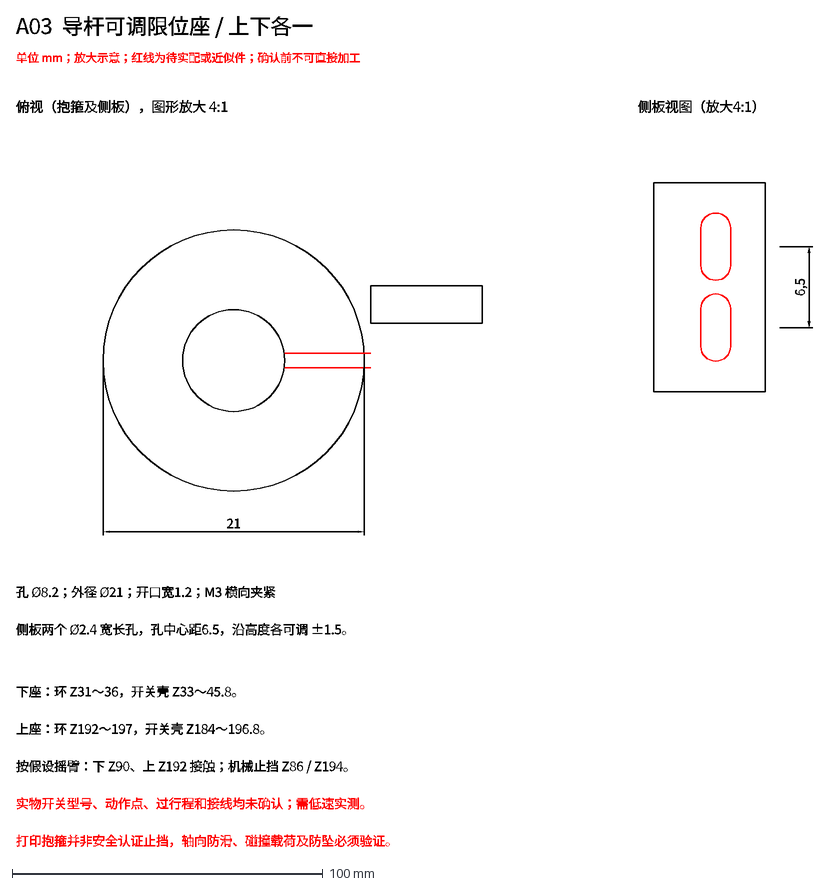
[picture p131: CAD file, 2026-11-06]
docs/cad/图纸_v7_加厚夹带/A03_上下限位座_试配.dxf
A03 导杆可调限位座 / 上下各一
单位 mm；放大示意；红线为待实配或近似件；确认前不可直接加工
俯视（抱箍及侧板），图形放大 4:1
21
侧板视图（放大4:1）
6,5
孔 Ø8.2；外径 Ø21；开口宽1.2；M3 横向夹紧
侧板两个 Ø2.4 宽长孔，孔中心距6.5，沿高度各可调 ±1.5。
下座：环 Z31～36，开关壳 Z33～45.8。
上座：环 Z192～197，开关壳 Z184～196.8。
按假设摇臂：下 Z90、上 Z192 接触；机械止挡 Z86 / Z194。
实物开关型号、动作点、过行程和接线均未确认；需低速实测。
打印抱箍并非安全认证止挡，轴向防滑、碰撞载荷及防坠必须验证。
