eatoughaidan5v4418-spec/-/docs/cad/图纸_v7_加厚夹带/P07R_升降中心盘.dxf

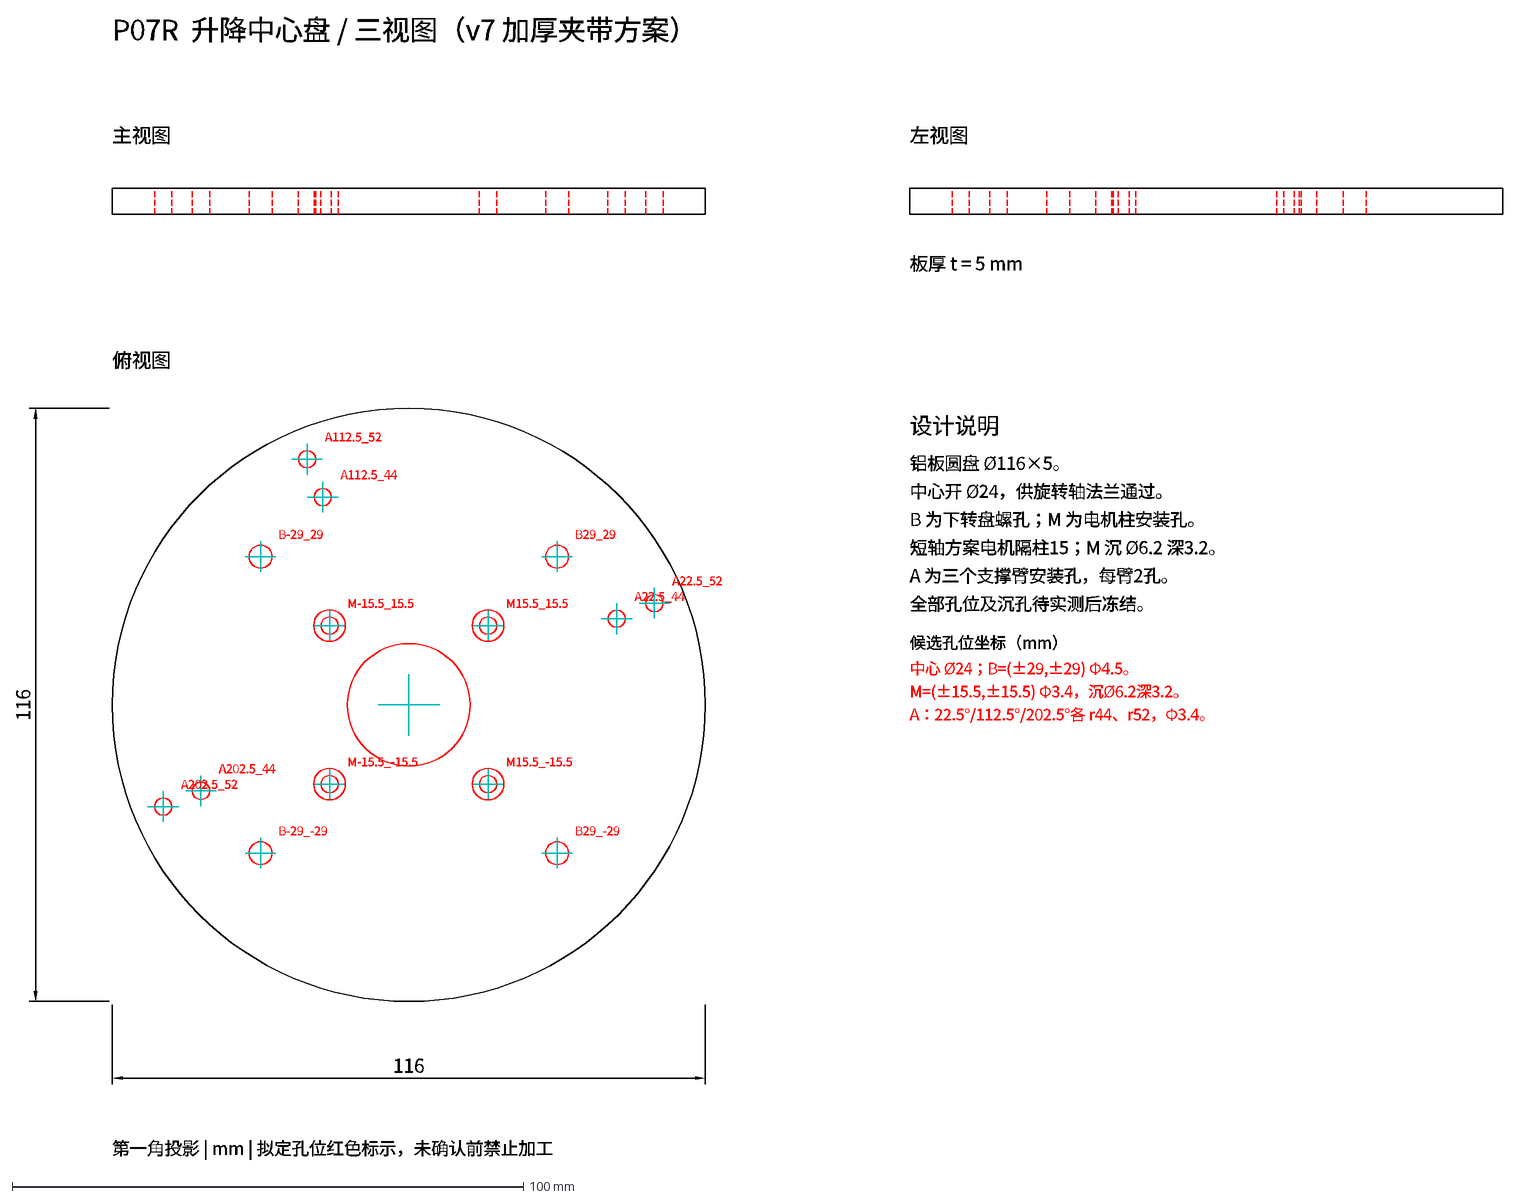
[picture p133: CAD file, 2026-11-06]
docs/cad/图纸_v7_加厚夹带/P07R_升降中心盘.dxf
P07R 升降中心盘 / 三视图（v7 加厚夹带方案）
主视图
左视图
俯视图
116
B-29_-29
B-29_29
B29_-29
B29_29
M-15.5_-15.5
M-15.5_15.5
M15.5_-15.5
M15.5_15.5
A22.5_44
A22.5_52
A112.5_44
A112.5_52
A202.5_44
A202.5_52
板厚 t = 5 mm
设计说明
铝板圆盘 Ø116×5。
中心开 Ø24，供旋转轴法兰通过。
B 为下转盘螺孔；M 为电机柱安装孔。
短轴方案电机隔柱15；M 沉 Ø6.2 深3.2。
A 为三个支撑臂安装孔，每臂2孔。
全部孔位及沉孔待实测后冻结。
候选孔位坐标（mm）
中心 Ø24；B=(±29,±29) Φ4.5。
M=(±15.5,±15.5) Φ3.4，沉Ø6.2深3.2。
A：22.5°/112.5°/202.5°各 r44、r52，Φ3.4。
第一角投影 | mm | 拟定孔位红色标示，未确认前禁止加工
