eatoughaidan5v4418-spec/-/docs/cad/三维装配_v7_加厚夹带/打印件_STL_待实配/04_旋转电机隔柱15_打印4件.stl

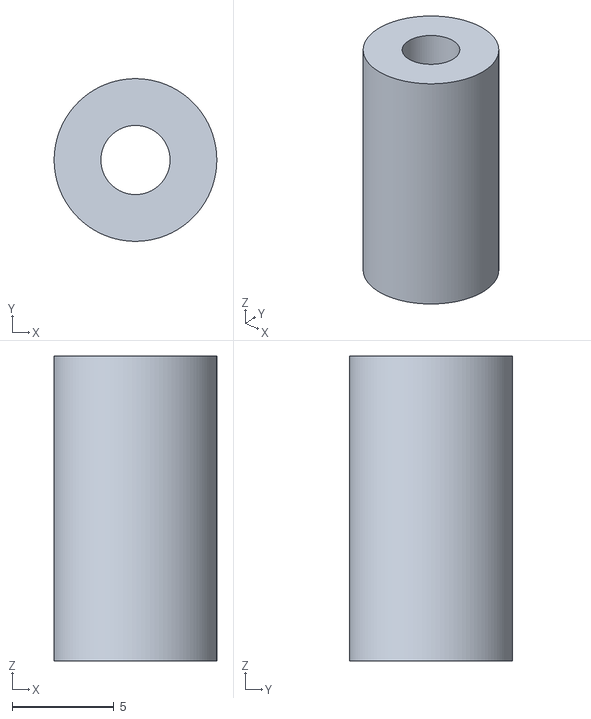
[picture p134: CAD file, 2026-11-06]
docs/cad/三维装配_v7_加厚夹带/打印件_STL_待实配/04_旋转电机隔柱15_打印4件.stl
8.00 x 8.00 x 15.0
