eatoughaidan5v4418-spec/-/docs/cad/图纸_v7_加厚夹带/P02S_底板_短轴支架安装.dxf

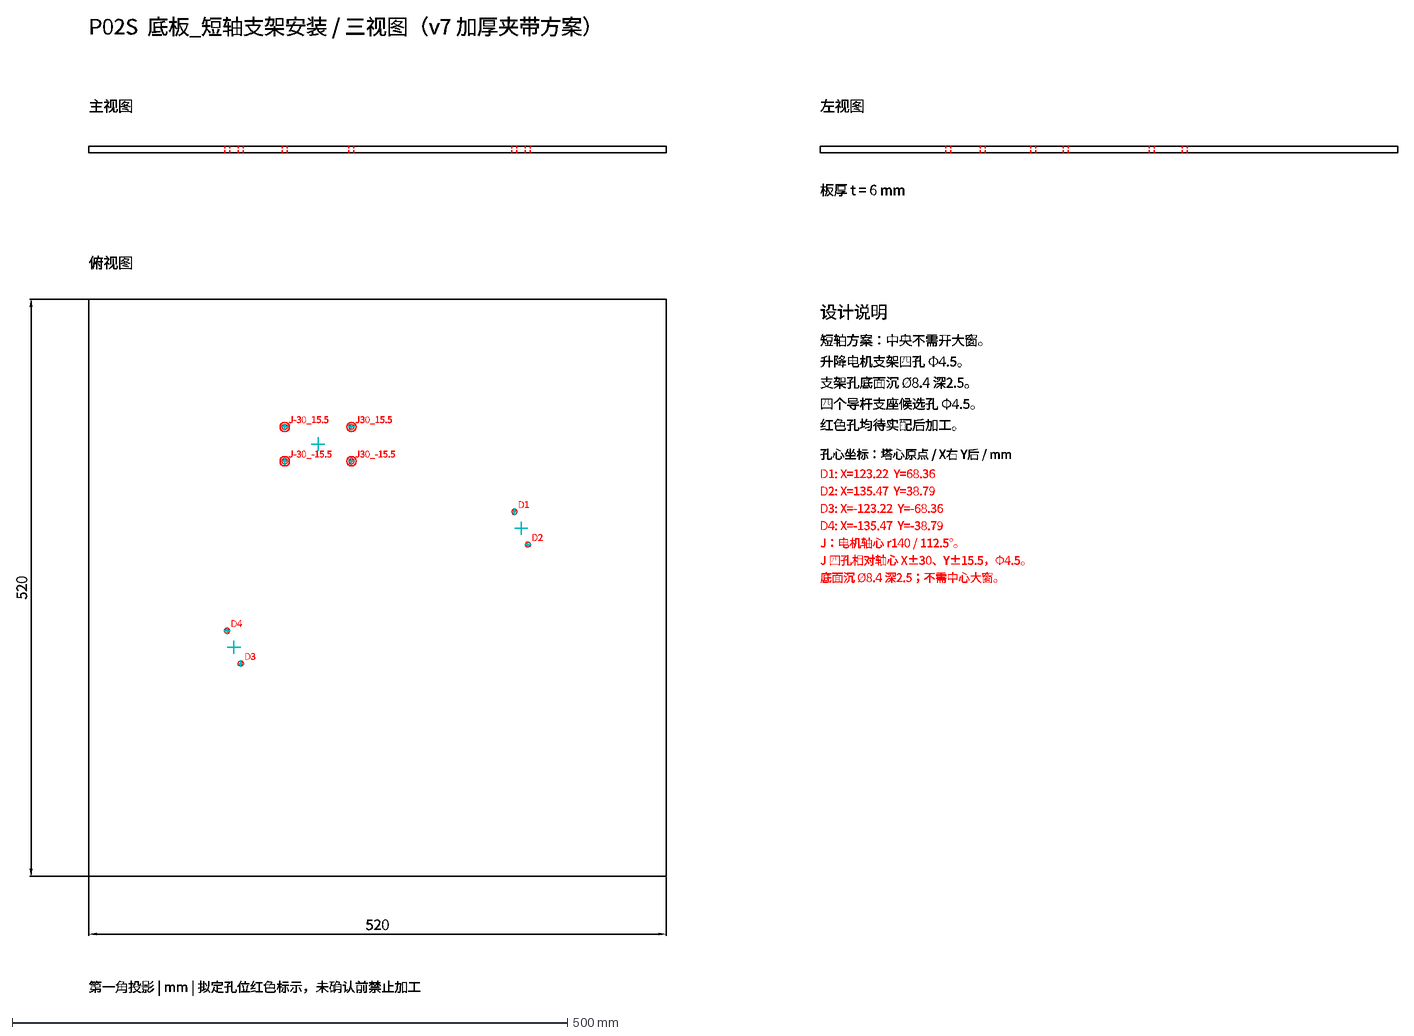
[picture p136: CAD file, 2026-11-06]
docs/cad/图纸_v7_加厚夹带/P02S_底板_短轴支架安装.dxf
P02S 底板_短轴支架安装 / 三视图（v7 加厚夹带方案）
主视图
左视图
俯视图
520
D1
D2
D3
D4
J-30_-15.5
J-30_15.5
J30_-15.5
J30_15.5
板厚 t = 6 mm
设计说明
短轴方案：中央不需开大窗。
升降电机支架四孔 Φ4.5。
支架孔底面沉 Ø8.4 深2.5。
四个导杆支座候选孔 Φ4.5。
红色孔均待实配后加工。
孔心坐标：塔心原点 / X右 Y后 / mm
D1: X=123.22 Y=68.36
D2: X=135.47 Y=38.79
D3: X=-123.22 Y=-68.36
D4: X=-135.47 Y=-38.79
J：电机轴心 r140 / 112.5°。
J 四孔相对轴心 X±30、Y±15.5，Φ4.5。
底面沉 Ø8.4 深2.5；不需中心大窗。
第一角投影 | mm | 拟定孔位红色标示，未确认前禁止加工
