eatoughaidan5v4418-spec/-/(list of files, cad)

Other CAD files:
docs/cad/三维装配_v4_干涉调整/车库_两层三维装配_v4.dwg
docs/cad/三维装配_v5_短轴方案/车库_两层三维装配_v5_短轴.dwg
docs/cad/三维装配_v7_加厚夹带/车库_两层三维装配_v7.dwg
docs/cad/三维装配_v7_走线优化安装复核/车库_v7_走线优化.dwg
docs/cad/三维装配_初步校核/车库_两层三维装配_一层载盘.dwg
docs/cad/三维装配_v7_走线优化安装复核/车库_v7_走线优化_线环通路.dwg
docs/cad/三维装配_v7_加厚夹带/打印件_STL_待实配/12_拨叉收回限位座_试配.stl
docs/cad/三维装配_v7_走线优化安装复核/车库_v7_走线优化_R12试配.dwg
docs/cad/三维装配_v7_加厚夹带/打印件_STL_待实配/08_转盘法兰隔套8_打印1件.stl
docs/cad/三维装配_v7_走线优化安装复核/三维预览网格_双端R12/part_037.stl
docs/cad/三维装配_v7_走线优化安装复核/车库_v7_走线优化_双端R12.dwg
docs/cad/三维装配_v7_加厚夹带/打印件_STL_待实配/06_转运电机隔柱17_打印3件.stl
docs/cad/三维装配_v7_走线优化安装复核/三维预览网格/part_031.stl
docs/cad/三维装配_v7_加厚夹带/打印件_STL_待实配/10_下限位调节座_试配.stl
docs/cad/三维装配_v7_走线优化安装复核/三维预览网格_双端R12/part_020.stl
docs/cad/三维装配_v7_走线优化安装复核/三维预览网格_双端R12/part_060.stl
docs/cad/三维装配_v7_走线优化安装复核/三维预览网格_双端R12/part_038.stl
docs/cad/三维装配_v7_走线优化安装复核/三维预览网格_双端R12/part_003.stl
docs/cad/三维装配_v7_走线优化安装复核/三维预览网格/part_002.stl
docs/cad/三维装配_v7_走线优化安装复核/三维预览网格_双端R12/part_051.stl
docs/cad/三维装配_v7_走线优化安装复核/三维预览网格/part_030.stl
docs/cad/三维装配_v7_走线优化安装复核/三维预览网格_双端R12/part_035.stl
docs/cad/三维装配_v7_走线优化安装复核/三维预览网格_双端R12/part_039.stl
docs/cad/三维装配_v7_走线优化安装复核/三维预览网格/part_060.stl
docs/cad/三维装配_v7_走线优化安装复核/三维预览网格/part_017.stl
docs/cad/三维装配_v7_走线优化安装复核/三维预览网格/part_037.stl
docs/cad/三维装配_v7_走线优化安装复核/三维预览网格/part_051.stl
docs/cad/三维装配_v7_走线优化安装复核/三维预览网格_双端R12/part_031.stl
docs/cad/三维装配_v7_走线优化安装复核/三维预览网格/part_010.stl
docs/cad/三维装配_v7_走线优化安装复核/三维预览网格_双端R12/part_033.stl
docs/cad/三维装配_v7_走线优化安装复核/三维预览网格/part_039.stl
docs/cad/三维装配_v7_走线优化安装复核/三维预览网格/part_035.stl
docs/cad/三维装配_v7_走线优化安装复核/三维预览网格_双端R12/part_048.stl
docs/cad/三维装配_v7_走线优化安装复核/三维预览网格/part_003.stl
docs/cad/三维装配_v7_走线优化安装复核/三维预览网格_双端R12/part_058.stl
docs/cad/三维装配_v7_走线优化安装复核/三维预览网格/part_048.stl
docs/cad/三维装配_v7_走线优化安装复核/三维预览网格/part_050.stl
docs/cad/三维装配_v7_走线优化安装复核/三维预览网格_双端R12/part_050.stl
docs/cad/三维装配_v7_走线优化安装复核/三维预览网格/part_040.stl
docs/cad/三维装配_v7_走线优化安装复核/三维预览网格_双端R12/part_030.stl
docs/cad/三维装配_v7_走线优化安装复核/三维预览网格_双端R12/part_017.stl
docs/cad/三维装配_v7_走线优化安装复核/三维预览网格/part_028.stl
docs/cad/三维装配_v7_走线优化安装复核/三维预览网格/part_029.stl
docs/cad/三维装配_v7_走线优化安装复核/三维预览网格_双端R12/part_040.stl
docs/cad/三维装配_v7_走线优化安装复核/三维预览网格/part_001.stl
docs/cad/三维装配_v7_走线优化安装复核/三维预览网格/part_020.stl
docs/cad/三维装配_v7_走线优化安装复核/三维预览网格/part_033.stl
docs/cad/三维装配_v7_走线优化安装复核/三维预览网格/part_034.stl
docs/cad/三维装配_v7_走线优化安装复核/三维预览网格/part_038.stl
docs/cad/三维装配_v7_走线优化安装复核/三维预览网格/part_044.stl
docs/cad/三维装配_v7_走线优化安装复核/三维预览网格/part_046.stl
docs/cad/三维装配_v7_走线优化安装复核/三维预览网格/part_049.stl
docs/cad/三维装配_v7_走线优化安装复核/三维预览网格/part_052.stl
docs/cad/三维装配_v7_走线优化安装复核/三维预览网格/part_058.stl
docs/cad/三维装配_v7_走线优化安装复核/三维预览网格_双端R12/part_001.stl
docs/cad/三维装配_v7_走线优化安装复核/三维预览网格_双端R12/part_002.stl
docs/cad/三维装配_v7_走线优化安装复核/三维预览网格_双端R12/part_010.stl
docs/cad/三维装配_v7_走线优化安装复核/三维预览网格_双端R12/part_028.stl
docs/cad/三维装配_v7_走线优化安装复核/三维预览网格_双端R12/part_029.stl
docs/cad/三维装配_v7_走线优化安装复核/三维预览网格_双端R12/part_034.stl
docs/cad/三维装配_v7_走线优化安装复核/三维预览网格_双端R12/part_044.stl
docs/cad/三维装配_v7_走线优化安装复核/三维预览网格_双端R12/part_046.stl
docs/cad/三维装配_v7_走线优化安装复核/三维预览网格_双端R12/part_049.stl
docs/cad/三维装配_v7_走线优化安装复核/三维预览网格_双端R12/part_052.stl
docs/cad/图纸_v3_完善版/P01_托盘板.dwg
docs/cad/图纸_v3_完善版/P02_底板.dwg
docs/cad/图纸_v3_完善版/P03B_转运台底板_局部加宽备选.dwg
docs/cad/图纸_v3_完善版/P03_转运台底板.dwg
docs/cad/图纸_v3_完善版/P04_顶板.dwg
docs/cad/图纸_v3_完善版/P05_一层甲板.dwg
docs/cad/图纸_v3_完善版/P06_二层甲板.dwg
docs/cad/图纸_v3_完善版/托盘空白板轮廓/P01_托盘空白板_无孔轮廓.dwg
docs/cad/图纸_v3_草案/P01_托盘板.dwg
docs/cad/图纸_v3_草案/P02_底板.dwg
docs/cad/图纸_v3_草案/P03_转运台底板.dwg
docs/cad/图纸_v3_草案/P04_顶板.dwg
docs/cad/图纸_v3_草案/P05_一层甲板.dwg
docs/cad/图纸_v3_草案/P06_二层甲板.dwg
docs/cad/图纸_v4_干涉调整/P02R_底板_中心开窗.dwg
docs/cad/图纸_v4_干涉调整/P03C_转运板_电机安装耳.dwg
docs/cad/图纸_v4_干涉调整/P05R_一层甲板_四角避让.dwg
docs/cad/图纸_v4_干涉调整/P06R_二层甲板_四角避让.dwg
docs/cad/图纸_v4_干涉调整/P07R_升降中心盘.dwg
docs/cad/图纸_v5_短轴方案/P02S_底板_短轴支架安装.dwg
docs/cad/图纸_v5_短轴方案/P02S_底板_短轴支架安装.dxf
docs/cad/图纸_v5_短轴方案/P03C_转运板_电机安装耳.dwg
docs/cad/图纸_v5_短轴方案/P05R_一层甲板_四角避让.dwg
docs/cad/图纸_v5_短轴方案/P05R_一层甲板_四角避让.dxf
docs/cad/图纸_v5_短轴方案/P06R_二层甲板_四角避让.dwg
docs/cad/图纸_v5_短轴方案/P06R_二层甲板_四角避让.dxf
docs/cad/图纸_v5_短轴方案/P07R_升降中心盘.dwg
docs/cad/图纸_v5_短轴方案/P07R_升降中心盘.dxf
docs/cad/图纸_v7_加厚夹带/A01_顶部双向止推安装_试配.dwg
docs/cad/图纸_v7_加厚夹带/A02_开口皮带压夹_试配.dwg
docs/cad/图纸_v7_加厚夹带/A03_上下限位座_试配.dwg
docs/cad/图纸_v7_加厚夹带/A04_托盘支撑条_试配.dwg
docs/cad/图纸_v7_加厚夹带/A05_拨叉两端限位座_试配.dwg
docs/cad/图纸_v7_加厚夹带/P01N_托盘板_新销位.dwg
docs/cad/图纸_v7_加厚夹带/P02S_底板_短轴支架安装.dwg
docs/cad/图纸_v7_加厚夹带/P03E_转运板_支撑条安装.dwg
docs/cad/图纸_v7_加厚夹带/P04_顶板_轴承座安装.dwg
docs/cad/图纸_v7_加厚夹带/P05R_一层甲板_四角避让.dwg
docs/cad/图纸_v7_加厚夹带/P06R_二层甲板_四角避让.dwg
docs/cad/图纸_v7_加厚夹带/P07R_升降中心盘.dwg
