eatoughaidan5v4418-spec/-/docs/cad/三维装配_v7_走线优化安装复核/三维预览网格_双端R12/README.md

# 三维预览辅助网格

这里的 STL 仅用于[局部浏览器预览](../走线三维预览_双端R12.html)，不是完整装配或加工文件。AutoCAD 导出时各实体坐标被平移，预览页面根据 `manifest.json` 将它们还原到基准装配位置。检查和后续设计请使用最终 DWG 或 SAT。
