eatoughaidan5v4418-spec/-/docs/cad/三维装配_v7_加厚夹带/止推与限位说明.md

# 丝杆止推与限位说明

丝杆顶部止推、升降与拨叉限位这两部分自 v6 起没有改动，v7 沿用。所有尺寸均为设计名义值，**供复尺与试配，不是已验证的加工图**。夹带座、带轮、转运板和井口的现行尺寸见 [v7 装配说明](./README.md)。

## 一、丝杆顶部：径向定位与双向止推

保留 KFL08 作为径向定位参考；其上下各增加一套 **F8-16M 8×16×5 mm 单向推力轴承**，方向相反。每侧各用两只与实际丝杆螺纹完全匹配的 **6 mm 厚金属薄螺母**对锁。上下每侧还需由两片金属环构成 2 mm 高的阶梯座，支承推力轴承的壳圈并避开旋转的 KFL 内圈。

名义叠层以底板上表面 `Z=0` 为准：下侧两螺母 `Z=217～229`、下推力轴承 `229～234`、下阶梯座 `234～236`、KFL 壳 `236～248`、上阶梯座 `248～250`、上推力轴承 `250～255`、上侧两螺母 `255～267`。丝杆末端 `Z=268`，顶板下表面 `Z=270`。两根 **Ø10×22 mm 金属支承柱**安装在 KFL 两耳与顶板之间，候选紧固件为 M4×45。

模型假设 KFL 壳厚 12、内圈外径 12 且两侧各凸出 1；这些数值和实际可用支承平面没有实测。阶梯座的内孔 14 / 11、外径 20、每层厚 1，是按这一假设设计的候选尺寸，必须实测 KFL 和实际推力轴承后修配。推力轴承两圈朝向、壳圈支承直径及轴向游隙应按具体轴承资料与实物确认，避免夹住滚道或压到 KFL 防尘盖。

四只薄螺母需要按**真实丝杆的牙型、头数、旋向和导程**购买或金属加工；清单写的是单头导程 2 mm，并不等于已经实测，也不能用普通 M8 螺母代替。模型的圆柱孔没有真实螺纹，不能验证啮合、锁紧、承载及防松。金属支承柱及薄螺母的加工质量、顶部轴向受力和防滑也必须验证。F8-16M 的参考外形见 [EZO 厂家尺寸](https://www.ezo-brg.co.jp/english/product/spec.php?eid=02422&unit=mm)。

## 二、升降与拨叉限位

已建四个开关座：一个导杆上、下各一；转运板两端各一。导杆座夹在 `r=140、22.5°` 的光轴上，开关侧板孔距按 **6.5 mm**，长孔允许约 ±1.5 mm 位置调整；拨叉两端开关座约可调 ±0.5 mm。开关外形参考小型微动开关，现有开关型号尚未确认；孔距、外形、触点、杠杆方向和过行程均需测量，必要时改座或更换开关。6.5 mm 孔距可参考 [欧姆龙 D2F 数据表](https://omronfs.omron.com/en_US/ecb/products/pdf/en-d2f.pdf)。

| 位置 | 正常工作参考 | 模型中假设的开关接触 | 模型中刚体止挡接触 |
|---|---|---|---|
| 升降下端 | 一层脱开高度 Z=92 | Z=90 | Z=86 |
| 升降上端 | 二层对接高度 Z=190 | Z=192 | Z=194 |
| 拨叉收回 | 行程 0 | -0.5 mm | -2 mm |
| 拨叉伸出 | 行程 138 mm | 138.5 mm | 140 mm |

这些数字仅是名义几何：开关臂在模型中是未变形的简化体，达到触点后会出现有意重叠并单独记录，不能据此认定真实开关会动作、保持动作或具有足够过行程。拨叉接触到止挡只有约 **1.5 mm**，上端升降接触到止挡约 **2 mm**，必须测实际开关位置、停止距离和机构弹性后重新设定速度与限位；一旦余量不够应重新布置，不得强行运行。

可优先考虑用实际开关的常闭触点做断线可检测的限位输入，并按实际硬件设计独立于普通程序的方向限制、急停和恢复措施；这些微动开关与打印抱箍没有安全认证。升降轴断电可能失去保持力，必须另行设计、验证可靠的机械防坠或制动；不能将打印止挡、丝杆自锁或断电当作防坠证明。

## 三、相关物料

| 物料 | 数量 / 说明 |
|---|---|
| F8-16M 推力轴承 | 2 套，8×16×5 mm；承载额定值及实际装配方向以选购产品为准。 |
| 匹配丝杆的金属对锁薄螺母 | 4 件，每件高 6、外轮廓不大于 Ø16.6；须匹配丝杆牙型及头数，可能需要定制加工。 |
| 金属阶梯座垫片 | 外径 20、厚 1、内径 14 与内径 11 各 2 件；具体尺寸须依 KFL 内圈及轴承座面修配。 |
| 金属支承柱 | 外径 10、孔 Ø4.5、长 22 mm，共 2 件；配 M4×45 螺钉、螺母、垫圈各 2。 |
| 微动开关及座 | 使用已购开关中尺寸和触点合适的 4 个；两个导杆座 M3×25 各 1，四个开关共 M2×12 和螺母各 8，拨叉两座底部 M2×5 共 4；以上均需实配。 |
