eatoughaidan5v4418-spec/-/docs/cad/assembly-exploded.html

P↗

立体车库GARAGE SIMULATOR / V3

PROJECT 03 / 结构概念验证

# 模块化塔式车库 · 交互演示

硬件方案 V3查看尺寸图 ↗

01 / PARKING LAYOUT

## 车位状态

2F

每层 8 个无电机辐射车位，围绕中央升降转运台。一层前侧为 DOCK，二层前侧留空作 DOCK 竖井。

有车空托盘无托盘

CURRENT SELECTION请选择载车托盘存车无需选择，系统自动分配车位

存入车辆 ↗取出车辆 ↘

存车：调空托盘到 DOCK；取车：先选中载车托盘。

i样机先做一层（7 车位）；计划书按两层（14 车位）。第二层是无源层模块：甲板 + 7 霍尔 + 1 片 MCP23017，运动部件不增加。

LIVE MODEL / MM

## 结构总览 01

实时演示三维示意

三维画面无法启动，请使用支持 WebGL 的浏览器打开。车位与流程模拟仍可使用。

✳

中央升降 · 旋转转运 · 无源层模块按住拖动旋转 · 滚轮缩放 · 右键平移

⟳▦

整机估计外轮廓520 × 520 × 275 mm

甲板高度 L1 / L2100 / 190 mm

托盘 / 模型车125×60 / 105×43×30 mm

02 / OPERATION

## 运行流程

待机

CURRENT STEP选择托盘取车，或点击存车

全部停止

升降 Z92 mm

转角 θ0 °

拨叉 u-31 mm

转运台托盘无

ACTION REQUIRED / DOCK请确认车辆状态

确认并继续 →取消存车，保留空托盘

### 演示控制

2×

速度4×

显示框架显示车辆

空闲预置空托盘仅一层样机

结构拆解0%

暂停重置演示模拟急停

EVENT LOG / 操作记录●

概念演示，非设备控制尺寸为设计目标；结构、干涉与安全互锁尚待实物验证，不能作为加工图。实机时间为按假设速度的粗估。
