eatoughaidan5v4418-spec/-/docs/cad/三维装配_v4_干涉调整/三维装配预览.png

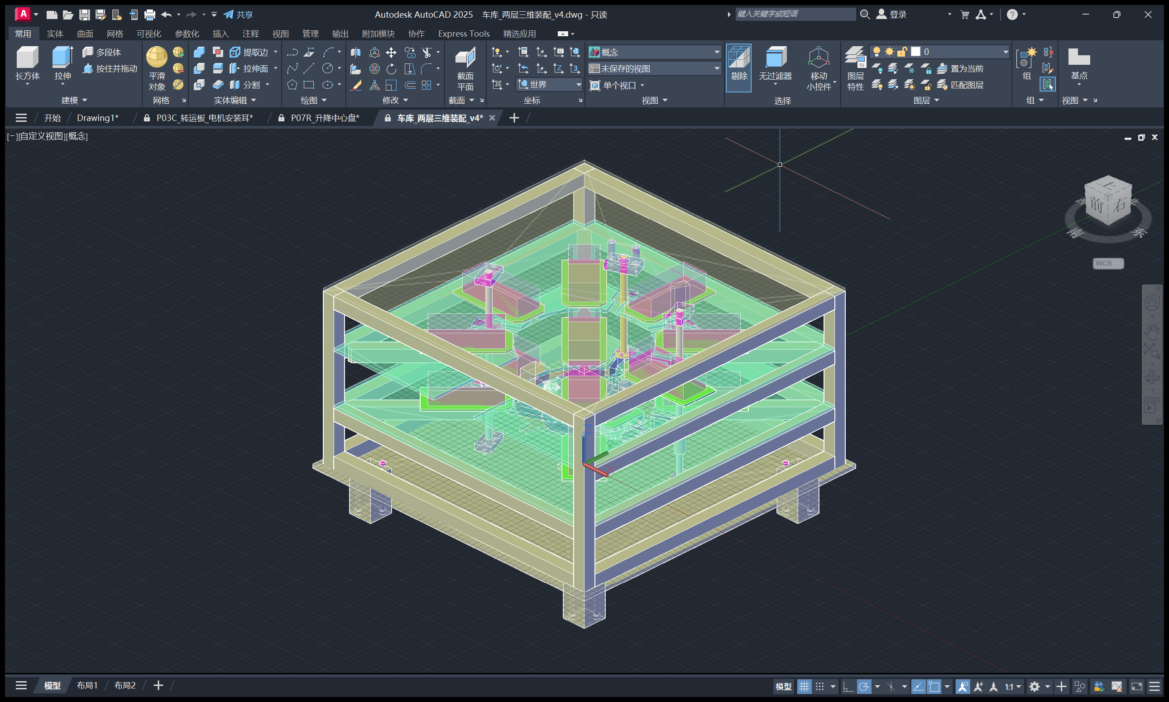
docs/cad/三维装配_v4_干涉调整/三维装配预览.png
