eatoughaidan5v4418-spec/-/docs/cad/三维装配_v5_短轴方案/三维装配预览.png

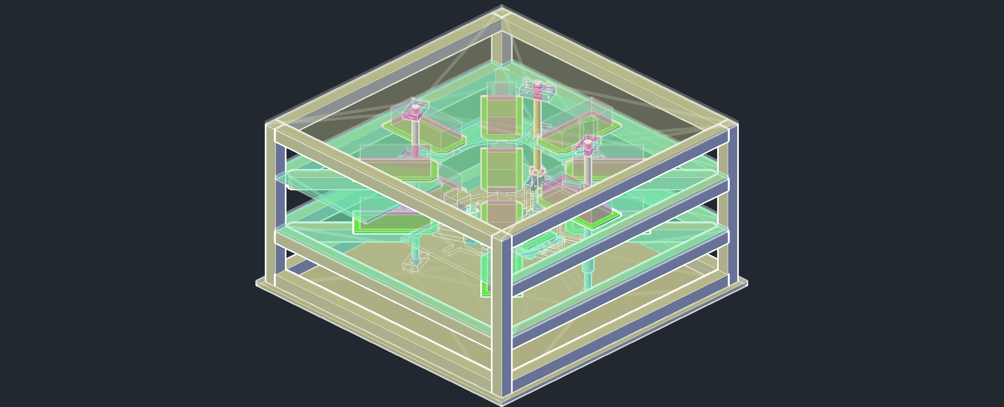
docs/cad/三维装配_v5_短轴方案/三维装配预览.png
