eatoughaidan5v4418-spec/-/docs/cad/三维装配_v5_短轴方案/中心机构_隐藏外围图层.png

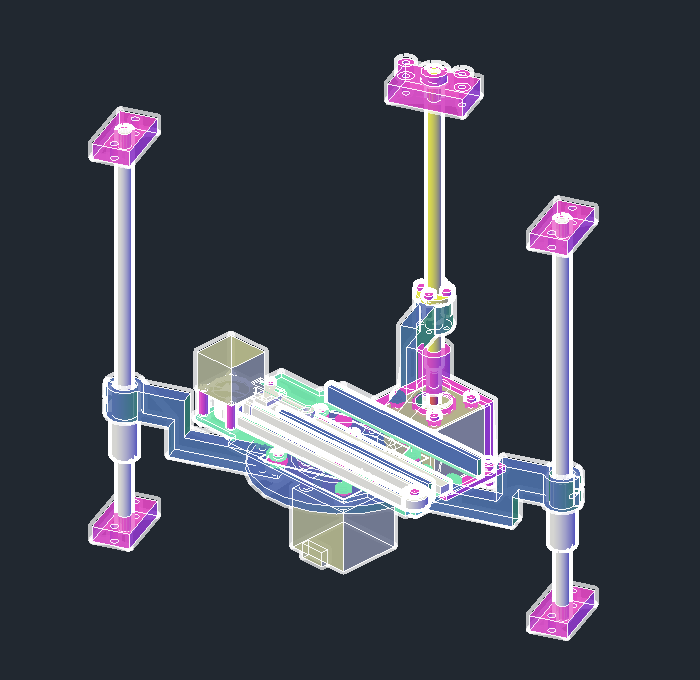
docs/cad/三维装配_v5_短轴方案/中心机构_隐藏外围图层.png
