eatoughaidan5v4418-spec/-/docs/cad/三维装配_v7_加厚夹带/夹座三维预览.png

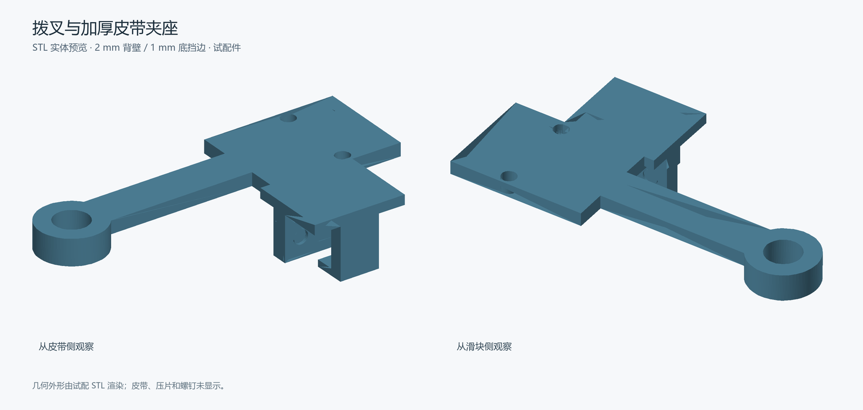
docs/cad/三维装配_v7_加厚夹带/夹座三维预览.png
