eatoughaidan5v4418-spec/-/docs/cad/三维装配_v7_走线优化安装复核/走线三维预览.png

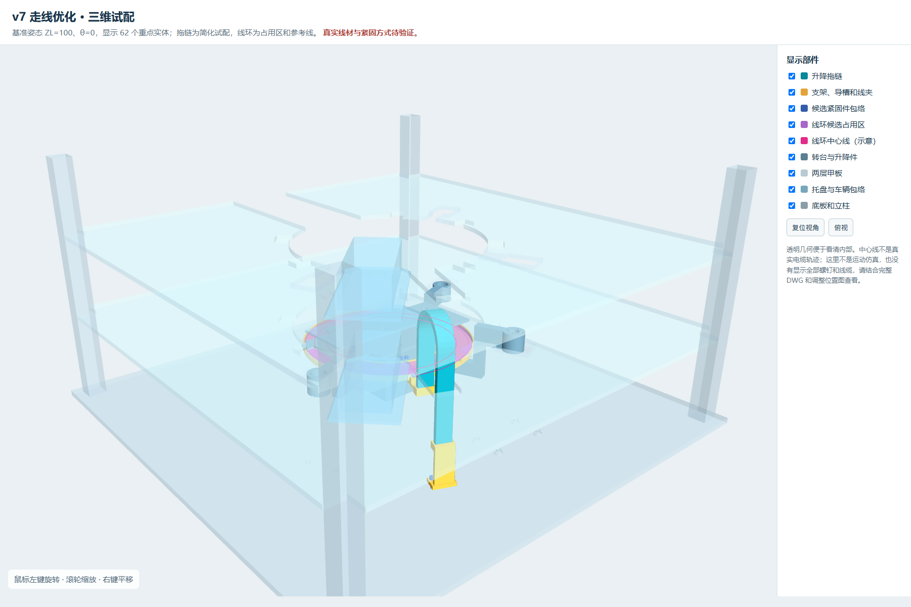
docs/cad/三维装配_v7_走线优化安装复核/走线三维预览.png
