eatoughaidan5v4418-spec/-/docs/cad/三维装配_初步校核/三维装配预览.png

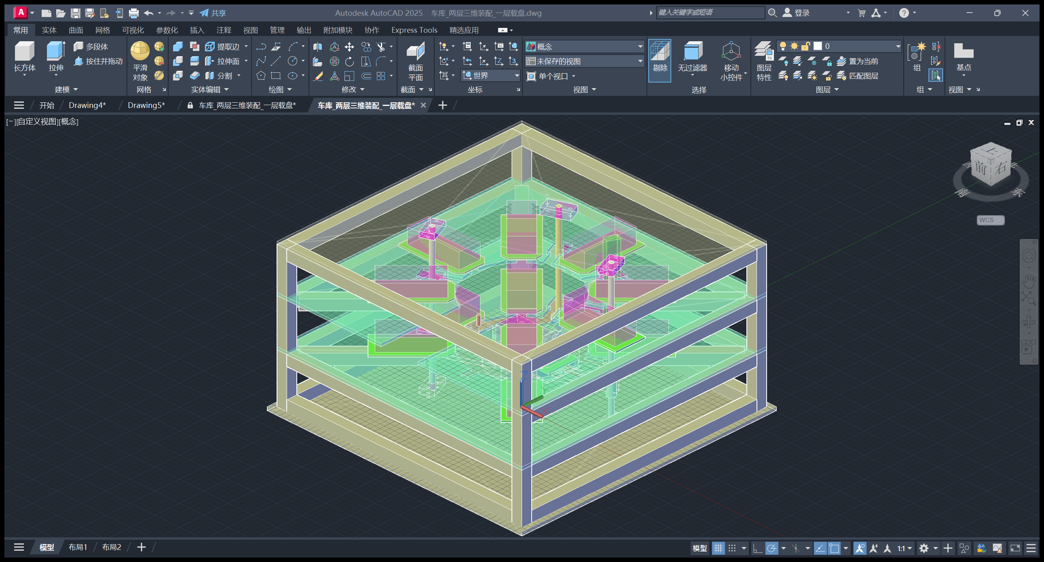
docs/cad/三维装配_初步校核/三维装配预览.png
