eatoughaidan5v4418-spec/-/使用的硬件资料/机械标准尺寸/SDP_SI_GT2_带轮_2mm.pdf

## INCH

# GT®2 TIMING BELT PULLEYS • 2 mm PITCH

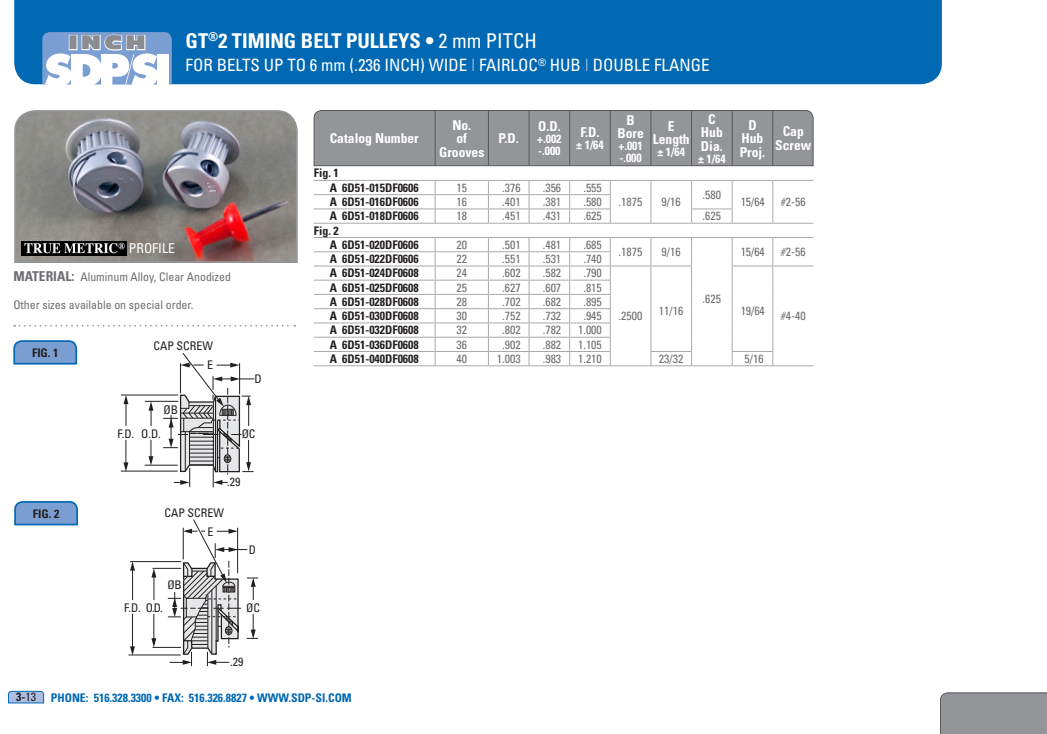
[picture p164: page 1]
CAP SCREW; FIG. 1; FIG. 2; Catalog Number; No. of Grooves; B Bore +.001 -.000; E Length ± 1/64; C Hub Dia. ± 1/64; D Hub Proj.; Cap Screw; Fig. 1; Fig. 2; PROFILE

FOR BELTS UP TO 6 mm (.236 INCH) WIDE | FAIRLOC® HUB | DOUBLE FLANGE

MATERIAL: Aluminum Alloy, Clear Anodized

Other sizes available on special order.

PHONE: 516.328.3300 • FAX: 516.326.8827 • WWW.SDP-SI.COM
