eatoughaidan5v4418-spec/-/使用的硬件资料/机械标准尺寸/LM_LUU_直线轴承尺寸表.pdf

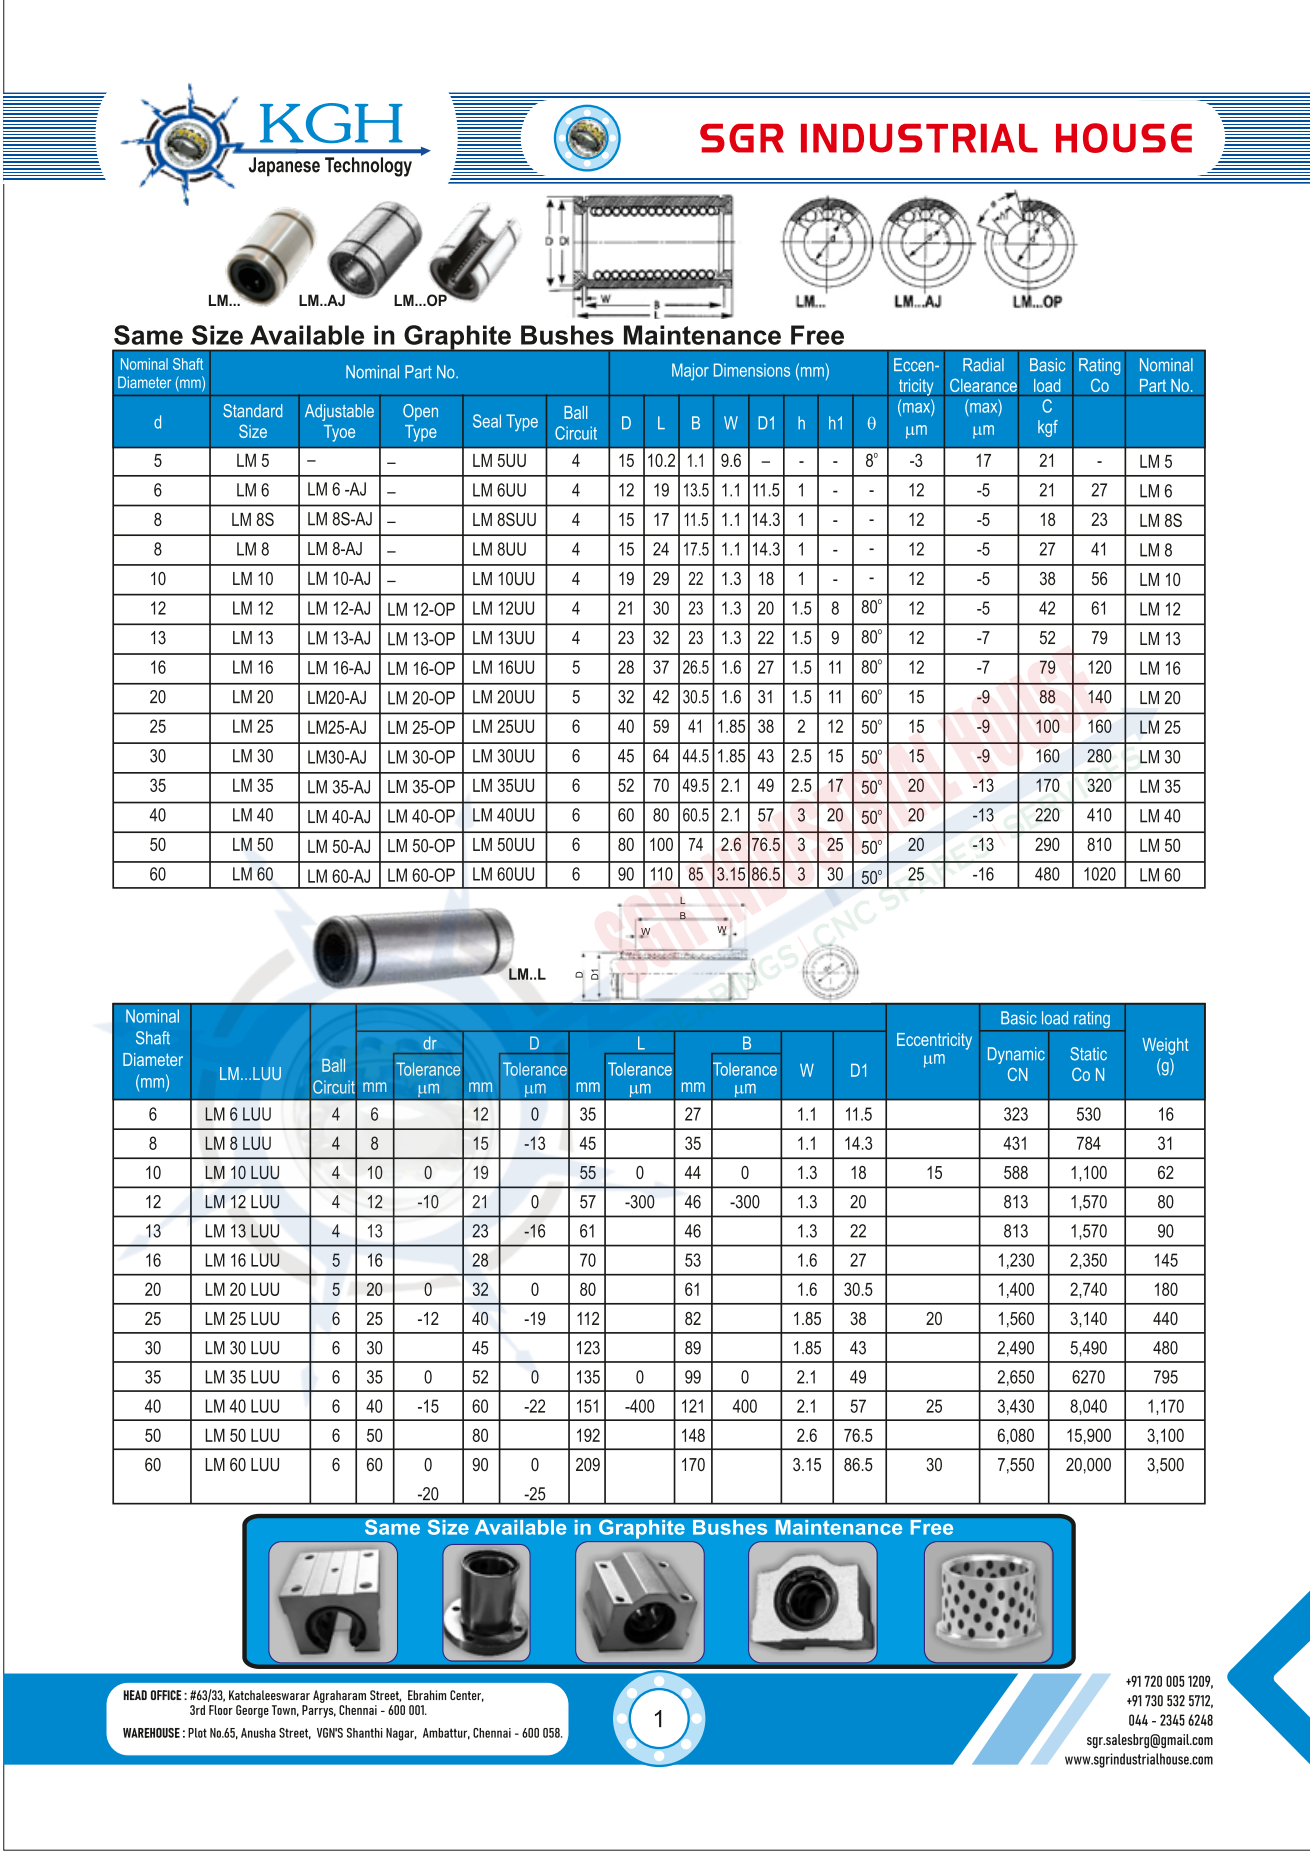
[picture p165: page 1]
