eatoughaidan5v4418-spec/-/(commit log)

2026-11-03 docs: 初赛计划书与样机建模/装配/采购文稿
2026-11-03 docs: 计划书进度改为带日期行动表
2026-11-03 docs: 自制件尺寸表与草图顺序（A）
2026-11-03 docs: 自制件尺寸与草图改用结构正式版
2026-11-03 docs: P01 底板 Three.js 精确尺寸查看器
2026-11-03 cad: add whole-assembly exploded Three.js viewer
2026-11-03 cad: add CAD index linking assembly-exploded viewer
2026-11-03 docs: link assembly-exploded.html in README index
2026-11-03 fix(cad): resolve assembly-exploded 穿模 — trays on rails, bay under plate, beam/post offsets
2026-11-03 fix(cad): clear lift well through L1/L2; split top front beam; add lift demo slider 55-155
2026-11-04 chore: remove obsolete hardware materials
2026-11-04 docs: redesign garage as central-lift tower (v3)
    Replace v2 (side lift + per-layer X/Y tray gantry, 9 axes) with a
    central lift/rotate/transfer unit serving 8 passive radial bays per
    layer: 3 motors total, pin engagement by the lift's own 8 mm stroke,
    DOCK shaft on layer 2. Plan document covers two layers (14 bays);
    the prototype starts with one layer (7 bays).
    - docs: hardware plan v3, procurement v4 (two batches), verification v3
    - cad: rewrite simulation state machine, Three.js demo and layer plan;
    shared deck outline (deck.js)
    - tools: check_hardware_v3.py geometry/budget checks; simulation tests
    - archive v2 docs, demo and scripts under docs/archive/v2, tools/archive
    [check_hardware_v3.py]
2026-11-05 docs: add CAD drawings and hardware references
    [P01_托盘板.dwg, P01_托盘板.dxf, P01_托盘空白板_无孔轮廓.dwg, P01_托盘空白板_无孔轮廓.dxf, P02_底板.dwg, P02_底板.dxf, P03B_转运台底板_局部加宽备选.dwg, P03B_转运台底板_局部加宽备选.dxf]
2026-11-05 feat(cad): add garage 3D assembly and interference checks
    [候选安装孔_名义贯通检查.csv, 基准工况_实体相交.csv, 模型零件与范围.csv, 车库_两层三维装配_一层载盘.dwg, 运动采样_实体相交.csv, 运动采样_覆盖情况.csv]
2026-11-06 feat(cad): add belt clamp thrust and limit prototypes
    [01_导杆支撑臂_打印2件.stl, 02_丝杆支撑臂_打印1件.stl, 03_70高底脚_打印4件.stl, 03_升降电机跨式支架_打印1件.stl, 04_升降电机隔柱16_打印4件.stl, 04_旋转电机隔柱15_打印4件.stl, 05_旋转电机隔柱56_打印4件.stl, 06_转运电机隔柱17_打印3件.stl]
2026-11-06 chore: archive historical CAD revisions
    [01_导杆支撑臂_打印2件.stl, 02_丝杆支撑臂_打印1件.stl, 03_70高底脚_打印4件.stl, 03_升降电机跨式支架_打印1件.stl, 04_升降电机隔柱16_打印4件.stl, 04_旋转电机隔柱15_打印4件.stl, 05_旋转电机隔柱56_打印4件.stl, 06_转运电机隔柱17_打印3件.stl]
2026-11-06 feat(cad): reinforce belt clamp and improve clearances
    [01_导杆支撑臂_打印2件.stl, 02_丝杆支撑臂_打印1件.stl, 03_升降电机跨式支架_打印1件.stl, 04_旋转电机隔柱15_打印4件.stl, 06_转运电机隔柱17_打印3件.stl, 07_KFL支承柱22_仅试配非承载.stl, 08_转盘法兰隔套8_打印1件.stl, 09_拨叉及双螺钉皮带座_试配.stl]
2026-11-10 docs: 设计定稿，整理文档并加入固件工程
    [PickAndPlace_PCB1_2026_11_08.xlsx, R12线夹入口_移除体积.csv, part_000.stl, part_001.stl, part_002.stl, part_003.stl, part_004.stl, part_005.stl]
2026-11-11 chore: 清理历史版本，只保留现行文档与工具
    - 删除 docs/archive、tools/archive、被取代的旧版方案与清单、v6 CAD 和 v7 走线中间复核目录
    - 加入 PCB 生产文件、串口屏界面方案、HMI 固件模块和硬件资料
    - 修正 README、CAD 索引及各文档中指向已删文件的引用
    - check_hardware_v3.py 改读采购清单 v5
    [01_导杆支撑臂_打印2件.stl, 02_丝杆支撑臂_打印1件.stl, 03_70高底脚_打印4件.stl, 03_升降电机跨式支架_打印1件.stl, 04_升降电机隔柱16_打印4件.stl, 04_旋转电机隔柱15_打印4件.stl, 05_旋转电机隔柱56_打印4件.stl, 06_转运电机隔柱17_打印3件.stl]
